shuug2/gds_us_ctrl/ref/README.md

# ref/ — 이전 MCU 참조 코드

STM32F410RBT 통합 이전에 사용하던 두 MCU의 원본 코드 보관 폴더.

| 폴더 | MCU | 역할 |
|---|-----|---|
| `samd20/` | ATSAMD20 (Cortex-M0+) | (역할 기록 필요) |
| `atmega16/` | ATmega16 (AVR 8-bit) | (역할 기록 필요) |

이 코드는 수정하지 않는다. 포팅 시 참조 전용.
