shuug2/gds_us_ctrl/docs/superpowers/analysis/2026-06-20-bseam-osc-signal-chain-and-port-fidelity.md

# B-SEAM OSC — 신호 체인 · 명령선 · 포팅 충실도 (2026-06-20 분석 세션)

> **요약**: HW 비의존 분석 세션(코드 0줄, HW 측정 0건). B-SEAM(OSC 출력단)이 풀렸을 때 MCU가 무엇을 하는지, legacy M16 동작이 STM32로 제대로 포팅됐는지를 1차 소스(`ref/atmega16/m16_conv_v001.c` + disasm 분석 + STM32 코드)로 교차 검토했다. **핵심 결론 4건**: ① **출력단은 2조각 모두 미구동 stub** — OSC 채널 구동(**B-SEAM**) + 진폭 pot 실구동(**F2**, U4 칩 정체); 둘 다 `mon_printf` 로그만. ② 옛 IPC 명령 3선 **PA4=START / PA5=SEEK / PA6=RESET**(+PA7/PC4=IPC 아님)는 STM32에서 내부 `us_cmd`로 소멸, 처리부는 이식 완료. ③ M16은 "선(wire)"이 아니라 **프로세서** — "미러"는 명령핀→출력핀 통과가 아니라 *내부 상태 플래그 → OSC 핀* 매핑(finding ④: OSC 3선 = 명령 3선 active-LOW 레벨 미러, 가설). ④ **M16 처리코어 포팅 충실도 = 높음** — STM32가 disasm을 권위로 삼아 v001이 틀린 3곳(`×6` vs `>>6`, lookup `<`, warmup 부팅1회 vs per-START)을 모두 비껴감. 미검증은 전부 코드 버그가 아니라 절대값/물리출력(6b·B-SEAM·F2 게이트). ⑤ **(2026-06-20 후속, 사용자 HW 진실 + SAMD20 검증) B4 해소 — PB1 = SAMD20 소비전류**(M16 PA1은 미연결): SAMD20는 전류표시(curr_amp)·전력(curr_power=curr_amp×2.2)·에너지(curr_energy=acc/500)를 전부 PA02(=PB1)에서 파생하나, **STM32는 현재 PB1을 read-and-discard하고 이 3값을 ch0(reg_scale)에서 뽑음** = source·공식 불일치. `curr_amp`=소비전류(ampere), 진폭 아님. **이 PB1 재구성 = 6b 스테이지 본체** (§4b). ⑥ **(사용자 HW 확정) OSC 3 출력 채널 매핑 = RUN→PC7/PB14, SEEK→PB1/PB2, RESET→PB0/PB10, 전부 active-LOW binary 미러** (finding ④ 확정; v001 변수명 또 오라벨 — `g_run_flag`=실제 RESET). **B-SEAM 3채널 분은 측정 게이트 아님 → 코딩 가능**(내부 run/seek/reset → active-LOW). ⑦ **(M16 disasm 확보 후, §4c) OVLD(PC0) 로직 디코드 = PA7(PINA.7) HIGH ×5 디바운스 → PC0 어서트 + OVLD→SEEK 복구 훅(0x1D28)**; **PA7=과부하 입력 → 보류 OSC3(PB13) 해소**(OSC 출력 아님, OSC2/PC4만 미확정). ⑧ **PA0/SENS_OUT = 양 레거시 MCU 모두 vestigial**(M16=dead 7seg 바그래프 / SAMD20=curr_lv 소비처 주석처리, 표시는 curr_amp); STM32의 `reg_scale(ch0)→curr_power`는 레거시 미사용 신호 오용, ch0 통합 역할 미결정. raw disasm `ref/atmega16/m16_disasm/firmware_disassembled.asm` 확보(이전 "없음" 해소). **다음 세션 = 사용자 오프라인 검토 반영 → HW 있으면 측정+설계, 없으면 B-SEAM(3채널)/F2/6b/overload spec 선행.**
>
> **산출물**: 검토용 Artifact(claude.ai) — 신호 체인 다이어그램 + 측정 절차 7단계 + 포팅 충실도(OSC 핀/처리코어) + 명령선/프로세서 정리. URL은 §7. (scratchpad HTML 원본은 세션 한정 소멸; 본 .md가 repo 영속본.)

---

## 1. 신호 체인 (MCU 중심)

옛 2-MCU(SAMD20 → 명령 4선 → ATmega16 → 발진보드)를 STM32 하나가 양쪽 흡수. **MCU는 초음파 주파수를 직접 만들지 않는다** — 발진은 외부 오실레이터 보드가 하고, MCU는 (1) 채널 ON/OFF, (2) 진폭, (3) 피드백, (4) SEEK/RESET 명령만 담당.

| 역할 | 핀 / 경로 | 상태 |
|---|---|---|
| 채널 ON/OFF | `CTRL_OSC0..4` = PB2/PB10/PB12/PB13/PB14 (active-LOW) | **B-SEAM** (미구동 stub) |
| 진폭(파워) | I2C_POT `@0x28` (I2C1, FRAM과 공유) | **F2** (미구동 stub) |
| 피드백 읽기 | ch0=PB0(M16 PA0, 레귤레이션 피드백) · ch1=PB1(**SAMD20 소비전류**; "OSC" 라벨 stale, §4b) | ch0 사용 / **ch1 현재 read-and-discard** / 절대보정=6b |
| SEEK / RESET | 공진 탐색 / 초기화 신호 (옛 M_SEEK·M_RESET 자리) | hook stub |

**⚠ 출력단 전체가 미구동**: `app_reg.c`는 "drives NO OSC GPIO"(compute-only). `app_lcd_hook_set_pot`(app_lcd.c:24)·`app_weld_hook_set_amp`(app_weld.c:36)는 **`mon_printf` 로그만**. I2C1 버스는 FRAM(FM24C16B) 전용으로만 실구동. 즉 두뇌·상태머신·계기판·명령 라우팅은 다 돌지만, **실출력 = ① B-SEAM(OSC 채널) + ② F2(진폭 pot) 둘 다 미이식.**

## 2. 명령 입력선 (PA4/5/6) + "M16 = 프로세서"

옛 SAMD20→M16 IPC 명령선(2026-06-10 IPC semantics 분석, samd20+disasm 교차):

| IPC 명령 | SAMD20 out | M16 in | 의미론 |
|---|---|---|---|
| M_START | PB13 | **PA4** | active-LOW 레벨, hold-to-run |
| M_SEEK | PB11 | **PA5** | active-LOW, 500ms 자동 해제 |
| M_RESET | PB12 | **PA6** | active-LOW, 500ms 후 자동 해제 + SEEK 자동 체인 |

(4번째 선 M_OVLD=PC0, overload 스테이지 이연. PA7/PC4는 samd20 대응핀 없음 = **IPC 아님**.)

**"미러"는 passthrough가 아님** — M16은 명령을 받아 *자기 로직 수행*(상태머신·warmup·500ms 체인·레귤레이션) 후 내부 플래그를 OSC 핀에 미러. "미러" = `내부 상태 플래그(g_0189/018A/0196) → 출력핀`, NOT `명령핀 → 출력핀`. (예: START 플래그는 warmup 중 안 켜짐; RESET은 500ms 처리 후 SEEK 체인 — 순수 통과면 없을 거동.)

```
[옛]  SAMD20 ─명령(PA4/5/6)→ M16 ┌ 처리: 상태머신·warmup·500ms RESET→SEEK·레귤레이션
                                 └ 내부 플래그 ─(Timer0 ISR active-LOW)→ PB0/PB1/PC7(OSC) → 발진보드
       (진폭은 SAMD20이 I2C_POT 직접 구동)
[신]  STM32 ─내부명령(US_CMD_*)→ [처리 = 이미 포팅] → 내부 run/seek/reset 상태
                                 └ [B-SEAM: 내부상태 → active-LOW 출력] → PB10/PB2/PB14 → 발진보드
       (진폭 I2C_POT = F2 stub)
```

**3↔3 대응 (사용자 HW 확정 2026-06-20 — finding ④ 가설→확정)**: **RUN→PC7(OSC4→PB14) / SEEK→PB1(OSC0→PB2) / RESET→PB0(OSC1→PB10), 전부 active-LOW.** OSC 구동 = binary run/seek/reset 미러(thermometer 패턴 아님 — 그건 dead 7-seg). ⚠ **v001 변수명 또 오라벨**: `g_run_flag`(0x0196→PB0)=실제 **RESET**(run 아님!), `g_blink_state`(0x0189→PC7)=실제 **RUN**, `g_blink_active`(0x018A→PB1)=**SEEK**. 확정 근거=사용자 HW + active-LOW disasm(C6). STM32 처리부는 이식 완료(START→`app_reg` RUN 게이트 슬2b HW✓ / SEEK·RESET→`app_seek_reset` 500ms 체인 host+HW✓); 남은 건 출력 와이어업 = **PB14/PB2/PB10을 내부 run/seek/reset 상태에서 active-LOW 구동**(B-SEAM) + F2(진폭).

**⚠ 참조 C 함정**: `m16_conv_v001.c`는 PINA.4만(디스플레이 타이밍 문맥), PA5/PA6 read 0건. 명령 디스패처(`app_0x06d2`/`app_0x0c70`)는 disasm에만 → 명령 의미론 권위 = 참조 C 아님, **disasm**.

## 3. 포팅 충실도 — OSC 핀 (방향/극성)

매핑(M16→STM32, pinmap.md·board.c 일치): PB1→PB2(OSC0), PB0→PB10(OSC1), PC4→PB12(OSC2), PA7→PB13(OSC3), PC7→PB14(OSC4).

| M16 | →STM32 | M16 방향/idle | M16 런타임 | STM32 |
|---|---|---|---|---|
| PB1 | PB2 OSC0 | 출력 idle HIGH | active-LOW **SEEK** (0x018A; v001 `g_blink_active`=오라벨) | init ✓ / 런타임 ✗ |
| PB0 | PB10 OSC1 | 출력 idle HIGH | active-LOW **RESET** (0x0196; v001 `g_run_flag`=오라벨, run 아님!) | init ✓ / 런타임 ✗ |
| PC7 | PB14 OSC4 | 출력 idle HIGH | active-LOW **RUN** (0x0189; v001 `g_blink_state`=오라벨) | init ✓ / 런타임 ✗ |
| PC4 | PB12 OSC2 | 입력+풀업 | 코드상 안 읽힘 | 미설정(풀업 미복제) |
| PA7 | PB13 OSC3 | 입력+풀업 | 코드상 안 읽힘 | 미설정(풀업 미복제) |

판정: **init은 충실(idle HIGH=active-LOW off, 과거 부팅-OSC-ON 버그 수정됨), 런타임 구동은 미이식(B-SEAM)**. 입력 2채널(PC4/PA7)은 M16에서도 안 읽힘 → 포팅할 동작 자체 없음, 방향은 default로 일치(풀업만 미복제). board.c: `CTRL_OSC_OUT_PINS = PB2|PB10|PB14` idle HIGH; PB12/PB13 미설정(B-OSC-MAP 측정 게이트).

## 4. 포팅 충실도 — M16 처리코어 (scaling/lookup/ADC/warmup)

3-way 교차(참조 C v001 + disasm 권위 + STM32). **v001은 부분·부정확 재구성 → 단독 신뢰 금지.**

| 처리기능 | 참조 C (v001) | disasm (권위) | STM32 | 판정 |
|---|---|---|---|---|
| scaling ×6 | `temp >> 6` (L695) ❌ | `input × 6` mul 0x2158 (SCALE-06) | `in*6u` (reg_scale:18) | ✅ disasm |
| clip/floor | `≥1000`,`<3` 입력 | 입력 도메인, value 3 통과 (SCALE-04/05) | `≥1000`,`<3`, 3 통과 | ✅ 경계까지 |
| lookup band | `<`/`>` 내부 불일치 | 첫 i where table[i]<scaled, strictly-less (C2) | strictly-less first, else 21 | ✅ disasm 해소 |
| lookup 값 | table[24] (L127) | flash 0x58, idx0-20 ↓, 첫 21 copy (C1) | reg_lookup_table[24] byte-for-byte | ✅ |
| ADC 평균 | 10/50 (acc 16bit 오해) | 10/50, 32bit acc (ADC-2/3) | CH0=10/CH1=50, 32bit | ✅ 샘플수 (cadence ms-grid 근사) |
| warmup | g_main_state 1→0 @401 | 부팅 1회 ~4s, @0x137C one-way, 명령무시 @0x041E (finding ①) | main_state 1→401→0, START guard | ✅ (slice2a per-START 램프 폐기) |
| OSC 극성 | active-LOW (454-471) ✅ | active-LOW/idle-HIGH cbi (C6) | board.c idle HIGH; 런타임 미구동 | ⚠ init ✅ / 런타임=B-SEAM |
| RESET→SEEK 체인 | (samd20 원본) | main.c:5395-5407 (finding ③) | SR_TICKS=50=500ms 액면가 | ✅ 로직 / ±100ms quirk 의도적 미재현 |

**★ v001 틀렸고 STM32가 disasm 따른 3곳**: (1) ×6 vs `>>6` (disasm에 시프트 0건, `0x1AC2 ldi r30,0x06`+`0x2158` 곱셈) (2) lookup `<` (C2 `0x202A` cp→brcs) (3) warmup 부팅1회 (finding ① `@0x041E`/`@0x137C`; `reg_ramp_level`은 검증 테이블 레퍼런스로만 보존, 출력 경로 제거).

## 4b. B4 해소 — PB1 = SAMD20 소비전류 (전류·전력·에너지 source 정정)

**사용자 HW 진실 (2026-06-20)**: M16 PA1(ADC1)은 **물리 미연결**(B4 의심 확정 — M16 ch1은 플로팅 읽음 → 레귤레이션 미사용과 일치). 통합 보드에서 **STM32 PB1 = 옛 SAMD20 PA02 회로 = 소비전류**. PB0(ch0)는 M16 PA0 그대로(레귤레이션 피드백, 현 구현 OK — 사용자 확인).

> ⚠ **핀 라벨 중복 주의** (혼동 빈발): **"STM32 PB1"** = 소비전류 ADC 입력(ADC1_IN9, ← SAMD20 PA02) ≠ **"M16 PB1"** = SEEK 출력(→ STM32 **PB2**/OSC0, §2). 둘은 서로 다른 핀이며 우연히 같은 "PB1" 라벨을 공유. 본 문서는 M16→STM32 화살표(예 `M16 PB1→PB2`)로 구분.

**SAMD20 전류/전력/에너지 = PA02(=PB1) 단일 소스** (`ref/samd20/main.c` `cal_real_val`, `ADC_CURR`=PIN0=PA02):

```
temp     = average(buf[ADC_CURR], ADC_SAMPLE)   // min/max 1개씩 제거 평균
temp_val = temp*4;  temp_val = temp_val/10 + cal_val
curr_amp   = (temp_val > 51) ? temp_val-37 : 0  // 임계51/오프셋-37 ("OFFSET 15mA") = 소비전류(mA)
curr_power = curr_amp * 22 / 10                  // 전력 = 전류 × 2.2
acc_energy += curr_power (1ms);  curr_energy = acc_energy / 500
```
(SAMD20 ADC 2채널: PIN0=PA02=`ADC_CURR`=소비전류 / PIN11=`ADC_OUT_LV`=`curr_lv` 출력레벨 — PIN11은 STM32 미이식.)

**STM32 현재 불일치** (`app_reg.c`):

| 값 | SAMD20 (PB1) | STM32 현재 | 판정 |
|---|---|---|---|
| curr_amp | PB1 전류 (×4 /10+cal, thr51/off37) | `ch0_avg` (PB0) | ❌ source |
| curr_power | `curr_amp × 2.2` | `reg_scale(ch0)` = ×6 lookup | ❌ source·공식 |
| curr_energy | `acc/500` (1ms) | `acc/250` (2ms) | ⚠ 구조 OK / 입력 틀림 |

→ STM32는 **PB1(실 전류)을 읽어 버리고**, 전류/전력/에너지를 ch0(M16 레귤레이션 피드백)에서 뽑음.

**정정 2건**: (1) `curr_amp` = **소비전류(ampere/mA), 진폭 아님** — 오프셋 "15mA"·`curr_amp×2.2=전력`이 명백; "bar=amplitude(curr_amp)" 해석은 SAMD20 기준 부정확(LCD bar=소비전류). (2) PB1 펌웨어 라벨 `ADC1_CH_OSC`/주석 = stale.

**= 6b 스테이지의 본체**: curr_amp/power/energy를 PB1에서 SAMD20 공식으로 재구성 + ch0(PB0)는 레귤레이션/OSC 전용 분리. 보정상수(`cal_val`, `×4`, `/10`, `×2.2`, thr51/off37, `/500↔/250`)는 STM32 3.3V/12bit 도메인이라 실 rig 6b 게이트. weld 에너지가 "구조=host-test, 절대=6b"였던 그 6b 조각. **펌웨어 변경 = 6b 스테이지 spec부터 (지금 코드 무변경).**

## 4c. 신규 발견 — M16 disasm 확보 후 (OVLD · PA7 · PA0 vestigial)

**2026-06-20 후속**: 사용자가 `ref/atmega16/`에 M16 펌웨어 원본 추가 — `m16_controller_prg.hex` + `m16_disasm/firmware_disassembled.asm`(2953줄 전체 디스asm) + `avr_disassembler.py` + `firmware_analysis.md`. **이전 "raw .asm 없음" 상태 해소 → M16 로직 직접 추적 가능.** ⚠ 일부 명령 미디코드 `.word`(예 `0x107C`) 잔존.

### OVLD(PC0) 구동 로직 (firmware_disassembled.asm)

검출 함수 `@0x10A6` (per-tick 호출 `0x06EC`):

```
0x10C0 sbis 0x19,7    ; PA7(PINA.7) 읽기
0x10C2 rjmp 0x10EE    ;   PA7==0 → 카운터(0x0199)=0, assert 안 함 (noise reject)
0x10C4..              ;   PA7==1 → 카운터++
0x10D2 cpi r26,0x05   ;   카운터 ≥ 5 →
0x10E6 ..0x019C=1     ;   issued 래치 + 0x01A2=1
0x10EA sbi 0x15,0     ; ★ PC0 = HIGH = M_OVLD 어서트
```

- **로직 = PA7 HIGH 연속 5샘플 디바운스 → PC0(M_OVLD) HIGH.** 재진입 게이팅 = `0x019C`(issued)/`0x01C5`.
- **복구 훅**: overload 경로(`0x08CC → call 0x1D28`)가 **SEEK 플래그 `0x018A`=1** set → **OVLD→SEEK 자동 복구**(IPC 가설 확증).
- **해제**: reset/clear-all(`0x1B7A`/`0x1CFE`/`0x1FC0`, PC1/PC6와 함께 `cbi 0x15,0`).
- **극성**: PA7 풀업 idle HIGH인데 HIGH=fault-카운팅 → 정상시 외부가 LOW로 잡고 fault/단선시 HIGH(fail-safe) 추정 → **보드 실측 확정**.

### ★ PA7 = 과부하 입력 → 보류했던 OSC3 해소

**PA7(= STM32 PB13, board-mapping "CTRL_OSC3")은 OSC 출력이 아니라 과부하 sense 입력.** → §3 PB12/PB13 B-OSC-MAP 중 **OSC3(PB13)=overload 입력으로 확정**, STM32 출력 구동 금지(현 board.c 미설정 정당). **OSC2(PC4/PB12)는 여전히 미확정**(`sbis 0x13,4 @0x1072`로 읽힘, 용도 미디코드 — 사용자 보류).

### overload 스테이지 설계 (STM32 통합, 사용자 결정 2026-06-20)

레거시 `외부fault → M16 PA7 → M16 검출(디바운스) → M16 PC0(M_OVLD) → SAMD20 → 응답`을 **STM32 한 MCU로 통합**. **M_OVLD IPC(M16 PC0 → SAMD20 PB10) 소멸**(PB10은 CTRL_OSC1/RESET로 재용도, pinmap 부록A) — STM32가 입력을 **직접 읽어 내부 처리**. ⚠ "mega16 PA7"(→STM32 **PB13**) ≠ "STM32 자신의 PA7"(=ETH_MOSI SPI1) — 다른 핀.

| 핀 | 역할 | 결정 (사용자 2026-06-20) |
|---|---|---|
| **PB13** (← mega16 PA7) | 과부하 sense **입력** | **active HIGH** (HIGH=overload). ⚠ pinmap "CTRL_OSC3"는 오라벨 |
| **PB3** CON_OVLD | 과부하 **출력** = 외부 **릴레이 제어 신호** | **필요**(확정), STM32 구동, active HIGH(릴레이 assert) |
| heartbeat | Phase2 임시(현 PB3 점유) | **빈 GPIO로 이전 → PB8**(대안 PB9/PB15/PC0-3; 보드 test-point로 최종) |

**통합 처리 체인**: PB13 입력 디바운스(M16 ×5) → overload flag → 내부 응답(SAMD20 로직: 초음파 정지 `sig_run_status=OFF` + `SYS_ERROR`/`error_status|=ERR_OVLD` + LCD "OVER LOAD" + 복구 사용자 RESET→자동 SEEK = **seek-reset FSM 재사용**) → **PB3/CON_OVLD 출력 어서트(릴레이)**.
- 입력/검출/응답/출력 로직 = host-test 가능. 극성(active HIGH 확정)·실 fault·릴레이 동작 = HW 게이트.
- ⚠ **pinmap 정정 필요**: PB13=과부하 입력(OSC3 아님), PB3=CON_OVLD 릴레이 출력, heartbeat PB3→PB8.

### PA0/SENS_OUT = 양 레거시 MCU 모두 vestigial

- **M16**: PA0 → reg_scale → 21단 lookup → 디스플레이 패턴 → PORTD 7-seg(V26 dead) = 출력세기 바그래프 표시 연산(제어/OSC 아님; §4 §4b와 일관).
- **SAMD20**: PA0 네트 → PB03(AIN11=`ADC_OUT_LV`) → `curr_lv` 획득·래치(`last_lv`)하나 **유일 소비처 `send_outpower_data(curr_lv/40,…)`는 주석처리(main.c:5135)** → 출력파워 표시는 `curr_amp`(소비전류)로 전환 = **curr_lv 실사용 없음**.
- **함의**: STM32 `reg_scale(ch0=PA0)→curr_power→DISP_POWER`는 **레거시 양쪽이 안 쓴 신호를 "전력"으로 오용**(전력=PB1 소비전류×2.2, §4b). **ch0(PA0/출력세기) 통합 역할 = 미결정**(curr_lv 표시 부활 / vestigial 유지 / 기타).

### v001 신뢰도 (단독 금지 재확인)

v001 누락/오류 누적: ×6(`>>6` 오기)·lookup `<`·warmup·**ADMUX REFS=11(AVCC 오기)**·OSC 변수명 오라벨·**PA5/PA6 read 0건**·**PC4 read 누락**·**overload 로직 전체 누락**. → **권위 = `firmware_disassembled.asm`, v001 = 참고용만.**

## 5. 측정 절차 (HW 세션용, 스코프 + SWD)

**안전**: ① 부팅 시 OSC off 극성 확인(과거 버그) ② **PB12/PB13 출력 구동 금지**(M16 입력핀 → contention) ③ 최소 진폭+짧은 on-time부터 ④ **스코프 프로빙 자체** — 파워 구동단 고전압·비접지 가능 → GND 클립 전 전압/절연 확인(차동/절연 프로브).

1. 보드 모드/관측 채널 확보 (SERIAL=mon 비가용 → addr=NONE 또는 ETH, 아니면 scope+SWD)
2. 부팅 직후 CTRL_OSC0..4 5핀 idle 레벨 (PB2/PB10/PB14=HIGH 기대; PB12/PB13=?)
3. RUN 트리거 → 어느 핀 토글? active 레벨/지속시간(ceiling 560ms?)
4. output_power 스윕(50→100) → I2C_POT(@0x28) 트랜잭션 + OSC 패턴 변화? (불변=enable+pot 단순 / 변함=패턴 매핑) **+ F2: U4 칩 정체·I2C write 확인**
5. PB13=과부하 입력 확정(§4c, PA7) → OVLD 극성 실측(정상 LOW? fault HIGH?). PB12(OSC2/PC4)만 방향 미확정 → 외부 구동 여부 관측
6. SEEK/RESET 물리 핀 + 거동 (⚠ PB1은 더 이상 OSC 모니터 아님=소비전류 §4b → 스윕은 OSC 핀/트랜스듀서에서 직접 관측). ⚠ 실 트랜스듀서/혼 필요(공진=음향 부하 의존)
7. ADC 도메인 실측: PB0(레귤레이션 피드백) + **PB1(소비전류 §4b)** 전압 범위 → 6b 보정(curr_amp/power/energy 공식 상수 확정)

**최단 경로**: 동작 원본(M16) 보드가 있으면 OSC 커넥터를 같은 절차로 스코프 → gold-standard 매핑/극성(net-to-channel은 AVR 기계어에 없음).

## 6. HW로 확정할 미해소 (코드 충실도와 별개)

- **B-SEAM**: **3 출력 채널 매핑 확정 (사용자 HW, §2)** — RUN→PB14(OSC4) / SEEK→PB2(OSC0) / RESET→PB10(OSC1), active-LOW binary 미러(패턴 아님). 코딩 = 내부 run/seek/reset → 이 3핀 active-LOW. **3채널 매핑은 더 이상 측정 게이트 아님.**
- **OSC3/PB13 = 과부하 입력 (PA7, §4c 해소)** — OSC 출력 아님, 출력 구동 금지. **OSC2/PB12(PC4)만 미확정**(별도 입력, 용도 미디코드).
- **overload (사용자 결정 2026-06-20, §4c)**: 입력 PB13(←PA7) **active HIGH**=fault / 출력 PB3 CON_OVLD = 외부 **릴레이 제어**(필요, active HIGH) / heartbeat PB3→**PB8** 이전 / 통합 직접처리(M_OVLD IPC 소멸, seek-reset FSM 복구 재사용). 실 fault·릴레이·극성 sanity만 HW.
- **ch0(PA0/출력세기) 통합 역할 미결정**: 레거시 양쪽 vestigial(§4c) → curr_lv 표시 부활 / 유지 / 기타 결정 필요.
- 실 스코프 폴라리티/부하 sanity (3채널).
- **F2**: U4 I2C_POT 칩 정체 → 진폭 pot 실구동 구현. (실출력 = B-SEAM + F2)
- **SEEK/RESET 스윕 주체**: 보드-side(MCU 1신호) vs MCU 생성 — 코드 규모 좌우.
- **6b**: ×6 등 절대 보정(M16 2.56V ↔ STM32 3.3V/12bit), energy divisor `REG_ENERGY_DIV=250`. **+ §4b: 전류/전력/에너지를 PB1(소비전류)에서 SAMD20 공식으로 재구성** (curr_amp 전류·power ×2.2·energy acc/divisor; cal_val·thr51/off37 실측). = 6b 스테이지 본체.

## 7. 다음 세션 진입

1. **사용자 오프라인 검토 반영** — 본 분석 + Artifact를 사용자가 오프라인 검토 후 피드백. 그 피드백을 먼저 반영한 뒤 B-SEAM/F2 spec 작성.
2. **HW 있으면** → §5 측정 절차 실행 → 결과로 §6 미해소 확정 → B-SEAM(+F2) 코딩 스테이지(spec→plan→subagent→HW 검증→머지+태그).
3. **HW 없으면** → B-SEAM/F2/overload spec 선행 가능(설계만; 절대 검증은 HW).
4. ⚠ B-SEAM은 "검증"이 아니라 **measure → 설계 → 코드 → 검증** (현재 OSC 구동 코드 0줄).

**검토용 Artifact (claude.ai)**: https://claude.ai/code/artifact/ce2570b9-4e50-4ad8-bfab-8c3d2edec2b1

## 근거 (1차 소스)

- **`ref/atmega16/m16_disasm/firmware_disassembled.asm`** (2953줄, 권위) — OVLD fn `@0x10A6`(PA7 디바운스→`sbi 0x15,0`@0x10EA), 호출 `0x06EC`, 복구 `0x1D28`(0x018A=1), clear `0x1B7A`/`0x1CFE`/`0x1FC0`. + `m16_controller_prg.hex`, `firmware_analysis.md` (사용자 2026-06-20 추가)
- `ref/atmega16/m16_conv_v001.c` — 참고용(부분·부정확): init 1151-1168, OSC 미러 453-473, scaling 672-695, PINA.4 580. ⚠ overload/PA5/PA6/PC4/ADMUX-REFS 누락·오기 → disasm 우선
- `ref/samd20/main.c` — curr_amp/power/energy(412-436), ADC_OUT_LV→curr_lv(439), curr_lv 소비처 주석(5135), 채널 PIN0/PIN11(344-353)
- `docs/superpowers/analysis/2026-05-31-m16-regulation-core-verified.md` — SCALE-04~07, ADC-2/3, C1/C2, C6/C7, B-SEAM/B-OSC-MAP §5
- `docs/superpowers/analysis/2026-06-10-samd20-m16-ipc-semantics-verified.md` — PA4/5/6 IPC, finding ①(warmup)·③(500ms 체인)·④(OSC=명령 미러 가설), §6b(set_pot stub/F2)
- `docs/pinmap.md` §117-131, 부록 A IPC
- `fw/src/{app_reg.c, app_reg_calc.c, board.c, app_lcd.c, app_weld.c, app_seek_reset.c, app_seek_reset_fsm.c, app_modbus.c, app_lcd_input.c, app_lcd_render.c}`
