shuug2/gds_us_ctrl/hw/lcd/dgus/03_nulti.jpg

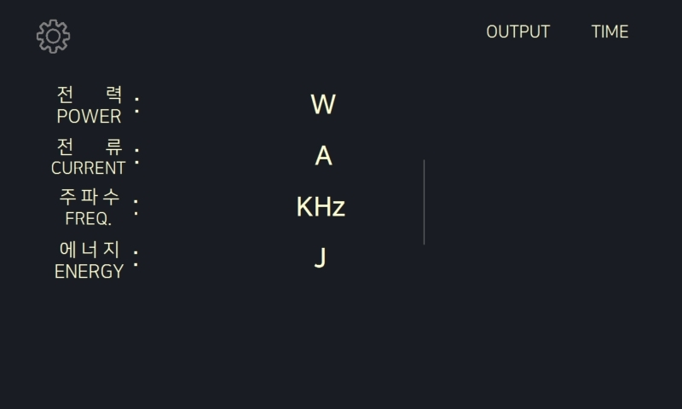
hw/lcd/dgus/03_nulti.jpg
