shuug2/gds_us_ctrl/hw/lcd/dgus/09_std_run.jpg

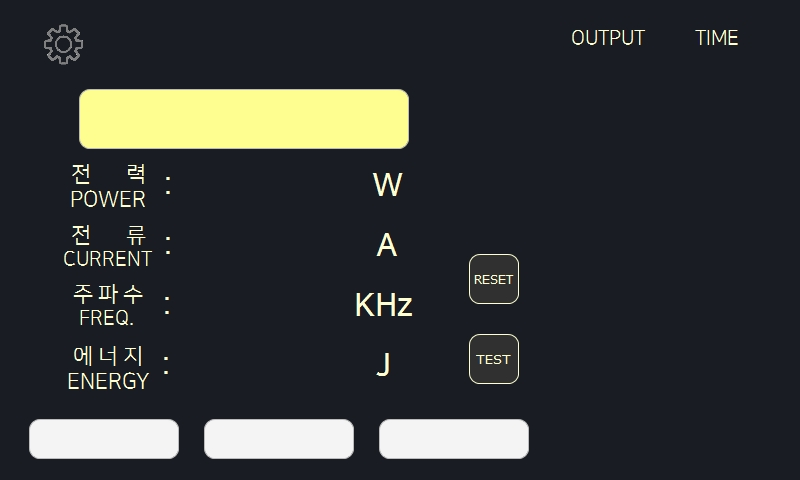
hw/lcd/dgus/09_std_run.jpg
