shuug2/gds_us_ctrl/hw/lcd/dgus/17_error_bg.jpg

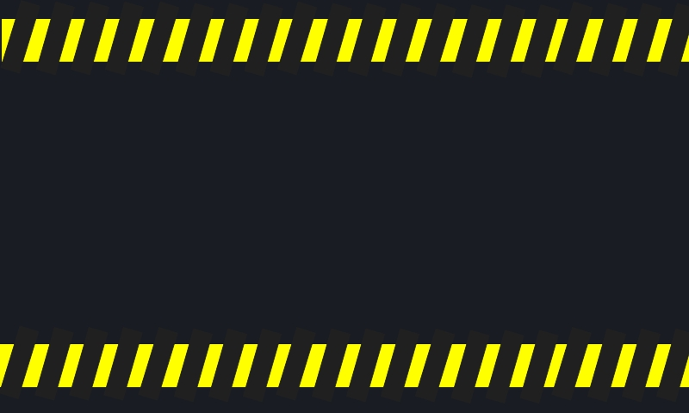
hw/lcd/dgus/17_error_bg.jpg
