shuug2/gds_us_ctrl/hw/lcd/dgus/01_setupmodel.jpg

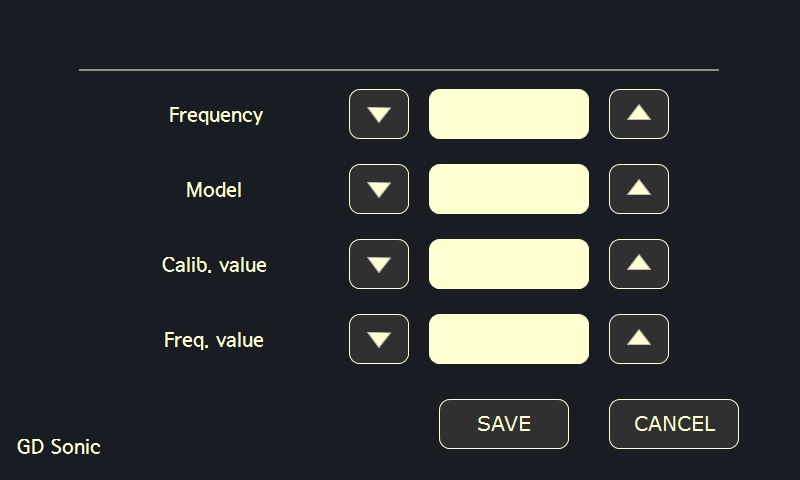
hw/lcd/dgus/01_setupmodel.jpg
