shuug2/gds_us_ctrl/hw/lcd/dgus/06_multi_setup.jpg

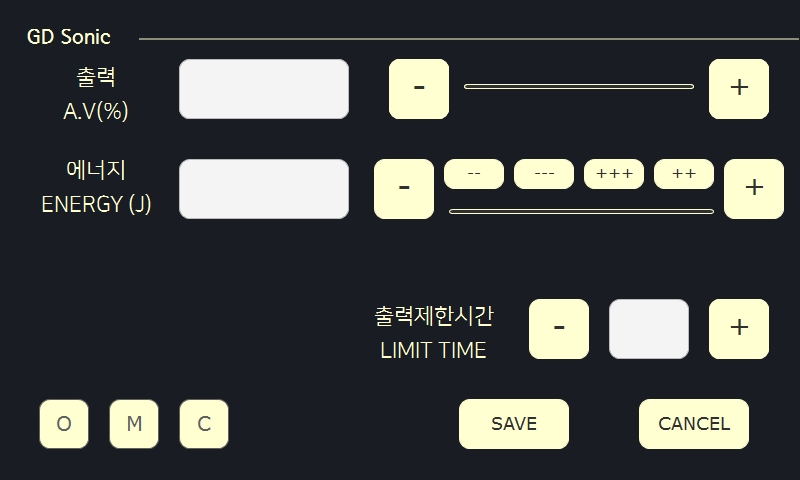
hw/lcd/dgus/06_multi_setup.jpg
