shuug2/gds_us_ctrl/hw/lcd/dgus/07_hand_setup1.jpg

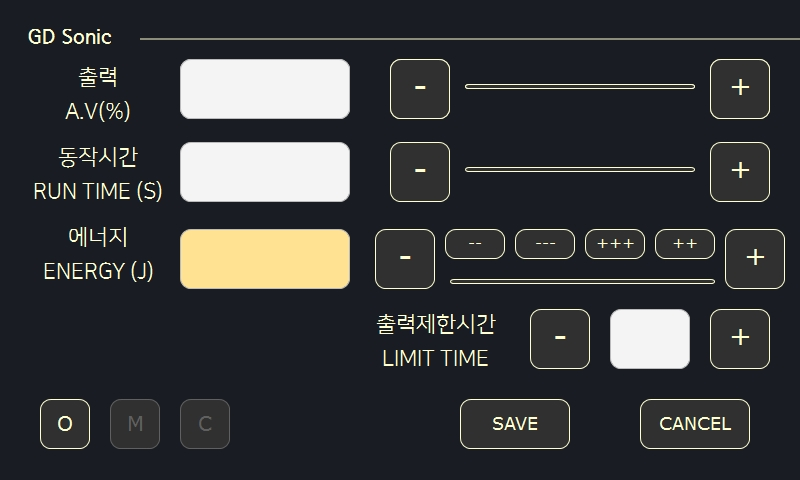
hw/lcd/dgus/07_hand_setup1.jpg
