shuug2/gds_us_ctrl/hw/lcd/dgus/08_hand_setup2.jpg

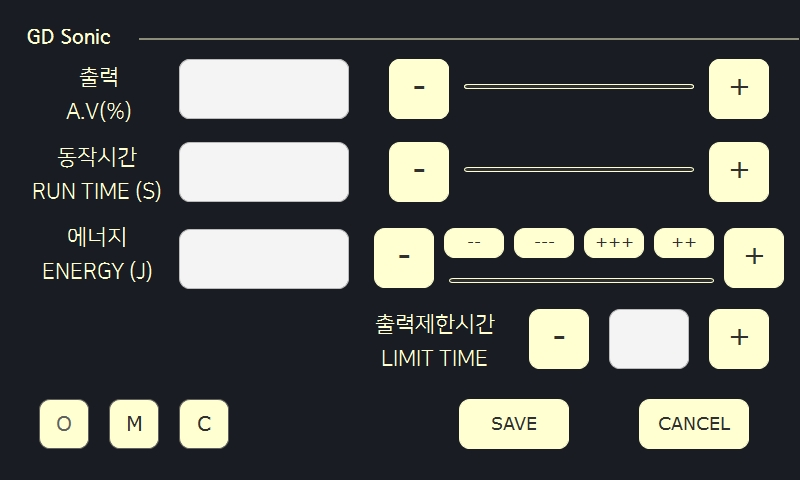
hw/lcd/dgus/08_hand_setup2.jpg
