shuug2/gds_us_ctrl/hw/lcd/dgus/10_std_setup1.jpg

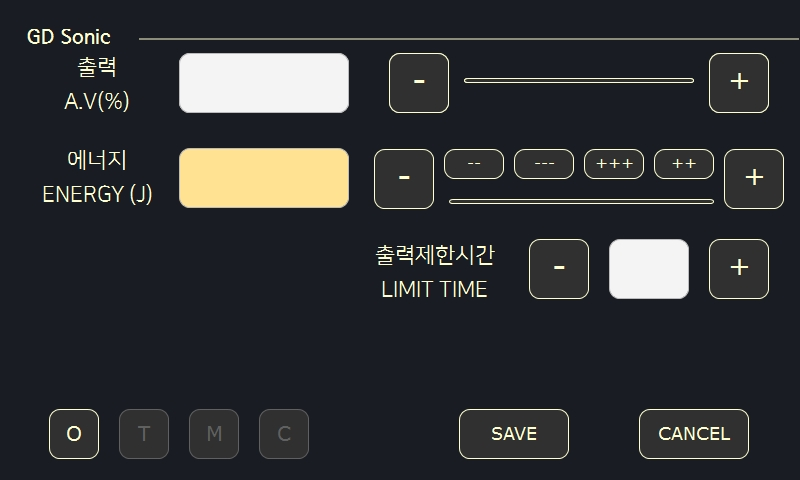
hw/lcd/dgus/10_std_setup1.jpg
