shuug2/gds_us_ctrl/hw/lcd/dgus/11_std_setup1_bg.jpg

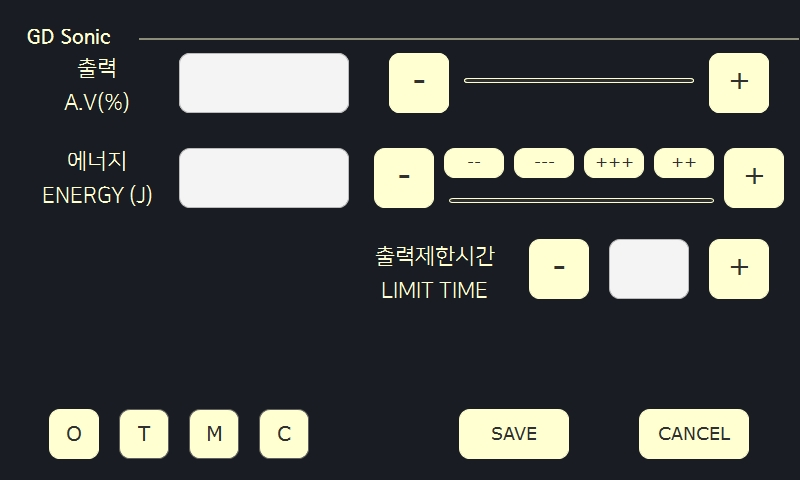
hw/lcd/dgus/11_std_setup1_bg.jpg
