shuug2/gds_us_ctrl/hw/lcd/dgus/12_std_setup2d.jpg

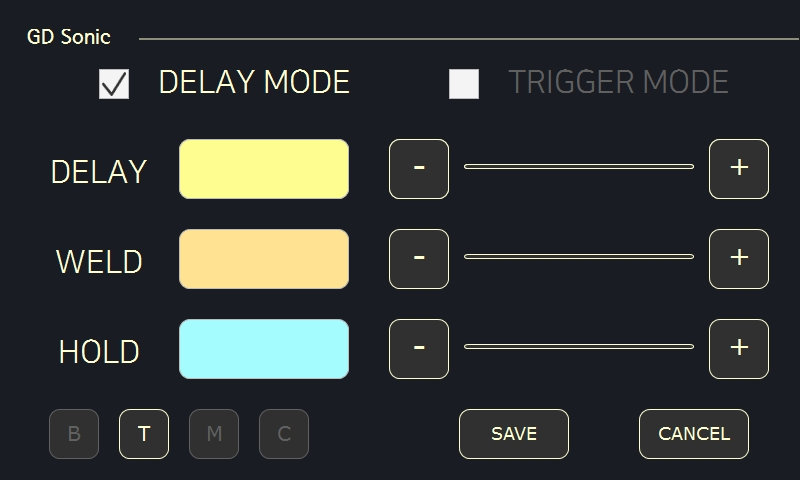
hw/lcd/dgus/12_std_setup2d.jpg
