shuug2/gds_us_ctrl/hw/lcd/dgus/13_std_setup2t.jpg

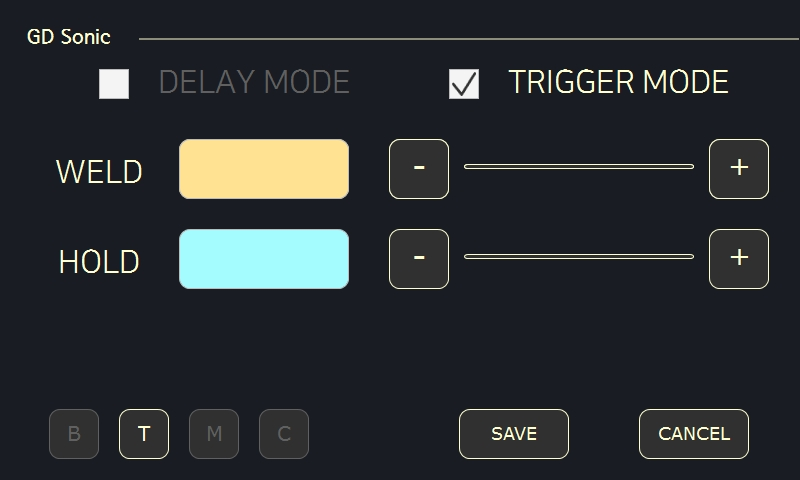
hw/lcd/dgus/13_std_setup2t.jpg
