shuug2/gds_us_ctrl/hw/lcd/dgus/14_std_setup2_bg.jpg

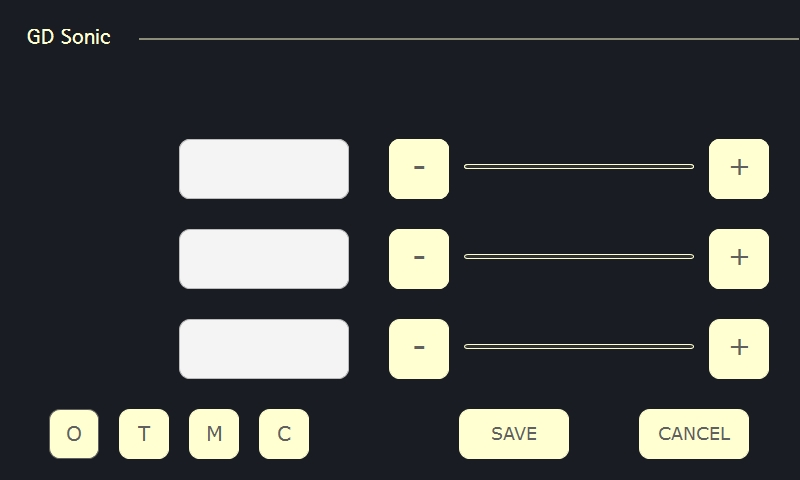
hw/lcd/dgus/14_std_setup2_bg.jpg
