shuug2/gds_us_ctrl/hw/lcd/dgus/15_std_setup3.jpg

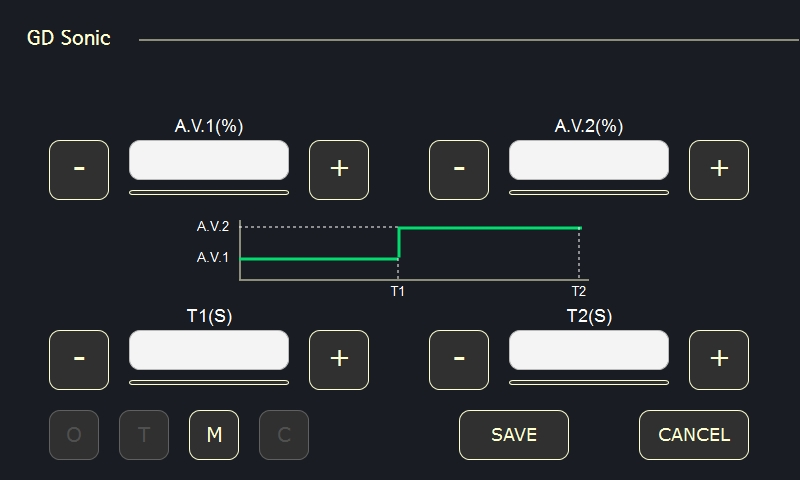
hw/lcd/dgus/15_std_setup3.jpg
