shuug2/gds_us_ctrl/hw/lcd/dgus/16_std_setup3_bg.jpg

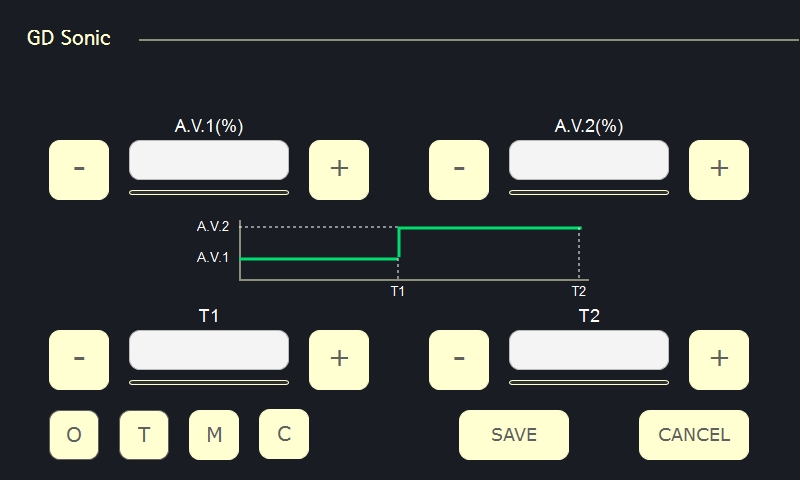
hw/lcd/dgus/16_std_setup3_bg.jpg
