shuug2/gds_us_ctrl/hw/lcd/dgus/21_multi_hand_setup3.jpg

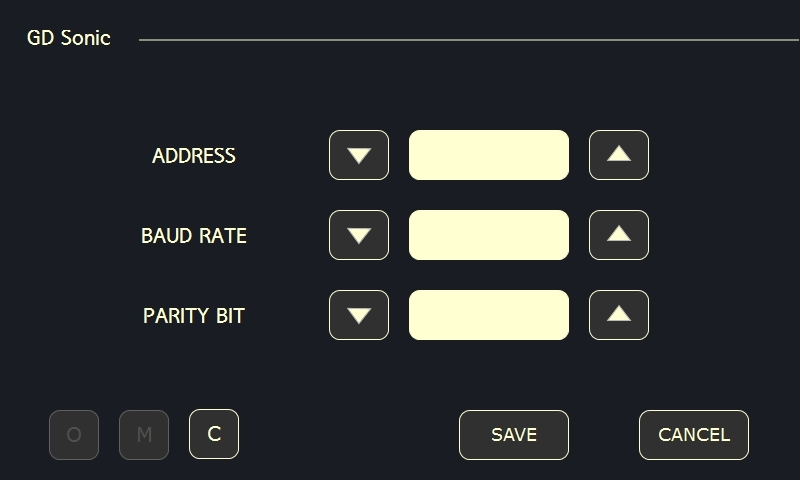
hw/lcd/dgus/21_multi_hand_setup3.jpg
