shuug2/gds_us_ctrl/hw/lcd/dgus/22_multi_hand_setup3_bg.jpg

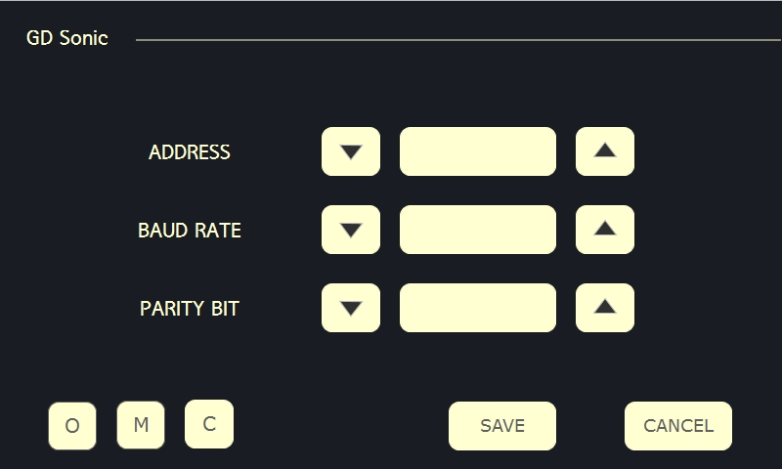
hw/lcd/dgus/22_multi_hand_setup3_bg.jpg
