shuug2/gds_us_ctrl/hw/lcd/dgus/23_standard_setup3.jpg

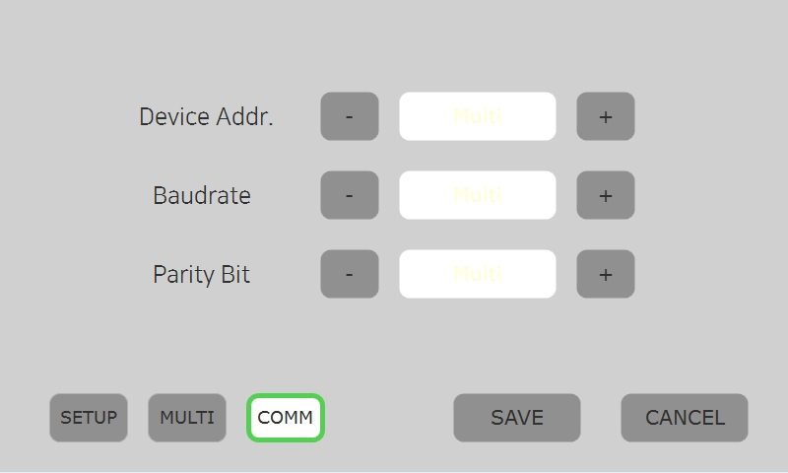
hw/lcd/dgus/23_standard_setup3.jpg
