shuug2/gds_us_ctrl/hw/lcd/dgus/24_standard_setup3_bg.jpg

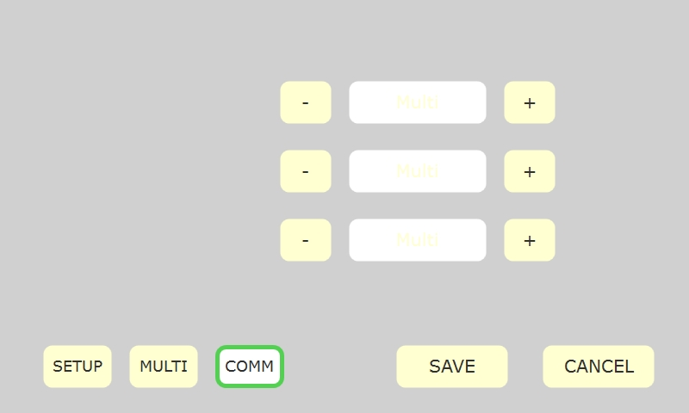
hw/lcd/dgus/24_standard_setup3_bg.jpg
