shuug2/gds_us_ctrl/hw/lcd/dgus/25_multi_hand_setup3e.jpg

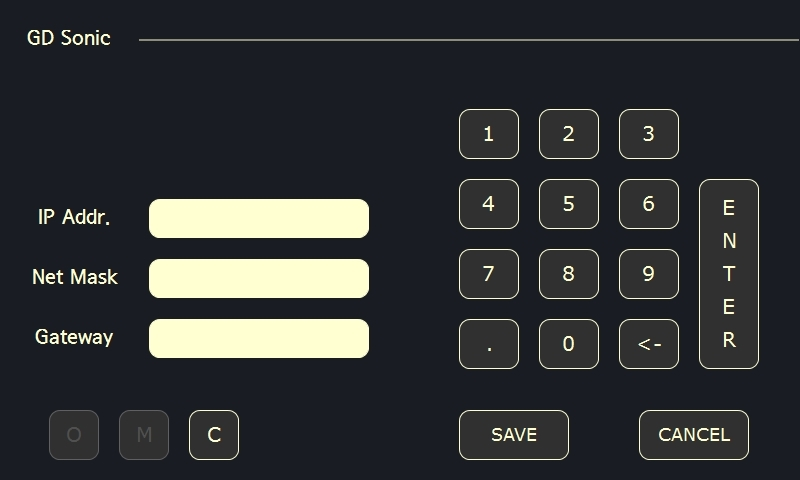
hw/lcd/dgus/25_multi_hand_setup3e.jpg
