shuug2/gds_us_ctrl/hw/lcd/dgus/26_multi_hand_setup3e_bg.jpg

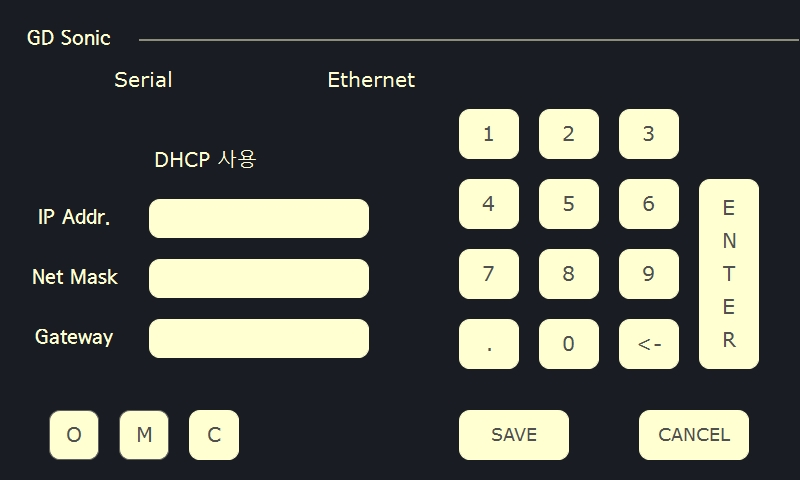
hw/lcd/dgus/26_multi_hand_setup3e_bg.jpg
