shuug2/gds_us_ctrl/docs/superpowers/plans/2026-09-05-bench-results.md

# 통합 벤치 실행 결과 — 2026-09-05

> **문서 요약**: `bench/2026-09-05-integrated`(= `feat/remote-status-bits` + `feat/iwdg-watchdog`, 충돌은 changelog 1곳뿐)를 실보드에 올려 실행한 결과다. **실행한 41항목 전건 PASS**, 펌웨어 결함 0건. 실측 신규값 = **IWDG timeout 4.45 s / f_LSI ≈ 35.9 kHz**, 부팅→Modbus 응답 4.00 s, 리셋 원인 NRST `0x04` · IWDG `0x24`. 체크리스트 자체의 오류 2건(S-3 전제 누락, CAL-6 기대치 오류)을 찾아 정정했고 둘 다 펌웨어가 아니라 문서 문제였다. 미실행 항목은 전부 **배선·PCB·육안 게이트**(PC8 미실장 / RS-485 없음 / mon 캡처 불가 / LCD 화면)이며 §3 에 사유와 함께 분리했다. 벤치 환경 함정 2개도 기록한다: **mbpoll 이 이 환경에서 동작하지 않고**, **TCP connect 성공은 MCU 생존을 뜻하지 않는다**(W5500 이 SYN 을 자체 응답 — 반드시 FC03 트랜잭션으로 판정할 것).

**실행**: 2026-09-05 / **빌드**: STD `build/`(FLASH 50.53 %) + REMOTE+BYPASS `build-remote-bypass/`(50.78 %)
**보드**: hw-revA, comm=ETH_STATIC 192.168.1.199, PC8 **미실장**, 부하 **분리됨**, 원격기 **분리됨**

---

## 1. 실행 결과 — 41항목 전건 PASS

| 섹션 | 항목 | 결과 |
|---|---|---|
| **S** | S-2 FC03 50칸 전수 | PASS — 값이 SWD `g_cfg` 덤프와 일치 |
| | S-3 직접런 ceiling | PASS — **555 / 558 / 552 ms** (기대 560, 과거 실측 [514,578]) ⚠ 전제 = §2-① |
| | S-4 FC06 클램프 | PASS — 30→50, 120→100 |
| **M** | M-3 STD 는 CAP 미러 없음 | PASS — `0x2A` 에 `0x1234` 쓰면 그대로 남음 |
| | M-4 REMOTE 는 CAP 매직 복원 | PASS — 같은 조작이 **`0x5201`** 로 복원. 모델 축이 갈림을 실증 |
| **B34** | B34-1/5/7/8/10/11 | PASS — HORN bit6 OFF→ON→OFF, 원격 `0x30` 조작, horn 중 START 차단 **+ bit6 로 사유 설명**(B-4 의 목적), 재부팅 시 소실, 상위비트 무오염 |
| **MOD** | MOD-2/3/5 | PASS — freq 쓰기 2, type 쓰기 0(hand), 범위 밖 99 저장·크래시 없음 |
| **CAL** | CAL-1/2/3/4/5 | PASS — 16/40 일치, −16 = `0xFFF0`, 상·하한 **±1000** 클램프(freq 쪽 동일) |
| | CAL-6 EN_SAFTY 정규화 | PASS — **기대치 정정 후**(§2-②). 5→**0**, 1→1 |
| | CAL-7 영속 | PASS — cal_val −16 이 재부팅 후 유지(SWD 덤프 `0xF0 0xFF` + FC03 양쪽 확인) |
| **NET** | NET-1 유휴 타임아웃 | PASS — 15 s 방치 후 컨트롤러가 먼저 끊음 |
| | NET-2 즉시 재접속 | PASS — 0.0 s (구 ~20 s 대기 없음) |
| | NET-3 **KA 구멍 회복** | PASS — 무-데이터 연결 RST 종료 후 즉시 회복. ⭐ 구 펌웨어에서는 같은 조작이 **전원 재인가를 요구**했다(§4-①에서 실제로 겪음) |
| | NET-4 정상 폴링 무영향 | PASS — 1 s × 60 회 끊김 0 (체크리스트 5분의 축약) |
| **FA** | FA-1 기본 상태 | PASS — `CFG_STAT`=0, staged 9종이 cfg 미러 |
| | FA-2 staged 무영향 | PASS — `CFG_STAT`=1(STAGED) |
| | FA-4 DISCARD | PASS — 미러 복귀 + IDLE |
| | FA-5 **교차 커밋 TCP→serial** | PASS — `CFG_STAT`=2(COMMIT_OK) + **TCP 링크 생존** + 실계 반영 ⭐ DG-12 전제 |
| | FA-8 same-link 거부(TCP→ether) | PASS — `CFG_STAT`=4 + cfg 불변 + TCP 생존 |
| | FA-9 범위 거부·부분 커밋 없음 | PASS — `CFG_STAT`=3, DISCARD 후 addr/spd 모두 원복 |
| | FA-10 가동 중 거부 | PASS — `CFG_STAT`=5 |
| | FA-11 타임아웃 | PASS — **30 s 정확히** 후 `CFG_STAT`=6 + 미러 복귀 |
| | FA-12b **만료가 성공으로 오보고 안 됨** | PASS — 만료 상태 커밋 → **6 유지**(2 면 `3ce1ead` 수정분 회귀) |
| | FA-13 `CFG_CTRL` 잔류 없음 | PASS — 값 7 → read-back 0 |
| | FA-14 `comm_mode` 쓰기 불가 | PASS — 미러가 원값으로 덮음 |
| **W** | W-3 **hang → IWDG 자동 리셋** | PASS — 무응답 8.45 s, `BOOT_RST=0x24`(IWDG\|PIN) 3회 연속. 레거시라면 **영구 정지**였다 |
| | W-4 NRST 리셋 원인 | PASS — `BOOT_RST=0x04` |
| | W-5 gdb halt 무리셋 | PASS — 30 s halt 동안 리셋 없음(`BOOT_RST` 불변) + 정상 재개 = DBGMCU freeze 동작 |
| | W-6 ceiling 무회귀 | PASS — 559 / 558 / 556 ms |

### 실측 신규값 — ✅ **spec 반영 완료 (2026-09-05)**

> `docs/superpowers/specs/2026-09-04-iwdg-watchdog-design.md` 에 기입했다(§요약·§2.2.1·§2.5·§2.7·§3.1·§4⑤·§6.2). **설계 가정 반증은 없다** — 4.45 s 는 명시 범위 3.40~9.41 s 안이고 마진 논리도 최악 47 kHz 기준이라 그대로 유효하다. 반증된 것은 §2.5 의 정량 서술 **"상온·정상 전압에서는 32 kHz ±수 %"** 하나뿐이다(실측 +12 %, max 쪽으로 치우침).

| 값 | 실측 | 비고 |
|---|---|---|
| **IWDG timeout T** | **4.45 s** | 무응답 8.45 s − 부팅지연 4.00 s |
| **f_LSI (역산)** | **≈ 35.9 kHz** | `256×625/4.45`. 데이터시트 17~47 kHz 내, 공칭 32 k 보다 빠름 |
| 설계 대비 | 공칭 5.00 s → 실측 4.45 s | 명시 범위 3.4~9.4 s **내** |
| 런타임 최악 2.6 s 대비 마진 | **71 %** | 단 spec §2.2.2 병리적 케이스(≈6.3 s)는 여전히 초과 = 리셋 1회 수용 |
| 부팅 → FC03 첫 응답 | **4.00 s** | DGUS 대기 + 로고 dwell 포함 |
| 리셋 원인 관측값 | NRST `0x04` / IWDG `0x24` | 전원인가 `0x0E` 는 미관측(§3) |

---

## 2. 체크리스트 자체의 오류 2건 — 펌웨어 아님

### ① S-3 전제 누락 (수정함)

체크리스트는 "START → 약 514~578 ms 후 정지"만 적었으나, 그 값이 나오려면 **`model_type = HAND(0)` 이고 `limit_on_time = 56`** 이어야 한다. 보드 잔재는 `model_type=2(std)` · `limit_on_time=750` 이었고, 이 조합에서는 **on-time ceiling 이 아예 적용되지 않는 것이 정상**이다 — `app_reg.c:451` 이 `lim->model_type == MODEL_TYPE_HAND` 를 요구한다(30 s 절대 안전 ceiling 만 남는다). 첫 실행에서 3 s 안에 안 멈춰 회귀로 오인할 뻔했다. 전제를 채우자 555/558/552 ms 로 정확히 나왔다.

### ② CAL-6 기대치 오류 (수정함)

체크리스트는 "`EN_SAFTY` 에 5 → read-back **1**"로 적었으나 구현은 `(holding == 1u) ? 1u : 0u`(`app_modbus.c:483`)라 **5 → 0** 이다. 이것이 옳다 — C-2 이탈을 승인한 근거 자체가 "**LCD 경로에 맞춘다**"였고 LCD 는 `(data16 == 1) ? 1 : 0`(`app_lcd_input.c:518`)이다. 요구사항 C-2 원문도 "5 를 쓰면 5 가 저장된다"를 막으라는 것이지 `5→1` 을 명시하지 않았다. **정규화는 실제로 일어났다**(5→0) = C-2 충족.

---

## 3. 미실행 항목과 사유 (오판 방지)

| 항목 | 막은 것 |
|---|---|
> ✅ **2026-09-05 후반 추가 — RS-485 어댑터 확보로 아래 4행이 해소됐다** (§6 참조): **FA-6/7/12** · **S-1** · **S-P** · **RTU 링크 무회귀**. 남은 mon 항목(NET-1 로그 · A-2/A-4 로그)은 각각 저가치·REMOTE/PC8 게이트다.

| **A-13 (단선 fail-safe)** · PC8 전기적 동작 | **PC8 인터록 미실장.** A 섹션 나머지 14항목은 **가상 PC8 로 실행 완료 → §3-bis** |
| S-1 부팅 배너 · S-P pot write · NET-1 로그 · A-2/A-4 로그 | **mon(USART6) 캡처 불가** — USB 시리얼 어댑터 미인식. 리셋 원인만 **SWD 정적 read 로 대체**(`s_boot_rst`, `volatile` 수정 덕분) |
| S-5 · M-1 · M-2 · MOD-1 · MOD-4 · MOD-7 · B34-2/3/4/9 | **LCD 화면 육안** — 자동화 불가, 사용자 확인 필요 |
| MOD-6 E-stop 해제 확인 | **E-stop 을 활성화할 패널 배선 없음** |
| B34-6 SENSOR 비트 | 센서(SENSE_DN) 배선 없음 |
| FA-6 · FA-7 · FA-12 | **RS-485 어댑터 없음** (RTU 링크 필요) |
| FA-3 · FA-15 영속 | 부분 대체 — CAL-7 이 FRAM 영속 경로를 입증 |
| W-1 전원인가 `rst=0x0E` | 사용자의 물리 전원 재인가 필요 |
| W-3b 출력 ON 중 hang | 부하 분리 상태라 안전하나, 출력 관측 수단(스코프·LCD)이 없어 판정 불가 |
| weld 사이클 / `work_cnt` | 양손 SW_START1/2 · 센서 · f_safty 배선 없음 |

---

## 3-bis. A 섹션 — 가상 PC8 로 추가 실행 (2026-09-05 후반)

사용자 지시로 **PC8 을 가상 입력으로 대체**해 A 섹션을 돌렸다. throwaway 빌드에서 `remote_en_step()` 의 입력 두 줄만 바꿨다 — `in.sw` 를 `holding[0x2D] bit0`, `in.estop` 을 `bit1` 로. `0x2D` 는 게이트 소거 대상(`0x19~0x1C`, `0x28`)이 아니라 **게이트가 닫혀 있어도 쓸 수 있어** 스위치 역할을 할 수 있다. 빌드는 `MODEL=REMOTE` **순정**(BYPASS 없음) — 즉 **게이트 강제는 진짜로 동작**했고, 바뀐 것은 입력 소스뿐이다.

| # | 항목 | 결과 |
|---|---|---|
| A-1 | 스위치 OFF = 불허 | PASS — `REMOTE_EN=0` |
| A-2 | 명령 차단 + 소거 | PASS — START/SEEK/RESET 전부 read-back 0, STATUS 무변화 |
| A-3 | cfg 쓰기 차단 | PASS — `OUT_POWER` 88 쓰기 → 미러가 77 로 복원 |
| A-4 | **STOP 상시 통과** | PASS — 소거되되 통과 경로 생존 |
| A-5 | 스위치 ON = 허용 | PASS — `REMOTE_EN=1`, START 통과(ceiling 556 ms) |
| **A-6** | **만료 없음** | PASS — **701 s 연속 폴링 동안 `1` 유지.** ⭐ `t=601 s` 를 넘긴 것이 핵심 — 옛 600 s 창이 남아 있었다면 여기서 `2` 로 떨어진다 |
| A-7 | 링크 침묵 → `DIS_LINK` | PASS — 13 s 침묵 → `3` |
| **A-8** | 🔴 **링크 해제 자동 복귀** | PASS — 폴링 재개 **0.5 s** 만에 `1`. 사람이 스위치를 만지지 않음 |
| A-9 | 복귀 후 재침묵 | PASS — `3` → 재폴링 → `1` (무장 유지) |
| A-10 | E-STOP → `DIS_ESTOP` | PASS — `4` |
| **A-11** | 🔴 **E-STOP 래치 유지** | PASS — E-STOP 해제 + 스위치 ON + 폴링 계속에도 `4` 유지 |
| A-11b | 스위치 사이클 재무장 | PASS — OFF(`0`) → ON(`1`) |
| A-12 | E-STOP 레벨 차단 | PASS — E-STOP 유지 중 사이클해도 `4` |
| A-14 | `0x2C` 결번 | PASS — 0 |
| A-15 | 커밋 게이트 연동 | PASS — `CFG_CTRL` 소거 + **`CFG_STAT` 불변** |

⭐ **설계의 핵심 비대칭이 실증됐다**: `DIS_LINK` 는 자동 복귀(A-8), `DIS_ESTOP` 은 래치(A-11). 둘 다 래치로 짰던 초기 설계는 TCP 소켓 1개 + stale 자가치유(~20 s) > 침묵 임계(10 s) 때문에 **재접속마다 사람이 키를 껐다 켜야 하는 자기교착**이었고, `3ce1ead` 가 그것을 고쳤다. 이 두 항목이 그 수정의 회귀 감시 지점이다.

### 🔴 이 방식으로 검증할 수 없는 것

- **A-13 (단선 = 불허 fail-safe)** — 가상 입력이 대체하는 성질이 **정확히 A-13 이 시험하려는 것**이라 원리상 배제된다. 옵토(TLP181)가 극성을 한 번 뒤집으므로 회로 검토만으로 확신하지 말고 **실선을 뽑아** 확인해야 한다. 유일한 방증 = REMOTE 실빌드에서 PC8 미실장(= 단선) 상태로 `REMOTE_EN = 0(불허)` 이 나온 것(§1 M-4 항목) — 극성이 뒤집혔다면 `1` 이 나왔을 것이다.
- **PC8 핀 자체의 전기적 동작** — 가상 입력은 `io_read_remote_en()` 아래의 GPIO 설정(풀업·입력 모드)을 타지 않는다.

→ **A 섹션은 "FSM·강제 로직 검증됨 / 물리 입력 미검증" 으로 표기한다.** PC8 실장 PCB 가 나오면 A-1·A-5·A-13 만 다시 돌리면 나머지는 이미 확인된 것으로 갈음할 수 있다(입력 소스만 다르고 하류 경로는 동일 코드).

**throwaway 는 원복됨**(`git status` clean, `THROWAWAY` 문자열 0건). 보드는 STD 재플래시 + 잔재 11개 전부 일치.

---

## 4. 벤치 환경 함정 (다음 세션이 같은 데 빠지지 않도록)

### ① `nc -z` 로 포트를 찔러보지 말 것 🔴

연결만 열고 프레임 0개로 닫는 동작이 정확히 **NET-3 이 기술한 KA 구멍**이다. 구 펌웨어(12 s 유휴 타임아웃 이전)에서는 이것이 **W5500 소켓을 영구 고착**시켜 **전원 재인가 전까지 Modbus 접속 불가**가 된다. 이번 세션 개시 때 실제로 이렇게 보드를 물려 30분을 날렸다. 역설적으로 NET-3 의 사전 실증이 됐지만, 다시 하지 말 것.

### ② **TCP connect 성공 ≠ MCU 생존** 🔴

**W5500 이 SYN 을 자체 응답**하므로 MCU 가 halt/hang 이어도 `connect()` 가 성공할 수 있다. 생존 판정은 **반드시 FC03 트랜잭션**으로 할 것. 이 함정 때문에 W-3 첫 측정(8.59 s)과 NET-2/3 첫 판정이 무효였고 전부 재실행했다.

### ③ `mbpoll` 이 이 환경에서 동작하지 않는다

`mbpoll: Connection failed: No route to host` 가 일관되게 났다(같은 순간 `nc`·python socket 은 성공). 샌드박스 해제로도 동일. **대체 = 자체 최소 MBAP 클라이언트**(연결 유지형, 재시도 포함) — 체크리스트의 `-r N`(1-based)을 wire 주소(0-based)로 그대로 다룬다. 벤치는 이걸로 전부 수행했다.

### ④ openocd 메모리 읽기

`mdb` 가 출력을 내지 않았다. `set v [read_memory ADDR 8 N]` + `echo` 를 쓸 것. Tcl 이라 `[31:24]` 같은 대괄호를 echo 문자열에 넣으면 명령 치환으로 깨진다.

---

## 5. 보드 마감 상태

STD 빌드 재플래시 완료. 잔재 전부 원복:

`OUT_POWER 77` · `ON_TIME 750` · `EN_SAFTY 0` · `MODEL_FREQ 3` · `MODEL_TYPE 2` · `COMM addr 1 / speed 4 / parity 0` · `comm_mode ETH_STATIC 192.168.1.199` · `CAL_VAL 16` · `FREQ_CAL_VAL 40` · `HORN_CMD 0` · `CFG_STAT IDLE` · `STATUS 0x00`

throwaway hang 주입은 원복됨(`git status` clean).

---

## 6. RS-485 어댑터 확보 후 추가 실행 (2026-09-05 후반)

어댑터 = `/dev/cu.usbserial-AB0MLYXA`. **RTU 와 mon 이 USART6 를 공유**하므로 둘은 배타적이다 — `comm_mode=ETH_*` 면 mon 청취, `SERIAL` 이면 RTU. `comm_mode`(`0x21`)는 설계상 R-only 라 전환은 **LCD 조작(사용자)** 이 필요했다.

### 6.1 mon 캡처 (comm_mode = ETH_STATIC)

```
[boot] gds_us_ctrl ready rst=0x04          ← S-1 PASS (리셋 원인 배너)
[lcd] ready=1
[lcd-hook] set_pot power=77 dac=68         ← S-P PASS (pot write 실제 발생)
[lcd] run_page_confirmed=1
[cfg] freq=3 type=2 work=1 energy=3011 en_e=0 en_m=0
[cfg] fram_fail=0 unstick=0 i2c_err=0
[eth] chip up / waiting for PHY link... / [eth] up ip=192.168.1.199
```

⚠ `work=1` — `work_cnt` 는 0 이 아니라 **1** 이다(이전 기록의 "0" 은 부정확). `WORK_CNTL` 결함 판정(0 아닌 65536 배수)에는 영향 없다.

### 6.2 RTU (comm_mode = SERIAL, 9600 8E1, unit 1) — 전건 PASS

| # | 항목 | 결과 |
|---|---|---|
| — | RTU 무회귀 | PASS — FC03 50칸 + FC06 클램프 30→50 / 120→100 |
| **FA-7** | same-link 거부 (RTU→serial) | PASS — `CFG_STAT`=**4** + cfg 불변 + **RTU 생존**, DISCARD 후 IDLE |
| **FA-6** ⭐ | **교차 커밋 RTU→ether** | PASS — staged `.198` 미러=staged 값 → 커밋 `CFG_STAT`=**2** + **RTU 링크 생존** + cfg 반영. `.199` 재커밋으로 원복까지 같은 경로 확인 |
| **FA-12** | 링크 전이 = staging 폐기 | PASS — staged(`CFG_STAT`=1) 남긴 채 LCD 로 SERIAL→ETH 전환 → **`0`(IDLE) + 미러 복귀** |
| FA-6 (나머지 다리) | 새 IP 로 TCP 접속 | PASS — ETH 복귀 후 `.199` 로 TCP 트랜잭션 성공 = RTU 커밋분이 실계에 유효 |

⭐ **DG-12 전제가 이제 양방향 실측이다** — TCP→serial(FA-5, 오전) + RTU→ether(FA-6, 후반). 교차 경로 커밋은 링크를 끊지 않는다.

### 6.3 도구 신설

`docs/superpowers/tools/mb_rtu.py` — 최소 Modbus RTU 마스터(mbpoll 대체). `mb_tcp.py` 와 **같은 API**(`read`/`r1`/`write`)라 스크립트 재사용 가능. 🔴 mon 캡처용 `cat` 이 포트를 잡고 있으면 안 열린다 → `pkill -x cat` 먼저.

### 6.4 🔴 발견 — `fw/build/` 가 BYPASS 빌드였다

`fw/build/CMakeCache.txt` 에 벤치 세션 잔재 **`REMOTE_EN_GATE_BYPASS:BOOL=ON`** 이 남아 있었고, `./fw.sh` 는 캐시를 재사용하므로 **"STD 빌드"라 부르며 BYPASS 빌드를 만들고 있었다.** 부팅 mon 의 `*** REMOTE ENABLE GATE BYPASSED ***` 로 발각.

- **STD 에서는 기능적으로 no-op** — `remote_en_step()` 이 STD 에서 `s_ren.state = REN_ENABLED` 고정(`app_modbus.c:139`)이라 BYPASS 가 지우는 검사는 어차피 항상 통과한다. 따라서 **과거 STD 결과는 무효가 아니다.**
- 다만 §실행 헤더의 "STD `build/`(FLASH 50.53 %)" 는 **BYPASS 판 수치**다. 깨끗한 STD = **50.62 %**(+104 B).
- 조치: `rm -rf fw/build` 후 재구성·재플래시, 배너에 BYPASS 문구 0건 확인, 회귀 27항목 재실행 전건 PASS.
- ⚠ **교훈**: `./fw.sh` 는 기존 CMake 캐시의 옵션을 물려받는다. 벤치용 옵션을 켠 뒤에는 캐시를 지울 것. "보드에 무엇이 올라갔나"를 문서로 믿지 말라는 기존 교훈(2026-07-05 · 2026-08-16)의 빌드-옵션 판이다.

---

## 7. 잔여 항목 배치 실행 (2026-09-05 후반 II) — 전건 PASS

RS-485 확보 + 사용자 재석으로 **PC8 제외 잔여를 한 번에 걷었다.** 설계 기준 = **사용자 조작 최소화**(LCD 방문 3회 · 화면 흘긋 4회 · 전원 사이클 1회 · comm_mode 전환 2회).

| 섹션 | 항목 | 결과 |
|---|---|---|
| **NET** | NET-1 mon 로그 | PASS — `[mbtcp] idle 12s -> disconnect` (15 s 방치) |
| | NET-2 즉시 재접속 | PASS |
| **S** | S-5 ICON_RUN + 값 3종 | PASS — bit0 1→1→0 + ICON 육안 + SETUP1 값 `77/750/3011` 대조 |
| **M** | M-1 STD 버전 문자열 | PASS — 육안 |
| **B34** | B34-2 LCD horn → bit6 | PASS — LCD SAVE 로 `STATUS=0x40` |
| | B34-3 horn 중 START 차단 | PASS — ×3 전부 bit0=0 + bit6 로 사유 관측 + `0x1B` 소거 |
| | B34-5 원격 `0x30` 조작 | PASS |
| | B34-7 체크박스 되읽기 | PASS — 육안(체크됨) |
| | B34-8 해제 + 상위비트 무오염 | PASS — `STATUS=0x00` |
| | **B34-9 솔 강제 OFF** | PASS — **전이 3방향 모두** `[horn] mode=N SOL_DN off` (LCD→ON / 원격→OFF / 원격→ON) |
| | B34-4 비영속 | PASS — 전원 사이클 후 `0x30`=0 + bit6 소멸 |
| **MOD** | MOD-1 읽기 무회귀 | PASS — 육안 `30 kHz` / `HAND` |
| | MOD-2/3 모델명 즉시 갱신 | PASS — 육안 `GDS-30H` |
| | MOD-4 파생상태 즉시 불변 | PASS — type 쓰기 후에도 **STD 화면 유지** |
| | **MOD-6 E-stop** | PASS — 누름 `bit1=1` → 놓고 **0.5 s 이내 `0`**(4.7 s 유지). **레벨 추종, RESET 불요** |
| | MOD-7 영속 + 화면 전환 | PASS — 재부팅 후 `freq=2 type=0` + **HAND 화면으로 전환** |
| **CAL** | CAL-2 LCD `-16` 표시 | PASS — 단 **`-0.16`** 으로 표시(§7.1) |
| | CAL-6 LCD SAFETY 표시 | PASS |
| **FA** | FA-15 커밋 영속 | PASS — `speed=3` 커밋이 재부팅 후 유지 |
| | FA-2 LCD 반쪽 | PASS — staged `9600` 인데 **화면은 `19200` 그대로** (SERIAL 구간에서 확인) |
| **W** | **W-1 전원인가 리셋 원인** | PASS — **`rst=0x0E`**. 오늘까지 유일한 미관측 값이었다 |

⭐ **전원 사이클 1회에 4항목**(W-1 · B34-4 · MOD-7 · FA-15)을 태웠다. 사용자 조작이 가장 비싼 자원이라 배치가 이득이 컸다.

### 7.1 🔴 체크리스트 오류 3번째 — `cal_val` 은 LCD 에서 `-0.16` 으로 보인다

체크리스트는 `-16` 을 기대값으로 적었으나 **실제 표시는 `-0.16`** 이고, 사용자가 **"이게 맞다"**고 확인했다. 펌웨어 결함이 아니다.

- 펌웨어는 **원시 int16 을 그대로** 쓴다 — `app_lcd_input.c:327` `dgus_write_u16(VAR_CAL_VAL, (uint16_t)cfg->cal_val)`, VP `0x1410`
- **`÷100` 은 DGUS 자산 쪽 위젯 설정**이다. 펌웨어에 스케일 없음
- → Modbus `0x2E` 로 읽는 값과 LCD 표시가 **같은 값의 다른 렌더링**이다

**`gds_us_remote` 통보 완료** — 그쪽이 원시 정수를 그리면 조작자가 두 화면에서 100배 다른 숫자를 본다. 그쪽 판단 = "LCD 와 맞춰 `÷100`, 단 현재 cal 미파싱이라 코드 영향 0, 그리는 날의 선행 조건으로 계약에 박음"(그쪽 `91ce66b`).
⚠ **`FREQ_CAL_VAL(0x2F)` 은 미확정** — 오늘 육안은 `40`(양수)뿐이라 소수점 여부를 못 갈랐다. **다음 CAL 항목 때 음수를 한 번 써서 확인할 것.**

(1·2번째 오류 = §2 의 S-3 전제 누락 · CAL-6 기대치.)

### 7.2 E-stop 의 mon 흔적 = `us_command=3` 반복

E-stop 유지 중 `[lcd-hook] us_command=3` 이 **19회** 찍혔다. `us_cmd_t` 에서 **3 = `US_CMD_RUN_RELEASE`**(START=0/SEEK=1/RESET=2, `app_lcd.h:56-61`) — **매 tick force-stop** 을 내는 설계 그대로다. E-stop 전용 mon 라인은 없으므로, 앞으로 E-stop 을 mon 으로 판정할 때는 이 패턴을 보면 된다.

### 7.3 실행 중 겪은 것

- **`MODEL_TYPE` 이 세션 중 `2 → 1`(multi) 로 바뀌어 있었다.** 원격기가 쓴 것으로 의심했으나 **사용자가 직접 바꾼 것**이었다. 계획 대부분이 STD 전제(SETUP1 화면 · horn hook 은 STD SAVE 경로 전용 · PC11 은 std 에서만 EMSW)라 std 복원 후 진행했다. **의심을 확인 없이 원격기 결함으로 기록하지 않은 것이 옳았다.**
- **FA-2 LCD 는 ETH 모드에서 확인 불가** — C 탭이 이더넷 필드를 보여주고 BAUD 가 없다. SERIAL 구간으로 이월해 확인했다. 계획 착오였다.
- **staging 30 s 만료**를 피하려 백그라운드 루프로 8 초마다 재-stage 했다. 사용자가 화면 앞에서 시간을 쓸 수 있게 하는 데 유효했다.

---

## 8. 타 세션(`gds_us_remote`) 벤치에서 얻은 우리 펌웨어 실측 3건

R2-07 S6 벤치(2026-09-05, 원격기 세션이 보드를 점유해 실행)에서 **우리가 돌리지 않은 항목**의 컨트롤러 거동이 관측됐다. 출처가 타 세션이지만 대상은 이 펌웨어이므로 여기 남긴다.

### 8.1 🔴 `ADDRESS` 변경 중 TCP 링크 생존 — 소스 추론이 실측으로 승격

원격기가 `COMM_ADDR(0x1E)` 을 `1 → 2 → 1` 로 **TCP 로 커밋하는 동안 링크가 끊기지 않았다**(폴링 17.8→19.0/s, 실패 0).

우리가 소스 3곳으로 답한 **"TCP 는 MBAP unit id 를 `comm_addr` 과 대조하지 않는다"** 가 이것으로 실측 확인됐다:
- `app_modbus_core.c:179-184` — 주소 필터가 `mode == MB_MODE_RTU` 분기 안에만 있다
- `app_modbus_tcp_frame.c:45` — `out[6] = req[6]`, 응답 unit 은 **요청분 에코**
- `app_modbus.c:727` — TCP 서버 진입 조건에 addr 이 없다

⚠ 함께 경고한 **`COMM_ADDR = 0` 함정**은 여전히 유효하다 — `0`=NONE 이라 TCP 로는 무해해 보이지만 **다음에 `comm_mode` 를 SERIAL 로 바꾸는 순간 RTU 가 안 뜬다**(2026-07-04 세션이 실제로 당한 사건). 범위 검증은 커밋만 막고 staged 쓰기는 통과하므로, 방어는 **소비 측 화면이 0 을 못 만드는 것**이어야 한다.

### 8.2 `REJ_RUNNING` 왕복 전체 — 거부 사유의 재-staging 거동

| 조작 | `CFG_STAT` |
|---|---|
| staged → 가동 중 커밋 | `1 → 5` (REJ_RUNNING) |
| **가동 중 재-SAVE(재쓰기)** | **`5 → 1 → 5`** — 재쓰기가 stat 을 `1` 로 되돌렸다가 다시 거부 |
| STOP 후 커밋 | `5 → 1 → 2` |

⭐ 우리가 원격기에 경고한 **"거부 사유가 사라졌다 = 고쳐졌다 로 오독하지 말 것"**(재쓰기 순간 `stat` 이 `1` 로 돌아가지만 아직 커밋 전)이 실물로 관측됐다. `1→2` 전이만 성공으로 읽는 판정이 이것을 막았다.

### 8.3 만료 staging 의 복구 경로

`6 → 1 → 2` — **`REJ_TIMEOUT` 으로 dirty 가 소거된 뒤에도 재-staging 하면 되살아난다.** §6/§7 에서 확인한 "TIMEOUT 만 dirty 를 소거한다"(그래서 재커밋 no-op)와 정합하며, 조작자 안내가 **"처음부터 다시 입력"** 이어야 하는 근거가 된다.

### 8.4 마감 상태

원격기 재덤프가 우리 인계값과 **전 항목 일치**. 이전 기준선 대비 diff 는 **`0x02~0x05` 라이브 실측 블록 4건뿐**(`DISP_POWER 63→110` · `AMP 29→50` · `FREQ 34919→34988` · `ENERGY 1→1234`) — 그쪽 B6 에서 기계를 돌린 흔적이다. **설정·상태 46칸 diff 0.**

⚠ 미결로 남은 것: **`FREQ_CAL_VAL(0x2F)` 음수 표시**(소수점 여부) — 다음 CAL 항목 때 육안 1회.
