shuug2/gds_us_ctrl/hw/schematics/usw_ctrl_v26_samd20.pdf

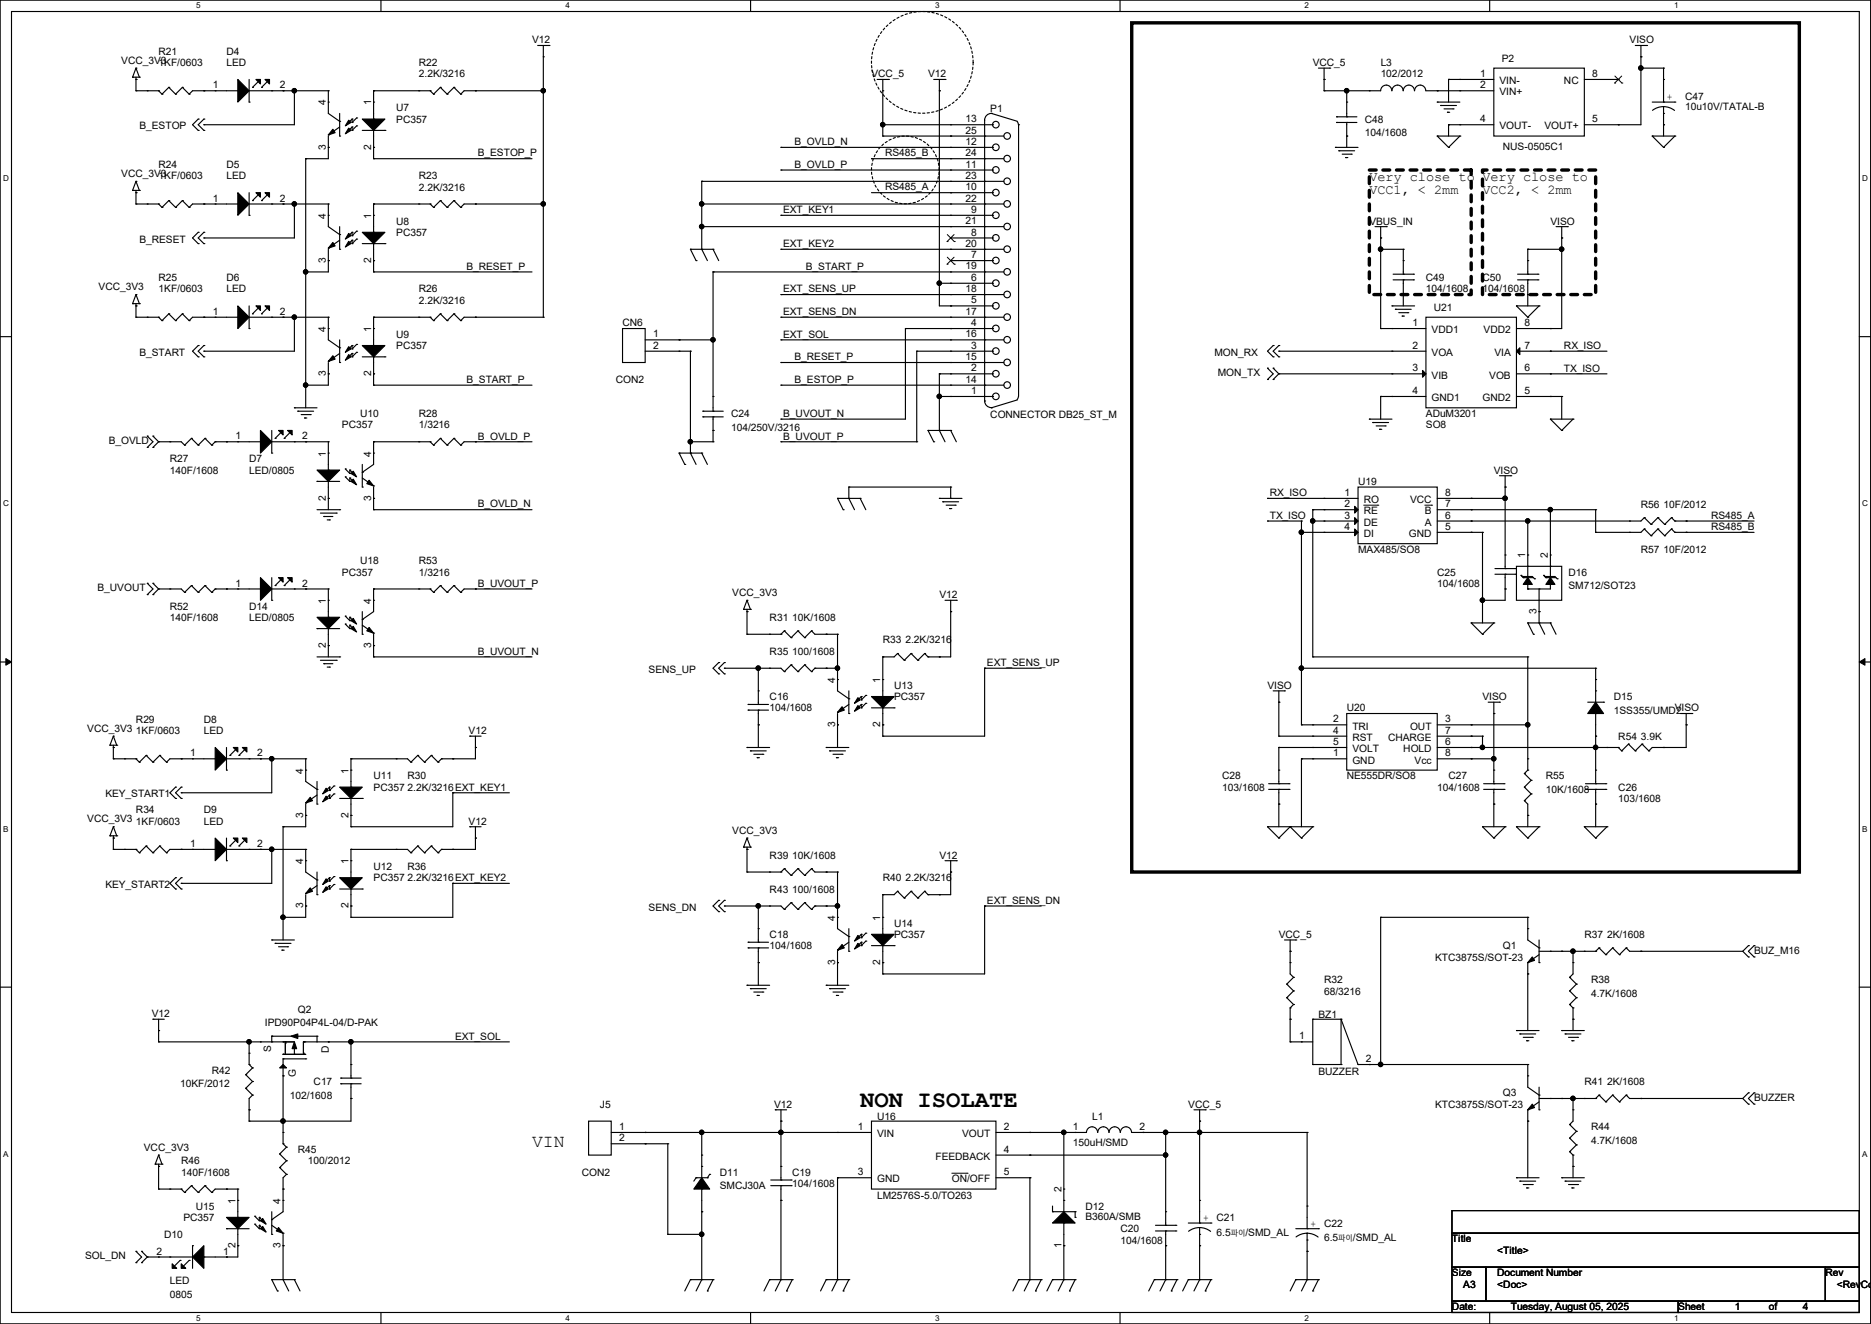
[picture p22: page 1]

25-1-21
VCC_3 V3 | VCC_5 에서 | 로 변경

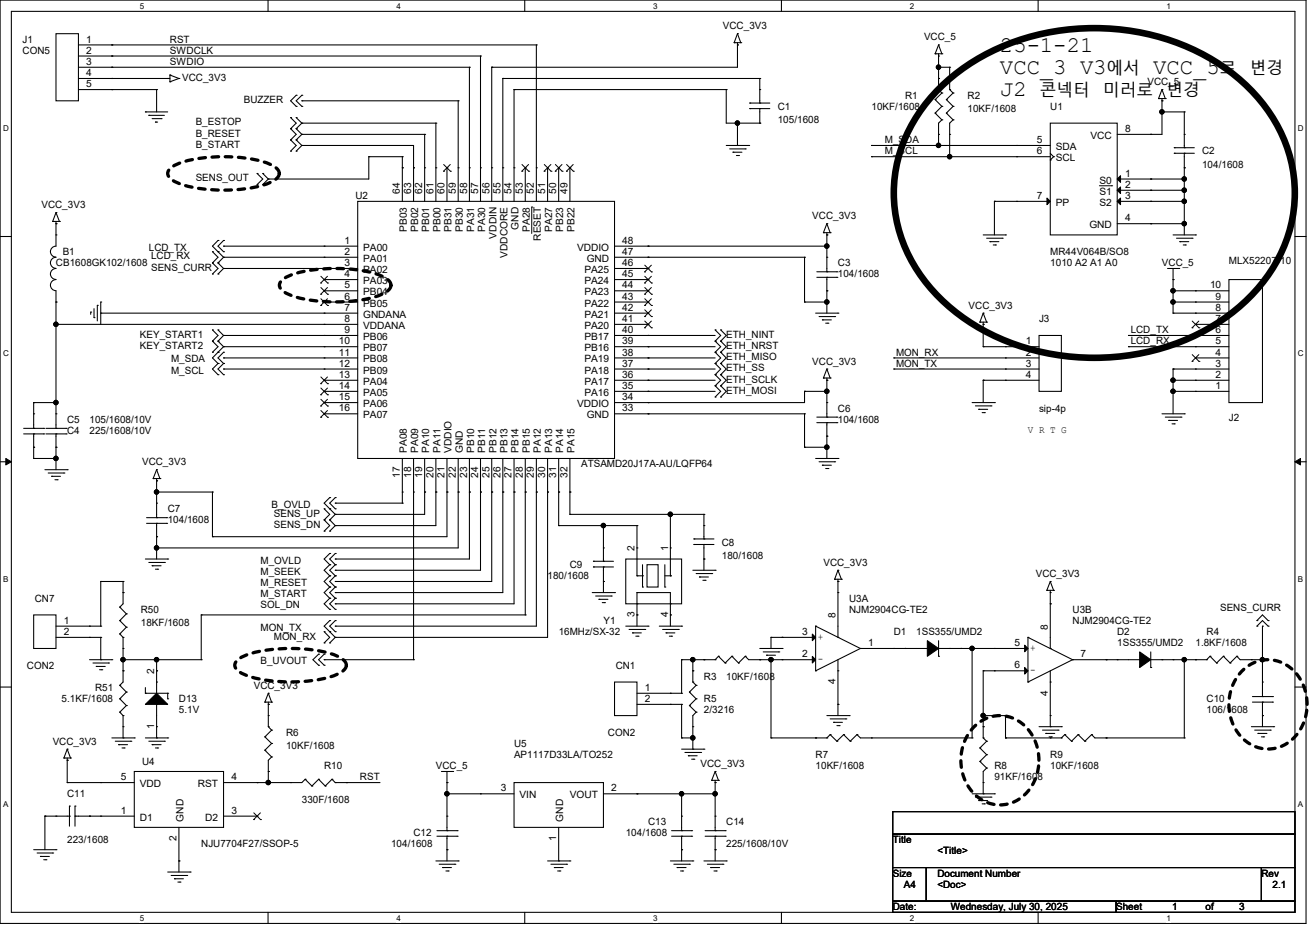
[picture p23: page 2]

GND 33 VDDIO 34 PA16 35 PA17 36 PA18 37 PA19 38 PB16 39 PB17 40 PA20 41 PA21 42 PA22 43 PA23 44 PA24 45 PA25 46 GND 47 VDDIO 48 PB²² ⁴⁹ PB²³ ⁵⁰ PA²⁷ ⁵¹ RESET 52 PA²⁸ ⁵³ GND ⁵⁴ VDDCORE ⁵⁵ VDDIN ⁵⁶ PA³⁰ ⁵⁷ PA³¹ ⁵⁸ PB³⁰ ⁵⁹ PB³¹ ⁶⁰ PB⁰⁰ ⁶¹ PB⁰¹ ⁶² PB⁰² ⁶³ PB⁰³ ⁶⁴

D D

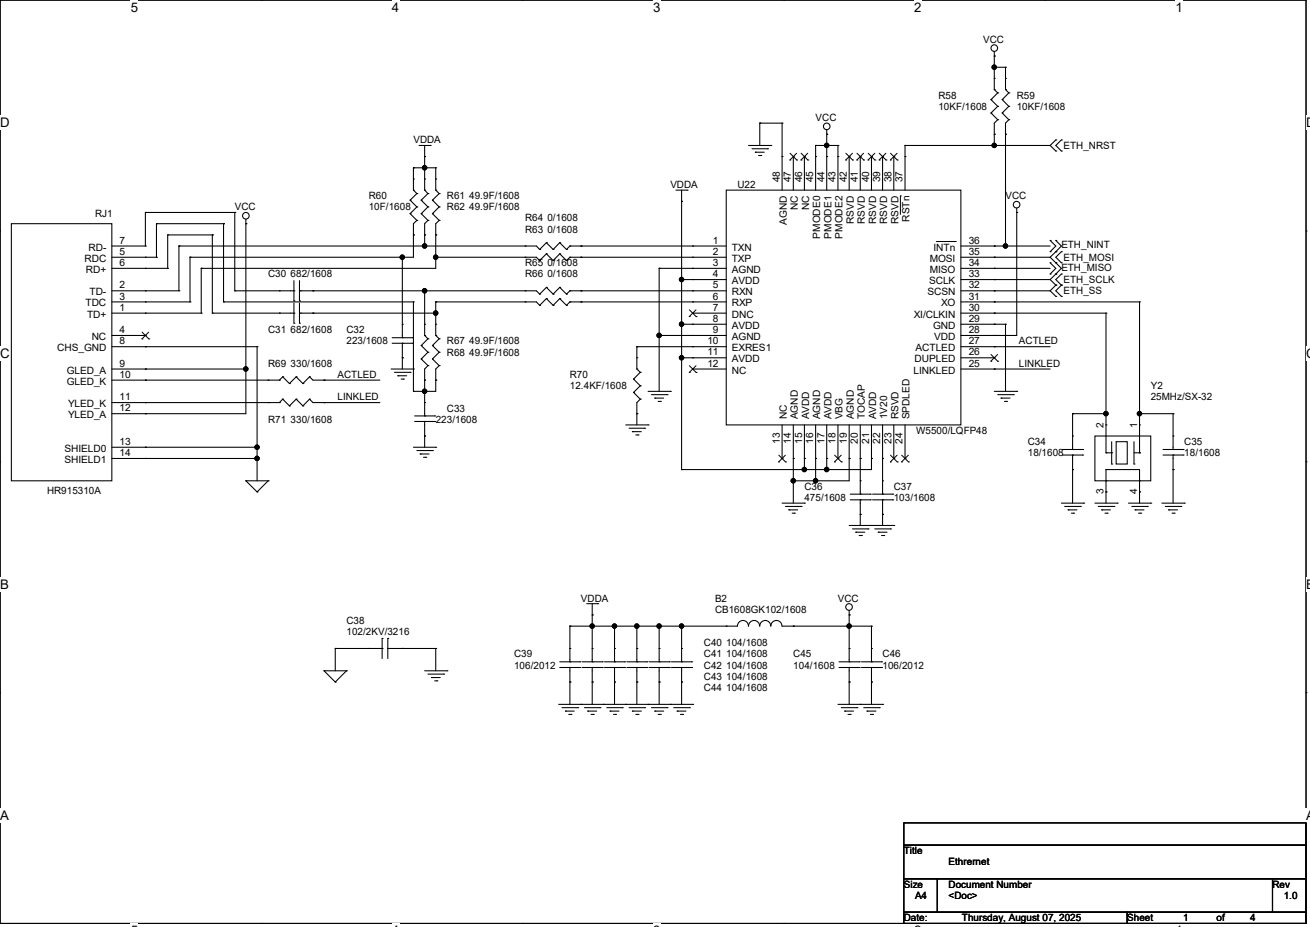
[picture p24: page 3]

LINKLED 25 DUPLED 26 ACTLED 27 VDD 28 GND 29 XI/CLKIN 30 XO 31 SCSN 32 SCLK 33 MISO 34 MOSI 35 INTn 36 RSTn 37 RSVD ³⁸ RSVD ³⁹ RSVD ⁴⁰ RSVD ⁴¹ RSVD ⁴² PMODE² ⁴³ PMODE¹ ⁴⁴ PMODE⁰ ⁴⁵ NC ⁴⁶ NC ⁴⁷ AGND ⁴⁸

D D

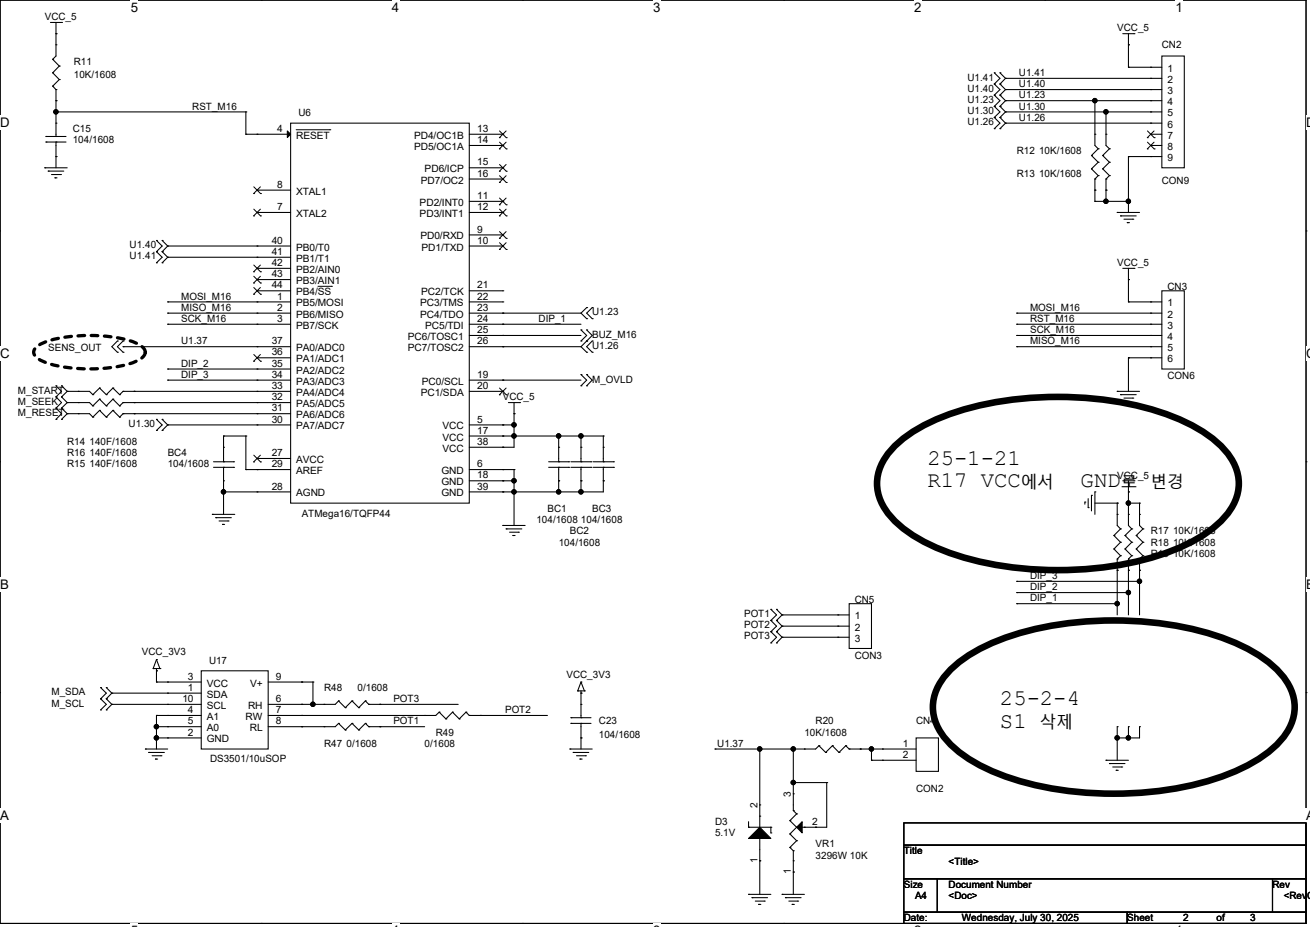
[picture p25: page 4]
