shuug2/gds_us_ctrl/hw/schematics/usw_ctrl_v30.pdf

# 1010 A2 A1 A0 V R T G

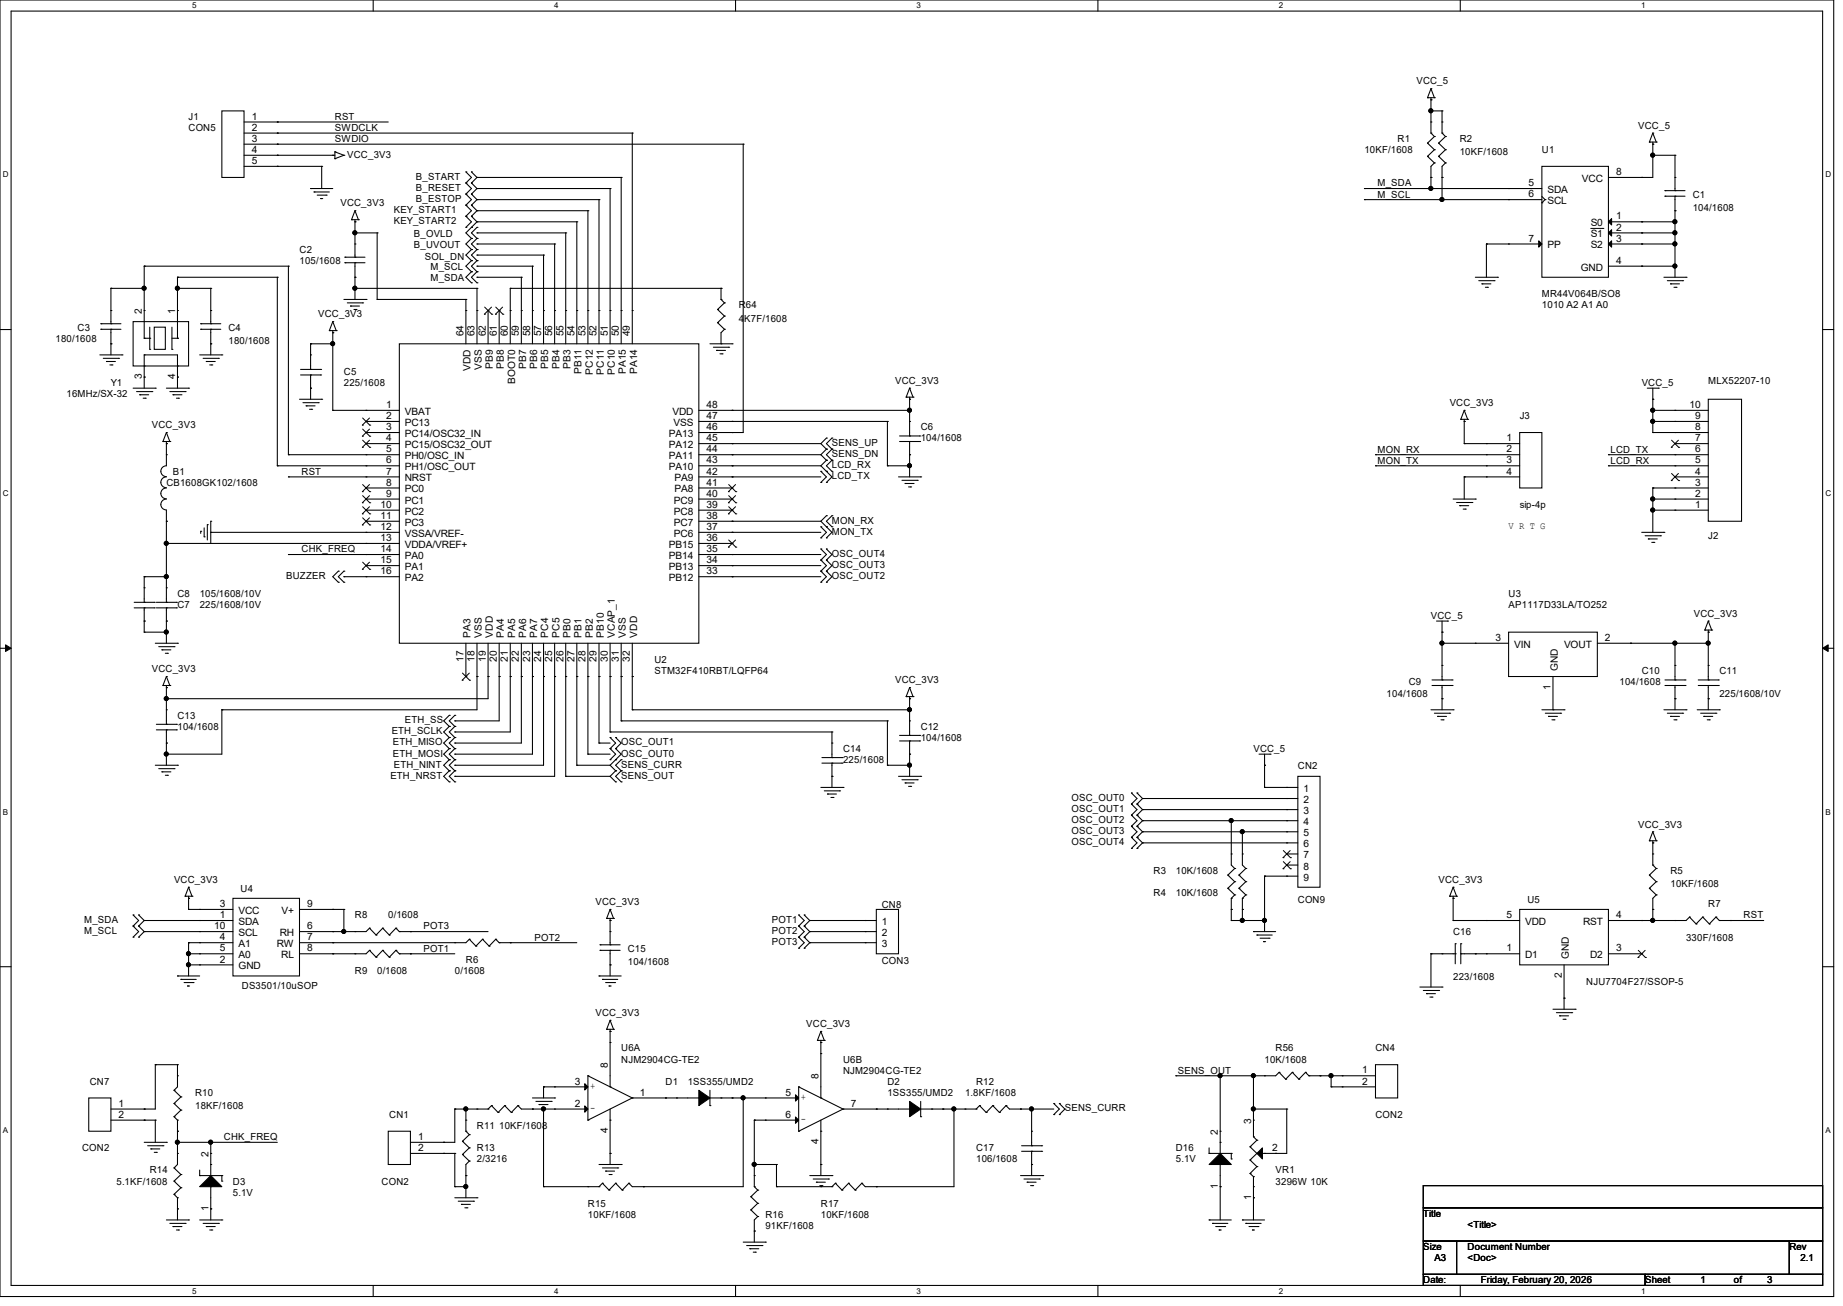
[picture p26: page 1]

D D

## VDDA

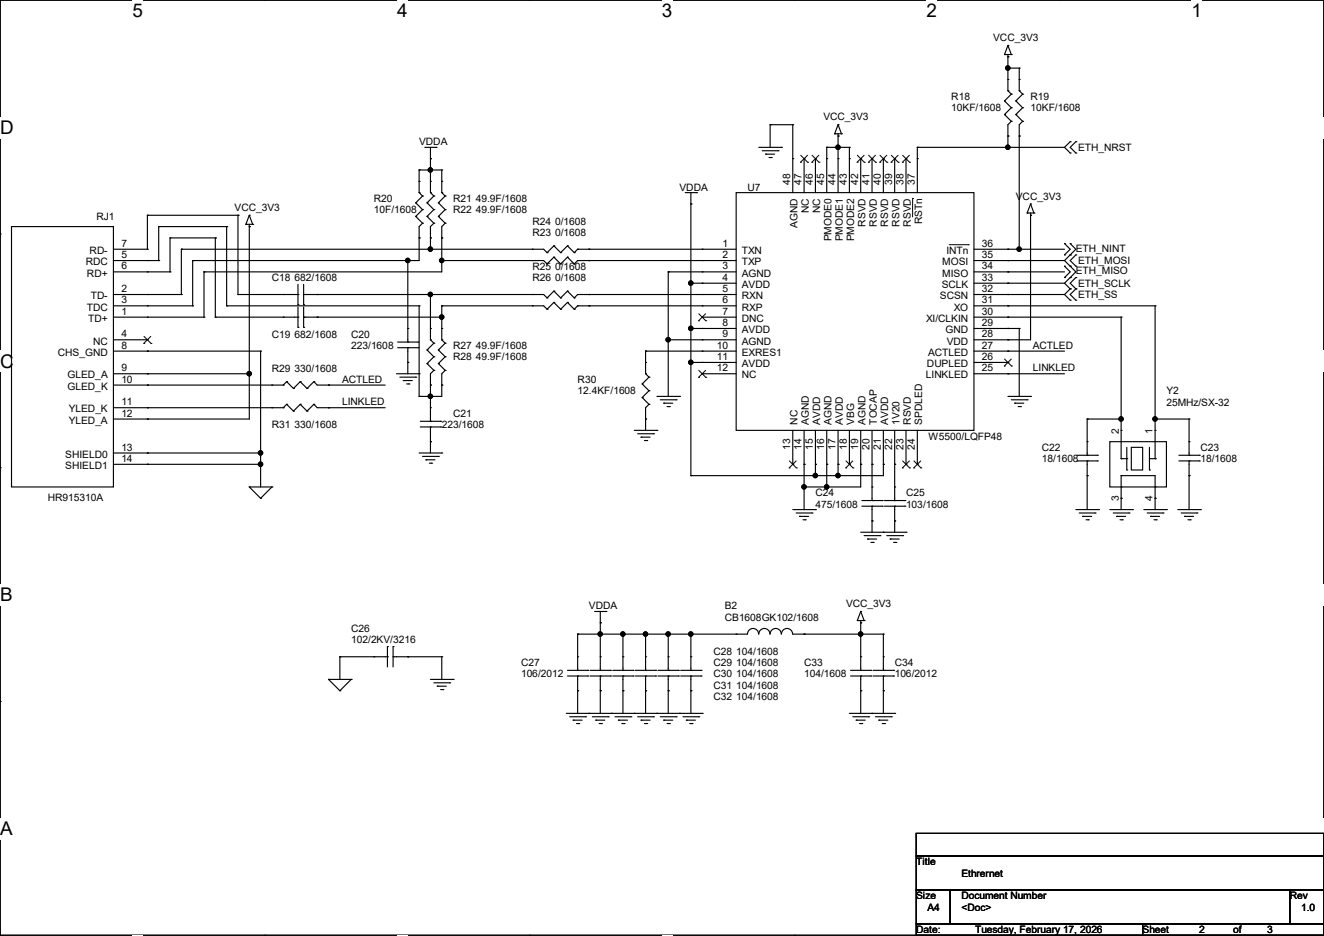
[picture p27: page 2]

35 INTn 36 RSTn 37 RSVD ³⁸ RSVD ³⁹ RSVD ⁴⁰ RSVD ⁴¹ RSVD ⁴² PMODE² ⁴³ PMODE¹ ⁴⁴ PMODE⁰ ⁴⁵ NC ⁴⁶ NC ⁴⁷ AGND ⁴⁸

MOSI 34
MISO 33
LINKLED 25 DUPLED 26 ACTLED 27 VDD 28 GND 29 XI/CLKIN 30 XO 31 SCSN 32 SCLK

## Very close to VCC1, < 2mm

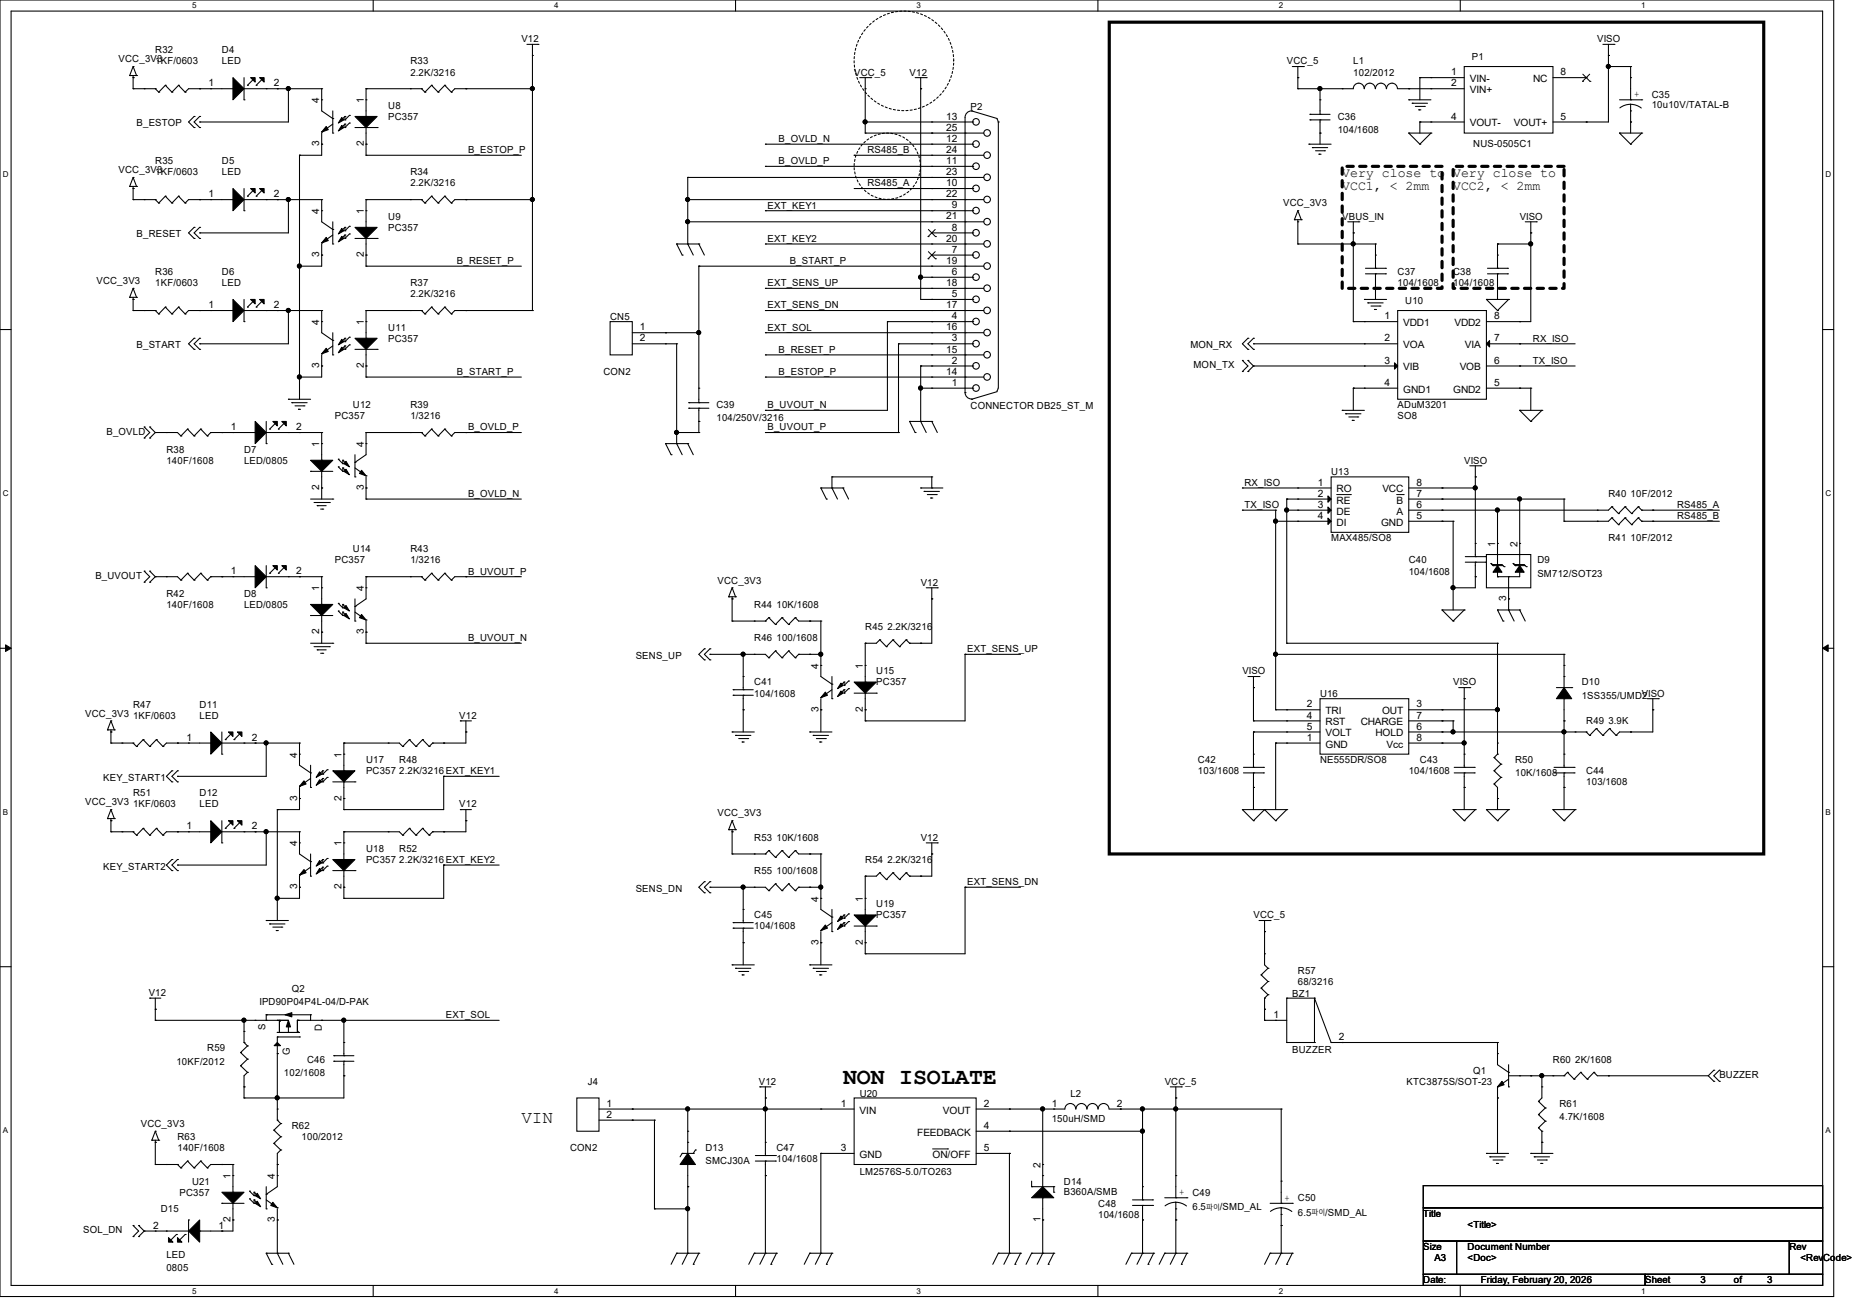
[picture p28: page 3]
