shuug2/gds_us_ctrl/fw/cube/gds_usctrl.ioc

Mcu.UserName=STM32F410RBTx
PA0-WKUP.GPIO_Label=FREQ_IN
PA0-WKUP.Signal=S_TIM5_CH1
PA10.GPIO_Label=LCD_RX
PA10.Signal=USART1_RX
PA11.GPIO_Label=CON_SENS_DN
PA11.Signal=GPIO_Input
PA12.GPIO_Label=CON_SENS_UP
PA12.Signal=GPIO_Input
PA13.Signal=SYS_JTMS-SWDIO
PA14.Signal=SYS_JTCK-SWCLK
PA15.GPIO_Label=CON_START
PA15.Signal=GPIO_Input
PA2.GPIO_Label=BUZZER
PA2.Signal=S_TIM9_CH1
PA4.GPIO_Label=ETH_SS
PA4.Signal=SPI1_NSS
PA5.GPIO_Label=ETH_SCK
PA5.Signal=SPI1_SCK
PA6.GPIO_Label=ETH_MISO
PA6.Signal=SPI1_MISO
PA7.GPIO_Label=ETH_MOSI
PA7.Signal=SPI1_MOSI
PA9.GPIO_Label=LCD_TX
PA9.Signal=USART1_TX
PB0.GPIO_Label=ADC_SENS_OUT
PB0.Signal=ADCx_IN8
PB1.GPIO_Label=ADC_OSC
PB1.Signal=ADCx_IN9
PB10.GPIO_Label=CTRL_OSC1
PB10.Signal=GPIO_Output
PB11.GPIO_Label=CON_KEY2
PB11.Signal=GPIO_Input
PB12.GPIO_Label=CTRL_OSC2
PB12.Signal=GPIO_Output
PB13.GPIO_Label=CTRL_OSC3
PB13.Signal=GPIO_Output
PB14.GPIO_Label=CTRL_OSC4
PB14.Signal=GPIO_Output
PB2.GPIO_Label=CTRL_OSC0
PB2.Signal=GPIO_Output
PB3.GPIO_Label=CON_OVLD
PB3.Signal=GPIO_Output
PB4.GPIO_Label=CON_USOUT
PB4.Signal=GPIO_Output
PB5.GPIO_Label=CON_SOL_DN
PB5.Signal=GPIO_Output
PB6.GPIO_Label=EEP_SCL
PB6.Signal=I2C1_SCL
PB7.GPIO_Label=EEP_SDA
PB7.Signal=I2C1_SDA
PC10.GPIO_Label=CON_RESET
PC10.Signal=GPIO_Input
PC11.GPIO_Label=CON_ESTOP
PC11.Signal=GPIO_Input
PC12.GPIO_Label=CON_KEY1
PC12.Signal=GPIO_Input
PC4.GPIO_Label=ETH_INT
PC4.Signal=GPIO_Input
PC5.GPIO_Label=ETH_NRST
PC5.Signal=GPIO_Output
PC6.GPIO_Label=MON_TX
PC6.Signal=USART6_TX
PC7.GPIO_Label=MON_RX
PC7.Signal=USART6_RX
