shuug2/gds_us_ctrl/fw/src/app_lcd_render.c

/* fw/src/app_lcd_render.c — change_lcd_page() render port (samd20 main.c:2942-3173).
 *
 * Per-page VP pre-fill then page switch. Wire calls mapped per spec §2.1:
 *   send_lcd_data_var  -> dgus_write_u16
 *   send_lcd_data_word -> dgus_write_u32
 *   send_lcd_byte_array-> dgus_write_bytes
 *   send_lcd_int_array -> dgus_write_u16_array
 *   set_lcd_page       -> dgus_set_page
 *
 * State split (vs samd20 globals):
 *   config / limits  -> app_lcd_cfg()   (app_config_t)
 *   transient/shadow -> app_lcd_state() (lcd_app_state_t)
 *   lcd_temp_buf     -> local scratch buffer (de-globalized)
 *
 * The samd20 I2C_POT write on setup-page-1 entry is routed through
 * app_lcd_hook_set_pot() = U4 @0x28 실구동 (drivers/i2c_pot.c, tag
 * hw-revA_fw-stage-i2c-pot). 칩 스케일/극성 보정은 6b.
 */
#include <stdint.h>
#include "define.h"    /* VERSION_MSG */
#include "app_lcd.h"
#include "app_config.h"
#include "dgus_lcd.h"
#include "sys_tick.h"
#ifdef LCD_TRACE_RX
#include "mon.h"
#endif

/* run_mode codes (samd20 main.c:519-520). Port app_config_t.run_mode uses the
 * same encoding (0=delay 1=trigger), so literals match verbatim. */
#define MODE_DELAY    0
#define MODE_TRIGGER  1

/* DISP_VERSION payload — 20 bytes, NO trailing NUL (sent raw via dgus_write_bytes).
 * 문자열은 define.h. samd20은 17바이트 리터럴을 20으로 보내 3바이트 over-read
 * (main.c:3046) — 포트는 길이를 여기서 강제한다. */
_Static_assert(sizeof(VERSION_MSG) - 1u == 20u, "VERSION_MSG must be exactly 20 chars");

/* STD RUN 페이지 텍스트·수치 재기록 — LCD_RUN_STD: DELAY/TRIGGER 별 D/W(E)/H 3줄 텍스트
 * + 수치 4필드(LV_DM_DELAY/DISP_RUN_MODE/DISP_SAFTY/LV_LIMIT_OUT_T). set_page 는 하지 않는다.
 * 호출처 = app_lcd_change_page(페이지 진입) + app_modbus_apply_writes(FC06 cfg 저장 뒤,
 * spec 2026-09-11 §3.2). 페이지 게이트 없음 — 데이터/텍스트 VP 는 페이지 밖에서 써도 VP RAM 에
 * 남고, 경고→런 복귀 5곳(app_lcd_input.c:103/126/130/151/266)이 set_page 만 하므로 게이트가
 * 있으면 경고 중 도착한 원격 쓰기가 복귀 뒤 stale 로 남는다. */
void app_lcd_run_std_refresh(void)
{
    const app_config_t *cfg = app_lcd_cfg();
    uint8_t buf[20];            /* line-build scratch (samd20 global lcd_temp_buf) */
    uint8_t n;                  /* formatter return length (samd20 'temp') */
    dgus_write_u16(LV_DM_DELAY,    cfg->limit_delay_time1);
    dgus_write_u16(DISP_RUN_MODE,  cfg->run_mode);
    dgus_write_u16(DISP_SAFTY,     cfg->f_safty);
    dgus_write_u16(LV_LIMIT_OUT_T, cfg->limit_out_time);

    if (cfg->run_mode == MODE_DELAY) {
        buf[0] = 'D'; buf[1] = ' '; buf[2] = ':'; buf[3] = ' ';
        n = time2str(cfg->limit_delay_time1, &buf[4]);
        dgus_write_bytes(DISP_STD_DATA1, buf, (uint8_t)(n + 4));

        if (cfg->energy_ctrl) {
            buf[0] = 'E'; buf[1] = ' '; buf[2] = ':'; buf[3] = ' ';
            n = energy2str(cfg->limit_energy, &buf[4]);
            dgus_write_bytes(DISP_STD_DATA2, buf, (uint8_t)(n + 4));
        } else {
            buf[0] = 'W'; buf[1] = ' '; buf[2] = ':'; buf[3] = ' ';
            if (cfg->multi_ctrl)
                n = time2str((uint16_t)(cfg->limit_mo_time1 + cfg->limit_mo_time2), &buf[4]);
            else
                n = time2str(cfg->limit_delay_time2, &buf[4]);
            dgus_write_bytes(DISP_STD_DATA2, buf, (uint8_t)(n + 4));
        }

        buf[0] = 'H'; buf[1] = ' '; buf[2] = ':'; buf[3] = ' ';
        n = time2str(cfg->limit_delay_time3, &buf[4]);
        dgus_write_bytes(DISP_STD_DATA3, buf, (uint8_t)(n + 4));
    } else if (cfg->run_mode == MODE_TRIGGER) {
        buf[0] = 'S'; buf[1] = 'E'; buf[2] = 'N'; buf[3] = 'S';
        buf[4] = 'O'; buf[5] = 'R'; buf[6] = ' '; buf[7] = 'O';
        buf[8] = 'F'; buf[9] = 'F'; buf[10] = '\0';
        dgus_write_bytes(DISP_STD_DATA1, buf, 11);

        if (cfg->energy_ctrl) {
            buf[0] = 'E'; buf[1] = ' '; buf[2] = ':'; buf[3] = ' ';
            n = energy2str(cfg->limit_energy, &buf[4]);
            dgus_write_bytes(DISP_STD_DATA2, buf, (uint8_t)(n + 4));
        } else {
            buf[0] = 'W'; buf[1] = ' '; buf[2] = ':'; buf[3] = ' ';
            if (cfg->multi_ctrl)
                n = time2str((uint16_t)(cfg->limit_mo_time1 + cfg->limit_mo_time2), &buf[4]);
            else
                n = time2str(cfg->limit_trigger_time2, &buf[4]);
            dgus_write_bytes(DISP_STD_DATA2, buf, (uint8_t)(n + 4));
        }

        buf[0] = 'H'; buf[1] = ' '; buf[2] = ':'; buf[3] = ' ';
        n = time2str(cfg->limit_trigger_time3, &buf[4]);
        dgus_write_bytes(DISP_STD_DATA3, buf, (uint8_t)(n + 4));
    }
}

/* change_page 본체 — SETUP_HAND/MULTI/STD1: 버전·on_time·power(+pot)·energy + comm shadow 시드/센티널 */
static inline __attribute__((always_inline)) void render_setup_main(const app_config_t *cfg, lcd_app_state_t *state)
{
    dgus_write_bytes(DISP_VERSION, (const uint8_t *)VERSION_MSG, 20);
    dgus_write_u16(LV_MAX_ON_TIME, cfg->limit_on_time);
    dgus_write_u16(LV_OUT_POWER,   cfg->output_power);
    app_lcd_hook_set_pot(cfg->output_power);   /* samd20 inline I2C_POT write -> hook (실구동) */
    dgus_write_u32(LV_ENERGY_VAL,  cfg->limit_energy);
    dgus_write_u16(LV_ENERGY_EDIT, (uint16_t)cfg->limit_energy);
    dgus_write_u16(DISP_ENERGY_EN, cfg->energy_ctrl ? 1u : 0u);
    dgus_write_u16(LV_LIMIT_OUT_T, cfg->limit_out_time);
    state->temp_parity_idx = cfg->comm_parity_idx;
    state->temp_address    = cfg->comm_address;
    state->temp_speed_idx  = cfg->comm_speed_idx;
    state->temp_cnt_reset  = 0;
    state->temp_comm_mode  = 0xff;
}

/* change_page 본체 — STDC/MHC·STDE/MHE 공통: comm 3필드 에코 + shadow + (첫 진입) ether 텍스트 시드 (두 분기에서 각각 호출) */
static inline __attribute__((always_inline)) void render_comm_page(const app_config_t *cfg, lcd_app_state_t *state,
                                                  uint8_t *addr_str, char *ipbuf)
{
    uint16_t i;
    uint8_t  n;
    dgus_write_u16(COMM_ADDR,   cfg->comm_address);
    dgus_write_u16(COMM_SPEED,  cfg->comm_speed_idx);
    dgus_write_u16(COMM_PARITY, cfg->comm_parity_idx);
    state->temp_parity_idx = cfg->comm_parity_idx;
    state->temp_address    = cfg->comm_address;
    state->temp_speed_idx  = cfg->comm_speed_idx;
    conv_addr2str(cfg->comm_address, addr_str);
    dgus_write_bytes(COMM_ADDR_TXT, addr_str, 4);
    dgus_write_bytes(COMM_SPEED_TXT, comm_speed_txt[cfg->comm_speed_idx], 6);
    dgus_write_bytes(COMM_PARITY_TXT, comm_parity_txt[cfg->comm_parity_idx], 4);
    if (state->temp_comm_mode == 0xff) {
        state->temp_comm_mode = cfg->comm_mode;
        for (i = 0; i < 4; i++) {
            state->temp_ether_ip[i] = cfg->ether_ip[i];
            state->temp_ether_nm[i] = cfg->ether_nm[i];
            state->temp_ether_gw[i] = cfg->ether_gw[i];
        }
        n = ip_to_string(state->temp_ether_ip, ipbuf);
        dgus_write_bytes(COMM_IP_TXT, (const uint8_t *)ipbuf, n);
        n = ip_to_string(state->temp_ether_nm, ipbuf);
        dgus_write_bytes(COMM_NM_TXT, (const uint8_t *)ipbuf, n);
        n = ip_to_string(state->temp_ether_gw, ipbuf);
        dgus_write_bytes(COMM_GW_TXT, (const uint8_t *)ipbuf, n);
        state->ether_current_number   = 0;
        state->ether_current_octet    = 0;
        state->ether_has_input        = false;
        state->ether_ip_input_complete = false;
        state->ether_buffer_pos       = 0;
        state->ether_what_input       = LCD_ETHER_INPUT_NONE;
    }
}

/* change_page 본체 — comm 페이지 set_page 후 DISP_COMM_MODE/EN_DHCP 재기록 (외곽 페이지 판정은 호출자) */
static inline __attribute__((always_inline)) void render_comm_tail(uint8_t page, const lcd_app_state_t *state)
{
    dgus_write_u16(DISP_COMM_MODE, (state->temp_comm_mode == 0) ? 0u : 1u);
    if (page == LCD_SETUP_MHE || page == LCD_SETUP_STDE) {
        dgus_write_u16(DISP_EN_DHCP,
                       (state->temp_comm_mode == 0)
                           ? 0u : (uint16_t)(state->temp_comm_mode - 1));
    }
}

/* 페이지 렌더+전환 */
void app_lcd_change_page(uint8_t page)
{
    /* Render one panel page, then switch to it. Verbatim port of samd20
     * change_lcd_page (main.c:2942-3173). */
    app_config_t    *cfg   = app_lcd_cfg();
    lcd_app_state_t *state = app_lcd_state();

    uint8_t  addr_str[4];       /* conv_addr2str field (samd20 'temp_str') */
    char     ipbuf[16];         /* ip_to_string scratch */

    /* --- unconditional top (main.c:2947-2955) --- */
    dgus_write_u16(DISP_ENERGY_EN, cfg->energy_ctrl ? 1u : 0u);
    dgus_write_u16(DISP_MULTI_EN,  cfg->multi_ctrl  ? 1u : 0u);

    if (page == LCD_RUN_STD) {
        app_lcd_run_std_refresh();
    } else if (page == LCD_SETUP_HAND || page == LCD_SETUP_MULTI || page == LCD_SETUP_STD1) {
        render_setup_main(cfg, state);
    } else if (page == LCD_SETUP_STD2D) {
        dgus_write_u16(LV_DM_DELAY, cfg->limit_delay_time1);
        dgus_write_u16(LV_DM_WELD,  cfg->limit_delay_time2);
        dgus_write_u16(LV_DM_HOLD,  cfg->limit_delay_time3);
        state->temp_comm_mode = 0xff;
    } else if (page == LCD_SETUP_STD2T) {
        dgus_write_u16(LV_TM_WELD, cfg->limit_trigger_time2);
        dgus_write_u16(LV_TM_HOLD, cfg->limit_trigger_time3);
        state->temp_comm_mode = 0xff;
    } else if (page == LCD_SETUP_STD3 || page == LCD_SETUP_MH2) {
        dgus_write_u16(DISP_MULTI_EN, cfg->multi_ctrl ? 1u : 0u);
        dgus_write_u16(LV_MO_OUT1,  cfg->limit_mo_out1);
        dgus_write_u16(LV_MO_OUT2,  cfg->limit_mo_out2);
        dgus_write_u16(LV_MO_TIME1, cfg->limit_mo_time1);
        dgus_write_u16(LV_MO_TIME2, cfg->limit_mo_time2);
        state->temp_comm_mode = 0xff;
    } else if (page == LCD_SETUP_STDC || page == LCD_SETUP_MHC) {
        render_comm_page(cfg, state, addr_str, ipbuf);
        if (state->temp_comm_mode > 0)
            dgus_write_u16(DISP_COMM_MODE, 1);
        else
            dgus_write_u16(DISP_COMM_MODE, 0);
    } else if (page == LCD_SETUP_STDE || page == LCD_SETUP_MHE) {
        render_comm_page(cfg, state, addr_str, ipbuf);
        if (state->temp_comm_mode == 0) {
            dgus_write_u16(DISP_COMM_MODE, 0);
            dgus_write_u16(DISP_EN_DHCP, 0);   /* fix D: clear stale DHCP check on serial */
        } else {
            dgus_write_u16(DISP_COMM_MODE, 1);
            dgus_write_u16(DISP_EN_DHCP, (uint16_t)(state->temp_comm_mode - 1));
        }
    }

    dgus_set_page(page);
    state->last_set_page_ms = sys_tick_get_ms();   /* SYS_PIC_NOW loop guard (spec §10) */

    /* Comm-mode icon re-assert AFTER set_page (panel page 23/27 quirk, verified
     * 2026-05-31). The STD comm pages STDC(23)/STDE(27) do NOT auto-load
     * DISP_COMM_MODE on page-show — only a live write while the page is active
     * updates the serial/ethernet/DHCP icon (the same path the touch handler
     * uses). The MULTI pages MHC(21)/MHE(25) auto-load, so the in-branch write
     * before set_page suffices there; re-asserting is redundant-but-harmless.
     * Proven by repoint cross-test: identical firmware rendered on page 25 shows
     * ethernet correctly, on page 27 shows serial. temp_comm_mode is already
     * seeded (0/1/2) by the branch above on every comm page.
     * See analysis/2026-05-31-std-comm-page27-display-port-faithful.md. */
    if (page == LCD_SETUP_MHC || page == LCD_SETUP_STDC ||
        page == LCD_SETUP_MHE || page == LCD_SETUP_STDE) {
        render_comm_tail(page, state);
    }
#ifdef LCD_TRACE_RX
    /* comm-page display diagnosis: page id + seeded shadow + persisted cfg.
     * 21=MHC 23=STDC 25=MHE 27=STDE. From page+tcm the DISP_COMM_MODE/EN_DHCP
     * writes are fully determined by the render logic above. */
    mon_printf("[lcd] page=%u tcm=%u cm=%u\r\n",
               (unsigned)page, (unsigned)state->temp_comm_mode,
               (unsigned)cfg->comm_mode);
#endif
}

/* SENSE_DN 상태 텍스트 */
void app_lcd_weld_sensor_text(bool on)
{
    /* TRIGGER 모드 SENSE_DN 상태 텍스트 — weld 글루가 레벨 변화 엣지에 호출.
     * Verbatim port of samd20 check_remote_input LCD side-effect (main.c:1230-1265);
     * 페이지 진입 초기값("SENSOR OFF")은 위 app_lcd_change_page가 담당. 바이트 수도
     * legacy와 동일(ON=10, OFF=11, NUL 포함). */
    uint8_t buf[11];

    buf[0] = 'S'; buf[1] = 'E'; buf[2] = 'N'; buf[3] = 'S';
    buf[4] = 'O'; buf[5] = 'R'; buf[6] = ' '; buf[7] = 'O';
    if (on) {
        buf[8] = 'N'; buf[9] = '\0';
        dgus_write_bytes(DISP_STD_DATA1, buf, 10);
    } else {
        buf[8] = 'F'; buf[9] = 'F'; buf[10] = '\0';
        dgus_write_bytes(DISP_STD_DATA1, buf, 11);
    }
}

/* 패널 변수 시드 */
void app_lcd_var_init(void)
{
    /* Panel-var seed (samd20 lcd_var_init, main.c:2592-2603): initial key/model
     * widget state. Called at boot and on SYS_PIC_NOW==0 re-init. */
    uint16_t seed[2];

    seed[0] = 0x0003;
    seed[1] = 0x0004;
    dgus_write_u16_array(KEY_MULTI + 1, seed, 2);

    seed[0] = 0x0000;
    seed[1] = 0x0002;
    dgus_write_u16_array(SETUP_MODEL + 1, seed, 2);
}
