shuug2/gds_us_ctrl/fw/drivers/dgus_lcd.c

/* fw/drivers/dgus_lcd.c
 *
 * DGUS LCD 프로토콜 레이어 — samd20 ref 9 함수 풀 패리티.
 * USART1 raw I/O (fw/drivers/usart1.c) 위에 빌드.
 *
 * samd20 결함 회피 (spec §3.7):
 *   #1 LEN 무경계: LEN ∈ [4, 26] 검증 + drop 카운터
 *   #2 byte-counted timeout: 벽시계 ms (sys_tick) 사용
 *   #3 init 무한 retry: HAL_UART_Init 실패 시 Error_Handler (usart1.c 책임)
 *   #4 shared TX race: 폴링 TX → caller block, 자연 직렬화
 *   #5 RX ring wrap-overwrite: drop + 카운터 (usart1.c 책임)
 */
#include "dgus_lcd.h"
#include "usart1.h"
#include "sys_tick.h"
#include <string.h>

/*--------------------------------------------------------------
 * 정적 상태
 *--------------------------------------------------------------*/

/* TX — 단일 정적 버퍼. 폴링 TX 이므로 caller 가 send_frame 동안 block,
 * 다른 호출과 자연 직렬화 (samd20 결함 #4 회피).
 */
static uint8_t s_tx_buf[32];                            /* 헤더(6) + payload max(23) + α */

/* TX 카운터 (SWD 정적 read 진단용) */
static uint16_t s_dgus_tx_timeout_count;

/* RX 파서 상태머신 */
typedef enum {
    PS_IDLE,
    PS_GOT_5A,
    PS_GOT_HEADER,
    PS_COLLECTING
} parse_state_t;

static parse_state_t s_parse_state;
static uint8_t       s_frame_buf[32];                   /* LEN_max + 약간 여유 */
static uint8_t       s_frame_idx;
static uint8_t       s_bytes_remaining;
static uint32_t      s_frame_start_ms;                  /* 벽시계 timeout (samd20 결함 #2 회피) */
static uint16_t      s_dgus_rx_drop_count;             /* SWD 정적 read 진단용 */

/*--------------------------------------------------------------
 * 공개 — init / accessor
 *--------------------------------------------------------------*/

/* DGUS 상태 초기화 */
void dgus_init(void)
{
    s_parse_state           = PS_IDLE;
    s_frame_idx             = 0;
    s_bytes_remaining       = 0;
    s_frame_start_ms        = 0;
    s_dgus_rx_drop_count    = 0;
    s_dgus_tx_timeout_count = 0;
    /* USART1 / RX ring 책임은 usart1_init. 여기선 dgus 레이어 상태만 */
}

/* WR 에코 판별 */
bool dgus_is_echo(const dgus_frame_t *f)
{
    return f->cmd == DGUS_CMD_WR;
}

/*--------------------------------------------------------------
 * TX 빌더 — samd20 9 함수 풀 패리티
 *--------------------------------------------------------------*/

/* DGUS 프레임 송신 */
static void send_frame(uint8_t cmd, uint16_t vp, const uint8_t *payload, uint8_t plen)
{
    /* 단일 프레임 전송 helper. plen = payload byte 수.
     * 프레임: 5A A5 LEN(=3+plen) cmd AH AL [payload].
     */
    s_tx_buf[0] = DGUS_SYNC1;
    s_tx_buf[1] = DGUS_SYNC2;
    s_tx_buf[2] = (uint8_t)(3 + plen);                  /* LEN = cmd+addr(3) + payload */
    s_tx_buf[3] = cmd;
    s_tx_buf[4] = (uint8_t)(vp >> 8);
    s_tx_buf[5] = (uint8_t)(vp & 0xFF);
    for (uint8_t i = 0; i < plen; i++) {
        s_tx_buf[6 + i] = payload[i];
    }
    if (usart1_send_blocking(s_tx_buf, (uint16_t)(6 + plen)) == HAL_TIMEOUT) {
        s_dgus_tx_timeout_count++;
    }
}

/* LCD 리셋 명령 */
void dgus_reset_lcd(void)
{
    /* samd20 reset_dgus_lcd: VP_LCD_RESET 0x04, payload = 55 AA 5A A5 (DWIN reset magic) */
    static const uint8_t magic[4] = { 0x55, 0xAA, 0x5A, 0xA5 };
    send_frame(DGUS_CMD_WR, VP_LCD_RESET, magic, 4);
}

/* LCD 페이지 전환 */
void dgus_set_page(uint8_t page)
{
    /* samd20 set_lcd_page: VP_LCD_SETPAGE 0x84, payload = 5A 01 00 page */
    uint8_t pl[4] = { 0x5A, 0x01, 0x00, page };
    send_frame(DGUS_CMD_WR, VP_LCD_SETPAGE, pl, 4);
}

/* u16 VP 쓰기 */
void dgus_write_u16(uint16_t vp, uint16_t value)
{
    /* samd20 send_lcd_data_var */
    uint8_t pl[2] = {
        (uint8_t)(value >> 8),
        (uint8_t)(value & 0xFF),
    };
    send_frame(DGUS_CMD_WR, vp, pl, 2);
}

/* u32 VP 쓰기 */
void dgus_write_u32(uint16_t vp, uint32_t value)
{
    /* samd20 send_lcd_data_word — big-endian 4 byte */
    uint8_t pl[4] = {
        (uint8_t)(value >> 24),
        (uint8_t)(value >> 16),
        (uint8_t)(value >> 8),
        (uint8_t)(value & 0xFF),
    };
    send_frame(DGUS_CMD_WR, vp, pl, 4);
}

/* 바이트 배열 쓰기 */
void dgus_write_bytes(uint16_t vp, const uint8_t *buf, uint8_t n)
{
    /* samd20 send_lcd_byte_array */
    if (n > DGUS_MAX_DATA) {
        n = DGUS_MAX_DATA;                              /* 무경계 입력 안전 */
    }
    send_frame(DGUS_CMD_WR, vp, buf, n);
}

/* u16 배열 쓰기 */
void dgus_write_u16_array(uint16_t vp, const uint16_t *buf, uint8_t n)
{
    /* samd20 send_lcd_int_array — u16 array, big-endian */
    if (n > (DGUS_MAX_DATA / 2)) {
        n = (uint8_t)(DGUS_MAX_DATA / 2);
    }
    uint8_t pl[DGUS_MAX_DATA];
    for (uint8_t i = 0; i < n; i++) {
        pl[(i * 2) + 0] = (uint8_t)(buf[i] >> 8);
        pl[(i * 2) + 1] = (uint8_t)(buf[i] & 0xFF);
    }
    send_frame(DGUS_CMD_WR, vp, pl, (uint8_t)(n * 2));
}

/* 텍스트 10B 쓰기 */
void dgus_write_text(uint16_t vp, const char *txt)
{
    /* samd20 send_lcd_txt — 10 byte zero-pad. txt 가 NULL 또는 빈 문자열이면 nothing 송신.
     * samd20 라인 257-283 의 행동을 그대로 보존.
     */
    if (txt == 0 || txt[0] == '\0') {
        return;
    }
    uint8_t pl[10];
    for (uint8_t i = 0; i < 10; i++) {
        pl[i] = 0;
    }
    for (uint8_t i = 0; i < 10; i++) {
        if (txt[i] == '\0') {
            break;
        }
        pl[i] = (uint8_t)txt[i];
    }
    send_frame(DGUS_CMD_WR, vp, pl, 10);
}

/* 시스템 변수 RD 요청 */
void dgus_read_var(uint8_t var)
{
    /* samd20 read_system_var — RD 0x83, payload = 1 (1 word read) */
    uint8_t pl[1] = { 1 };
    send_frame(DGUS_CMD_RD, (uint16_t)var, pl, 1);
}

/*--------------------------------------------------------------
 * RX 파서 상태머신
 *
 * 프레임: 5A A5 LEN [LEN bytes = cmd + addr_h + addr_l + payload]
 * LEN ∈ [4, 26]. 그 외 → 폐기 + drop 카운터.
 * 프레임 mid-stream 50 ms timeout (벽시계 sys_tick_get_ms).
 *--------------------------------------------------------------*/

#define DGUS_LEN_MIN          4
#define DGUS_LEN_MAX          26
#define DGUS_FRAME_TIMEOUT_MS 50

/* RX 1바이트 파싱.
 * [개요] 1바이트 처리. true 리턴 시 out 에 완성 프레임 적재.
 * [PS_GOT_5A] 연속 0x5A: PS_GOT_5A 유지
 * [PS_GOT_HEADER] 이 byte 가 LEN
 * [PS_COLLECTING] 벽시계 timeout — samd20 결함 #2 회피
 * [프레임 완성] frame_buf 매핑:
 *   [0] = cmd, [1] = addr_h, [2] = addr_l, [3..] = payload
 *   payload 길이 = LEN - 3 = s_frame_idx - 3
 * [unreachable] unreachable
 */
static bool parser_step(uint8_t b, dgus_frame_t *out)
{
    switch (s_parse_state) {
    case PS_IDLE:
        if (b == DGUS_SYNC1) {
            s_parse_state = PS_GOT_5A;
        }
        return false;
    case PS_GOT_5A:
        if (b == DGUS_SYNC2) {
            s_parse_state    = PS_GOT_HEADER;
            s_frame_start_ms = sys_tick_get_ms();
        } else if (b == DGUS_SYNC1) {   /* 연속 0x5A: PS_GOT_5A 유지 — 헤더 [PS_GOT_5A] */
        } else {
            s_parse_state = PS_IDLE;
        }
        return false;
    case PS_GOT_HEADER:
        if (b < DGUS_LEN_MIN || b > DGUS_LEN_MAX) {
            s_dgus_rx_drop_count++;                     /* samd20 결함 #1 회피 */
            s_parse_state = PS_IDLE;
            return false;
        }
        s_bytes_remaining = b;
        s_frame_idx       = 0;
        s_parse_state     = PS_COLLECTING;
        return false;
    case PS_COLLECTING:
        if ((uint32_t)(sys_tick_get_ms() - s_frame_start_ms) > DGUS_FRAME_TIMEOUT_MS) {
            s_dgus_rx_drop_count++;
            s_parse_state = PS_IDLE;
            return false;
        }
        s_frame_buf[s_frame_idx++] = b;
        s_bytes_remaining--;
        if (s_bytes_remaining == 0) {
            out->cmd      = s_frame_buf[0];
            out->vp_addr  = (uint16_t)((s_frame_buf[1] << 8) | s_frame_buf[2]);
            out->data_len = (uint8_t)(s_frame_idx - 3);
            for (uint8_t i = 0; i < out->data_len && i < DGUS_MAX_DATA; i++) {
                out->data[i] = s_frame_buf[3 + i];
            }
            s_parse_state = PS_IDLE;
            return true;
        }
        return false;
    }
    s_parse_state = PS_IDLE;
    return false;
}

/* RX 링 폴링 파싱 */
bool dgus_rx_poll(dgus_frame_t *out)
{
    uint8_t b;
    /* ring 을 한 프레임 완성될 때까지, 또는 비울 때까지 소비 */
    while (usart1_rx_pop(&b)) {
        if (parser_step(b, out)) {
            return true;
        }
    }
    return false;
}

/*--------------------------------------------------------------
 * 부트타임 RD 헬퍼 — DGUS 콜드부팅 핸드셰이크 (set_page 레이스 픽스)
 *
 * 패널이 MCU보다 늦게 부팅 → 단발 set_page 유실 → 로고 잔류 문제.
 * blind delay 대신 패널 UART 응답을 게이트로 사용
 * (samd20 의 주석처리된 check_lcd_comm 핸드셰이크 복원,
 *  ref/samd20/main.c:4933-5022). 부트 전용 blocking — 메인 루프용 아님.
 *--------------------------------------------------------------*/

/* VP 워드 블로킹 읽기 */
bool dgus_read_word(uint16_t addr, uint16_t *out_val, uint32_t timeout_ms)
{
    /* addr 한 워드를 RD 요청하고 timeout_ms 안에 0x83 응답을 기다림.
     * 대기 동안 RX ring 을 계속 drain. 응답 수신 시 *out_val 적재 후 true.
     * RD 응답 payload 레이아웃(samd20): data[0]=word count, data[1]=hi, data[2]=lo.
     */
    dgus_frame_t f;
    while (dgus_rx_poll(&f)) {
        /* 이전 요청 잔여 / 터치 프레임 비움 */
    }

    dgus_read_var((uint8_t)addr);                       /* 0x83 RD, 1 word */

    uint32_t t0 = sys_tick_get_ms();
    while ((uint32_t)(sys_tick_get_ms() - t0) < timeout_ms) {
        while (dgus_rx_poll(&f)) {
            if (f.cmd == DGUS_CMD_RD && f.vp_addr == addr && f.data_len >= 3) {
                *out_val = (uint16_t)(((uint16_t)f.data[1] << 8) | f.data[2]);
                return true;
            }
        }
    }
    return false;
}

/* 패널 부팅 대기 */
bool dgus_wait_ready(uint32_t timeout_ms)
{
    /* 패널이 SYS_PIC_NOW read 에 응답할 때까지(UART 기동) 또는 timeout 까지 폴링. */
    uint16_t pg;
    uint32_t t0 = sys_tick_get_ms();
    do {
        if (dgus_read_word(SYS_PIC_NOW, &pg, DGUS_READ_REPLY_TIMEOUT_MS)) {
            return true;
        }
    } while ((uint32_t)(sys_tick_get_ms() - t0) < timeout_ms);
    return false;
}
