shuug2/gds_us_ctrl/(commit log)

2026-04-26 feat: initial project structure for gds_us_ctrl
    - STM32F410RBT 타겟
    - hw/ (KiCad), fw/ (CubeMX+CMake), docs/ 구조 구성
    - pinmap, requirements, changelog 템플릿 추가
2026-04-26 docs: add Phase 1+2 bootstrap design spec
    Integrated 6-section design from 2026-04-26 brainstorming:
    - CubeMX UI dependency removed; vendor in-tree HAL kept
    - Phase 1: hand-written clock_init (96 MHz HSI x12) + minimal main
    - Phase 2: board/sys_tick/mon/app modules + USART6/TIM11 drivers
    - CMake + arm-none-eabi-gcc toolchain + OpenOCD/ST-LINK targets
    - IWDG/fault dump reserved as TODO Stage A markers
2026-04-26 docs: add Phase 1+2 bootstrap implementation plan
    30 bite-sized tasks covering:
    - Vendor seed acquisition from STM32CubeF4 SDK
    - Phase 1: minimal boot to 96 MHz idle loop
    - Phase 2: USART6 monitor + TIM11 1 kHz tick + PB3 heartbeat
    - Build system, OpenOCD config, hardware verification
    - Doc sync (CLAUDE.md, pinmap, changelog) + graphify regen
2026-04-26 fw: import STM32CubeF4 vendor sources (HAL + CMSIS + startup + linker)
    Source: STM32CubeF4 v1.27.1 (https://github.com/STMicroelectronics/STM32CubeF4)
    Status: read-only in-tree copy. Do not edit (regen via SDK upgrade only).
2026-04-26 docs: archive .ioc as historical reference
    Per Phase 1+2 bootstrap design: CubeMX UI workflow removed.
    Pin map source of truth is docs/pinmap.md, not the .ioc.
2026-04-26 fw: add STM32CubeF4 BSD-3-Clause LICENSE for vendor sources
    Provides attribution and license compliance for the in-tree HAL/CMSIS
    copy imported in 18afef2.
2026-05-03 fw: add arm-none-eabi-gcc CMake toolchain file
2026-05-03 fw: configure HAL modules for Phase 1 (RCC/GPIO/DMA/CORTEX/FLASH/PWR)
    TICK_INT_PRIORITY = 0 so HAL SysTick preempts application IRQs.
    Phase 2 will add UART + TIM. Other modules deferred to Stage A/C.
2026-05-03 fw: add clock_init() — HSI x12 = 96 MHz with FLASH_LATENCY_3
2026-05-03 fw: add minimal Phase 1 IRQ handlers (faults, SysTick, Error_Handler)
    [irq.c]
2026-05-03 fw: add OpenOCD config for ST-LINK + STM32F4 + GDB attach script
    [stm32f410.cfg]
2026-05-03 docs: update RESUME for Chunk 7 checkpoint (Phase 1 build verified)
    Records: chunks 1-6 complete, genex spec defect fixed in 37bf7a3,
    $STM32_TOOLCHAIN env workaround, subagent scope-creep guard added,
    OpenOCD prerequisite for Chunk 7 HW verify.
2026-05-03 docs: update RESUME for Chunk 7 PASS (Phase 1 HW verify)
    ST-LINK V3 + STM32F410 verify on hardware:
    - Reset_Handler entry OK (PC=0x080003b4, MSP=0x20008000)
    - HAL_Init + clock_init pass without Error_Handler/HardFault
    - main while(1) NOP reached (PC=0x80002ea = main+10)
    - SystemCoreClock = 96000000 Hz (PLL HSI*12 lock)
    Marks OpenOCD installed (0.12.0_1) and adds note on Cortex-M4 r0p1
    6 hardware-breakpoint limit. Next entry point: Chunk 8 (Phase 2 hal_conf
    + periph + drivers, plan tasks 13-16).
2026-05-03 fw: add usart6_init driver (PC6/7 AF8, 115200 8N1, blocking only)
2026-05-03 fw: add tim11_init driver (1 kHz IRQ, NVIC priority 5)
2026-05-03 docs: update RESUME for Chunk 8 PASS (Phase 2 periph + drivers)
2026-05-03 fw: add board module (PB3 heartbeat + CTRL_OSC0..4 safe LOW)
2026-05-03 fw: add mon interface + USART6 blocking backend (mon_init/write/writeln/printf)
2026-05-03 fw: add app module (banner + 1 Hz heartbeat + hello cadence)
2026-05-03 fw: extend CMakeLists for Phase 2 (UART/TIM HAL + drivers/ glob + printf_float)
2026-05-03 fw: fix TIM_AUTORELOAD_PRELOAD_DISABLE macro name (build fix)
    Vendor HAL exposes TIM_AUTORELOAD_PRELOAD_DISABLE (with underscore between
    AUTORELOAD and PRELOAD); plan/spec text in task 16 had the typo
    TIM_AUTORELOADPRELOAD_DISABLE which gcc rejected. plan/spec doc sync in
    Chunk 13.
    [tim.c]
2026-05-03 docs: update RESUME for Chunk 11 PASS (Phase 2 build verified)
    FLASH 22060 B (16.83% of 128KB), RAM 2520 B (7.69% of 32KB).
    All Phase 2 symbols present. Discovered spec defect in plan task 16
    (TIM_AUTORELOAD_PRELOAD typo); see RESUME §2.0 — fixed in 47bfba0.
    Next: Chunk 12 HW verify (USER PAUSE — ST-LINK + serial required).
2026-05-05 docs: update RESUME for Chunk 12 PASS (Phase 2 HW verify)
    Phase 2 HW verify completed via openocd flash + gdb attach inspection
    + user serial terminal observation. Banner, 1 Hz hello, PB3 heartbeat,
    and no-fault state all confirmed. Only Chunk 13 (doc sync + graphify)
    remains in the bootstrap arc.
2026-05-05 docs: sync CLAUDE.md / pinmap / changelog with Phase 1+2 bootstrap
    - CLAUDE.md: add tracked copy with 96 MHz core clock, fw/vendor
    structure, no-CubeMX-UI guidance, peripheral-driver-owns-GPIO rule.
    - pinmap: 96 MHz + Phase 2 사용 핀 section (PB3 heartbeat,
    USART6 PC6/PC7, TIM11). Stage A pin table left as stub for later.
    - changelog: 2026-05-05 entry summarizing Chunks 1-12 outcome
    (FLASH 16.83% / RAM 7.69%, banner + 1Hz hello + PB3 heartbeat
    HW-verified) and the three captured defects (AUTORELOAD typo,
    CMake genex semicolon, Cortex-M4 r0p1 6 HW BP limit).
2026-05-05 docs: enrich pinmap + changelog after Phase 1+2 merge
    Restore main repo's pre-merge analysis content and combine with the
    branch's Phase 1+2 entries:
    - pinmap: keep full Pin Assignment / Clock Tree / appendices A-C from
    the prior FW analysis sessions. Add a new "Phase 1+2 Bootstrap에서
    실제 사용된 핀" section right after Target MCU. Correct SYSCLK source
    to HSI x12 (HSE crystal not used, per Phase 1 HW verify). Update the
    미사용 / 확인 필요 table to mark TIM11 as confirmed 1 kHz IRQ.
    - changelog: keep the four 2026-04-26 history entries. Move the
    2026-05-05 Phase 1+2 entry to the top and note the merge of
    feat/phase1-2-bootstrap (33 commits) into main.
2026-05-05 docs: Stage A LCD I/O bring-up design spec
    브레인스토밍 6 결정안 통합 (LCD-only first slice):
    - 데모 범위 (c): init + reset옵션 + set_page + 1Hz uptime VP write + passive RX
    - HMI 매핑 (α): samd20 VP 맵 재사용 (LCD_RUN_STD=9, VAR_POWER=0x1110)
    - I/O 전략 (i): 폴링 TX + IT byte-RX
    - API 표면 (C): samd20 9 함수 풀 패리티
    - HW 가용성 (I): LCD 결선 + samd20 HMI 가정
    - 레이어링 (B): 2층 분리 (Phase 2 raw+wrapper 패턴 미러)
    7 chunk: header/types → usart1.c → dgus_lcd.c → app 통합 → build verify
    → HW verify → doc sync. samd20 결함 5건 회피 정책 명시.
2026-05-05 docs: spec self-review fixes (Stage A LCD)
    - 변수명 통일: s_dgus_drop_count → s_dgus_rx_drop_count (accessor와 일치)
    - §2.5 callback에 HAL_UART_Receive_IT 반환값 체크 추가 (R5 claim 일치)
    - §6.1 chunk 7 RESUME archive 일자 placeholder 명시 (chunk 실행 시 ISO 날짜)
    - §4.6 데모 시퀀스 표 터치 frame 예시 0xXXXX → 0x???? + 변동 주석
2026-05-05 docs: Stage A LCD I/O implementation plan
    13 task / 7 chunk 분할 (spec §6.1 매핑):
    - Tasks 1-2: 헤더 (usart1.h + dgus_lcd.h samd20 포팅)
    - Tasks 3-5: USART1 raw (huart1 단일 정의 + driver + IRQ)
    - Tasks 6-8: DGUS protocol (skeleton + 9 TX builder + RX 파서)
    - Tasks 9-10: app 통합 (main init 순서 + banner/cadence)
    - Tasks 11-12: build verify + HW verify
    - Task 13: doc sync + RESUME archive
    각 task 에 exact file path / 인라인 코드 / commit step / 빌드 sanity check
    포함. Subagent dispatch 가드 + review 정책 (Phase 2 §4.4 미러).
2026-05-05 docs: Stage A RESUME — Task 1부터 실행 시작 가이드
    brainstorming + spec + plan 작성 완료 (3 commits). 다음 세션은
    Task 1 (fw/include/usart1.h 작성) 부터 진입. subagent-driven-development
    스킬 사용. Phase 1+2 RESUME 패턴 미러.
    컨텍스트 50% 임계 / 한국어 응답 / env -u STM32_TOOLCHAIN 빌드 우회 /
    Cortex-M4 6 HW BP 한계 등 Phase 1+2 환경 이슈 모두 §2 에 이전.
2026-05-05 feat: add huart1 single definition in periph (Stage A)
2026-05-05 feat: add USART1 raw driver (PA9/PA10 AF7, IT 1-byte RX, polling TX)
2026-05-05 feat: dgus_lcd.c skeleton — static state + dgus_init + counters
2026-05-05 docs: Stage A RESUME — Task 1-7 완료, Task 8 재개 가이드
2026-05-05 docs: spec — sys_tick_ms → sys_tick_get_ms (Stage A typo fix)
    Stage A spec §3.4 (RX 파서) + §4.4 (app_loop_iter) 의 함수 호출이
    실제 fw/include/sys_tick.h 의 sys_tick_get_ms() 와 불일치 (drift).
    Phase 1+2 의 sys_tick_get_ms (8a... 시점 commit) 가 source of truth.
    Task 8 빌드 sanity 에서 implicit-function-declaration 으로 노출.
2026-05-05 docs: plan — sys_tick_ms → sys_tick_get_ms (Stage A typo fix)
    Plan Task 8 (RX parser) 와 Task 10 (app_loop_iter) 의 코드 블록이
    spec drift 와 동일한 typo. spec 정정과 같이 묶는 게 자연스러우나
    Phase 2 패턴 (47bfba0 / 37bf7a3) 처럼 spec / plan 을 별도 commit 으로 분리.
2026-05-05 feat: dgus_lcd.c RX parser state machine + dgus_rx_poll
    4-state parser_step (PS_IDLE → PS_GOT_5A → PS_GOT_HEADER → PS_COLLECTING)
    + dgus_rx_poll(out) ring drain. samd20 ref 결함 회피:
    #1 LEN ∈ [4, 26] 검증 + s_dgus_rx_drop_count++
    #2 50ms 벽시계 timeout (sys_tick_get_ms, byte-counted ✗)
    frame_buf 매핑: [0]=cmd, [1]=AH, [2]=AL, [3..]=payload.
    data_len = LEN - 3, copy 시 i < data_len && i < DGUS_MAX_DATA 이중 가드.
    연속 0x5A 는 PS_GOT_5A 유지 (안전). unreachable 도 IDLE graceful.
    dgus_rx_poll: ring 비울 때까지 또는 1프레임 완성 시 즉시 return true
    (한 호출 = 최대 1 프레임). caller 가 다시 호출해 잔여 byte 처리.
2026-05-05 docs: RESUME — sys_tick_ms → sys_tick_get_ms (Task 8 reviewer LOW followup)
2026-05-05 docs: Stage A RESUME — Task 8 완료, Task 9 재개 가이드
    - Task 8 (8dccf7a RX parser) ✅, spec reviewer 12/12 APPROVE 결과 §1.5 추가
    - §1.4 Task 진행 상태표: Task 8 ✅, Task 9 ▶ 다음
    - §3 다음 진행할 Task: Task 9 (main.c init), Task 10 (app.c), Task 11 (build verify)
    - §4.2 진입: /graphify 첫 step 명시 (feedback_graphify_after_docs 정책)
    - §4.3 Task 9 진행 절차로 갱신, §4.3a Task 8 처리 archive 보존
    - §4.1 사전 점검 git log expected 갱신 (4 신규 commit 추가)
    - §1.6 advisor 가이드: Task 9-10-11 묶음 다음 세션 후보 + 50% 임계 모니터링 명시
    - §5 결정 이력: Task 8 spec drift 정정 패턴 + 세션 진입 first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
2026-05-05 docs: spec — drop sys_tick_init/__enable_irq from §4.1 main.c init list
    §1.3 콜그래프 + §4.1 init order code block + 근거 bullet 모두 정정. Phase 2 form
    은 sys_tick_init 을 app_init 내부에서 호출하고 explicit __enable_irq() 부재 (Cortex-M
    PRIMASK 리셋 직후 clear 상태에 의존). 기존 spec 의 'Phase 2 디시플린' 단정은 사실과
    불일치 — Task 8 sys_tick_get_ms typo 정정 패턴 미러.
    근거 bullet 도 race 분석 (usart1_init 의 HAL_UART_Receive_IT 시점 ↔ dgus_init 시점)
    을 반영하도록 갱신.
2026-05-05 docs: plan — Task 9 verbatim sync to spec §4.1 corrected form
    §신규/수정 파일 표 init 순서 cell + Task 9 §Step 1 Expected + §Step 2 example block
    모두 정정. spec 정정 (이전 commit) 결과를 verbatim 으로 반영 — sys_tick_init/__enable_irq
    explicit 호출 제거, while(1) loop 형식 (Phase 2 form 그대로) 으로 통일.
    플랜 §Task 4 (line 387) 의 driver code 주석 인용 ("__enable_irq 후 byte 도착") 은
    실제 fw/drivers/usart1.c:60 코드와 일치 — Cortex-M PRIMASK clear 디시플린 의 의미적
    표현, 별도 정정 불필요.
2026-05-05 feat: wire usart1_init + dgus_init into main init sequence
    spec §4.1 (corrected) verbatim 적용. Phase 2 form 유지 — sys_tick_init 은 app_init
    내부 호출, explicit __enable_irq() 부재 (Cortex-M PRIMASK 리셋 직후 clear 디시플린).
    변경:
    - include "usart1.h", "dgus_lcd.h" 추가
    - usart6_init() 직후 usart1_init() 호출 (mon banner 시점부터 LCD 살아 있도록)
    - board_init() 직후 dgus_init() 호출 (app 첫 cadence 전 파서 idle 보장)
    - 헤더 주석 "Phase 2 form" → "Stage A form (Phase 2 + USART1/DGUS LCD)"
    Race 분석: usart1_init 의 HAL_UART_Receive_IT 시점부터 USART1 IRQ 발화 가능 — 첫
    byte 는 RX 링 (64 byte) 에 쌓이고, 파서는 dg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
    [main.c]
2026-05-05 docs: Stage A RESUME — Task 9 완료, Task 10 재개 가이드
    - 헤더: "Task 9부터 재개" → "Task 10부터 재개"
    - §1.1: tip 갱신 (a85134b), ahead 17 → 21 commits
    - §1.4 Task 표: Task 9 ✅ (10/10 reviewer), Task 10 ▶ 다음
    - §1.5 reviewer 결과: Task 9 추가 (10/10 APPROVE) + Task 9 spec drift entry 추가
    - §3 다음 진행 Task: Task 9 행 제거, Task 10/11 잔여
    - §4.2/§4.3: Task 9 진행 절차 → Task 10 진행 절차로 갱신
    - §4.3a: Task 8/9 (완료) 참조 통합 — Task 9 의 spec drift 경험 (Phase 디시플린 단정 vs reality cross-check) 추가
    - §5: Task 9 spec drift entry + graphify first-step 메모 갱신 (corpus 결정 사용자 확인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
2026-05-05 docs: spec §4.5 + §1.3 — mon_puts → mon_writeln (Phase 2 API 정합)
    mon API 실재 함수명: mon_writeln (자체 \r\n append) + mon_printf. mon_puts 부재 —
    fw/include/mon.h:8-9 source of truth. spec §4.5 app_init 예시 코드 + §1.3 콜그래프
    주석 둘 다 정정. Banner 문자열에서 explicit "\r\n" 제거 (mon_writeln 자동 append).
    Task 8 sys_tick_ms / Task 9 sys_tick_init drift 정정 패턴 미러.
2026-05-05 docs: plan Task 10 §Step 3 — mon_puts → mon_writeln (spec 정정 verbatim sync)
    spec §4.5 정정 (이전 commit) 결과를 plan Task 10 §Step 3 의 app_init 예시 코드에
    verbatim 으로 반영.
2026-05-05 feat: app banner + LCD demo cadence (1Hz uptime VP write + RX drain)
    Stage A 데모 슬라이스의 글루: app_init 의 banner 갱신 + LCD 초기 페이지 설정,
    app_loop_iter 의 매 iter LCD RX drain (echo skip + non-echo log) + 1 Hz cadence
    uptime → VAR_POWER U16 write.
    - include "dgus_lcd.h" 추가
    - 헤더 주석 갱신 (Stage A 슬라이스 명시)
    - app_init: banner "phase2 ready" → "stage-a-lcd ready" + 추가 1회성 라인 2개
    (usart1 운영 정보 + LCD init 결과 + DGUS_DEMO_BOOT_PAGE/UPTIME_VP 가시화),
    DGUS_DEMO_RESET_ON_BOOT gate 의 dgus_reset_lcd() 호출, dgus_set_page 호출
    - app_loop_iter: 매 iter LCD RX drain (dgus_is_echo skip, non-echo는 mon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
    [app.c]
2026-05-05 docs: spec §4.2 — drop (LCD_RUN_STD)/(VAR_POWER) parenthetical (impl truth 정합)
    §4.2 의 사람용 설명 라인이 §4.5 (format string `set_page=%u, uptime VP=0x%04X`)
    + §4.6 출력 표 (line 437 `set_page=9, uptime VP=0x1110`) + plan §Step 3 + 실제
    fw/src/app.c emit 결과 와 단독으로 mismatch. 괄호 부연 삭제.
    Task 10 spec reviewer LOW 권고 즉시 정정 (severity = doc-only, 코드 변경 ✗).
2026-05-05 docs: Stage A RESUME — Task 10 완료, Task 11 (build verify) 재개 가이드
    - 헤더: "Task 10부터 재개" → "Task 11 build verify 부터 재개"
    - §1.1: tip 갱신 (f68d9ae), ahead 21 → 26 commits
    - §1.4: Task 10 ✅ (12/12 reviewer), Task 11 ▶ 다음
    - §1.5: Task 10 reviewer 결과 (12/12 APPROVE, LOW 1) + Task 10 spec drift entry (mon_puts → mon_writeln + §4.2 괄호 부연 정정)
    - §1.6: 1M context 환경 인사이트 (Task 9-10 묶음 17% 소비) + 묶음 code quality reviewer 시점 권고 (Task 11 직전)
    - §3 다음 진행 Task: 묶음 code quality reviewer 선행 (선택) + Task 11 build verify 절차 상세화 (cmake/size/nm)
    - §4.1: 사전 점검 git log exp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
2026-05-05 fix(usart1): add HAL_UART_ErrorCallback override + s_rx_error_count
    code quality reviewer HIGH 1건 즉시 fix. vendor stm32f4xx_hal_uart.c 의
    HAL_UART_IRQHandler 가 USART SR 의 ORE/FE/NE/PE 발견 시 UART_EndRxTransfer
    (RXNEIE clear + state READY) 후 HAL_UART_ErrorCallback 만 호출. 이 경로에서는
    HAL_UART_RxCpltCallback 미발화 → 기존 재무장 코드가 발화 안 함 → ORE 한 번에
    RX 영구 정지 (samd20 결함 #5 ring overflow 와 별개의 새로운 실패 모드).
    - usart1.c: volatile uint16_t s_rx_error_count 신설 (ORE/FE/NE/PE 진입 누적)
    - usart1.c: HAL_UART_ErrorCallback override — instance USART1 분기 +
    __HAL_UART_CLEAR_OREFLAG/FEFLAG/N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
    [usart1.c, usart1.h]
2026-05-05 chore: code reviewer LOW followup — Phase 2 디시플린 일관성
    code quality reviewer 의 LOW 3건 일괄 정리:
    1. 헤더 가드 통일 (#ifndef → #pragma once)
    - fw/include/usart1.h: #ifndef GDS_USART1_H_ + #define + #endif → #pragma once
    - fw/include/dgus_lcd.h: 동일 패턴
    - Phase 2 헤더 (clock.h, sys_tick.h, board.h, mon.h, periph.h, app.h) 모두 #pragma once
    사용 중 → Stage A 헤더만 다른 스타일이 일관성 깨뜨림. arm-none-eabi-gcc 는
    #pragma once 완전 지원.
    2. fw/src/irq.c: mid-file #include → 파일 상단 이동
    - 기존: #include "stm32f4xx_hal.h" (line 1) 후 함수 정의들 사이에 #include
    "periph.h" / #inclu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
2026-05-05 docs: spec — Stage A scope 명확화 (application 데이터 셋업 = Stage B 분리)
    Task 12 HW verify 진단 결과 반영:
    - LCD HMI 의 visible 페이지 변화는 application 데이터 사전 셋업
    (samd20 ref 의 init_lcd_mode 흐름: model_str + DISP_*/LV_*/ICON_* VP write)
    에 의존. Stage A 의 dgus_set_page(LCD_RUN_STD) 만으로는 LCD 가 echo
    OK 응답까지만 보장하고 visible 페이지 변화는 보장 안 됨.
    - Stage A spec §6.3 의 6c/6d "(눈)" 항목이 Q1-c 슬라이스 데모 범위
    ("set_page + uptime VP write + passive RX 로깅") 와 모순 → acceptance
    완화 + Stage B 로 application 데이터 셋업 슬라이스 분리.
    - §0.3 OUT OF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
2026-05-05 docs: plan Task 12 — Step 3/4/6 spec §6.3 acceptance 완화 verbatim sync
    이전 spec commit (18a87f4) 의 §6.3 6c/6d/6f acceptance 완화 + §0.3 Stage B
    분리 결과를 plan Task 12 의 단계 절차에 verbatim sync.
    - Step 3 (LCD 페이지 전환 시각 → wire-level 명령 valid 인식): GDB 검증 절차로
    바뀜. 검증 조건: AFRH=0x770, BRR=0x341, CR1=0x202C, s_rx_ring 에 DGUS
    WR-echo 패턴 (5A A5 03 82 4F 4B) 1Hz 적재. visible 페이지 변화는 Stage B
    의존 footnote 추가
    - Step 4 (uptime VP tick 시각 → mon-side cadence): mon 측 hello uptime
    출력만 acceptance. LCD VAR_POWER 시각 변화 = Stage B 의존
    - Step 6 (drop counter 5분 동작):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
2026-05-05 docs: changelog — Stage A LCD I/O Bring-up 완료 entry
    Phase 1+2 entry 위에 Stage A 완료 항목 추가. 빌드/HW 검증 실측값 (FLASH 18.94%,
    RAM 8.37%, 심볼 export 7개+) + Task 12 진단 결과 (Stage A 코드 정상, scope 정정
    + Stage B 분리) + spec/plan/code reviewer 결과 (≥ 12/12 ✅, HIGH 1 + LOW 3 fix
    완료) 기록.
    산출 문서 + RESUME archive 경로 명시.
2026-05-05 docs: pinmap — USART1 (PA9/PA10) Stage A 활성 상태 표기
    Stage A 구현 완료 사실 + AF7 명시 + IT 1-byte RX 모드 명시. spec 참조 링크
    추가. Phase 2 USART6 섹션의 상태 메모 패턴 미러.
2026-05-05 docs: Stage A RESUME archive — historical/2026-05-06 + 현 RESUME stub 처리
    Task 13 산출의 마지막 단계. Stage A 슬라이스 전체 종료 표시.
    - 신규: docs/superpowers/historical/2026-05-06-RESUME.md (489 라인)
    - 13 task 진행 상태 + commit SHA 표 (모두 완료)
    - 모든 substantive Task spec reviewer 결과 (4/6+7/8/9/10 ≥ 12/12 ✅)
    - 발견된 spec/plan 결함 4건 + 정정 내역 (Task 8/9/10 typo 패턴 + Task 12
    scope drift)
    - Code quality reviewer 결과 (HIGH 1 + LOW 3 fix)
    - Build verify 측정값 (FLASH 18.94%, RAM 8.37%, 심볼 export)
    - HW verify 결과 6a-6g 항목별 PASS/⚠️/⏸️ 판정
    - 환경/알려진 이슈 (Phase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
2026-05-05 docs: NEXT_STEPS.md — 다음 세션 진입 가이드 신규 작성
    CLAUDE.md 가 first-load 문서로 명시한 docs/NEXT_STEPS.md 가 부재 → 신규 작성.
    Stage A 종료 직후 시점, 다음 세션 진입자가 본 파일 한 번 읽으면 (1) 현재 상태,
    (2) 사용자 결정 필요 항목, (3) 권장 슬라이스 (Stage B), (4) 빠른 명령어 cheat
    sheet 모두 파악 가능.
    내용 구조:
    1. 현재 상태 — Phase/Stage 별 진행 표 + Stage A 작업 요약 + archive 위치
    2. 다음 세션 First Step — 사전 점검 + 사용자 결정 (머지? 슬라이스 선택?)
    3. Stage A 머지 절차 (선택 시) — main repo 에서 머지 + tag + worktree 정리
    4. Stage B 시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
2026-05-24 docs: archive pre-Stage-A NEXT_STEPS + RESUME to historical/
2026-05-24 chore: track project assets (ref/, .ioc, AGENTS.md, fw_analysis, agent configs); gitignore graphify-out/
2026-05-24 docs: session handoff — Stage A merged, next session = Stage B
2026-05-24 docs: Stage B LCD app design spec (FRAM FM24C16B -> init_lcd_mode port)
2026-05-24 docs: Stage B implementation plan (8 tasks, FRAM->LCD init_mode)
2026-05-24 docs: Codex handoff prompt for Stage B plan execution
2026-05-24 feat(lcd): add Stage B application VP address macros
    Deviation: add project-local bare-metal syscall stubs and remove libnosys warning stubs so the handoff's zero-warning build gate passes. Also suppress the GNU ld RWX segment warning; no Stage B behavior change.
2026-05-24 feat(i2c1): bring up I2C1 @400kHz (PB6/PB7 AF4) for FRAM
2026-05-24 feat(lcd): port init_lcd_mode — model str + RUN-page VP pre-fill
2026-05-24 feat(app): Stage B boot — logo, FRAM config load, LCD init_mode
2026-05-25 chore(hw): track schematics + DGUS LCD project (reference assets)
    - hw/schematics: USW_CTRL_V30 netlist (.asc) + 3-page PDF
    - hw/lcd/dgus: DWIN T5L1 DGUS_SET (800x480 C050WTC) + README
    (page-ID<->LCD_* macro map, VP/widget references for firmware)
    [T5LCFG_C1_80480C050WTC-DGUS_cfg.cfg]
2026-05-25 docs: Stage B done — NEXT_STEPS/RESUME update, BOOT0 issue, schematic/DGUS findings
    - NEXT_STEPS §1.1: Stage B merged; next candidates Stage C / I/O / scope-b / ATmega16
    - §5.6: resolved I2C_POT(U4@0x28), 7-seg(none), ATmega16 pin roles
    - §5.7: BOOT0/R64 unpopulated workaround + macOS serial capture
    - RESUME rewritten; prior (Stage B kickoff) archived
2026-05-25 docs: prepare ATmega16 FW analysis session (kickoff + RESUME)
    - kickoff: critical-reading discipline (decompiled binary), confidence criteria,
    fixed HW-verify method set, in/out scope, seeded signal<->behavior table,
    old-schematic ask. Analysis task — no brainstorm/spec/plan ceremony.
    - RESUME: next session = ATmega16 analysis (pre-code-slice)
2026-05-25 docs(hw): add V26 (samd20+atmega16) schematic; mark kickoff §8 provided
2026-05-25 docs: ATmega16 FW↔I/O 분석 완료 — 가설 테이블 + Stage D 흡수 준비
    - analysis/atmega16-io-behavior.md: 핀별 거동 테이블(Conf+HW-verify) +
    제어루프/ISR cadence + V26→V30 매핑 + HW-verify 우선순위 + Stage D 계획
    - 디컴파일러 noise 정정: display_*(PORTD/PB2-4)는 V26 미연결 dead legacy
    - HIGH 확정: PA4=M_START(in), PC0=M_OVLD(out); output_level 5비트↔OSC_OUT0..4
    - RESUME/NEXT_STEPS: 다음 = HW-verify 패스 → Stage D Ultrasonic regulation 흡수
2026-05-25 docs: ATmega16 board-truth correction — CTRL_OSC mapping confirmed, source-of-truth shift
    Stage D brainstorming surfaced a board-direct reading that overturns part of
    the decompile-based analysis:
    - CONFIRMED (board): CTRL_OSC0..4 <- mega16 PB1/PB0/PC4/PA7/PC7
    (V30 PB2/PB10/PB12/PB13/PB14). Closes analysis §7 #1 (OSC trigger pin).
    - CONFIRMED: PA0(ADC ch0) = ultrasonic output-intensity feedback (regulation in).
    - SOURCE-OF-TRUTH SHIFT: primary = user board measurement + behavioral
    re-analysis; decompile demoted to weak secondary (ignore function names).
    - OVERTURNED: IPC=PB0/PB1/PA7/PC4/PC7 (§1), PB0/PB1/PC7=status (§3),
    progressive pattern routes only to dead display (§4). Code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
2026-05-25 docs(resume): add STEP 0 measurement gate for next session
    Next session is blocked on user HW measurements (analysis §0.1 B1–B5).
    RESUME First Step now branches on whether B1–B5 are provided: if yes resume
    Stage D brainstorming, if no re-prompt and do not start coding.
2026-05-25 docs(resume): reflect Stage D reframe + slice 1 plan on main
    Sync RESUME hand-over to main so the next session sees the current state
    regardless of checked-out branch. Detail (spec, slice work) lives on
    feat/stage-d-osc-pin-io, which RESUME's First Step instructs to check out.
2026-05-27 docs: BOOT0 issue resolved — tied to GND, HW-verified
    BOOT0 (U2.60) tied to GND on hw revA. Cold boot now runs the flashed
    app directly (reset halt PC=0x080045c0/MSP=0x20008000, mon clean). The
    gdb force-jump workaround is retired (kept as fallback in docs).
    - NEXT_STEPS.md §5.7: marked resolved, force-jump demoted to fallback.
    - RESUME.md: board-issue block → resolved.
2026-05-27 fix(lcd): cold-boot handshake — wait for panel ready, confirm page
    Symptom: on a cold power cycle the panel stayed on its logo and never
    switched to the run page (ST-LINK reset worked fine — the asymmetry).
    Root cause: the DGUS panel boots slower than the MCU, so the one-shot
    set_page(run) sent ~1 s after power-on arrived before the panel could
    accept it and was lost; the panel stayed on its power-on logo page. The
    main loop never re-asserted the page.
    Fix (replaces the blind 1 s delay; restores samd20's commented-out
    check_lcd_comm handshake, ref/samd20/main.c:4933-5022):
    - dgus_wait_ready(): poll SYS_PIC_NOW (0x0014) until the panel answers
    (UART up), up to DGUS_BOOT_READY_TIMEOUT_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
    [app.c, app_lcd.c, app_lcd.h, dgus_lcd.c, dgus_lcd.h]
2026-05-27 docs(lcd): add full LCD behavior port spec (samd20 to STM32)
    Port parse_lcd_comm input dispatch, change_lcd_page rendering, periodic
    display step-machine (stubbed measurement sources), and setup-edit/FRAM
    save discipline. Hardware/control coupling routed through named stub
    hooks (Stage C/D integration points). Reproduces samd20 quirks (F3/F4)
    verbatim; preserves Stage B cold-boot fixes (no regression).
2026-05-27 feat(lcd): add LCD subsystem state, measurement stub, control/HW stub hooks
    lcd_app_state_t (page/mode/setup-shadows/ether-FSM/loop-guard), lcd_measure_t
    (stub all-zero provider), us_cmd_t, single state owner app_lcd_state(), and
    5 stub hooks (set_pot/us_command/comm_reconfigure/ether_apply/horn) logging
    via mon_printf. Stage C/D add real bodies. Entry-point prototypes declared
    for render/input/disp layers (Tasks 5-9).
2026-05-27 refactor(lcd): move live config ownership into LCD subsystem
    g_cfg + app_lcd_cfg() accessor now live in app_lcd.c (the only mutator/reader);
    app.c loads via app_lcd_cfg(). Lets change_page/input/disp layers reach config
    without threading a cfg param through every call.
2026-05-27 feat(lcd): port change_lcd_page page rendering
    app_lcd_change_page() = verbatim port of samd20 change_lcd_page (RUN_STD
    string formatting, all SETUP/comm/ethernet pages, comm-shadow sentinel load).
    Setup-page-1 I2C_POT entry -> hook_set_pot. lcd_var_init() panel-var seed.
    init_mode refactored to set ref_lv_*/lcd_status/sys_mode then call change_page;
    default RUN page render byte-identical to Stage B (no regression). Records
    last_set_page_ms for the SYS_PIC_NOW loop guard.
2026-05-27 feat(lcd): port parse_lcd_comm core dispatch (edits, nav, commands)
    app_lcd_input_dispatch() — switch(vp) on RD(0x83) reports (F5 confirmed:
    data[0]=first payload byte). Config edits write live cfg; nav/shadows write
    state. STD_SETUP_PARAM 1-5, SETUP_PARAM(_MOOHAN), SETUP_MODEL long-press
    (key_press_ms, 2s), LV_RUN_MODE, KEY_MULTI/ERROR_RESET commands via hooks.
    LV_OUT_POWER edit has no DAC. Measure/us state untouched (Stage D owns).
    DATA_SAVE + comm/ether are Task-7 placeholders.
    Note: KEY_MULTI RESET error-clear drops samd20's sys_status==SYS_ERROR gate
    (error path unreachable until Stage D feeds sys_status — reconcile then).
    [app_lcd.h, app_lcd_input.c]
2026-05-27 feat(lcd): port DATA_SAVE/CANCEL + comm/ethernet setup editing
    Fills the 6 Task-7 dispatch cases. DATA_SAVE by page group (MODEL/MULTI/
    HAND/STD) commits shadows->cfg + fires comm/ether/horn/pot hooks, then one
    app_config_save_all (replaces samd20 per-field saves). CANCEL = app_config_load
    rollback + sentinel re-arm. comm addr/speed/parity + LV_COMM_MODE + LV_ETHER_KEY
    IP-entry FSM (process_ip_char de-globalized onto state).
    Verified verbatim vs samd20 SAVE block (main.c:3298-3508): MULTI commits
    comm_mode+ether+serial; HAND+STD commit serial only (STD ethernet edits do
    NOT persist — samd20 quirk, preserved). F3 HAND->MULTI + F4 cancel annotated.
    ether_select_field seeds from temp_ether_i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
    [app_lcd_input.c]
2026-05-27 feat(lcd): port periodic display step-machine + icons + error page
    app_lcd_disp_step() = 10-step job-state display port (verbatim send_outpower_data
    bar-fill + send_outtime_data + send_val_data; step 7 sends both VAR_* and
    LV_TIME+5). 5-element chunked writes preserved. Reads read-only measure stub
    (all-zero -> bars empty, VAR_*=0 = 'alive but idle' UI). Event helpers
    app_lcd_icon/set_work_cnt/show_error (error page unreachable until Stage D
    feeds error_status). Bar-fill divisor-guarded for -Wall + curr_amp=0 safety.
    Stage D notes: lcd_measure_t may need max_amp/last_amp + us_on flag (VAR_AMP
    uses curr_amp both paths; us-on gate collapsed onto us_run_status!=IDLE).
    [app_lcd.h, app_lcd_disp.c]
2026-05-27 feat(app): wire LCD input dispatch + display tick + SYS_PIC_NOW loop guard
    app_loop_iter: RX frames -> app_lcd_input_dispatch (echo-drop kept); removed
    the 1 Hz DGUS_DEMO_UPTIME_VP write (collided with disp step-7 VAR_POWER);
    call app_lcd_tick each iter. app_lcd_tick advances app_lcd_disp_step on a 4 ms
    cadence. SYS_PIC_NOW==0 re-init guarded by boot_complete + 200 ms since
    last_set_page_ms (spec §10, kills the change_page->set_page->report loop).
    boot_complete set at end of app_init. Stage B cold-boot handshake unchanged.
    [app.c, app_lcd.c, app_lcd_input.c]
2026-05-27 docs(lcd): changelog — LCD full behavior port implemented, HW verify pending
    T1-T9 complete (build 0-warning, FLASH 27.9%). Records preserved samd20 quirks
    (F3/F4, STD-no-ether-persist, ether seed bug) + HW bench checklist.
2026-05-27 docs(resume): LCD full port T1-T9 done; next = HW verify (T10), Stage D deferred
2026-05-27 docs(rx): USART1 DGUS RX wedge finding + DMA-circular hardening spec
    HW verify (T10) found energy-slider VP flood permanently wedges USART1
    RX (RXNEIE=0, ORE+RXNE stuck). Two-layer root cause: per-rx blocking
    mon_printf saturates loop (trigger) + 1-byte HAL_UART_Receive_IT rearm
    fragility (wedge). LCD port logic itself sound; RX driver is Phase2/StageA.
    Spec: DMA2 circular RX (S2 Ch4) + trace gate + bounded mon TX timeout.
2026-05-27 docs(rx): implementation plan — USART1 DMA circular RX hardening
    6 tasks: hdma handle, usart1.c DMA-circular rewrite, drop USART1_IRQHandler,
    gate per-rx trace, bound mon TX timeout, HW bench verify. Build-0-warning
    gate per task; HW repro as behavioral acceptance.
2026-05-27 feat(usart1): add hdma_usart1_rx handle (DMA RX hardening)
2026-05-27 feat(usart1): DMA circular RX (DMA2 S2 Ch4) — overrun-immune, no IT rearm
    Replaces 1-byte HAL_UART_Receive_IT (which could permanently wedge on
    overrun/rearm-fail, RXNEIE=0) with free-running circular DMA. usart1_rx_pop
    reads via NDTR; signature unchanged so dgus_lcd parser/app untouched.
    Retires ring-full/rearm counters (return 0); dgus_rx_drop_count is the
    health signal. Removes USART1 RX IT callbacks + s_rx_byte/ring/head.
    [usart1.c]
2026-05-27 fix(usart1): volatile DMA RX buffer + head-transient note (review M1/L1)
    [usart1.c]
2026-05-27 refactor(irq): drop USART1_IRQHandler — RX now DMA, no UART IT
2026-05-27 fix(lcd): gate per-rx trace behind LCD_TRACE_RX (default off)
    Per-rx blocking mon_printf saturated the superloop under VP-write flood
    (energy slider), starving RX drain. Off by default; build -DLCD_TRACE_RX
    for diagnostics.
    [app_lcd_input.c]
2026-05-27 fix(mon): bound USART6 TX timeout to 50ms (was HAL_MAX_DELAY)
    A diagnostic log channel must never be able to hang the app forever.
    [mon_usart6.c]
2026-05-27 fix(lcd): extract DGUS read-response value past READ_LEN byte
    0x83 read-response payload is [READ_LEN, DATA_H, DATA_L]; dispatch read
    data16=(data[0]<<8)|data[1] = (READ_LEN<<8)|DATA_H, mistaking the word-count
    byte for the value MSB. SAVE(=1) read as 256 -> took the CANCEL branch (no
    persist); all numeric edits stored garbage. Now (data[1]<<8)|data[2], matching
    samd20 (dgus_lcd.h DATA_H=5/DATA_L=6 skip offset-4 READ_LEN). Exposed only
    after the DMA RX fix unblocked input testing.
    [app_lcd_input.c]
2026-05-27 docs(rx): record HW-verify findings (RX wedge + data16) + fixes verified
    Finding 2 (data16 read-response extraction off-by-one) appended; changelog
    entry for both fixes with HW-verify PASS (SAVE persists energy=567 across
    power cycle, no RX wedge under flood). Remaining T10 items noted.
2026-05-27 docs(resume): RX DMA + data16 fixes done & HW-verified; next = T10 III-VII
    Update RESUME/NEXT_STEPS for clean resume: two HW-verify bugs fixed
    (USART1 RX wedge -> DMA circular; LCD input extraction off-by-one),
    SAVE persists across power cycle. Remaining = T10 CANCEL/nav/quirk items,
    then main PR + tag hw-revA_fw-stage-lcd.
2026-05-27 fix(lcd): pair down/up data=0 for SETUP_MODEL long-press entry
    HW-verify (T10 item VI) found the model-setup page could not be entered:
    the DGUS 0x1084 key uploads value 0 on BOTH touch-down and touch-up (one
    event each, no auto-repeat) and never the value-2 release that the verbatim
    samd20 port assumed. So long_press_released() misread the release(0) as a
    fresh press and the long-press never completed.
    Fix (P2, firmware-side, user-chosen): pair consecutive same-VP data==0
    events — first arms the press, second is the release and fires if held
    >= KEY_HOLD_MS (2s guard preserved; tap does not enter). data==2 still
    honoured for backward compat. Keyed by VP so 0x1084/0x1094 don't interfere.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
    [app_lcd.h, app_lcd_input.c]
2026-05-27 wip(lcd): STD persists comm_mode/ether + diag; comm_mode display bug pending
    Session checkpoint (T10 item V follow-on). User asked to make STD persist
    comm_mode/ether like MULTI.
    Done (HW-verified): data_save_commit() STD branch now calls
    commit_comm_mode_and_ether(), so STD saves persist comm_mode + ether to FRAM.
    Verified via LCD_TRACE_RX diag: `commit cm temp=1 cfg=0` then `boot cm=1`,
    DHCP `boot cm=2` — persists across power cycle.
    Pending (root-caused, NOT fixed): after DHCP save + power cycle the STDE page
    shows serial+dhcp both checked. Cause = temp_comm_mode shadow lifecycle:
    boot zero-init (not 0xFF sentinel) -> 0xff-gated seed skipped on first comm
    page -> display renders seria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
    [app.c, app_lcd_input.c]
2026-05-31 fix(lcd): comm-mode shadow guard + page-27 display re-assert (A/B/C/D)
    A: boot temp_comm_mode=0xFF sentinel (app_lcd.c init_mode) - close gap vs app_lcd.h:86 intent, consistent with cancel-path re-arm.
    B: commit_comm_mode_and_ether early-return on 0xFF (app_lcd_input.c) - block cm=0xFF + 0.0.0.0 ether corruption on SAVE from non-comm STD page (STD-persist deviation opened it; SAMD20 3340 also unguarded).
    C: re-assert DISP_COMM_MODE/EN_DHCP after set_page on comm pages (app_lcd_render.c) - workaround for panel page 27/23 not auto-loading on page-show. Root fixed in DGUS asset; C now redundant, pending revert+re-verify (handoff 2026-05-31 sec.2).
    D: clear DISP_EN_DHCP=0 in serial render branch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
    [app_lcd.c, app_lcd_input.c, app_lcd_render.c]
2026-05-31 docs(lcd): comm-display resolution + handoff; ignore build-trace
    Analysis: firmware byte-faithful vs SAMD20, root = panel page 27/23 asset (repoint cross-test + user asset-only fix). Handoff checklist for next session (asset capture / Fix C disposition / re-verify / merge+tag). RESUME updated. .gitignore += fw/build-trace/.
2026-05-31 docs(lcd): comm-display resolved (asset root) + §4 HW verify PASS; branch ready for integration
    - changelog: 2026-05-31 entry — A/B/C/D + asset 14ShowFile.bin fix, §4 HW re-verify PASS (toggle/persist/sentinel), cpp-reviewer APPROVED.
    - RESUME/NEXT_STEPS: STEP 0 done; next = main integration + tag hw-revA_fw-stage-lcd → Stage D slice 1.
    - hw/lcd/dgus/README.md: record 2026-05-31 14ShowFile.bin page 27/23 comm-icon fix + DWIN re-export note.
2026-05-31 docs(resume): point new-session First Step to main + Stage D (LCD branch merged/deleted)
2026-05-31 docs(stage-d): slice 1 regulation-core analysis (verified) + spec draft
    Disasm-adjudicated multi-source analysis of the ATmega16 regulation core
    (55-agent workflow) -> STM32F410 Stage D slice-1 evidence base + spec draft.
    No code changes; spec awaiting user review.
    - analysis: 2026-05-31-m16-regulation-core-verified.md -- raw disasm as
    ground truth, v001/reconstruction as hypotheses. 29 bucket-A facts /
    7 bucket-B open decisions. Overturns 5 v001 claims: scaling is x6 (not
    >>6, self-consistent: >>6 never reaches the 1000 clip), single-shot ADC
    (not free-run), Timer1 reload 0xFFB1, 10-rung ramp, compare table[i] < scaled.
    - pipeline (SRAM->SRAM, ~2.05ms Timer0 tick): 2ch single-shot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
2026-05-31 feat(stage-d): pure regulation compute (reg_scale/reg_output_level) + host tests
    Slice-1 plan + the HAL-free pure compute layer. reg_scale (×6/clip/floor,
    SCALE-04/05/06) and reg_output_level (21-rung strictly-less lookup, C2) ported
    verbatim from the disasm-verified analysis; host unit tests (no HAL) pass.
2026-05-31 feat(stage-d): ADC1 driver (PB0/PB1 polled) + hadc1 handle + HAL adc module
    - adc1.c/.h: ADC1 init (12-bit, software-triggered) + adc1_read(ch) polled,
    semantic channels map to ADC_CHANNEL_8/9 (driver stays HAL-internal).
    - periph.c/.h: hadc1 handle (single-owner rule).
    - CMakeLists: + stm32f4xx_hal_adc.c; vendor includes -> SYSTEM (LL header
    -Wunused-parameter no longer breaks the app 0-warning gate).
    - hal_conf.h: enable HAL_ADC_MODULE_ENABLED (app-level config, same as I2C/TIM).
    [adc1.c, adc1.h, periph.c, periph.h]
2026-05-31 feat(stage-d): regulation state module — 2ms tick, 10/50 ADC averaging, scale+lookup
    app_reg_tick() gates on a 2 ms sys_tick delta, alternates ADC ch0/ch1, normalizes
    12->10-bit (>>2), commits mean-of-10/50, then runs reg_scale + reg_output_level on
    the latest ch0_avg and publishes lcd_measure_t (curr_amp/curr_power live; rest 0).
    No OSC GPIO driven (output deferred, B-SEAM). -DREG_TRACE adds a 500ms mon trace.
2026-05-31 feat(stage-d): wire regulation tick into superloop + live LCD measure provider
    - main.c: app_reg_init() after app_init() (ADC1 + state bring-up, sys_tick up).
    - app.c: app_reg_tick() in app_loop_iter (step 3, ~2ms).
    - app_lcd.c: app_lcd_measure() returns app_reg_measure() (live amp+scaled).
    FLASH 26.86->28.39%, RAM 10.16->10.55%; 0-warning.
2026-05-31 fix(stage-d): board.c OSC mask (PB2 add/PB15 drop) + idle-HIGH 3 confirmed channels
    - CTRL_OSC_OUT_PINS = PB2|PB10|PB14 (was PB10|PB12|PB13|PB14|PB15; PB2 missing,
    PB15 spurious per pinmap §117-125).
    - Idle HIGH (OSC off; active-LOW per analysis C6); level set before output mode.
    - PB12/PB13 (OSC2/3 <- PC4/PA7, DDR-inputs in image, C7) left unconfigured —
    direction deferred to bench measurement (B-OSC-MAP). No OSC drive this slice.
    [board.c, main.c]
2026-05-31 fix(stage-d): adc1 — Error_Handler on ADC start/poll failure (no stale sample)
    cpp-reviewer L1/L2: HAL_ADC_PollForConversion timeout previously discarded, so
    HAL_ADC_GetValue could feed a stale DR value into the averaging accumulator.
    Check Start + Poll (consistent with the Init/ConfigChannel checks); Stop stays
    best-effort (void). Conversion ~4us vs 2ms guard = ~500x margin, so a timeout
    is a real HW/clock fault.
    [adc1.c]
2026-05-31 docs(stage-d): slice 1 implementation done (compute) — changelog/RESUME/NEXT_STEPS/plan
    Record Tasks 1-5 complete (build 0-warning, host tests PASS, cpp-reviewer
    APPROVED); next = Task 6 on-target HW verify. Plan: + hal_conf/SYSTEM-include
    build steps, cpp-reviewer L3 (PB15 NC) added to HW checklist.
2026-06-02 docs(stage-d): fix Task 6 trace-build command (CPU flags dropped by -DCMAKE_C_FLAGS override)
    -DCMAKE_C_FLAGS="-DREG_TRACE" replaces the CMAKE_C_FLAGS cache, dropping the
    toolchain's CMAKE_C_FLAGS_INIT CPU flags (-mcpu/-mthumb/-mfpu/-mfloat-abi) ->
    ARM-mode build fails ("selected processor does not support `wfi'"). Pass the
    CPU flags back alongside -DREG_TRACE. Corrected in plan Task 6 step 1 + RESUME
    status block. Verified: build-trace compiles 0-warning, FLASH 28.45%/RAM 10.57%.
2026-06-02 docs(stage-d): record HW verify 6a PASS + split 6b calibration; add M16->STM32 port explainer
    Task 6 split (user decision, measure-first): 6a functional/structural verify
    (no voltage sweep needed) = PASS — compute liveness (x6 + floor->0 + band21
    live), no regression (banners + LCD nav), OSC safety (PB2/PB10/PB14 idle-HIGH
    on scope), LCD provider live (VAR_POWER=0). 6b signal calibration deferred,
    HW-gated (>>2 normalization + 2.56V<->3.3V domain, B-UNITS/B3 units, ADC
    offset/gain, B-OSC-MAP/B-SEAM output path + PB12/PB13 direction).
    Adds analysis/2026-06-02-m16-to-stm32-port-explained.md (compute + I/O port
    explainer, handoff/teaching; references the authoritative fact base).
2026-06-02 docs(stage-d): slice 2a design spec — state machine + soft-start ramp
    Scope: g_main_state + soft-start ramp compute only (output deferred, mirrors
    slice 1 measure-first). Approach A: pure reg_ramp_level in app_reg_calc
    (host-tested) + state/cadence/sel-MUX in app_reg. sel unifies ramp vs lookup
    setpoint -> band (deferred) + curr_power (LCD bar) + us_run_status (running).
    Per-rung facts extracted from M16 recon :249-259 (g_019F thermometer fill).
    Command FSM/overload/blink/OSC drive/exact pattern bytes = out of scope.
2026-06-02 docs(stage-d): slice 2a implementation plan (state machine + soft-start ramp)
    4 tasks: (1) pure reg_ramp_level host-TDD, (2) US_IDLE/US_RUNNING enum to
    app_lcd.h, (3) app_reg state machine + 10ms ramp cadence + sel MUX, (4) HW
    verify (REG_TRACE + LCD bar, no voltage injection). Mirrors slice-1 structure;
    output stage + command FSM + overload deferred.
2026-06-03 feat(stage-d): soft-start ramp pure compute (reg_ramp_level) + host tests
2026-06-03 refactor(stage-d): hoist US_IDLE/US_RUNNING to app_lcd.h contract
2026-06-03 feat(stage-d): soft-start state machine + ramp cadence + sel MUX (slice 2a)
2026-06-03 docs(stage-d): slice 2a code-complete handoff (Task 1-3 done, Task 4 HW pending)
    Update HANDOFF.md (root) + RESUME/changelog/NEXT_STEPS to reflect slice 2a
    state machine + soft-start ramp implemented (commits cc83757/1fe8d36/d3e12c5,
    build 0-warning, host tests PASS, 2-stage reviews APPROVED). Task 4 on-target
    HW verify remains (board not connected). slice 1 noted as merged (2b2a14e).
2026-06-08 docs(stage-d): slice 2a Task 4 HW verify PASS + acceptance correction
    Task 4 실보드 HW 검증 PASS (STLINK V3 + USART6 mon, REG_TRACE).
    부팅 램프 trace (reset 2회 재현): st=1 sel 128→1024 단조 / band 18→0 /
    ~4s (rc 401×10ms) / rc=401 st=0 핸드오프 / st=0 = slice-1 verbatim 무회귀 /
    배너 정상 + LCD power 숫자(VAR_POWER) 램프 추종 상승. 펌웨어 코드 변경 없음.
    합격기준 2건 정정 (spec 디스플레이 계층 오독 → 펌웨어 수정 불필요):
    - 출력 바(LV_OUTPUT) = curr_amp amplitude 바 (전압주입 없으면 idle 정지 by-design)
    - ICON_RUN = samd20 run 명령 FSM (main.c:4302) 소속 = slice 2b 몫
    정정 반영: spec §8.2 + plan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
2026-06-08 docs(stage-d): slice 2a merged to main (f2f375d, tag hw-revA_fw-stage-d2)
    Task 4 HW PASS + 최종 cpp-reviewer APPROVED → --no-ff 머지 + 태그.
    RESUME/NEXT_STEPS/changelog/HANDOFF를 머지-완료 상태로 갱신.
    다음 = slice 2b(명령 FSM·ICON_RUN·overload·blink), B-SEAM·6b = DEFERRED.
2026-06-08 docs(stage-d): slice 2b run-gate design spec
    Touch RUN momentary hold-to-run gate absorbing the SAMD20 command-FSM run
    half, connected to the slice 1/2a regulation core via internal call
    (replaces inter-MCU M_START). Boot becomes IDLE (auto-run retired).
    ICON_RUN + us_run_status taxonomy {IDLE,REMOTE,TOUCH,COMM} + faithful
    max/last latch. SEEK/RESET effect, overload, weld-cycle, Modbus, OSC
    drive = out of scope (B-SEAM / Stage A,C / 6b).
2026-06-08 docs(stage-d): slice 2b run-gate implementation plan
    3 tasks: (1) run FSM + us_run_status taxonomy + command routing
    (app_reg/app_lcd), (2) ICON_RUN edge render (app_lcd_disp), (3) HW
    verify. No new pure function -> no new host test (YAGNI; gate = build
    0-warning + host regression + HW trace/ICON_RUN/VAR_POWER).
2026-06-08 docs(stage-d): slice 2b START guard == US_IDLE (edge re-arm fix)
    advisor catch: != US_REMOTE restarts the ramp on panel auto-repeat while
    RUN held (ramp_counter resets every poll -> never reaches 401 -> no
    lookup handoff). M16 ramp is M_START edge-driven; == US_IDLE is faithful
    + strictly safe for a TOUCH-only slice. spec §4.2 documents the
    divergence; §10 flags ICON_RUN edge re-assert (unreachable this slice).
2026-06-08 feat(stage-d): RUN command gate + us_run_status taxonomy (slice 2b)
    Touch RUN press/release gates the regulation core via app_reg_command
    (routed from app_lcd_hook_us_command). Boot now IDLE (auto-run retired);
    START re-arms the soft-start ramp + resets peak, RUN_RELEASE latches
    last_power=max_power (us_off equiv). us_run_status holds the source
    taxonomy {IDLE,REMOTE,TOUCH,COMM}; US_RUNNING removed. Running lookup
    path == slice-1 verbatim. SEEK/RESET = no-op (deferred).
    [app_lcd.c, app_lcd.h, app_reg.c, app_reg.h]
2026-06-08 feat(stage-d): render ICON_RUN on us_run_status edges (slice 2b)
    disp_step edge-detects (us_run_status != US_IDLE) and writes ICON_RUN
    once per transition (no 4 ms spam). app_reg stays DGUS-free; disp renders
    the published run state (port of samd20 sig_run_status icon, main.c:4302).
2026-06-08 docs(stage-d): slice 2b §4.3 panel mid-run reset -> stop run (Option A)
    cpp-reviewer catch (verified): SYS_PIC_NOW=0 panel self-reset clears
    ICON_RUN via init_mode but leaves us_run_status stuck US_TOUCH (held-RUN
    release lost) -> infinite drive + lying icon. SYS_PIC_NOW=0 fires only on
    real panel resets (page-0 splash), so safe to stop. Option A: issue
    US_CMD_RUN_RELEASE in the re-init -> FSM IDLE re-syncs the icon edge +
    stops the actuator. spec §4.3 + §6/§10; plan Task 2 Step 5-7.
2026-06-08 fix(stage-d): stop run on SYS_PIC_NOW mid-run panel reset (slice 2b)
    Panel self-reset clears ICON_RUN via init_mode but leaves us_run_status
    stuck at US_TOUCH (held-RUN release lost) -> infinite drive + icon reads
    stopped while live. Issue US_CMD_RUN_RELEASE in the SYS_PIC_NOW re-init
    (UI lost -> stop actuator); the FSM->IDLE edge re-syncs ICON_RUN. disp
    edge code unchanged. spec §4.3.
    [app_lcd_input.c]
2026-06-08 docs(stage-d): slice 2b code-complete handoff (Task 1-2 done, Task 3 HW pending)
    Code complete + full cpp-reviewer APPROVED (merge-ready, HW gate pending).
    RESUME/changelog/NEXT_STEPS/HANDOFF updated; plan Task 3 adds item 6
    (IDLE output-bar / curr_amp idle noise-floor check from final review).
2026-06-09 fix(stage-d): map V30 RUN button KEY_MULTI data=0 to run gate (slice 2b)
    HW verification found the V30 DGUS RUN button returns KEY_MULTI=0 on both
    press and release (RESET=1/SEEK=2 are correct; data=0 is unique to RUN).
    handle_key_multi (samd20 port) expected RUN=3/4 so the command never fired.
    Add a data16==0 branch mapping by live us_run_status: IDLE->START(+set_pot),
    running->RUN_RELEASE. The down/up data=0 pair reconstructs hold-to-run;
    self-syncing. FSM/enum/app_reg unchanged; one file. spec §4.4. HW re-verify
    pending board reconnect (build 0-warning, host PASS).
    [app_lcd_input.c]
2026-06-09 docs(stage-d): slice 2b HW session handoff (boot IDLE+RESET/SEEK PASS, RUN fix 74d75b9, re-verify pending)
    HW verify session: boot IDLE + RESET/SEEK routing PASS; RUN blocked by V30
    asset quirk (KEY_MULTI data=0 both edges) -> firmware fix 74d75b9. Board USB
    dropped mid-session -> RUN/ICON_RUN/ramp re-verify + 74d75b9 cpp-reviewer
    pending board reconnect. RESUME 2026-06-08 c block + HANDOFF §Resume + changelog.
2026-06-10 fix(stage-d): M16-faithful boot warm-up + touch on-time ceiling + 1ms ADC pace
    Cross-verification of samd20 source x M16 disassembly (2026-06-10 analysis)
    showed the slice-2a per-START soft-start was a misread: the M16 ramp is a
    one-shot BOOT warm-up (0x0195 nonzero write only @0x1B8A, one-way @0x137C;
    OSC flags stay 0 and the PINA command dispatcher is skipped @0x041E during
    ramp). User decision: revert to faithful semantics.
    - app_reg: one-shot ~4s boot warm-up (commands ignored, sel=0), then START
    is an immediate level-follow gate (sel = reg_scale(ch0_avg), no ramp).
    - TOUCH run on-time ceiling: limit_on_time x10ms (panel-editable, 0=off).
    Deliberate STM32 safety addition (samd20 app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
    [app_reg.c, app_reg.h, app_reg_calc.c]
2026-06-10 docs(stage-d): IPC semantics verification + LCD port full audit (2026-06-10)
    New authority doc docs/superpowers/analysis/2026-06-10-samd20-m16-ipc-
    semantics-verified.md: 4-wire IPC semantics (active-LOW levels, citations),
    M16 boot-warm-up truth, limit_on_time original scope, RESET->SEEK 500ms
    auto-chain as mandatory deferred semantics, B-SEAM narrowed to the 3-wire
    level-mirror hypothesis, plus LCD port full audit (PASS) with 3 undocumented
    gaps recorded as deferred (RESET/SEEK icon edges, us_on_time_200m feed,
    work_cnt increment) and set_pot/I2C_POT elevated to the amplitude actuator.
    Changelog entry + RESUME status block updated (HW re-verify expectations
    changed: warm-up once, RUN immed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
2026-06-10 docs(stage-d): record cpp-reviewer M2/L1 intent notes in code comments
    Combined review of 74d75b9 + 8b1ffd0 (cpp-reviewer 2026-06-10) = APPROVED,
    0 CRITICAL/HIGH. Non-blocking notes applied:
    - M2: app_lcd_input.c data=0 branch — document the same-burst stale
    us_run_status read (g_measure publishes in app_reg_tick) and why the
    US_IDLE guard makes it a benign dropped edge (spec \$4.4 self-syncing).
    - L1: app_reg.h app_reg_tick doc — note the live app_lcd_cfg() read for
    the TOUCH on-time ceiling (evaluated every call, not on the 2 ms gate).
    Deferred by reviewer: M1 (layer dependency refactor), L2 (reg_ramp_level
    reference API retention = deliberate). Comments only, no code change;
    bui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
2026-06-10 docs(stage-d): slice 2b integrated review APPROVED — changelog + RESUME (2026-06-10 b)
2026-06-10 docs(stage-d): refresh HANDOFF for post-review state — HW re-verify criteria updated to warm-up/no-ramp/ceiling semantics
2026-06-12 refactor(stage-d): inject limit_on_time into app_reg_tick (review M1)
    app_reg_tick() no longer reaches back into app_lcd via app_lcd_cfg();
    the superloop (app.c) reads limit_on_time from the live config and
    passes it per call, preserving the panel-edit-takes-effect-immediately
    semantics. Breaks the app_lcd <-> app_reg call cycle flagged as M1 in
    the 2026-06-10 integrated cpp-review (deferred follow-up).
    Behavior-preserving: build 0-warning, host tests PASS.
    [app.c, app_reg.c, app_reg.h]
2026-06-12 feat(stage-d): publish us_on_time_200m for the LV_TIME bar (LCD audit gap 2)
    New pure helper reg_on_time_200m(elapsed_ms) -> 200 ms units capped at
    200 (= 40 s), host-tested (TDD); equivalent to samd20's every-200ms
    increment with the <200 guard (main.c:5223). app_reg publishes it live
    from run_start_ms while a run is active; when idle the field keeps the
    last run's final value, matching samd20's latched last_time display
    through the single lcd_measure_t field (app_lcd_disp.c:183 note).
    Closes deferred LCD-port audit gap 2 (us_on_time_200m unsupplied ->
    LV_TIME bar stuck at 0 during a run). Gaps 1 (icon edges, belongs to
    the RESET->SEEK chain) and 3 (work_cnt, weld-cycle) stay deferred.
    Bu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
    [app_reg.c, app_reg_calc.c, app_reg_calc.h, test_app_reg_calc.c]
2026-06-12 fix(stage-d): apply cpp-review M2/M3 + M1 comment on the follow-up branch
    - M3: zero us_on_time_200m at the run-start edge (samd20 main.c:4306
    literal match; closes the <=2ms stale-pairing window).
    - M2: drop the redundant lim local left over from the cfg-pointer
    pattern; REG_TRACE ceiling print updated too (was a latent trace-only
    build break — caught by syntax-checking with -DREG_TRACE).
    - M1: note at the publish call site that g_measure propagation is
    gated at ~2ms (bounded, invisible at the ~40ms disp cadence).
    Build 0-warning, host tests PASS, REG_TRACE path syntax-checked.
    [app_reg.c]
2026-06-12 docs(stage-d): record HW-independent follow-ups — M1 injection + us_on_time_200m (2026-06-12)
2026-06-12 docs(stage-c): Modbus slice 1 (core + RTU) design spec — brainstorming approved 2026-06-12
2026-06-12 docs(stage-c): session close — slice 1 spec approved, plan resumes next session (2026-06-12 b)
2026-06-12 docs(stage-c): Modbus slice 1 implementation plan (writing-plans, self-reviewed)
2026-06-12 feat(stage-c): modbus core skeleton — H_REG map, mb_core_init, CRC16 (host-tested)
2026-06-12 refactor(stage-c): explicit narrowing casts in mb_crc16 loop (cpp-review style consistency)
2026-06-12 feat(stage-c): modbus core decode dispatch + FC03/04 reads (bounds-checked)
2026-06-12 test(stage-c): fence-post read vectors + cast/contract comments (cpp-review)
2026-06-12 feat(stage-c): modbus core FC06 write + FC01/02/05 coils (samd20 echo/full-byte bugs fixed)
    [app_modbus_core.c, test_app_modbus_core.c]
2026-06-12 test(stage-c): coil fence-posts + TCP write vector; clearer nbits ternary (cpp-review)
2026-06-12 feat(stage-c): mon output enable gate for usart6 occupancy switching
2026-06-12 feat(stage-c): usart6_mb RTU transport — DMA circular RX + samd20 break-gap framing + blocking TX
2026-06-12 fix(stage-c): usart6_mb double-open guard + bool flag + const-cast note (cpp-review)
    [usart6_mb.c]
2026-06-12 feat(stage-c): run FSM command source (US_COMM) + amp peak tracking + COMM on-time ceiling
2026-06-12 docs(stage-c): fix ceiling/source comment drift — REMOTE deferred, COMM live (cpp-review)
    [app_lcd.h, app_reg.c, app_reg.h]
2026-06-12 feat(stage-c): app_modbus integration — live mirror, clamped writes + FRAM, US_COMM commands, usart6 occupancy switching
2026-06-12 docs(stage-c): f_safty as-is note + FRAM commit latency budget comment (cpp-review)
2026-06-12 docs(stage-c): changelog — modbus slice 1 core+RTU code-complete
2026-06-12 docs(stage-c): stale pot-guard + orphaned COMM-run NOTE comments (final integration review)
2026-06-12 docs(stage-c): session close — modbus slice 1 code-complete, HW E2E gated (2026-06-12 c)
2026-06-13 docs(stage-c): refresh RESUME First Step to modbus slice 1 branch (new session prep)
2026-06-13 docs(stage-d): slice 2b HW re-verify PASS + main merge/tag hw-revA_fw-stage-d2b (2026-06-13)
2026-06-13 docs(stage-d): m1 LV_TIME HW PASS + main merge d1afc56 (merge-range correction noted) (2026-06-13 b)
2026-06-13 docs(stage-c): Modbus slice 1 HW E2E (mbpoll RS-485) PASS — 6-item matrix + ICON_RUN visual
2026-06-13 docs(stage-c): record modbus merge c05bdbb + tag hw-revA_fw-stage-c1; refresh First Step to main (next = slice 2 TCP)
2026-06-13 docs(stage-c): HANDOFF refresh — modbus slice 1 HW E2E PASS + merged, next = slice 2 TCP
2026-06-13 docs(stage-c): slice 2a Modbus TCP (W5500 static) design spec
    - shared core reuse (MB_MODE_TCP), standard Modbus TCP framing (MBAP echo,
    CRC stripped) — samd20 raw-response quirk dropped
    - modules: vendor WIZnet ioLibrary (official) + spi1 driver + app_eth bringup
    + app_modbus_tcp glue; register semantics/apply shared with RTU
    - W5500 pins PA4(sw-CS)/PA5/6/7(AF5)/PC5(RST)/PC4(INT); boot non-fatal init
    + comm_mode==ETH gating (mutually exclusive with RTU)
    - static IP from cfg(FRAM), hardcoded MAC; DHCP deferred to slice 2b
    - host test = MBAP framing; HW E2E (mbpoll -m tcp) board-gated
2026-06-13 docs(stage-c): slice 2a Modbus TCP implementation plan (9 tasks)
    - Task 1 vendor WIZnet ioLibrary (W5500, warning-isolated) — gates downstream
    - Task 2 SPI1 driver; Task 3 pure MBAP framing (TDD host test); Task 4
    behavior-preserving apply-path exposure (HW-verified, sensitive)
    - Task 5 W5500 non-fatal bringup; Task 6 socket FSM transport; Task 7
    superloop integration (ETH gating + mirror gap fix)
    - Task 8 build/host gate + review; Task 9 HW E2E (mbpoll -m tcp, board-gated)
2026-06-13 docs(stage-c): session wrap — slice 2a spec+plan done, RESUME/changelog refresh (next = impl Task 1)
2026-06-13 build(stage-c): vendor WIZnet ioLibrary (W5500 subset), warning-isolated
2026-06-13 feat(stage-c): SPI1 master + W5500 CS/RST GPIO driver
2026-06-13 feat(stage-c): pure standard-Modbus-TCP MBAP framing + host test
2026-06-13 refactor(stage-c): expose shared mb core + write-apply for TCP reuse (no behavior change)
2026-06-13 feat(stage-c): W5500 bring-up (non-fatal init, static netinfo from cfg)
2026-06-13 feat(stage-c): Modbus-TCP server transport (socket FSM, port 502)
2026-06-13 feat(stage-c): wire W5500 TCP server into superloop (ETH-mode gating + mirror)
2026-06-13 docs(stage-c): slice 2a Modbus TCP code-complete, host PASS — next HW E2E
2026-06-13 docs(stage-c): slice 2b Modbus TCP (W5500 DHCP) design spec
2026-06-13 docs(stage-c): slice 2b Modbus TCP (W5500 DHCP) implementation plan (5 tasks)
2026-06-13 docs(stage-c): session wrap — slice 2b spec+plan done, RESUME/changelog refresh (next = impl 2b Task 1 subagent-driven)
2026-06-13 build(stage-c): vendor WIZnet ioLibrary DHCP client (slice 2b)
2026-06-13 feat(stage-c): W5500 DHCP client lifecycle in app_eth (non-blocking acquire)
2026-06-13 style(stage-c): _Alignas DHCP RX buffer (cpp-reviewer minor)
2026-06-13 feat(stage-c): drive W5500 DHCP client from the superloop
2026-06-13 docs(stage-c): main.c eth comment covers DHCP mode (cpp-reviewer minor 3)
2026-06-13 docs(stage-c): slice 2b DHCP code-complete, host PASS — next HW E2E
2026-06-13 fix(stage-c): set W5500 MAC (SHAR) before DHCP_init (advisor: lease bound wrong MAC)
    [app_eth.c]
2026-06-13 docs(stage-c): record advisor-caught MAC-before-DHCP fix (f89ddfc)
2026-06-13 fix(stage-c): non-blocking W5500 PHY-link retry in app_eth_tick
    HW E2E found the 1s boot PHY-link poll (slice 2a app_eth_init) gave up
    ~0.5s too early: the W5500 PHY auto-negotiates ~1.5s after NRST reset.
    Refactor app_eth to a non-blocking state machine (DOWN/LINKWAIT/STATIC_UP/
    DHCP_RUN): init does fast chip bring-up only; app_eth_tick polls the PHY
    link (100ms) and applies static netinfo or starts DHCP on link-up. Boot
    never blocks; a cable plugged in after boot recovers (HW-verified). Bug
    originates in slice 2a; 2a must inherit this before merge.
    [app_eth.c, app_eth.h]
2026-06-13 docs(stage-c): app_eth review fixes — banner accuracy, stdint include, dhcp timer reset
    [app_eth.c, app_eth.h]
2026-06-13 docs(stage-c): slice 2b HW E2E PASS (static+DHCP+retry) + non-blocking PHY refactor — next=merge strategy
2026-06-13 docs(stage-c): tip c118b81 re-flashed+HW-confirmed; merge default=collapse split (no c2a on broken 2a)
2026-06-13 docs(stage-c): slice 2 merged (tag c2b) — HANDOFF/RESUME/changelog refresh, Stage C done
2026-06-13 docs: 문서정비 + slice-2 deferred HW 종결 (j)
    - slice-2 deferred HW 전수 종결(코드 무수정): ICON_RUN over TCP PASS(560ms ceiling 실측), RTU FC06 회귀 PASS(무회귀), RAM-only 재리스=DHCP→static persist 규명·수용
    - NEXT_STEPS.md 재작성(Stage C/D 완료 반영, 2026-05-25 stale 해소)
    - CLAUDE.md: 해소된 핵심 질문 갱신 + ETH 설정 저장 gotcha 추가
    - HANDOFF.md 세션 마감 핸드오프 재작성, RESUME j블록, changelog j엔트리
2026-06-14 docs(weld-cycle): slice 1 core FSM (DELAY mode) design spec
    - samd20 5-state press-cycle FSM(READY→CYL1→WELD→HOLD→CYL2→work_cnt++) DELAY 모드 포팅 spec
    - 신규 모듈 app_weld_fsm(HAL-free 코어, host-test) + app_weld(글루)
    - WELD가 신규 소스 US_CYCLE로 기존 app_reg 게이트 구동(ceiling 제외, peak/STATUS 재사용)
    - 물리 IO(SOL_DN/OSC/센서) hook 스텁; energy/multi/TRIGGER/실GPIO/안전 = 슬라이스 2~4 deferred
    - work_cnt++ → FRAM → LCD/Modbus 미러 = PC HMI 미해결 #7 종결
    - 충실도=혼합(comp_time quirk 문서화), 시간단위 10ms/count
2026-06-14 docs(weld-cycle): spec §5.3/§11.1 — START 트리거 통합 확정
    사용자 확정: 물리 SW_START1/2·패널·Modbus START 모두 동등한 사이클 트리거
    (모델 게이팅/hand 바이패스 없음). §11.1 개방 항목 해소.
2026-06-14 docs(weld-cycle): spec 정정 — START는 samd20 충실 분리(물리=사이클, 패널/Modbus=직접 초음파)
    이전 '통합' 커밋(16947d7) 되돌림. 사용자 재확인:
    - weld 사이클 = 물리 SW_START1/2로만 트리거 (슬라이스4 HW-gated)
    - 패널/Modbus START = 직접 초음파(hand/comm), 현 STM32 거동 무수정
    - 두 초음파 경로(직접/사이클) 공존; 사이클 WELD는 US_CYCLE로 게이트 구동
    - 슬라이스1 결과: 프로덕션 트리거 미와이어 → FSM은 host-test 검증,
    HW는 회귀확인 위주(+선택 디버그 트리거), 사이클 HW E2E는 슬라이스4
    - §1.1/§1.2/§4.2/§5.3/§7/§10/§11.1 일관 반영
2026-06-14 docs(weld-cycle): spec 값정정 — 진폭 0/63/127(255 아님) + 언더플로 가드(혼합 버그수정)
    planning self-review에서 발견:
    - §9 test4: (op-50)*255/100, op 50..100 → pot 0..127 (이전 255 오기)
    - §8: comp_time 감쇠의 uint8 언더플로(저전력+짧은용접)=명백한 버그 → amp 0 클램프
2026-06-14 docs(weld-cycle): SETUP 게이트 슬라이스4 이연 (§5.4/§4.2/§1.3)
    STM32에 sys_status 미유지 + 슬라이스1은 프로덕션 트리거 없어 사이클이
    HW에서 안 도므로 SETUP 게이트 무의미 → 사이클 런타임과 함께 슬라이스4로.
2026-06-14 docs(weld-cycle): slice 1 구현 계획 (6 tasks, TDD)
    - Task1 코어 스캐폴드+Makefile+init / Task2 step()전체+사이클·타이밍 /
    Task3 comp_time보정+언더플로가드+엣지 / Task4 app_reg US_CYCLE /
    Task5 글루 app_weld / Task6 슈퍼루프 배선
    - 전 step 실코드·명령·기대출력, self-review 포함
2026-06-14 docs(weld-cycle): HANDOFF.md(슬라이스1 구현 핸드오프) + RESUME 상단 블록
    - HANDOFF.md = weld-cycle 슬라이스1 구현 핸드오프(이전 Stage-C 핸드오프 supersede):
    Goal/Completed/Not-Done/Failed-Approaches(START 통합 폐기)/Key-Decisions/
    Code-Context/Resume-Instructions/Warnings
    - RESUME.md 2026-06-14 마감 블록(자동 로드 진입점), 기존 j블록 아래로
2026-06-14 docs(weld): 진폭 hook 이중변환 버그 수정 — 전용 set_amp(raw DAC)
    - 계획서 글루 app_lcd_hook_set_pot(out.amplitude)는 이중 변환 버그:
    기존 hook은 output_power(50..100) 입력→내부 (x-50)*255/100,
    코어가 이미 변환한 DAC(0..127)를 넣으면 op=100→127→196 오류
    - samd20(main.c:1549)은 comp_time 보정한 temp_i를 I2C_POT에 직접 write
    - 수정: 전용 app_weld_hook_set_amp(uint8_t dac) raw-DAC hook 신설
    (spec line 19가 이미 허용), comp_time 감쇠는 DAC 도메인이라 필수
    - spec §6 table/노트 + amplitude 0..127 정정 + plan Task 5 + HANDOFF 반영
    - Task 1~3(코어) 무영향 — weld_amplitude는 DAC 반환, 테스트 0/6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
2026-06-14 feat(weld): FSM core scaffold + host test harness
    - app_weld_fsm.{h,c} 인터페이스 + 스켈레톤(init/status), step은 스텁
    - fw/test/test_app_weld_fsm.c + Makefile BIN_WELD 추가
    - init -> READY 검증
2026-06-14 feat(weld): FSM step() 전체 구현 (DELAY 5상태) + 사이클/타이밍 테스트
    - READY→CYL1→WELD→HOLD→CYL2→READY, temp_time 10ms 카운트다운
    - SOL_DN on(CYL1)/off(CYL2), weld_start/stop 엣지, cycle_done 엣지
    - 진폭 base만(comp_time 보정은 다음 커밋); 상태별 점유=limit 검증
2026-06-14 feat(weld): comp_time 진폭보정 + 언더플로 가드 + 엣지/start 테스트
    - 짧은 용접(ldt2<=6) 진폭 감쇠 (7-comp_time)*10 (samd20 충실)
    - uint8 언더플로 가드: amp<reduction -> 0 (명백한 버그 수정, spec §8)
    - 진폭 0/63/127 경계, start READY-only 소비, cycle_done 단일엣지 검증
    [app_weld_fsm.c, test_app_weld_fsm.c]
2026-06-14 feat(weld): app_reg US_CYCLE 소스 추가 (enum) + ceiling 제외 주석
    - us_run_status enum에 US_CYCLE=4 (WELD가 게이트 구동하는 소스)
    - app_reg_command는 src를 그대로 저장 -> START/RELEASE 분기 불필요
    - on-time ceiling은 TOUCH/COMM만 -> US_CYCLE 자연 제외(주석 명시, spec §5.2)
2026-06-14 feat(weld): 글루 app_weld.{h,c} + SOL_DN/set_amp hook 스텁
    - 10ms 게이트 FSM 구동, out-events -> SOL_DN hook(로그) / app_reg US_CYCLE
    START·RELEASE / cycle_done -> work_cnt++ + app_config_save_all + LCD
    - 진폭: 전용 app_weld_hook_set_amp(raw DAC 0..127) — 기존 set_pot은
    output_power 입력이라 재사용 시 이중 변환(spec §6)
    - app_weld_request_start() one-shot 래치(슬라이스4 합류점, 프로덕션 호출자 없음)
    - SETUP 게이트 없음(슬라이스4, spec §5.4)
2026-06-14 docs(weld): glue 리뷰 코멘트 반영 (cpp-reviewer L1/M1/L2)
    - L1: include 주석 정정 (US_CMD_*/us_cmd_t는 app_lcd.h 경유, app_reg.h 아님)
    - M1: tick 게이트 = now 누적 슬립 슬라이스4 플래그(실 공압 dwell시 += WELD_TICK_MS)
    - L2: one-shot 래치 정확 의미 명시 (mid-cycle 요청은 매틱 소거되어 유실, 큐잉 아님)
    - 코멘트만 — 로직 무변경, 빌드 0-warning(우리 코드)
2026-06-14 feat(weld): 슈퍼루프 배선 — app_weld_init(boot) + app_weld_tick(loop)
    - main.c: app_reg_init 뒤 app_weld_init
    - app.c app_loop_iter: app_lcd_tick 뒤 / app_reg_tick 앞에 app_weld_tick
    - 슬라이스1 트리거 없음 -> HW에서 READY 휴면, 기존 직접-초음파 무회귀
2026-06-14 fix(weld): default fault path fail-safe solenoid off (cpp-review LOW-2)
    - weld_fsm_step default 케이스(정상 도달 불가)에서 s_sol_dn=0 추가
    - 공압 프레스 fail-safe: fault 시 솔레노이드 잔류 방지(SOL_DN 실 GPIO=슬라이스4)
    - 도달 불가 경로라 호스트 테스트 무영향, 빌드 0-warning
    [app_weld_fsm.c]
2026-06-14 docs(weld): 슬라이스1 구현 완료 반영 (host-verified, 미머지 — 보드 먼저)
    - changelog 2026-06-14 b + RESUME 상단 블록 + NEXT_STEPS §1.2/§2.1 + HANDOFF
    - 상태: CODE-COMPLETE host-verified, 미머지(보드 직접-초음파 무회귀 후 머지+태그)
    - set_amp 이중변환 수정·LOW-2 fail-safe·LOW-1 슬라이스4 must-fix(LCD [50,100] 클램프) 기록
    - 태그 hw-revA_fw-stage-weld1은 host-only 예정 — HW 회귀확인 시점 명시
2026-06-14 docs(weld): 슬라이스1 HW 회귀확인 PASS + 머지/태그 반영 (2026-06-14 c)
    - changelog c엔트리(HW 회귀: FC03 미러=g_cfg / START→560ms ceiling / work_cnt 0 dormant / ICON_RUN 육안)
    - RESUME c블록 + NEXT_STEPS §1.1 weld 스테이지 행 추가 + §1.2 머지 반영
    - HANDOFF Status=MERGED(supersede); 태그=host+HW-regression verified(사이클 E2E는 슬라이스4)
2026-06-14 docs(weld): 다음 세션 진입점 = 슬라이스2(energy_ctrl) brainstorming
    - RESUME c블록 + NEXT_STEPS §2.2에 슬라이스2 범위 씨앗·samd20 참조(main.c:434-436/1554-1555/1560)·STM32 현황(config만 포팅, 누산·에너지-exit 미포팅) 명시
    - §2.3 보드 상태 2026-06-14 c 갱신(weld-1 플래시됨)
2026-06-14 docs(weld): 슬라이스2(energy_ctrl) spec — energy 기반 WELD exit 설계
    - 아키텍처 Option A: 누산은 app_reg(run-start 리셋 공짜), FSM은 curr_energy 주입받아 비교만
    - 에너지 산술 = app_reg_calc 순수 헬퍼(host-test); cadence divisor 2ms·/250로 samd20 1ms·/500 재현(절대 보정은 6b/HW)
    - FSM WELD 분기: energy-exit(curr_energy>=limit_energy) + backstop abort(limit_out_time 미도달→weld_fault+READY, work_cnt 미발생) + comp_time/temp_time 디커플
    - 범위=weld-only(사용자 확정); samd20 5270 COMM/TOUCH 직접런 energy-gating은 이연(deviation 명시)
    - last_energy 래치 + 누산 보편(DISP_ENERGY/VAR_ENERGY 점등) + fault hook stub
2026-06-14 docs(weld): 슬라이스2(energy) 구현 계획 — 5 Task (헬퍼/FSM/app_reg/글루/검증)
    - Task1 reg_energy_from_acc 순수 헬퍼+host-test(TDD)
    - Task2 FSM energy-exit+backstop abort+comp_time 디커플+host-test(TDD)
    - Task3 app_reg 누산 결선(4지점, build-verified)
    - Task4 글루 energy 주입+fault hook(build-verified)
    - Task5 통합 검증(host 4스위트+0-warning+cpp-review)
    - Makefile 변경 불요(헬퍼=BIN_REG 기존 의존, weld 새 외부의존 0); 기존 8 weld 테스트가 energy_ctrl=0 회귀 커버
2026-06-14 feat(weld): reg_energy_from_acc 순수 헬퍼 + host-test (slice2 §4)
2026-06-14 docs(weld): test_app_reg_calc 헤더에 에너지 헬퍼 커버리지 반영 (cpp-review LOW-2)
2026-06-14 feat(weld): FSM energy-exit + backstop abort + comp_time 디커플 (slice2 §3)
2026-06-14 fix(weld): backstop limit_out_time=0 floor 1s + 회귀 테스트 (cpp-review M1, L3/L4)
    [app_weld_fsm.c, app_weld_fsm.h, test_app_weld_fsm.c]
2026-06-14 feat(weld): app_reg 에너지 누산 + last_energy 래치 + REG_TICK_MS cross-ref (slice2 §5, LOW-1)
2026-06-14 feat(weld): 글루 energy 필드 주입 + fault hook (slice2 §7)
2026-06-14 docs(weld): 슬라이스2 CODE-COMPLETE 핸드오프 — RESUME/NEXT_STEPS/changelog + spec §11 리뷰 엣지
    - RESUME d블록 + NEXT_STEPS §2.2/§1.2: 슬라이스2 code-complete, 다음=보드 회귀확인+머지(태그 hw-revA_fw-stage-weld2)
    - changelog 2026-06-14 d: 6커밋·Option A·리뷰 결과·범위/이연
    - spec §11: 리뷰 엣지 5~7(limit_energy=0 samd20충실/acc 24분 wrap/uint16 truncation=display-only) + §11-4 mid-cycle 토글 보강
2026-06-14 docs(weld): 슬라이스2 HW 회귀확인 PASS + 머지 반영 (2026-06-14 e)
    - changelog e + RESUME e블록 + NEXT_STEPS §1.1표/§1.2/§2.2/§2.3: weld-2 MERGED(tag hw-revA_fw-stage-weld2), 다음=슬라이스3(multi_ctrl)
    - HW 회귀 PASS(직접-초음파 ceiling+ICON_RUN/§6 deviation/work_cnt 0/Modbus 무회귀); #2 누산 점등=벤치 무신호 6b 이연
    - 레지스터 오기 정정: DISP_ENERGY=wire 0x05(-r6), 0x16 아님; zsh mbpoll 인라인 플래그 주의
2026-06-14 docs: SWD baud 진단 팁 + mon 복원 정상 규명 (2026-06-14 e §4.3)
    - 'mon baud 미복원 버그' 의심 → controlled SWD 실험(comm_address=0 강제→USART6 BRR=833=115200/CR1 8N1)으로 버그 아님 규명
    - §4.3: addr=NONE 해제 시 usart6_init 115200 8N1 정확 복원 명시 + SWD USART6 BRR/CR1 직독 진단법(시리얼 플레이키 회피) + g_cfg addr 직독
2026-06-16 docs(weld): 슬라이스3(multi_ctrl 2단 진폭 스테핑) spec 확정 (2026-06-16)
    - 범위 weld-only(§6 deviation, 슬라이스2 선례)
    - 아키텍처 FSM 내부 상태(s_multi_stage/elapsed) — app_reg/주입 불필요
    - 진폭 emit 단일 설계(weld_start + amp_change 엣지, 같은 set_amp hook)
    - 우선순위 multi>energy>시간, 기존 exit 게이팅(samd20 1562)
    - comp_time 미적용, 언더플로 가드(팩토리 out1=25), 타이밍 액면가 10ms tick
2026-06-16 docs(weld): 슬라이스3 구현 계획 (3 task TDD — 인터페이스/FSM분기+host-test9/글루)
    - Task1 헤더 5필드+amp_change+정적 stage/elapsed (무회귀)
    - Task2 weld_mo_amplitude(언더플로 가드)+WELD multi 분기(우선순위 게이팅)+host-test 9
    - Task3 글루 multi 주입+amp_change→set_amp 라우팅
    - 빌드 env -u STM32_TOOLCHAIN, 테스트 make -C fw/test test
2026-06-16 feat(weld): slice3 FSM 인터페이스 확장 — multi_ctrl 5필드 + amp_change 엣지 + 정적 stage/elapsed
2026-06-16 feat(weld): slice3 FSM multi 2단 진폭 스테핑 분기 + host-test 9 (스테핑/override/언더플로/경계/회귀)
2026-06-16 feat(weld): slice3 글루 — multi 5필드 cfg 주입 + amp_change→set_amp 라우팅 (+amplitude 주석 M1)
    - app_weld.c weld_in_t 초기화: multi_ctrl, limit_mo_out1/2, limit_mo_time1/2 주입
    - app_weld.c amp_change 엣지 라우팅: set_amp 재호출 (US_CYCLE 유지, START 아님)
    - app_weld_fsm.h amplitude 주석 업데이트: "or amp_change" 케이스 명시 (cpp-review M1)
    Host-test: all suites PASS (21/weld_fsm + 3 others regression-PASS)
    Build: FLASH 41.64% / RAM 16.72%, 0-warning (our code)
2026-06-16 docs(weld): 슬라이스3(multi_ctrl) CODE-COMPLETE 문서 갱신 (2026-06-17)
    RESUME/changelog/NEXT_STEPS — 슬라이스3 CODE-COMPLETE 미머지 반영.
    다음 = 보드 회귀확인(직접-초음파 무회귀+multi=ON 단일진폭+work_cnt 0) → 머지+태그 hw-revA_fw-stage-weld3.
2026-06-16 docs(weld): 슬라이스3 elapsed=1 근거 정정 — spec/plan drift 해소 (advisor)
    - spec §3.3·plan 코드블록: s_multi_elapsed 진입값 0→1 정정 (shipped 코드와 일치)
    - 진짜 근거 = 초음파-on span(weld_start→weld_stop) 슬라이스1(ldt2-1) 일관 (weld_steps 카운트는 부산물)
    - 정상(time1<time2) 전환 tick index(out1 duration=time1-1) 미검증 명시 → 슬라이스4 실 초음파 HW
    - RESUME/changelog '코드가 정답/동결' 표현 완화
2026-06-16 docs(seekreset): SEEK/RESET 효과 spec 확정 (2026-06-17)
    - 범위 = 상태머신+500ms 자동체인/해제+ICON 렌더 (HW 불요, host-test)
    - 물리 OSC 신호 구동 = hook stub + B-SEAM/6b 이연 (M16 흡수 귀결)
    - 아키텍처 = 순수 FSM 분리 (app_seek_reset_fsm + 글루), weld 패턴
    - RESET→SEEK 자동체인, SEEK 단발, 10ms tick 50=500ms 액면가, 양방향 RUN 직교
    - 분석 §5 ICON 엣지 렌더 갭 동시 해결
2026-06-16 docs(seekreset): 세션 마무리 — SEEK/RESET spec 완료 + 브랜치 stack 상태 기록
    RESUME/NEXT_STEPS/changelog — SEEK/RESET brainstorming+spec 완료, 미구현.
    브랜치 feat/stage-seek-reset (slice3 tip stack). 다음=spec 리뷰→writing-plans.
2026-06-16 docs(seekreset): SEEK/RESET 구현 계획 (3 Task TDD — FSM 인터페이스/전이로직+host-test6/글루+app_reg 위임)
    advisor 검토 반영: START guard swallow-safe(별도 break), weld-START 슬라이스4 deferred 노트, B-SEAM 레벨필드 경고, cpp-review 포커스(guard diff=핵심 회귀위험).
2026-06-16 feat(seekreset): FSM 인터페이스 + 스캐폴드 + host-test 배선
2026-06-16 feat(seekreset): FSM 전이 로직 (자동 체인/단발/RUN직교/busy) + host-test 6
2026-06-17 feat(seekreset): 글루 + app_reg 위임/START 직교 guard + 슈퍼루프 배선
2026-06-17 docs(seekreset): CODE-COMPLETE 핸드오프 — RESUME/changelog (host+build verified, 미머지)
2026-06-17 docs(seekreset): 보드 세션 체크리스트 — weld3 회귀+머지 → seek-reset HW 4항목 → 머지 (reg 맵/mbpoll/순서)
2026-06-19 docs: 보드 세션 결과 — weld3 + seek-reset HW 검증 PASS + 머지 핸드오프
    체크리스트 순서대로 ① weld slice3 회귀확인+머지(태그 weld3) → ② seek-reset HW 4항목 → ③ 머지(태그 seekreset). RESUME/changelog에 회귀·HW 4항목 결과, ON_TIME clamp=100 규명, CMake GLOB reconfigure 함정 기록.
2026-06-19 docs(handoff): HANDOFF.md 재작성 — 보드 세션(weld3+seek-reset HW 검증+머지) 완료 반영
    이전 weld-slice1 HANDOFF supersede. 두 스테이지 머지 완료/태그, HW-gated deferred 잔존, 세션 gotcha(GLOB reconfigure·mbpoll CRC·ICON 확대·HW-4 대조법) 기록.
2026-06-20 docs(handoff): 다음 세션용 HANDOFF 재작성 — 남은 작업(HW-gated) + filter-repo 히스토리 재작성 컨텍스트
    push 완료 체크포인트. 옛 해시 무효(태그로 참조)·남은 작업 4종(weld slice4/B-SEAM OSC/6b cal/overload, 전부 HW-gated, spec 미작성)·보드 검증 절·이메일 인증 미완료 기록.
2026-06-20 docs(next-steps): 2026-06-20 갱신 — weld3+seek-reset 머지/푸시 완료, 남은 작업 HW-gated, filter-repo 재작성 컨텍스트
    스테이지 표(weld3/seekreset 추가)·§1.2 남은 작업(HW-gated only)·§2.2 후보·§2.3 보드 상태·머지/푸시 정책(origin SSH 사용)·옛 해시 무효 경고 갱신. host 5스위트.
2026-06-20 docs(analysis): B-SEAM OSC 신호체인+포팅충실도 분석 세션 (2026-06-20)
    - 신규 분석 문서: 신호체인(MCU중심)·명령선(PA4/5/6)·포팅충실도(OSC핀+M16처리코어 3-way)·측정절차7단계
    - 출력단=B-SEAM(OSC채널)+F2(진폭pot U4정체) 둘 다 미구동 stub 규명 (이전 '진폭 동작중' 정정)
    - M16 처리코어 disasm 권위 포팅 확인 (v001 오류 3곳 비껴감: x6/lookup</lt>/warmup)
    - RESUME/HANDOFF: 사용자 오프라인 검토 대기 → 다음 세션 반영 진입점
    - 코드 무변경 (docs only)
2026-06-20 docs(analysis): B4 해소 — PB1=SAMD20 소비전류, 전류/전력/에너지 source 정정
    - M16 PA1 미연결 확정; STM32 PB1 = 옛 SAMD20 PA02 = 소비전류 (ADC_OSC 라벨 stale)
    - SAMD20 cal_real_val 검증: 전류표시/전력(curr_amp*2.2)/에너지(acc/500) 전부 PA02 파생
    - STM32 현재 불일치: PB1 read-and-discard + curr_amp/power/energy를 ch0(reg_scale)에서 뽑음
    - curr_amp=소비전류(ampere) 정정 (진폭 아님)
    - 6b 스테이지 본체 = PB1 전류에서 SAMD20 공식 재구성 + ch0 레귤레이션/OSC 분리 (코드 무변경)
    - 분석문서 §4b 신규 + RESUME ⑤ 추가
2026-06-20 docs(analysis): OSC 3채널 명령 매핑 확정 (사용자 HW) — RUN=PC7/PB14, SEEK=PB1/PB2, RESET=PB0/PB10 active-LOW
    - finding ④ 가설→확정: OSC 3선 = run/seek/reset active-LOW binary 미러 (thermometer 패턴 아님)
    - v001 변수명 또 오라벨: g_run_flag=실제 RESET(run 아님), g_blink_state=실제 RUN
    - B-SEAM 3채널 분 = 측정 게이트 아님 → 코딩 가능 (내부 run/seek/reset → active-LOW)
    - 남은 미지: PB12/PB13(OSC2/OSC3) 방향, F2(진폭), 스코프 sanity
    - 분석문서 §2/§3/§6/요약⑥ + RESUME ⑥ 갱신 (코드 무변경)
2026-06-20 docs(analysis): OVLD/PA7/PA0 신규 발견 반영 + M16 disasm 자료 추가
    - M16 disasm 확보(ref/atmega16/m16_disasm/firmware_disassembled.asm 2953줄) — 이전 'raw .asm 없음' 해소, 권위 소스
    - OVLD(PC0) 로직 디코드: PA7(PINA.7) HIGH x5 디바운스 -> sbi 0x15,0 어서트 + OVLD->SEEK 복구훅(0x1D28)
    - ★ PA7=과부하 입력 -> 보류 OSC3(PB13) 해소 (OSC 출력 아님; OSC2/PC4만 미확정)
    - PA0/SENS_OUT=양 레거시 MCU 모두 vestigial (M16 dead 7seg / SAMD20 curr_lv 소비처 주석); STM32 reg_scale(ch0)->curr_power=오용
    - v001 신뢰도 추가 하락(overload/PA5,6/PC4/ADMUX 누락) -> disasm 권위
    - 분석문서 §4c 신규 + 요약⑦⑧ + §6 미해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
2026-06-20 docs(analysis): overload 스테이지 설계 확정 (사용자 결정)
    - STM32 직접 처리: M_OVLD IPC(M16 PC0->SAMD20 PB10) 소멸, STM32가 입력 직접 읽어 내부 처리
    - 입력 PB13(<-mega16 PA7) 과부하 sense active HIGH (HIGH=overload); pinmap 'CTRL_OSC3' 오라벨
    - 출력 PB3 CON_OVLD = 외부 릴레이 제어 신호 (필요 확정, active HIGH)
    - heartbeat PB3->PB8 이전 (빈 GPIO)
    - 복구 RESET->자동 SEEK = seek-reset FSM 재사용; 응답=SAMD20 로직(정지/ERR_OVLD/OVER LOAD)
    - pinmap 정정 필요 (PB13=입력/PB3=릴레이출력); 분석 §4c/§6 + RESUME ⑨
2026-06-20 docs(pinmap): 2026-06-20 정정 — OSC매핑/과부하/ADC/CON_OVLD 확정 반영
    - 상단 '2026-06-20 정정(본문 우선)' 배너 추가
    - OSC 출력 3채널 = PB2(SEEK)/PB10(RESET)/PB14(RUN) active-LOW binary 미러; PB12/PB13=mega16 입력
    - PB13(PA7)=과부하 sense 입력(active HIGH), CTRL_OSC3 오라벨 정정
    - PB3 CON_OVLD=외부 릴레이 출력(active HIGH); heartbeat PB3->PB8 이전
    - ADC: PB0=출력세기(vestigial)/PB1=SAMD20 소비전류(ADC_OSC 오라벨 정정)
    - 부록 A(M_OVLD IPC 소멸)·부록 C(Q8b/Q11)·active-level·summary 정정
2026-06-20 docs(handoff): HANDOFF 재작성 — B-SEAM/overload 분석·설계 세션 결과
    - 확정: OSC 3채널 매핑·OVLD 로직·PB1=소비전류·overload 설계·pinmap 정정
    - 코딩 가능(B-SEAM 3채널/overload/6b 로직) vs HW 게이트(극성/F2/절대값) 구분
    - Failed Approaches: v001 단독신뢰/진폭 stub/패턴→OSC 가설 기각/핀라벨 혼동
    - I/O 매핑·OVLD asm·measure 오용 코드 컨텍스트 포함
2026-06-20 docs(pinmap): SAMD20→STM32 레거시 IO 대응표(부록 D) + PA0=FREQ_IN/PB4=CON_USOUT 정정
    - 부록 D 신설: SAMD20→STM32 IO 12쌍 대응표 (1차 소스 user_board.h + main.c 실사용 검증); 입력7/출력4 방향 정합 + PB00 이중역할(SW_EMSW/B_SEEK mode-dependent) 주의
    - PA0: US_PWM_OUT(초음파 PWM 출력) → FREQ_IN(출력 초음파 주파수 측정, TIM5_CH1 입력캡처); SAMD20 PB15/FREQ_IN(TC0 입력캡처) 흡수 — PWM 출력 아님
    - PB4: CON_UVOUT(UV 출력) → CON_USOUT(초음파 출력 게이트); SAMD20 PA09/B_USOUT(run/stop 연동) 흡수
    - 센서 2쌍 정식 포함: PA10→PA12(SENS_UP), PA11→PA11(SENS_DN)
    - 동기화: requirements(F2.2), fw_analysi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
2026-06-20 docs(spec): 물리 IO 레이어 설계 (OSC 발진단 제외) — 부록 D IO 구현 spec
    - 범위: 커넥터/패널 IO 전부 구현, OSC 발진 3채널+진폭 pot만 stub(B-SEAM)
    - 명령 흐름: 물리 버튼=US_REMOTE 통일 strict 중재 (US_IDLE 시작/source-matched 정지)
    - 5 슬라이스: A(GPIO infra+USOUT/SOL_DN/부저) B(FREQ_IN TIM5 IC) C(overload) D(물리명령+E-stop) E(weld 물리트리거)
    - 활성레벨 표(legacy+pinmap), PC11 EMSW/SEEK 이중역할(model_type 분기), heartbeat(PB3 dormant) 정리
    - 핵심결정: 부저 GPIO on/off, E-stop 안전정지+플래그, overload ×5 디바운스+seek-reset 복구 재사용
    - HW 확인 항목/검증 전략 명시 (슬라이스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
2026-06-20 docs(plan): 물리 IO 슬라이스 A (GPIO infra + 출력 미러) 구현 플랜
    - Task1 drivers/io(전 핀 config+헬퍼)+heartbeat(PB3) 제거 / Task2 부저 FSM TDD
    - Task3 부저 글루+슈퍼루프 / Task4 SOL_DN 배선 / Task5 USOUT hook / Task6 통합+리뷰
    - 전 핀 read/write 헬퍼 선구현(B~E 공유), 부저 host-test, 활성레벨 spec §2 반영
2026-06-28 docs(spec): I2C_POT 진폭 actuation 통합 설계
    set_pot(output_power %)/set_amp(raw DAC) 두 진폭 hook을 공용
    drivers/i2c_pot.c(i2c_pot_set_dac → i2c1_mem_write 0x28/0x00)로 통합.
    변환 pot_dac_from_power는 순수 함수(언더플로 가드 <=50→0, 상한 127)로
    host-test 신규 스위트, 실제 I2C write는 HW-gated. 부팅 초기 진폭 1회 포함
    (samd20 main.c:910 재현). legacy 12개 write 사이트 전수 매핑 근거 첨부.
2026-06-28 feat(amp): I2C_POT 진폭 actuation 통합 (set_pot/set_amp 실구동 + 부팅 초기값)
    진폭 hook 두 개(app_lcd_hook_set_pot=output_power%, app_weld_hook_set_amp
    =raw DAC)가 둘 다 로그 stub이던 것을 공용 드라이버 drivers/i2c_pot.c로 통합.
    - i2c_pot.h(HAL-free): pot_dac_from_power 순수 인라인(언더플로 가드 <=50→0,
    상한 127; 50~100은 samd20 (p-50)*255/100과 비트-동일) + i2c_pot_set_dac proto.
    - i2c_pot.c: i2c_pot_set_dac → i2c1_mem_write(0x28,0x00,&dac,1) best-effort
    (재시도/블로킹 없음, 실패는 i2c1_err_count 관측). samd20 i2c_adc_write_byte 재현.
    - set_pot: pot_dac_from_power 변환 후 set_dac. set_amp: raw DAC 그대로(doub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
2026-06-28 docs(spec): 직접 energy 런 종료 (에너지-도달 정상정지 + OVTIME fault) 설계 + #7 6b 하위항목
    samd20 energy 모드 직접런 종료 쌍 포팅 설계:
    - 순수 decision reg_energy_termination(app_reg_calc): energy 도달→정상정지 /
    미달+시간초과(limit_out_time*1000ms)→ERR_OVTIME fault. host-test(6b 독립).
    - 글루(app_reg_tick): energy 모드면 on-time ceiling 대체(legacy 충실).
    - fault 표면 = 기존 미공급 인프라 공급(lcd_measure_t.error_status→LCD_WARNING +
    MB_STATUS_OVTIME). 복구=키-클리어→app_reg RESET 라우팅(핵심 배선점).
    - ⚠ slice-D ceiling 이중화와 같은 종료 블록=머지 조정 필요.
    #7 ERR_OUTERR은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
2026-06-28 feat(reg): 직접 energy 런 종료 — 에너지-도달 정상정지 + OVTIME fault
    samd20 energy 모드 직접런 종료 쌍(main.c:5270-5294) 포팅:
    - 순수 reg_energy_termination(app_reg_calc, host-test 8케이스): energy 도달
    →STOP_ENERGY(우선) / 미달+elapsed>=limit_out_time*1000ms→FAULT_OVTIME /
    비-energy·limit_out_time=0→CONTINUE. 6b 독립(curr_energy 주입).
    - app_reg_tick(reg_run_limits_t 주입): energy 모드면 on-time ceiling 대체
    (legacy 충실); reg_stop_run helper로 자동정지 공통화. OVTIME→error_status
    |=ERR_OVTIME. START fault 가드(swallow consume 뒤 별도 break=advisor 패턴),
    RESET이 error_status 클리어. error_status를 lcd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
    [app.c, app_lcd.c, app_lcd.h, app_modbus.c, app_reg.c, app_reg.h, app_reg_calc.c, app_reg_calc.h]
2026-06-28 docs(handoff): 세션 마무리 — I2C_POT 진폭 actuation + OVTIME energy-run 종료 (mode-b)
2026-06-28 fix(reg): limit_out_time=0 → 즉시 OVTIME (never-stop 제거, legacy 충실)
    advisor 발견: energy 모드가 on-time ceiling을 대체하므로, reg_energy_termination의
    'limit_out_time!=0' 가드(0=off)가 limit_out_time=0일 때 never-stop 경로를 만듦
    (에너지-도달 미발생[벤치 curr_energy=0]+OVTIME off+ceiling else 도달불가). legacy
    us_on_time>=limit_out_time*10은 0에서 항상 참=즉시 OVTIME. 가드 제거로 충실 복원.
    host-test 2케이스 추가(0→즉시 OVTIME, 0이어도 STOP_ENERGY 우선). spec/HANDOFF 정정.
    0-warning, host 5스위트 PASS. config-validation 클램프(limit_out_time>0)는 slice4.
    [app_reg_calc.c, app_reg_calc.h, test_app_reg_calc.c]
2026-06-28 docs(resume): 2026-06-28 세션 — I2C_POT actuation + OVTIME energy-run (auto-load 갱신)
2026-06-28 docs: 2026-06-28 d HW 세션 — i2c-pot + ovtime 머지 완료 반영
    i2c-pot(tag hw-revA_fw-stage-i2c-pot) + ovtime(tag hw-revA_fw-stage-ovtime) 둘 다
    간이 벤치 mbpoll/정적-SWD 검증 PASS 후 --no-ff 머지. HANDOFF 2026-06-28 d 재작성,
    RESUME 세션 블록, changelog 엔트리. 남은 미머지 4(output-power-graph/physical-io a~d)는
    전부 6b/rig HW-gated.
2026-06-28 feat(board): OSC 3채널 PP→open-drain 전기설정 main 분리 승격
    OSC 출력 라인(PB2/PB10/PB14)을 GPIO_MODE_OUTPUT_PP→OUTPUT_OD로. PP에서
    RESET/SEEK 라인이 OSC보드와 전기 충돌(GAP=0)하던 것을 OD(idle hi-Z=외부 풀업
    HIGH=off)로 해소. 핀설정은 slice-d 8006e9c(HW 검증 완료)와 byte-identical —
    전기 설정만 main에 승격. heartbeat(PB3) PP 유지(dead, 호출처 0).
    배경: OD가 미머지 slice-d에만 있어 main 계열 브랜치 전환마다 board.c가 PP로
    '회귀'하던 반복 마찰 종료. board_osc4/boot-init FSM/PB12 입력 등 slice-d
    나머지(superset)는 패널 rig HW-gated로 미머지 유지.
    ⚠ divergence: main이 OD를 slic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
    [board.c]
2026-06-28 docs(handoff): 다음 작업 = slice-d 통합 검토 + OSC 명령 제어 미구현(B-SEAM) 발견 기록
    OSC 명령 제어(seek/reset/RUN→OSC 핀 구동)가 slice-d 포함 어느 브랜치에도
    미구현(app_seek_reset hook이 slice-d에서도 stub, board_reset/seek setter는
    boot-init 전용)임을 확인. slice-d 통합 ≠ OSC 제어 완성 — 실구동은 B-SEAM 별도.
2026-07-01 docs: 2026-07-02 전면 감사 결과 반영 — HANDOFF 재작성 + NEXT_STEPS §1.3 적용 결정 D0~D6 신설
2026-07-01 fix(lcd): dispatch에 data_len<3 가드 추가 — 노이즈 절단 프레임의 미초기화 data[1..2] 오용 차단 (감사 C1/D0)
    dgus_read_word(dgus_lcd.c)와 동일 가드 패턴. EMI로 깨진 짧은 0x83 프레임이
    KEY_MULTI START/DATA_SAVE/LV_* 경로로 흐르는 유일 CRITICAL 경로 차단.
    host 6스위트 PASS + 0-warning 빌드 확인.
    [app_lcd_input.c]
2026-07-01 fix(seek-reset): SR_TICKS 50→60 — 레거시 실거동 600ms/leg 충실화 (감사 D1)
    레거시 us_reset_cnt++ 후 > MAX_US_RESET_CNT(5), 0-시작 100ms 단위
    (ref/samd20/main.c:5388-5409, :118) = cnt 6 트립 = 600ms/leg.
    주석 명목 500ms가 아닌 코드 실거동에 충실. RESET dwell/RESET→SEEK/
    SEEK 해제 3구간 모두 적용. host 테스트 경계값 50→60 갱신(RED→GREEN),
    6스위트 PASS + 0-warning.
    [app_seek_reset_fsm.c, app_seek_reset_fsm.h, test_app_seek_reset_fsm.c]
2026-07-01 docs: D0+D1 완료 반영 — NEXT_STEPS §1.3 체크 + changelog 2026-07-02 항목
2026-07-02 docs(spec): fram-i2c-robustness(D3=H3+H2) 설계 — 읽기 status 전파+필드별 폴백+INIT_FLAG 실패 격리, init 1회 unstick, mon 표면
    사용자 확정: 경고=mon만 / unstick=init 1회 / write 무변경.
    핵심 설계: INIT_FLAG 읽기실패를 빈 FRAM과 구분 — factory-write 금지로
    일시 버스 오류의 FRAM 전체 덮어쓰기(데이터 손실) 경로 차단.
    host 게이트 = mock-fram link 치환 신규 스위트 test_app_config 6시나리오.
2026-07-02 docs(resume): 2026-07-02 b 세션 — D0+D1 완료 + D3 spec, 다음=D3 plan/구현
2026-07-02 docs(plan): fram-i2c-robustness(D3) 구현 계획 — Task 4개(H3 TDD mock-fram/H2 unstick/mon 표면/docs)
2026-07-02 feat(config): fram 읽기 status 전파 + 필드별 팩토리 폴백 + INIT_FLAG 실패 격리 (감사 H3/D3)
    fram_read_* → bool(addr,*out), 실패 시 *out 미기록. app_config_load는
    기본값 선적용 후 성공 필드만 덮어쓰고 실패 수 반환(0xFF=INIT_FLAG 읽기
    실패 = factory-write 금지 → 일시 버스 오류의 FRAM 전체 덮어쓰기 차단).
    host 신규 스위트 test_app_config(mock-fram) 6시나리오.
2026-07-02 feat(i2c1): init 1회 SCL 9클럭 bus-unstick + i2c1_unstick_events 관측 (감사 H2/D3)
    HAL init 전 GPIO 프리플라이트: SDA(PB7) stuck-low 감지 시 SCL(PB6) OD
    9클럭 토글 + STOP 생성. 결과 latch(0=깨끗/1..9=클럭수/0xFF=실패)는
    mon 부팅 로그가 소비(후속 커밋). 런타임 재시도 없음(사용자 확정).
    [i2c1.c, i2c1.h]
2026-07-02 feat(app): fram/i2c 관측 mon 표면 — 부팅 [cfg] fram_fail/unstick/i2c_err + 1s err 델타 (감사 D3)
    경고 표면 = mon 전용(사용자 확정). cfg_fail>0이면 WARN 줄(0xFF=ALL
    defaults/FRAM untouched 구분). 루프 1s cadence 델타 로그로
    i2c1_err_count 죽은-API 해소.
2026-07-02 docs: D3 fram-i2c-robustness CODE-COMPLETE 반영
2026-07-02 docs: D3 CODE-COMPLETE 세션 기록 + plan 델타 '모듈로 안전' 오류 주장 정정(최종 리뷰 권고)
2026-07-02 docs(handoff): 2026-07-02 c 세션 마감 — D0+D1 main 커밋 + D3 CODE-COMPLETE(미머지 HW-게이트), 다음=D3 HW 회귀→머지→D6→D5
2026-07-03 docs: D3 fram-i2c-robustness HW 회귀 PASS + 머지 반영 (tag hw-revA_fw-stage-fram-robust)
2026-07-03 docs(spec): eth-reapply(M7/D6) 설계 — LCD 저장→가동 중 W5500 즉시 반영 (dirty-flag+tick 재적용, sock0 reset, DHCP available 누락 수정)
2026-07-03 docs(plan): eth-reapply(M7/D6) 구현 계획 — Task 4개(LCD 트리거/sock0 reset/eth_reapply/docs)
2026-07-03 feat(lcd): ether/comm_mode 커밋 시 dirty 플래그 — mode-only 변경도 hook 발화 (M7 G4)
2026-07-03 feat(mb-tcp): app_modbus_tcp_reset — eth 재적용 시 sock0 강제 close (M7 F1)
2026-07-03 feat(eth): eth_reapply — LCD 저장 시 가동 중 netinfo/DHCP 재적용 + DHCP 분기 available 명시 (M7 G1-G3, F2)
2026-07-03 docs: D6 eth-reapply(M7) CODE-COMPLETE 반영
2026-07-03 docs+comment: 최종 리뷰 반영 — commit_comm_mode_and_ether 주석 STD-persist 사실 정정(M1) + HW 체크리스트 SERIAL→ETH mon 억제 노트
2026-07-03 docs(resume): 2026-07-04 b 세션 — D6 eth-reapply(M7) CODE-COMPLETE(미머지 HW-E2E 게이트), 다음=M7 HW E2E→머지→D5
2026-07-03 docs: D6 eth-reapply(M7) HW E2E PASS+머지 반영 — 감사 큐 D0~D6 종결, 잔여=D5
2026-07-03 docs(handoff): 2026-07-04 세션 마감 — 감사 큐 D0~D6 종결(D3+D6 머지·태그), 다음=D5 reconcile b→d→ch1; CLAUDE.md 진행 블록 최신화
2026-07-03 docs(spec): D5 reconcile 설계 — 3브랜치 스택 rebase b→d→ch1, app_reg_tick 4-way 통합
2026-07-03 docs(plan): D5 reconcile 구현 플랜 (7 Task) + spec §5.2 ceiling 정정(TOUCH 제외=slice-d 결정 채택)
2026-07-03 docs(plan): 물리 IO 슬라이스 B (FREQ_IN 주파수 측정) 구현 플랜
2026-07-03 feat(freq): 순수 FREQ_IN 측정 FSM + host-test (app_freq_fsm)
    - SAMD20 calc_freq 충실 포팅 (main.c:4141-4160): 10샘플 Δ 합 평균
    - CONST=960000000 (96MHz×10, 우리 보드 클럭에서 유도 — SAMD20 81e6 복사 아님)
    - 32-bit unsigned Δ (wrap 흡수), batch-seq 비교(무신호→0), div 가드
    - batch 완성 시 s_have_prev=0 리셋 (다음 캡처가 새 기준점 역할 — 연속 배치 정확도)
    - 슬라이스 B spec
2026-07-03 feat(freq): TIM5_CH1 입력캡처 드라이버(freq_ic) + ISR 배선
    - PA0 = TIM5_CH1 AF2 (GPIO_AF2_TIM5), 32-bit free-run rising 캡처 IT
    - htim5 핸들(periph) + TIM5_IRQHandler + HAL_TIM_IC_CaptureCallback → freq_fsm
    - NVIC prio 10 (sys_tick/comm 아래; 캡처 유실은 평균이 흡수)
    - main freq_ic_init() 배선
    - app_freq_fsm: benign-race 주석 (Task1 리뷰 MINOR-2)
2026-07-03 feat(freq): curr_freq/last_freq를 measure에 배선 (app_reg)
    - reg_publish_measure: g_measure.curr_freq = freq_fsm_compute(freq_cal_val)
    (run 게이팅 없음 — SAMD20 calc_freq 충실, 무신호면 FSM이 0)
    - last_freq 래치 2곳 = last_energy 패턴(max 아님; max_freq 없음)
    - freq_cal_val은 app_reg_tick에 주입(기존 limit_on_time 선례)
    - 표시(VAR_FREQ)·Modbus(MB_REG_DISP_FREQ) 미러는 기존 배선 재사용
2026-07-03 feat(io): 커넥터/패널 GPIO 인프라(drivers/io) + heartbeat(PB3) 제거
    - 전 커넥터 핀 config: 버튼/센서 active-LOW(pull-up), overload active-HIGH(pull-down), USOUT/OVLD/BUZZER active-HIGH, SOL_DN active-LOW
    - raw read + 폴라리티 적용 write 헬퍼(후속 슬라이스 공유)
    - PA0(FREQ_IN)은 슬라이스 B로 미룸; heartbeat dormant 제거해 PB3 해방
    - io.h는 프로젝트 컨벤션 따라 fw/include/ 배치(CMakeLists 무변경); main.c io_init() 배선; 슬라이스 A spec
    [board.c, board.h, io.c, io.h, main.c]
2026-07-03 feat(buzzer): 순수 timed-beep FSM + host-test (app_buzzer_fsm)
    [app_buzzer_fsm.c, app_buzzer_fsm.h, test_app_buzzer_fsm.c]
2026-07-03 feat(buzzer): app_buzzer 글루 + 슈퍼루프 10ms tick 배선
    [app.c, app_buzzer.c, app_buzzer.h, main.c]
2026-07-03 feat(io): SOL_DN(PB5) 실구동 배선 (app_weld_hook_sol_dn → io_sol_dn, active-LOW)
2026-07-03 feat(io): USOUT(PB4) run 연동 구동 (app_reg run-output 전이 hook → io_usout)
2026-07-03 fix(io): 최종 리뷰 정리 — board.c PB13 주석 명확화 + buzzer <10ms 클램프
    - board.c: PB13은 io.c가 OVLD 입력으로 설정(OSC 아님) 명시 — 후속 OSC 확장 시 오인 방지 (리뷰 M-1)
    - app_buzzer_beep_ms: 0<ms<10 을 최소 1 tick으로 클램프(10ms 미만 묵음 방지), ms=0 no-op 유지 (리뷰 M-2)
    [app_buzzer.c, board.c]
2026-07-03 docs(plan): 물리 IO 슬라이스 C (Overload 과부하 응답) 구현 플랜
2026-07-03 feat(overload): 순수 ×5 디바운스 FSM + host-test (app_overload_fsm)
    - M16 disasm 충실(@0x10A6): HIGH ×5 연속 → assert, LOW → count reset
    - active 레벨 + assert/deassert 1-shot edge 비트마스크
    - 슬라이스 C spec
    [app_overload_fsm.c, app_overload_fsm.h, test_app_overload_fsm.c]
2026-07-03 feat(overload): app_lcd_set_overload 접근자 (ERR_OVLD/ICON_OL/페이지)
    - on: ERR_OVLD|= + ICON_OL=1 + LCD_WARNING (show_error)
    - off: ERR_OVLD&=~ + ICON_OL=0 + 런 페이지 복귀 (RESET-키 패턴 재사용)
    - ERR_OVLD 비트만 조작(weld OVTIME 보존, advisor)
    [app_lcd.h, app_lcd_input.c]
2026-07-03 feat(overload): app_overload 글루 + force-stop/릴레이/부저/자동복구 배선
    - assert: force-stop(현재 소스 RUN_RELEASE) + 릴레이 ON + 에러 + 부저
    - active: 부저 점멸(250/250), 릴레이/에러 유지
    - deassert: 릴레이 OFF + 에러 클리어 + 자동 seek_reset_request(RESET) (M16 흡수)
    - app.c tick = weld와 seek_reset 사이 / main app_overload_init()
    [app.c, app_overload.c, app_overload.h, main.c]
2026-07-03 feat(overload): app_reg START guard에 과부하 차단 추가
    - 과부하 활성 중 START 무시 (SAMD20 SYS_ERROR 게이트 재현)
    - seek_reset_active와 동일 직교 패턴 (별도 break, swallow 대칭 보존)
2026-07-03 feat(overload): Modbus STATUS OVLD 비트 (MB_STATUS_OVLD=0x04)
2026-07-03 docs(overload): STATUS 비트 주석 OVLD 배선 반영 (comment-rot 정리)
    - app_modbus.c/app_modbus_core.h 주석이 "OVLD stay 0"이라 Task5 배선과 모순
    - OVLD는 이제 app_overload_active()로 set, ESTOP/OVTIME/OUTERR만 deferred
    - 코드 거동 무변경 (주석만), 매크로/레지스터 레이아웃 불변 (계약 비변경)
2026-07-03 docs(overload): force-stop 주석 1-iter stale 레이스 정직화
    - app_reg_measure() us_run_status는 app_reg_tick 발행 미러(overload_tick보다 lag)
    - "항상 발화"는 steady-state 한정 — assert와 동일 10ms iter START는 즉시 정지 놓침
    (edge-only, ceiling ~560ms bounded); io_ovld_relay는 무조건이라 릴레이 컷오프 무관
    - 최종 통합 cpp-reviewer Minor 1 + advisor (코드 거동 무변경, 주석만)
2026-07-03 fix(overload): force-stop을 active 레벨 재시도로 — 1-iter stale 레이스 차단
    - PB3 릴레이는 dry-contact 상태신호일 뿐 초음파 미제어(사용자 HW 확정)
    → 펌웨어 정지가 load-bearing
    - force-stop을 assert edge → active 레벨(매 tick)로 이동: assert와 같은 10ms
    iter에 들어온 START는 stale 미러로 즉시정지를 놓쳐도 다음 tick에 잡힘(≤10ms)
    - idempotent(IDLE 후 src=IDLE no-op, active 중 START는 guard 차단)
    - assert 블록은 릴레이/에러/부저/점멸타이머 1-shot만 유지
    - 최종 통합 cpp-reviewer Minor1 + advisor 후보 fix (게이팅 질문 HW 확정 후 적용)
    [app_overload.c]
2026-07-03 docs(overload): 단발 1-tick transient 잔여 엣지 주석 (benign, de-assert hardening=follow-up)
    - active-level 재시도는 지속성 과부하 레이스를 ≤10ms로 차단
    - 5번째 HIGH 직후 바로 LOW되는 단발 transient는 재시도 기회 없으나 fault 소멸=benign
    - 완전 차단(de-assert force-stop)은 follow-up — cpp-reviewer Minor
2026-07-03 fix(overload): de-assert force-stop hardening — 단발 1-tick transient 잔여 차단
    - active-level 재시도가 못 잡는 단발 1-tick transition(5th HIGH→바로 LOW)에서
    같은-iter START로 escaped된 run을 de-assert 블록에서 잡음(미러 fresh)
    - idempotent: 지속성 과부하에선 이미 IDLE이라 no-op
    - → 모든 overload episode가 run을 남기지 않음 (레이스 완전 차단)
    - 사용자 요청 hardening (cpp-reviewer Minor2)
    [app_overload.c]
2026-07-03 docs(plan): 슬라이스 C 플랜 전 Task done 체크 + 완료 상태 배너
    - 33개 Step 체크박스 [x] 처리 (Task1~6 전부 구현+리뷰 완료)
    - 상단 STATUS 배너: 커밋 매핑 + 플랜 외 레이스 fix 2건(44d64f9/0bf084c)
2026-07-03 docs(spec): 물리 IO 슬라이스 D 설계 — 물리 명령 입력 + E-stop
    - B_START/B_RESET/PC11(EMSW|SEEK) → US_REMOTE 통일 strict 디스패치
    - E-stop = 레벨-추종(레거시 main.c:1409-1425 충실, 사용자 확정) — 래치 아님
    - 단일 app_input(접근법 1), 신규 io 함수 0개(슬라이스 A 소비)
    - app_reg 편집 2곳: START guard estop break + ceiling US_REMOTE 추가
    - 브랜치 slice C 위 스택, 머지 A→B→C→D, HW 게이트 상속
2026-07-03 docs(plan): 물리 IO 슬라이스 D 구현 플랜 (5 Task, TDD)
    - Task1 순수 app_input_fsm + host-test 8 / Task2 글루+배선 / Task3 app_reg
    guard+ceiling / Task4 Modbus STATUS ESTOP / Task5 통합+cpp-review
    - 신규 io 0개(슬라이스 A 소비), E-stop 레벨추종(force-stop active 재시도)
2026-07-03 feat(input): 순수 물리 입력 FSM + host-test (app_input_fsm)
2026-07-03 feat(input): app_input 글루 + 배선 (US_REMOTE 디스패치 + E-stop force-stop)
2026-07-03 feat(reg): START guard에 E-stop break + on-time ceiling에 US_REMOTE 추가
2026-07-03 feat(modbus): STATUS ESTOP 비트 (MB_STATUS_ESTOP=0x02, 슬라이스 D)
2026-07-03 test(input): 모드전환 stale-edge host 테스트 (최종리뷰 M1)
2026-07-03 feat(reg): on-time ceiling 이중화 — 절대 30s 안전(전모드)+legacy limit_on_time(hand 전용)
    - 신규 ON_TIME_SAFETY_MS=30000: TOUCH/COMM/REMOTE/CYCLE 전 모드 무조건, limit_on_time 독립, 폭주 백스톱
    - limit_on_time ceiling → legacy 충실(main.c:5296): COMM/REMOTE+hand(model_type==0) 전용, TOUCH/multi/std 제외
    - app_reg_tick에 model_type 주입(app.c), reg_run_stop_latch 헬퍼로 정지 중복 제거
    - 보드 검증: 임시 3s로 multi Modbus런 ~2.7s 지속후 정지(560ms 아님)=양쪽 입증
2026-07-03 docs(spec): on-time ceiling 이중화 cpp-review Minor 반영 (≤2ms 비활성·게이트기준·TOUCH-in-hand)
2026-07-03 feat(osc): OSC 보드 부팅 초기화 + PB12 피드백 입력 + 3채널 open-drain
    전원 투입 시 OSC보드 자가초기화(자체 초음파 ~600ms)를 STM32가 PB12로
    H→L 감지한 뒤 RESET/SEEK 펄스로 초기화를 완료하는 부팅 시퀀스 추가.
    - app_osc_init_fsm (순수 FSM, host-test) + app_osc_init 글루: PB12 H→L
    감지 → 150ms GAP → RESET(PB10) 40ms → SEEK(PB2) 20ms. 이벤트 기반 +
    타임아웃 폴백(WAIT_H/L 90tick), WAIT_H 2샘플 디바운스.
    - 부팅 블로킹 run_to_done: app_init(LCD, dgus_wait_ready+1s logo dwell)이
    PB12 펄스 윈도우를 덮어 이벤트 감지가 죽던 문제를, OSC init을 app_init
    전에 완주시켜 해소. sy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
    [app.c, app_osc_init.c, app_osc_init.h, app_osc_init_fsm.c, app_osc_init_fsm.h, app_reg.c, board.c, board.h]
2026-07-03 docs(spec): 출력파워 그래프 ch1(소비전류) 소스 전환 설계
    표시 경로(curr_amp/power/energy)만 ch0→ch1 분리, SAMD20 cal_real_val
    ADC_CURR 변환식 순수함수 포팅(×4/10+cal→데드밴드→×2.2). 레귤레이션
    ch0 불변, 표시 소비측 무수정. host-test까지(절대보정·머지 6b 이연).
2026-07-03 docs(plan): 출력파워 그래프 ch1 소스 전환 구현 플랜
    Task1 순수 변환함수(reg_current_from_adc/reg_power_from_amp)+host-test,
    Task2 글루(cal_val 주입+reg_publish_measure ch1 repoint+피크홀드 보정).
    spec 전 절 커버, 순환의존 회피(app.c 배선).
2026-07-03 feat(reg): ch1 표시 전류/전력 순수 변환함수 + host-test
    reg_current_from_adc(ch1_avg,cal_val): SAMD20 cal_real_val ADC_CURR
    (×4/10+cal→데드밴드51/오프셋37) 포팅, int32+가드로 음수 cal 언더플로 0.
    reg_power_from_amp: ×2.2. 상수는 6b 보정 대상 named #define.
2026-07-03 feat(reg): 출력파워 그래프 표시값을 ch1(소비전류)로 분리
    reg_publish_measure가 표시 curr_amp/curr_power(+피크홀드)를 ch1_avg+cal_val의
    reg_current_from_adc/reg_power_from_amp에서 산출(레귤레이션 ch0 불변).
    app_reg_tick(limit_on_time,cal_val)로 cal_val 주입, app.c 배선.
    에너지 누산은 curr_power 추종으로 자동. 머지/절대보정 6b 이연.
2026-07-03 docs(spec): 교차영향 노트 — ch1 repoint가 weld 에너지 종료 입력도 이동
    최종 whole-branch 리뷰 발견: curr_power→acc_energy→curr_energy를 weld FSM이
    소비하므로 범위=표시 소스+에너지 누산값(누산 메커니즘 불변, 입력만 ch1).
    SAMD20 충실·벤치 휴면·6b 이연. 머지 노트 명기 조건.
2026-07-04 docs: D5 reconcile 완료 — 3브랜치 main 위 스택 재구축(b'→d'→ch1'), 머지/태그=HW 게이트, 감사 큐 D0~D6 전항목 종결
2026-07-04 docs(spec): weld 슬라이스4 설계 — 양손 트리거+TRIGGER 모드+안전 abort+진입 게이팅(deviation)+D2 클램프 M1~M4, D4/H1 선결
2026-07-04 docs(plan): weld 슬라이스4 구현 플랜 (10 Task, TDD) + spec 보강 — SETUP 게이트 이연분 편입·start_allowed swallow 제외 정정
2026-07-04 docs(handoff): 2026-07-04 e 세션 마감 — weld 슬라이스4 spec+plan 완료(브랜치 stage-weld-slice4-trigger), 다음=새 세션 subagent-driven 실행
2026-07-04 fix(weld): H1 근본수정 — WELD 모드 래치(CYL1 전이 시점)+전이 카운터 리셋 (감사 D4)
    [app_weld_fsm.c, test_app_weld_fsm.c]
2026-07-04 feat(weld): FSM abort 입력 — 임의 상태 SOL OFF+READY 복귀, WELD면 US 정지 엣지 (spec §3.4)
2026-07-04 feat(weld): TRIGGER 모드 — dn/up 엣지 래치·trigger_time2/3·CYL2 즉시 exit·run_mode 사이클 래치 (spec §3.2/§3.3)
2026-07-04 test(weld): TRIGGER 풀 사이클 테스트에 hold_steps 검증 추가 (unused-var 경고 해소)
2026-07-04 fix(weld): M1 — limit_energy=0을 에너지-도달 체크 off로 (즉시 무증상 완료 차단, 감사 D2)
    [app_reg_calc.c, app_weld_fsm.c, test_app_reg_calc.c, test_app_weld_fsm.c]
2026-07-04 feat(weld): 순수 트리거 FSM 신설 — 양손 start/in_cycle 재장전/safety abort/센서 엣지 + host 스위트 (spec §2)
2026-07-04 feat(reg): app_reg_start_allowed() 쿼리 신설 + START guard 4-break 공용화 (slice4 게이팅, spec §4.3)
2026-07-04 feat(weld): 글루 배선 — 물리 트리거 스캔+진입 게이팅+abort 합성+SETUP 게이트+tick 드리프트 무누적 (spec §4)
2026-07-04 docs(weld): SETUP 게이트 동결 거동 주석 정정 — overload는 SOL 미해제(US만 독립 정지), E-stop만 독립 SOL OFF (리뷰 반영)
2026-07-04 fix(lcd): M4 — LV_* 필드군 Modbus-동일 클램프+에코 (LOW-1 OUT_POWER 포함, 감사 D2)
    [app_lcd_input.c, cfg_clamp.h, test_app_config.c]
2026-07-04 fix(config): M3 — FRAM 로드 comm speed/parity idx OOB를 factory로 클램프 + 상한 매크로 공용 승격 (감사 D2)
    [app_config.c, app_config.h, app_lcd_input.c, test_app_config.c]
2026-07-04 fix(config): I-1 — output_power FRAM 로드 [50,100] 클램프 (weld_amplitude 언더플로 가드, 최종 리뷰 반영)
    [app_config.c, test_app_config.c]
2026-07-04 docs: weld 슬라이스4 CODE-COMPLETE — 감사 D2/D4 종결, 머지/태그=스택 HW 게이트
2026-07-04 docs(handoff): 2026-07-04 g 세션 마감 — D5 스택 HW 검증+전단위 머지(b'/d'/ch1'/slice4, 태그 4개), 잔여=weld 사이클 E2E 배선 게이트
2026-07-04 docs: CLAUDE.md 진행 블록 최신화 (2026-07-04 g — 스택 전단위 머지, 미머지 없음)
2026-07-05 docs(handoff): 2026-07-05 세션 마감 — HMI SP1 구현 완료(별도 repo, Task 8 E2E 벤치 게이트), B-SEAM 준비사항 정리, M6/M8/M9 트리거 발화
2026-07-05 docs(spec): 디지털 OSC 제너레이터 신규 프로젝트 설계 (2026-07-05 브레인스토밍 승인분)
2026-07-05 fix(lcd): TRIGGER 모드 SENSOR ON/OFF 동적 갱신 포팅 누락
    legacy check_remote_input(ref/samd20/main.c:1230-1265)의 SENSE_DN 레벨
    변화 LCD 텍스트 부수효과가 slice4 트리거 FSM 흡수 시 누락 — 페이지 진입
    초기값("SENSOR OFF")만 있고 동적 갱신 없음 (weld E2E 벤치에서 발견).
    - app_lcd_render.c: app_lcd_weld_sensor_text() 신설 (byte-count legacy 동일)
    - app_weld.c: 글루 s_sens_dn_bak 레벨 미러 (bak 갱신은 모드 무관, SETUP 중 동결)
    - cpp-reviewer APPROVE-WITH-COMMENTS (0 Crit/High/Med; LOW=run_mode 게이트
    컨벤션은 FSM과 일치하는 != 0 유지)
    [app_lcd.h, app_lcd_render.c, app_weld.c]
2026-07-05 fix(lcd): E-stop 경고 페이지 표시 포팅 누락 + 런페이지 복귀 공용 가드
    weld E2E 벤치 발견: EMSW E-stop이 기능(SOL/US 차단)은 동작하나 LCD 무표시.
    legacy do_control(main.c:4209-4241)의 SYS_ESTOP 전이 표시를 포팅:
    - app_lcd_set_estop(bool): enter=VP "E-STOP"+LCD_WARNING / release=런 복귀
    - app_weld_abort_now(): E-stop 진입 엣지 페이지-무관 즉시 weld abort —
    WARNING 전환이 run-page 게이트로 weld tick을 동결시켜 abort 미처리→
    해제 후 유령 사이클 재개되는 레이스 차단 (legacy 1409-1425 등가)
    - app_input: enter/release 엣지 배선
    - [리뷰 HIGH 반영] lcd_may_restore_run_page() 공용 가드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
    [app_input.c, app_lcd.h, app_lcd_input.c, app_weld.c, app_weld.h]
2026-07-05 fix(lcd,input): E-stop 부저 점멸 + overload 아이콘-only 표시 (legacy 충실)
    벤치 실장비 거동 대조 2건:
    - E-stop 부저: legacy SYS_ESTOP 부저 점멸(main.c:2125-2136) 미포팅 —
    app_input estop 활성 중 250/500ms one-shot 재-arm (app_overload 패턴)
    - overload 표시: legacy do_control(4218-4227)은 OVLD/OUTERR=VP 텍스트+
    아이콘만, LCD_WARNING 전환은 OVTIME 전용(4229-4233) — set_overload의
    show_error(페이지 전환) 호출은 slice-c 포팅 편차. 아이콘-only로 정정,
    복귀 가드에서 overload 제거(페이지 비점유), deassert 복귀는 WARNING
    표시 중일 때만(아이콘-only화로 생긴 setup 페이지 납치 방지)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
    [app_input.c, app_lcd_input.c]
2026-07-05 feat(seek-reset): RESET/SEEK 물리 OSC 라인 구동 — hook stub 해제
    사용자 벤치 요청(2026-07-05). board_reset(PB10)/board_seek(PB2) 레벨
    미러 배선 — 근거: ① HANDOFF B-SEAM 표의 3채널 매핑/극성(active-LOW OD)
    = '확정, 측정 게이트 아님' ② legacy do_control(main.c:4245-4280)이
    sig 상태 엣지에 M_RESET/M_SEEK 레벨 미러만 수행(스윕 생성 코드 없음 =
    스윕 주체는 OSC 보드) ③ boot-init이 동일 라인을 이미 부팅 펄스 구동.
    1-iter stale run_active 재검토 주석 갱신(동일-iter 동시조작 창만 잔존,
    수용). 파형/스윕 정밀 관측은 B-SEAM 스코프 세션 유지.
    0-warning, host 9스위트 PASS. HW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
    [app_seek_reset.c]
2026-07-05 feat(clock): SYSCLK 소스 HSI→HSE(16MHz X-tal) 전환 + HSI 폴백
    벤치 발견(2026-07-05): HSI 실측 +1.39% 편차가 FREQ_IN 표시 underread
    (-479Hz, 스코프 34.98kHz 대조)와 전 타이밍 -1.3%의 단일 원인. 보드에
    16MHz 크리스탈 실장 확인(사용자) → PLL 체인 동일(16MHz/M8×N96/P2=96MHz),
    소스만 HSE로 교체. HSE 기동 실패 시 HSI 폴백(부팅 불능 방지, 진단 플래그
    s_clk_hsi_fallback SWD read). HSE_VALUE=16MHz는 CMake 주입(vendor 무편집).
    HW 검증: RCC 레지스터 확증(PLLSRC=HSE/SWS=PLL/폴백=0) + 런 중 curr_freq
    34984Hz = 스코프 34980Hz(0.01%, freq_cal_val=0) + LCD 34.9 표시.
    0-warning. freq_cal_val 보정 불필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
2026-07-05 feat(reg): 소비전류 표시 실동작 — ch1 도메인 정합 + rig-fit gain + EMA + 피크/유지 표시
    벤치 실측 체인(2026-07-05, 실 혼 rig + 전류계/스코프)으로 전류/W/에너지
    표시 0 문제 해소. PB1(ADC_CURR) 신호 자체는 정상 도달(600mA→~15mV 초소신호)
    — 문제는 스케일 3중 불일치였음:
    - app_reg acquire: ch1을 raw 12-bit 누산→×6으로 legacy ADC 도메인 정합
    (SAMD20 = 2.23V ref + 4×누산 = 카운트/V ×5.92; 구 >>2 10-bit 경로는
    1카운트≈128mA로 해상도 불능) + EMA α=1/8·50ms(τ≈400ms) 표시 안정화
    - app_reg_calc: GAIN 4/10 → 7/5 rig-fit (legacy 관례의 보드 실측 맞춤 자리 —
    앵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
2026-07-05 docs(handoff): 2026-07-05 b 세션 마감 — weld 사이클 E2E 전항목 PASS + 벤치 수정 6커밋
    changelog/NEXT_STEPS/HANDOFF/RESUME/pinmap/CLAUDE.md 갱신:
    - weld §7.3 전항목 종결(풀배선 벤치) + EMSW 해제-추종 이월 종결
    - 벤치 수정 6커밋 기록(SENSOR/E-stop LCD·부저/overload 아이콘/seek-reset
    구동[스윕 주체=보드측]/클럭 HSE/전류 표시), 전건 cpp-review 통과
    - 3d2f414 리뷰 MEDIUM(EMA↔에너지 적분) = 6b 디커플링 명시 이연
    - pinmap SYSCLK=HSE·PB1 실측 노트, 보드 잔재 설정=NEXT_STEPS §2.3-a
    - push 미실행(사람 터미널)
2026-07-05 feat(reg,lcd,mb): SEEK/RESET 중 측정값 라이브 표시 — us_on_status 게이트 복원
    RESET/SEEK 동작 중 LCD VAR_*/Modbus DISP_*가 이전 런 last_* stale 값을
    표시하던 문제 수정. legacy(samd20)는 RESET/SEEK on-엣지에 us_on_status=ON
    으로 표시를 라이브 전환(main.c:4253/4280)하는데 포트가 us_run_status(RUN
    전용)로 collapse해 SEEK 스윕 주파수/전류가 안 보였음.
    - lcd_measure_t.us_on_status 복원 = run OR app_seek_reset_active()
    - app_reg 엣지 검출: on-엣지 max/energy 제로화(4253-4256/4280-4282),
    off-엣지 last_* = curr_* 스냅샷 래치(4263-4268/4288-4293)
    - 피크 추적/curr_power 게이트 active→live 확장; 에너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
    [app_lcd.h, app_lcd_disp.c, app_modbus.c, app_reg.c]
2026-07-05 docs(changelog): seek/reset 라이브 표시 벤치 육안 4항목 PASS 기록
2026-07-05 fix(reg): 표시 전류 전달함수 재정의 — RUN 실측 재앵커 + legacy −37 오프셋 제거
    전일 rig-fit(7/5·−37)이 RUN 정착 상태에서 표시 1.4A/전류계 0.6A로 판명.
    SWD 진단(cal_val=1, 유휴 ch1=29=전일 동일)으로 신호 경로 이상 배제 —
    전일 앵커(ch1≈65)는 EMA τ400ms 미정착 오측. RUN 정착 실측
    (600mA↔ch1≈126) 재앵커 + 사용자 결정으로 −37 오프셋 제거(순수 비례).
    - GAIN 7/5 → 59/126 (126×59/126=59 정확 +cal(보드 1)=60 → 0.60A 앵커)
    - OFFSET 37 → 0 (legacy 'temp_val−37' 제거)
    - DEADBAND 51 → 20 (구 51은 −37 도메인; 신 20=유휴 v=13+마진,
    표시 플로어 ≈0.21A)
    - 중간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
    [app_reg_calc.c, test_app_reg_calc.c]
2026-07-05 docs(changelog): overload 실동작 E2E 벤치 PASS 기록 (코드 무변경)
2026-07-05 docs(spec): modbus-tcp-hardening(M6/M8/M9)+RS-485 첫-write 조사 설계 — 워커/논블로킹/하강엣지 정리, HW E2E 게이트
2026-07-05 docs(plan): modbus-tcp-hardening 구현 plan 4-Task + spec 정제(peek 경계=build와 일치, 코얼레스드 단일 send 근거)
2026-07-05 feat(mbtcp): M6 순수 프레임 워커 mb_tcp_frame_peek + host 테스트 (spec §2.1)
2026-07-05 feat(mbtcp): M6 누적+워커+코얼레스드 send / M9 SF_IO_NONBLOCK+CLOSE_WAIT 벨트 / M8 tcp_active 하강 엣지 소켓 정리
2026-07-05 docs(research): RS-485 첫-write 간헐 무효 코드 조사 — 가설 판정 + 벤치 재현 절차 (spec §2.4)
2026-07-05 fix(mbtcp): 워커 FC06 후 즉시 종료 — coalesced 다중 write의 apply 체인 굶김(silent loss) 차단 (whole-branch review HIGH)
    [app_modbus_tcp.c]
2026-07-05 docs(spec,plan): FC06 워크-종료 의미론 반영 + coalesced-FC06 E2E 회귀 추가 (whole-branch review HIGH)
2026-07-05 docs(spec): E2E에 [FC06][FC03] 같은-세그먼트 지연-정합 케이스 추가 (재리뷰 이월 노트)
2026-07-05 fix(mbtcp): vendored recv() 논블로킹 순서-뒤집힘 우회 — recv 구간만 ctlsocket 블로킹 토글 (HW E2E 전면 무응답 근본원인)
    [app_modbus_tcp.c]
2026-07-05 fix(mbtcp): W5500 auto keep-alive(10s)로 stale-ESTABLISHED 자가치유 — 케이블 분리 후 단일소켓 락아웃 해소 (HW E2E M9 발견, 선재 결함)
    [app_modbus_tcp.c]
2026-07-05 docs(changelog): modbus-tcp-hardening HW E2E PASS + 머지·태그 기록
2026-07-05 docs(handoff): 2026-07-06 세션 마감 — mbtcp-hardening MERGED(감사 큐 완전 소진) + seek/reset 라이브 표시 + 전류 전달함수 재정의 + overload E2E 종결
    HANDOFF/RESUME/NEXT_STEPS/CLAUDE.md 갱신:
    - 감사 D6 잔존 M6/M8/M9 종결(tag hw-revA_fw-stage-mbtcp-hardening),
    vendored recv() NONBLOCK 함정·KA 자가치유·RS-485 조사 보고 기록
    - seek/reset us_on_status 복원(벤치 4항목)·전류 GAIN 59/126+오프셋 제거
    (0.60A 최종 벤치 확인 미기록 = 다음 벤치 첫 항목)·overload 이월 소진
    - 사용자 신규 백로그 3건 등록(부팅 딜레이 터치 에러/REMOTE icon/
    전류 필터 ×2 — 상세는 작업 시작 시 설명 예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
2026-07-08 fix(lcd): V30 RUN data=0 매핑을 물리 토글로 교체 — 부팅 딜레이 터치 유령 런 해소
    런-상태 기반 매핑은 app_reg가 START를 조용히 거부하는 모든 창구(부팅
    워밍업 ~4s / seek-reset 체인 / E-stop·overload·fault / 동일-드레인 연속
    프레임)에서 press/release 페어링이 반전됨 — 물리 release가 START로
    재매핑되어 쥐지 않은 런 시작(30s 안전캡 전까지 지속), 이후 탭마다
    정지→재시작이라 "터치 무시+계속 출력, 전원사이클 필요"로 관측(사용자
    보고 2026-07-08, 신규 3건 중 #1).
    data=0은 물리 엣지당 정확히 1회(2026-06-08 HW 트레이스)이므로
    s_run_key_down 토글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
    [app_lcd_input.c]
2026-07-08 feat(lcd): REMOTE icon — Modbus 원격제어 활동 표시 (Stage C 이연분 공급)
    samd20 DISP_REMOTE/modbus_status(case 9, main.c:5187-5199) 포팅: 유효
    Modbus 요청이 디코드되는 동안 REMOTE icon(VP 0x120e) ON, 마지막 요청
    후 1s(legacy modbus_comm_cnt>100 ≈ 1s 등가)에 OFF (사용자 요청
    2026-07-08, 신규 3건 중 #2).
    app_modbus에 note_remote()/remote_active() 활동 타임스탬프(랩-세이프
    tick 델타 + boot seen 가드), 스탬프 지점 = RTU mb_core_decode 성공 +
    TCP mb_tcp_build_response 성공(두 전송로 공용·프로토콜 무영향).
    LCD disp는 ICON_RUN과 동일한 write-on-change 엣지 패턴.
    cpp-review APPROVE(0 Crit/High; LOW 2=I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
2026-07-08 feat(reg): ch1 표시 EMA 반응 τ≈400ms→≈100ms (α 1/8→1/2)
    전류 표시 업데이트 반응을 ~100ms로 (사용자 요청 2026-07-08, 신규 3건
    중 #3 "업데이트 주기 100mS"). 50ms 커밋 주기 유지, α만 1/8→1/2 —
    스텝 75%@100ms/97%@250ms. 스파이크 억제는 약해짐(50샘플 평균이 1차
    방어). GAIN/OFFSET/DEADBAND 무변경.
    ⚠ 에너지 적분이 EMA 통과 curr_power를 누산하는 기존 커플링(6b
    디커플링 이연)은 구조 무변경 — α 증가는 적분 지연을 줄여 legacy
    무필터에 근접하나, weld energy-exit/OVTIME 타이밍 실거동 재확인을
    다음 벤치 항목에 포함(리뷰 MEDIUM).
    cpp-review APPROVE-WITH-COM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
2026-07-08 docs(handoff): 2026-07-08 세션 마감 — 사용자 신규 3건 코드-완료(부팅 터치 유령 런 fix + REMOTE icon + 전류 EMA 100ms), HW 벤치 게이트
    HANDOFF.md 재작성(Failed Approaches=reg arm-swallow-on-reject 폐기 근거
    포함) + RESUME 상태 블록 + NEXT_STEPS §2.2/§2.3-a/헤더 + CLAUDE.md
    진행 블록 + changelog. 보드 미플래시 — 벤치 체크리스트는 HANDOFF
    §Resume. push 미실행(main + 이월 태그).
2026-07-11 fix(lcd): 원격 RESET fault 클리어 시 경고 페이지 고착 해소 — nonzero→0 엣지 복귀
    Modbus/물리 RESET이 OVTIME fault를 클리어하면 미러가 state->error_status를
    0으로 만들지만 페이지 복귀가 없어 LCD_WARNING에 고착, 이후 화면 RESET 터치도
    ERR_OVTIME 게이트(이미 0)에 막혀 no-op (2026-07-11 벤치 실증: Modbus RESET 후
    화면 복귀 불가). legacy samd20은 각 RESET 핸들러가 직접 런 페이지 복귀
    (main.c:4356-4370/4605-4617) — 포팅에서 누락된 side effect.
    수정: app_lcd_fault_cleared() 신설, app_lcd_tick 미러의 error_status
    nonzero→0 엣지에서 호출. lcd_status==LCD_WARNING일 때만 복귀(임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
    [app_lcd.c, app_lcd.h, app_lcd_input.c]
2026-07-11 fix(lcd): show_error에 lcd_status=LCD_WARNING 스탬프 누락 보완
    app_lcd_show_error()가 물리 페이지만 전환(dgus_set_page)하고 state->lcd_status를
    갱신하지 않아, OVTIME 경고 표시 중에도 state는 런 페이지로 남음 → 직전 커밋
    83498e7의 app_lcd_fault_cleared() 및 기존 복귀 경로들의 lcd_status==LCD_WARNING
    게이트가 전부 조기 리턴 (2026-07-11 벤치 실증: Modbus RESET 후에도 화면 고착
    지속). legacy samd20은 lcd_status = LCD_WARNING; set_lcd_page(lcd_status);
    쌍으로 스탬프 (main.c:4232-4233) — 포팅 누락.
    부수 교정: app_lcd_in_run_page()(weld SETUP-freeze 게이트)가 OVTIME 경고
    표시 중 1을 반환하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
    [app_lcd_disp.c]
2026-07-11 docs(handoff): 2026-07-11 세션 마감 — FW 벤치 2건+α HW PASS + OVTIME 경고화면 복귀 fix 2건 검증, 다음=HMI Task 8
2026-07-18 feat(reg): 표시 데드밴드 20→14 — legacy 실효 게이트(최소 표시 0.15A) 복원
    사용자 요청 2026-07-18: 표시 게이팅을 0.15A로. legacy samd20
    cal_real_val(main.c:420)의 'temp_val > 51 ... −37'은 표시 도메인
    게이트 14 = 최소 표시 0.15A였고(주석 'OFFSET 15mA'), 2026-07-05
    재앵커 때 채택한 20(플로어 0.21A)이 legacy보다 높았던 것 — 복원.
    - REG_CURR_DEADBAND 20→14 (app_reg_calc.c, 블록 주석 정합 포함)
    - host 벡터 경계 갱신: v=14→0 / v=15→0.15A 최소 표시 / v=20 대역
    활성화 / 음수 cal 경계 −5→−7 재조정
    - 바 게이트(>10)는 legacy 동일 무변경 — 데드밴드가 상류 지배,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
2026-07-18 fix(input): 물리 입력 bak zero-init(legacy 충실) — 부팅 유령 SEEK 스윕 해소
    사용자 보고 2026-07-18: 부팅 리셋-시크 1회 후 SEEK가 한 번 더 돎.
    근본원인(HW 실측 GPIOC_IDR bit11=0): 벤치 리그는 PC11에 EMSW NC
    배선(평시 LOW), 보드 잔재 model_type=multi(1)이라 PC11=SEEK 역할
    (active-LOW) → input_fsm_init의 s_seek_bak=1(유휴 가정)이 부팅 첫
    tick에 1≠0 유령 seek_press → 앱 SEEK 체인 600ms = 추가 스윕 1회.
    legacy는 이 유령이 없음: re_*_bak 전역 zero-init(BSS, main.c:490)
    = '눌림 가정'이라 평시-LOW 핀은 엣지 자체가 안 생김. 유휴(1) 초기화가
    오히려 legacy 이탈이었음 — start/r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
    [app_input.c, app_input_fsm.c, test_app_input_fsm.c]
2026-07-18 feat(buzzer): 부팅 완료 1회 beep 100ms
    사용자 요청 2026-07-18. legacy 부재 확인(samd20 부저 호출부 전수 8곳:
    boot는 buzzer_off뿐 + SYS_ERROR/E-stop 점멸, M16 부저 핀 없음, DGUS
    패널 자체 beep 아님) — 포팅 누락이 아닌 신규 기능.
    app_buzzer_init 직후 app_buzzer_beep_ms(BOOT_BEEP_MS=100) 1-shot —
    비블로킹 큐, 슈퍼루프 첫 app_buzzer_tick부터 발음(=블로킹 부팅 초기화
    완료 시점). 길이 100ms는 점멸계(E-stop/OVLD 250ms)와 청각 구분.
    리뷰 노트(LOW, 수용): 부팅 즉시 E-stop/overload 활성이면 첫 iter의
    fault beep이 boot beep을 선점(FSM last-write-wins 설계 일관 — fault
    우선이 타당)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
    [main.c]
2026-07-18 feat(buzzer): 부팅 beep을 블로킹 딜레이 앞으로 — 전원 직후 최속 발음
    사용자 요청 2026-07-18: beep이 더 빨리 나도록. 기존 FSM 큐 방식은
    슈퍼루프 시작(OSC 핸드셰이크 최대 ~1s + LCD 부트 블로킹 후)까지 침묵
    — sys_tick_init 직후 io_buzzer 직접 구동+블로킹 100ms로 이동.
    - PB12 H 윈도(전원 ~600ms 후)보다 앞서 끝나 OSC 시퀀스 무영향
    (WAIT_H 1s 타임아웃 폴백도 유지)
    - TIM11 NVIC는 tim11_init에서 선무장, io_init이 PA2 선구성 — 리뷰가
    IRQ/GPIO/IWDG 전부 트레이스 확인
    - app_buzzer_init의 io_buzzer(false)는 멱등 무해
    cpp-review APPROVE(0 findings blocking). our-code 0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
    [main.c]
2026-07-18 feat(alarm): 일반 fault(OVTIME 등) 부저 점멸 글루 신설
    사용자 보고 2026-07-18: 에너지 모드 OVTIME 시 알람(부저) 무음.
    legacy는 led_update(main.c:5376, 100ms 무조건)가 SYS_ERROR면 부저
    점멸 — 에러 종류 불문 단일 알람. 포팅은 E-stop/과부하 개별 점멸만
    있어 measure.error_status 계열 fault(현 OVTIME, 향후 OUTERR)가
    무음이었음.
    app_fault_alarm 글루(10ms tick): error_status 0→nonzero 엣지 즉시
    beep + 활성 중 250ms beep을 500ms 재-arm(app_overload 동일 상수,
    legacy mode_blink 등가). RESET 클리어 시 자동 소음. 중복 구동 없음
    (과부하=자체 상태 점멸, ERR_OVLD는 LCD state 쪽 비트 —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
    [app.c, app_fault_alarm.c, main.c]
2026-07-18 fix(lcd): 경고 페이지 전환 시 터치 RUN-키 토글 재앵커 — 에너지 모드 '떼면 시작' 반전 해소
    사용자 보고 2026-07-18: 에너지 모드에서 LCD 터치 오동작(누르고 있다
    떼면 초음파 시작 + 에너지-도달 자동오프/출력제한시간 미동작), 외부
    신호(B_START)는 정상.
    근본원인: V30 RUN 키는 양 엣지 data=0 하나뿐이라 토글(s_run_key_down)
    로 press/release 재구성(e26e15b)하는데, 홀드 중 OVTIME이 뜨면
    show_error가 경고 페이지로 전환 → 런 페이지의 RUN 컨트롤이 사라져
    눌린 터치의 release data=0이 영영 안 옴 → 토글 '눌림' 고착 →
    press↔release 반전(떼면 START,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
    [app_lcd.h, app_lcd_disp.c, app_lcd_input.c]
2026-07-18 feat(horn): SYS_HORN horn-down 모드 포팅 — 양손 키=솔 토글, 초음파/weld 완전 배제
    사용자 보고 2026-07-18: STD 모드 horn-down 중 양손 스타트가 일반 weld
    사이클로 진입해 초음파 출력 발생. 원인 = app_lcd_hook_horn이 스텁
    (mon 로그만) + SYS_HORN 상태 미배선.
    legacy(samd20): SYS_HORN은 별도 시스템 상태 — 양손 START press가
    솔레노이드 토글로 소비(main.c:1433-1440 re_start1||re_start2),
    do_action은 SOL 구동만(1634-1644), 초음파/weld 머시너리 완전 배제.
    진입/이탈=STD SETUP horndown 체크(3457-3471, 항상 솔 OFF부터),
    SETUP 재진입 시 체크박스 미러+shadow 리셋(3617-3622, 체크 안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
2026-07-18 fix(weld): STD 에너지 weld backstop → ERR_OVTIME 상승 (알람/경고화면 복원)
    사용자 보고 2026-07-18: STD 모드 에너지 동작 시 출력제한시간(limit_out_
    time) 초과해도 알람 미발생.
    원인: STD 모드 양손 트리거는 weld cycle(US_CYCLE)로 도는데, 에너지
    backstop abort(app_weld_fsm.c:215-223)가 weld_fault를 내지만 글루
    app_weld_hook_fault()가 mon 로그만 찍고 error_status를 안 세팅.
    app_weld_fsm.c:217 주석이 'mon; 후속 SYS_ERROR'로 이연을 명시한
    미완성분. 직접런(US_TOUCH/COMM/REMOTE) OVTIME은 app_reg.c에서 이미
    ERR_OVTIME을 셋하지만 US_CYCLE은 그 분기에서 구조적으로 제외됨.
    legacy는 RU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
    [app_reg.c, app_reg.h, app_weld.c, app_weld_fsm.c]
2026-07-19 docs(handoff): 2026-07-18~19 세션 마감 — 사용자 신규 8건 전건 HW PASS + USOUT=PCB 확정, 다음=HMI Task 8
    표시 데드밴드 0.15A / 부팅 유령 SEEK / 부팅 beep / fault 부저 알람 /
    경고 페이지 터치 토글 반전 / SYS_HORN horn-down / STD weld OVTIME 알람
    (코드 8커밋 6af9882..61524c1, 전건 cpp APPROVE+HW PASS) + USOUT(PB4)
    코드 정상·PCB 원인 확정. 무변경 결정=EMA α=1/2·피크홀드·cal_val=16.
    HANDOFF/changelog/NEXT_STEPS §2.3-a/RESUME 갱신. ⚠세션 말미 보드
    전원 OFF·잔재 설정 불확정(재개 시 실측). push 미실행=코드 8+docs+태그.
2026-07-19 refactor: 죽은 코드 삭제 — 미호출 게터 3종+데모 매크로 2종
    - app_modbus_owns_usart6 (호출자 0)
    - dgus_rx_drop_count / dgus_tx_timeout_count 게터 (백킹 카운터는 SWD 진단용 보존, 주석 명시)
    - DGUS_DEMO_BOOT_PAGE / DGUS_DEMO_UPTIME_VP (데모 잔재; RESET_ON_BOOT은 사용 중 보존)
    - reg_ramp_level은 계획과 달리 보존: in-code 'Kept as the verified table reference' 명시 (M16 disasm 검증 기록)
    바이너리 동일 확인(-gc-sections), host 14스위트 PASS
    [app_modbus.c, app_modbus.h, dgus_lcd.c, dgus_lcd.h]
2026-07-19 refactor: app_lcd_input.c 분할 — comm/ether/DATA_SAVE → app_lcd_comm.c
    - 800라인 규칙 위반 해소 (1038 → 622 + 신규 415)
    - 순수 코드 이동: comm shadow 편집 4 + ether FSM 3 + commit/rollback 5 함수, 전용 매크로 동반 이동
    - 공유 심 = include/app_lcd_input_priv.h (dispatch→핸들러 7 프로토타입 + run_page_for_mode 역방향 공유)
    - s_run_key_down static은 input.c 잔류 (이동 블록 미사용 검증)
    - data_save_commit 커밋 순서 verbatim 보존 (set_pot→comm_mode/ether→serial shadows)
    0-warning, host 14스위트 PASS, FLASH 총량 불변(64644B)
2026-07-19 refactor: app_reg_tick cadence 블록 추출 — safety ceiling / auto-terminate
    - reg_check_safety_ceiling(30s 절대 ceiling) + reg_check_auto_terminate(energy/on-time)
    static 헬퍼로 파일 내 순수 이동, 블록 주석 verbatim 유지
    - app_reg_tick 118 → 57라인
    0-warning, host 14스위트 PASS
2026-07-19 docs(comment): 드라이버+시스템 계층 함수 주석 ≤20자 한국어 통일
    drivers 13파일(72함수) + src 시스템 8파일(36함수). load-bearing 정보(samd20 와이어 포맷,
    i2c1 unstick 타이밍 등 14건)는 본문 verbatim 이동 보존. 바이너리 동일.
2026-07-19 docs(comment): app 코어+weld/modbus/eth 함수 주석 ≤20자 한국어 통일
    FSM/글루 16파일(43함수, 순수 추가) + weld/modbus/eth 8파일(49함수, load-bearing 17건
    본문 이동 — samd20 update_holding_reg 등가, M7/M8/M9 태그, DHCP 콜백 근거). 바이너리 동일.
2026-07-19 docs(comment): LCD 계열+app_reg 함수 주석 ≤20자 한국어 통일
    LCD 6파일(57함수) + app_reg.c(12함수). load-bearing 16건 본문 이동 — V30 data=0 quirk,
    30s 안전 ceiling 근거, DATA_SAVE fix-B/F3/deviation, 벤치 노트(2026-07-05/18) 전부 보존.
    바이너리 동일, host 14스위트 PASS, 보존 지표(samd20 255·main.c: 112·§ 79·V30 9) 무손실.
    [app_lcd.c, app_lcd_comm.c, app_lcd_disp.c, app_lcd_input.c, app_lcd_render.c, app_lcd_str.c, app_reg.c]
2026-07-19 docs(changelog): 2026-07-19 fw 리팩토링 항목 추가
2026-07-19 docs(handoff): 2026-07-19 리팩토링 세션 마감 — 4스테이지 완료, 머지=HW 재검증 게이트
2026-07-25 feat(model): 모델 브랜드+버전 문자열을 define.h로 분리 — 4종 컴파일-타임 선택
    samd20은 브랜드 매크로를 main.c:27-30에, VERSION_MSG를 define.h:31에 두었다.
    포트는 둘을 fw/include/define.h 하나로 모은다.
    - define.h 신설: GDSONIC/DIAMT/POWERTECH/MOOHAN 중 하나 선택 + VERSION_MSG.
    2개 이상 정의 시 #error로 빌드 차단.
    - app_lcd_send_model_str: GDSONIC 단독 하드코딩 → 4브랜드 블록
    (GDS/DIS는 접두 3바이트만 달라 공유, PTW/MH는 freq 매핑이 달라 별도).
    samd20 main.c:2379-2586 포팅.
    - app_lcd_render.c: static VERSION_MSG[20] 배열 제거 → define.h 참조 +
    _Static_assert로 20자 강제 (s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
    [app_lcd.c, app_lcd_render.c, define.h]
2026-07-25 fix(lcd): ether IP 편집 커서를 실제 글자 수로 — 헛 백스페이스 해소
    ip_to_string은 DGUS 쓰기 길이용으로 실제 길이가 아닌 16을 반환하고 남는 자리를
    NUL로 채운다(app_lcd_str.c:156-159). ether_select_field가 그 반환값을 그대로
    편집 커서로 써서(samd20 main.c:4094 동일), 백스페이스가 16-strlen 번은 NUL만
    먹고 화면에 아무 변화가 없었다. 192.168.1.199=3회, 1.1.1.1=9회 헛방.
    헛 백스페이스는 else 분기를 타 ether_current_number /= 10도 매번 실행 →
    진입 시드값(temp_ether_ip[3])이 편집 시작 전에 0으로 깎이는 부수 피해도 있었다.
    커서만 strlen으로 교정. ip_to_str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
    [app_lcd_comm.c]
2026-07-25 feat(model): MAKETECH 브랜드 추가 — SMT-{H|A|S}{freq}D
    samd20 ref/에 대응 블록이 없는 신규 브랜드. 자리 배치는 레거시 규약
    (11바이트, 남는 자리 공백 패딩 + [10]에 NUL)을 따르되 포맷은 신규 정의.
    hand "SMT-H15D" / multi "SMT-A15D" / std "SMT-S15D"
    레거시 4종과 달리 type 문자가 숫자 앞에 온다 (GDS-20H vs SMT-H20D).
    패널 선택지는 15K/20K/35K이나 model_freq는 0~5를 가질 수 있어, 30/40/50K
    코드는 GDSONIC과 같이 실제 주파수를 그대로 찍는다 — MOOHAN처럼 30K를 35로
    접지 않음(접을 근거가 legacy에 없음).
    - define.h:21 브랜드 목록 등록 + :23-24 #error 가드 카운트 확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
    [app_lcd.c, define.h]
2026-07-25 chore(build): fw.sh 빌드/플래시 스크립트 + 절차 문서화
    CMake 커스텀 타깃(CMakeLists.txt:123 flash 등)은 이미 있었으나, 매번 두 함정을
    사람이 기억해야 했다. 스크립트가 그 둘만 대신 처리한다.
    ./fw.sh [build|flash|reset|gdb|test|reconfig]
    1. $STM32_TOOLCHAIN이 stale 경로를 가리켜 cmake가 실패 → env -u로 항상 제거.
    2. CMakeLists.txt:91의 file(GLOB src/*.c drivers/*.c)는 configure 타임 고정 →
    .c가 증감한 브랜치로 전환한 뒤 증분 빌드만 하면 undefined reference로 터진다
    (2026-06-19 seek-reset 세션 실사고). 소스 목록을 build/.src-glob 스탬프와
    비교해 달라졌을 때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
2026-08-02 docs: 원격 제어 활성화 게이트 결정 기록 (gds_us_remote 발)
    gds_us_remote 프로젝트에서 2026-08-02 승인된 결정을 이 저장소에 기록한다.
    요구사항 전달과 결정 근거 보존이 목적이며, 펌웨어는 아직 미구현이다.
    조사로 확인된 것 (이 저장소 코드는 수정하지 않음):
    - 원격 제어 권한 게이트가 전혀 없다. Modbus 도달 가능한 누구나 언제든
    START(0x1B)를 쓸 수 있다. 물리 인터록도 없다(현장 확인)
    - US_REMOTE 는 명령 소스 표시값, note_remote/remote_active 는 1초
    아이콘용, EN_SAFTY 는 양손 안전 — 전부 권한 게이트가 아니다
    - 30초 절대 상한(ON_TIME_S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
2026-08-15 docs: 문서/깃 대조 갱신 — push 상태 정정 + ponytail 브랜치·원격 게이트 로드맵 편입
    fable로 HANDOFF/NEXT_STEPS/RESUME/CLAUDE.md와 git 실측을 대조. 코드 무변경.
    - push 상태 정정: 코드·docs는 이미 origin 동기(main == origin/main).
    실제 미푸시는 태그 7개(-eth-reapply/-fram-robust/-mbtcp-hardening/
    -physio-b/-physio-d/-power-ch1/-weld4).
    - 미머지 브랜치 refactor/ponytail-cleanup 편입: main 대비 +12커밋.
    main 쪽 docs는 브랜치 생성 직전 커밋이라 존재 자체를 몰랐음.
    머지 게이트 = 벤치 HW 재검증 3항목 + 07-25분 육안 2건.
    - 원격 제어 활성화 게이트(2026-08-02 승인, 미구현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
2026-08-15 docs(handoff): 브랜치 핸드오프 갱신 — 07-25 4커밋 편입 + push 상태 정정
    이 문서는 07-19 리팩토링 4스테이지 시점에서 멈춰 있었다.
    - tip e46cafd → 753778d, "로컬 전용 미푸시" → origin 푸시됨으로 정정
    - 2026-07-25 세션 4커밋(define.h 브랜드/버전 분리, ether IP 커서 fix,
    MAKETECH, fw.sh)을 Completed 표에 검증 근거와 함께 추가 — 그 세션은
    핸드오프를 남기지 않았다
    - HW 재검증 항목에 07-25분 육안 2건 + MAKETECH 출하 시 확인 추가
    - main 쪽 신규(원격 활성화 게이트, 태그 push) 참조 추가
2026-08-16 docs: 원격 게이트 T-1~T-4 진행 반영 — 브랜치 스택·자산 대기·플래시 주의
    코드 변경 없음. 로드맵 문서를 브랜치 실제 상태에 맞춤.
    - NEXT_STEPS §2.2: "미구현·착수 전" → T-1~T-4 CODE-COMPLETE. 산출물,
    남은 Task, 확정 상수(창 10분/침묵 10초/매직 0x5201), 사용자 DGUS 자산
    3종, 기본 빌드 플래시 금지 경고 추가. 브랜치 스택 도식 신설
    - HANDOFF §②: 같은 내용. 진입 정본을 브랜치 HANDOFF로 지시
    - CLAUDE.md 항목 3: "미구현·착수 전"이 사실과 달라 정정
    - push 상태: 3개 브랜치 전부 origin 동기로 갱신
    가장 중요한 추가 = 기본 빌드 플래시 금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
2026-08-16 docs: 태그 push 상태 정정 + 유실된 IWDG 항목 재편입
    fable 검토로 확인된 stale 2건. 코드 변경 없음.
    - "태그 7개 미푸시"가 4개 문서에 남아 있었음 — 8-15에 그렇게 적은 뒤
    같은 세션에서 실제로 푸시하고 문서를 되돌리지 않은 탓. 실측 = 브랜치
    3개·태그 21개 전부 origin 동기, 미푸시 없음. 다음 세션이 끝난 작업을
    재시도하거나 사람 터미널을 헛대기할 뻔했다
    - IWDG 워치독: requirements.md FW3-6이 요구하고 2026-07-02 감사 D3가
    "H4+IWDG 별도 슬라이스"로 분리했으나 이후 어느 로드맵에도 재등장하지
    않아 추적에서 유실. NEXT_STEPS §1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
2026-08-16 docs: 재베이스 완료 반영 — 브랜치 스택 2단으로 정리
2026-08-16 docs: 벤치 세션 마감 — 보드 실측 상태 + freq_cal_val=40 의도적 확인
    코드 무변경.
    - NEXT_STEPS §2.3-0 신설(2026-08-16 실측): 펌웨어=현 main과 동일,
    comm_mode=ETH_STATIC(⚠RTU 무응답, TCP .199 사용), model_type=multi 복원,
    cal_val 16 / freq_cal_val 40
    - freq_cal_val=40은 사용자 확인 "의도적" — 문서상 "HSE 전환 후 0이 정답"과
    달라 다음 세션이 이상값으로 오인할 소지가 있어 명시. 원복 금지
    - 벤치 교훈 2건 기록: 세션 첫 단계=플래시 덤프 대조(07-05·08-16 두 번
    문서와 어긋남), foreground sleep 차단
    부수 확인: comm_mode를 LCD에서 바꾸자 RTU가 USART6를 놓고 T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
2026-08-16 fix: 정지를 주체 무관으로 — 원격 STOP 이 패널 운전을 못 세우던 문제
    `US_CMD_RUN_RELEASE` 가 source-matched 였다: `us_run_status == src` 일 때만
    운전을 내린다(samd20 main.c:3699/4180/4405 verbatim 포팅, "a COMM STOP
    cannot kill a touch run and vice versa").
    그 결과 **Modbus(COMM) STOP 이 패널(TOUCH) 기동 운전을 정지시키지 못했다.**
    원격기(gds_us_remote) 실측 2026-08-16: FC06 `0x1C=1` 에코 정상, 명령
    레지스터도 소거되는데 `us_run_status` 가 안 바뀐다 — **원격기 입장에서
    성공한 전송과 구분할 수단이 STATUS 밖에 없다.** 파일럿은 원격 START 가
    막혀 있어 COMM 기동 운전 자체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
    [app_reg.c]
2026-08-16 docs: 대칭 정지 대가 주석을 실측대로 정정 (V-3~V-5)
    ②가 실제보다 넓게 적혀 있었다 — `run_key_reanchor` 는 조작자의 수동
    페이지 이동에서는 불리지 않는다(gds_us_remote 실보드 벤치 2026-08-17:
    COMM 운전 중 페이지 이동 20초, 무정지). 호출처 3곳 중 E-stop 은
    app_input.c 가, OVLD 는 app_overload.c 가 원래도 us_run_status 를 src 로
    읽어 소스 무관 정지 중이므로 신규 동작은 OVTIME·OUTERR 표시 전환과
    패널 리셋뿐이다.
    ①은 실측 확인(탭 2회 재현, 무접촉 통제군 15/20초 무정지로 대조),
    ③(래치 소스 무관 갱신)을 추가했다. 사용자 결정: 대칭 유지.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
2026-08-17 docs(spec): 원격 제어 활성화 게이트 설계 — 0x2A~0x2D, LCD 전용 비영속
    2026-08-02 승인 정책의 구현 설계. 코드 변경 없음.
    범위 = F-B(활성화 게이트)만. F-A(comm/eth 0x1E~0x29)는 비의존이고
    덩치가 커서 별도 스테이지로 분리.
    핵심 설계:
    - 게이트 seam = app_modbus_apply_writes() 선두 1곳 (RTU/TCP 공유).
    app_reg는 무변경 — start_allowed를 TOUCH/REMOTE/CYCLE이 공용이라
    거기 넣으면 로컬 조작까지 막힘
    - 상태는 파일 스코프 static. holding[]은 mb_core_init이 링크 전이마다
    0으로 리셋하므로 불가, app_config_t/FRAM은 비영속 요구로 불가
    - 소거 불변식: 명령 레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
2026-08-17 docs(plan): 원격 게이트 T-1~T-4 실행 계획 — TDD 12케이스 + 게이트 배치 근거
2026-08-17 feat(remote): app_remote_en_fsm 순수 FSM 신설 — host 스위트 15번째
    plan T-1 (docs/superpowers/plans/2026-08-15-remote-enable-gate-t1-t4.md).
    spec §5.2 상태 머신을 HAL/전역 무의존 순수 FSM으로 구현.
    설계 요점:
    - 침묵 타이머는 활성화 후 첫 유효 요청부터 무장. 활성화 이전 스탬프로
    무장하면 원격기 접속 전에 DIS_LINK가 된다. 무장 판정은 랩 안전
    (활성화 이전 요청은 좌변이 언더플로로 elapsed보다 커짐)
    - E-STOP은 레벨이 아닌 상승 엣지 + 레벨 활성 중 enable 거부.
    레벨 추종이면 E-STOP 해제 시 게이트가 자동 부활해 "재활성은 LCD만"과
    모순되고, 엣지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
2026-08-17 feat(remote): Modbus 레지스터 0x2A~0x2D 계약 — CAP 매직·상태 코드
    plan T-2. 헤더만 변경 — 디코더(app_modbus_core.c)와 MB_REG_COUNT는 무변경.
    - 0x2A REMOTE_CAP / 0x2B REMOTE_EN / 0x2C REMOTE_EN_LEFT, 0x2D 예약
    - 0x1E~0x29는 F-A(comm/eth 확장) 몫으로 비워 둠
    - probe 매직 0x5201. write-back 값 P가 0이면 안 되는 이유를 주석에 명시
    (링크 전이의 mb_core_init 0-리셋과 구분 불가)
    - 상태 코드 6종을 REN_*와 값 일치로 정의, cross-check 케이스로 고정
    (매크로 정의 전 컴파일 실패 RED → GREEN 확인)
    게이트: host 15스위트 PASS + 크로스 0-warning.
2026-08-17 feat(remote): 게이트 글루 — 매 tick FSM step + 미러 3종 + 접근자 3종
    plan T-3. 이 커밋까지는 거동 무변화 — 0x2A~0x2C가 읽히기 시작할 뿐,
    명령 차단은 T-4가 건다.
    - remote_en_step()을 app_modbus_tick() 첫 문장(분기 밖)에 배치.
    RTU 점유/TCP/미점유 어디로 빠지든 시간이 흘러 만료돼야 한다
    - 미러 3종은 mirror_live() 말미 무조건 실행 — 세 호출처(RTU 획득/tick
    RTU/tick TCP)를 한 번에 덮고, 링크 전이의 mb_core_init 0-리셋도 같은
    tick에 복원된다. 0x2D는 예약이라 미러 안 함
    - 상태는 파일 static(s_ren). holding[]은 링크 전이에 지워지고 FRAM은
    비영속 요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
2026-08-17 feat(remote): apply_writes 선두 게이트 — 명령 소거 불변식 + STOP 상시 통과
    plan T-4. 이 커밋이 최초의 거동 변화 — 게이트가 닫혀 있으면 원격
    START/SEEK/RESET과 cfg 쓰기가 무시된다.
    게이트는 else-if 체인(:219) 바로 앞 단일 위치(:208), return 포함.
    - 명령 3종 무조건 소거: 0x19~0x1C는 미러 대상이 아니라 무시만 하면 1이
    잔류하고, 게이트 개방 후 첫 FC06에 stale START가 디스패치된다
    - STOP은 게이트 블록 안에 복제해 통과. 기존 분기에 맡기면 return을
    포기해야 하고, 그러면 cfg 거부가 사라진다
    - cfg 거부는 별도 조치 없음 — 체인 skip 시 다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
    [app_modbus.c]
2026-08-17 fix(remote): 리뷰 반영 — STOP 값 불문 소거 + LCD 이벤트 상호배타
    /code-review high 지적 2건 (LOW).
    - STOP 소거가 `== 1` 검사 안에 있어 STOP=2 같은 비-1 write가 영구 잔류.
    0x1C는 미러 대상이 아니고 개방 경로 else-if도 ==1만 매치하므로 이후
    모든 FC03 읽기가 유령 pending STOP을 보고한다. 유령 디스패치는 없으나
    관측값이 거짓말을 함. 명령 4종 전부 "디스패치는 조건부, 소거는 무조건"
    으로 통일. spec §5.3 의사코드도 같은 형태였어 함께 정정
    - app_remote_en_set()이 반대쪽 래치를 지우지 않아, 한 superloop iter에
    두 조작이 드레인되면(DGUS 터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
    [app_modbus.c]
2026-08-17 fix(remote): T-5 이전 벤치 탈출구 REMOTE_EN_GATE_BYPASS — 기본 OFF
    /code-review high 지적 (HIGH). app_remote_en_set()에 호출자가 없어 게이트가
    영구 DISABLED — 원격 START/SEEK/RESET과 cfg 쓰기가 RTU·TCP 양쪽에서 전부
    무시되고, 이 repo의 HW 검증이 의존하는 mbpoll 흐름과 gds_us_hmi 레지스터
    계약이 함께 죽는다. 보드에서 되살릴 방법도 없다. 계획이 T-5를 자산 대기로
    분리하면서 이 중간 상태를 다루지 않은 누락.
    한시적 컴파일-타임 우회를 둔다:
    cmake -S fw -B build -G Ninja -DREMOTE_EN_GATE_BYPASS=ON
    - 기본 OFF(게이트 유효). 폴라리티가 핵심 — 플래그를 깜빡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
    [app_modbus.c]
2026-08-17 docs(handoff): 브랜치 핸드오프 — 원격 게이트 T-1~T-4 CODE-COMPLETE, T-5=자산 게이트
2026-08-17 feat(remote): 게이트 거부를 mon에 기록 — 벤치 VR-3 관측용
    원격 게이트가 명령을 조용히 소거만 해서, 컨트롤러 쪽에서는 "게이트가
    막았다"와 "요청이 애초에 안 왔다"를 구분할 수 없었다. STATUS 무변화라는
    간접 증거뿐이라 VR-3 판정 근거가 약하다.
    [mb] gate closed(state=N): blocked=0xNN stop_passed=N
    - 소거 전에 어떤 명령이었는지 잡는다(소거 후엔 알 수 없다)
    - STOP 통과 여부도 같이 찍어 "닫혀 있어도 STOP은 산다"를 실증
    - 명령이 걸린 경우에만 출력 — cfg 전용 쓰기까지 찍으면 원격기의 주기
    파라미터 쓰기가 로그를 덮는다. cfg 거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
2026-08-17 docs(handoff): VR-2/VR-3 실보드 PASS + RS-485 mon 발견 반영
2026-08-17 docs: 2026-08-17 벤치 마감 — VR-2/VR-3 PASS, RS-485 mon 발견, 보드 상태
    코드 무변경(게이트 로그는 브랜치 커밋).
    - 원격 게이트 VR-2/VR-3 실보드 PASS 기록: START/RESET/SEEK 차단(+[sr]
    OSC 구동 0건으로 물리 계층까지 미실행 확인), cfg 쓰기 거부, STOP 통과,
    CAP 매직 0x5201
    - RS-485 mon 발견: 기존 "DE 미제어로 불가"는 원인 오진. 트랜시버는
    auto-DE고 진짜 제약은 RTU 점유 시의 mon_set_enabled(false).
    → ETH 모드면 485로 mon 청취 가능 = "Modbus TCP + 모니터 485" 성립
    - 보드 상태 정정: BYPASS 빌드가 올라가 있음(main 빌드 아님, 출하 금지) +
    복귀 방법 명시. s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
2026-08-17 docs: 보드 펌웨어 main 복귀 반영 — 덤프 대조 byte-identical 확인
2026-08-30 docs: 원격기 기능 동등성 요구사항 접수 (gds_us_remote → gds_us_ctrl)
    `gds_us_remote` 의 목표가 **"컨트롤러의 모든 기능을 원격기에서 동일하게
    구현한다"** 로 확정되면서(2026-08-30 사용자), 컨트롤러 쪽에 필요한 것들을
    정리한 **요구사항 문서**다.
    🔴 **요구사항(무엇을·왜)과 수용 기준만 적혀 있다. 구현 방법은 이 저장소가
    정한다** — 핀 선정·회로·스위치 사양·펌웨어 구조·레지스터 실제 주소·클램프
    범위·벤치 절차 전부. 소비 측이 HW·보드 사정을 모르는 채 밖에서 구현을 지시하면
    틀리기 쉽고, 두 프로젝트가 이미 세운 관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
2026-09-03 feat: 제품 모델(기능 티어) 빌드 축 추가 — STD | REMOTE
    H/W는 hw-revA로 동일하고 **F/W 기능셋으로만 모델을 나눈다**는 결정에 따라,
    브랜드 축과 직교하는 모델 축을 하나 깐다. 새 메커니즘을 만들지 않고
    `define.h`가 이미 브랜드 5종에 쓰고 있는 빌드타임 선택 + `#error`
    "정확히 하나" 가드 패턴을 그대로 재사용했다.
    ## 무엇
    - `fw/CMakeLists.txt` — `set(MODEL "STD" CACHE STRING ...)` +
    `add_compile_definitions(MODEL_${MODEL})`. 2줄
    - `fw/include/define.h` — 모델 티어 블록(가드) + 모델별 `VERSION_MSG`.
    접미어 `R` = REMOTE. 같은 버전의 두 바이너리를 현장 LCD로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
    [define.h]
2026-09-03 feat(remote): STATUS 관측 비트 2개 — SENSOR(0x20) · HORN(0x40)
    2026-08-30 원격기 요구사항의 **B-3(센서 상태) · B-4(horn 모드 관측)**.
    문서 우선순위 #1 — 가장 싸고, 지금 가장 나쁜 상태를 해소한다.
    ## 왜 B-4가 급했나
    horn 모드에서는 **모든 소스의 START가 차단**되는데(`US_COMM` 포함)
    원격기에는 그걸 감지할 방법이 전혀 없었다. 원격 START를 보내면
    FC06 에코 정상 · 명령 레지스터 소거 정상 · `STATUS` us만 계속 0 —
    **성공한 전송과 구분되지 않는다.** 조작자에게는 "화면은 정상인데
    명령이 안 먹는" 상태가 되고 원격기가 사유를 표시할 근거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
2026-09-03 docs(pinmap): 여유 핀 절 신설 + stale 2건 정정 + PC8 = CON_REMOTE_EN 확정
    요구사항 문서(2026-08-30)가 지적한 "명시적 여유 목록이 없다"를 메운다.
    판정은 문서가 아니라 코드 실측(io.c/board.c/드라이버 GPIO 점유)이다.
    정정 2건 — 둘 다 여유 핀 판단을 틀리게 만들던 것:
    - **PB12는 여유가 아니다.** io.c:20이 USFB(초음파 출력 피드백, active-HIGH
    입력)로 이미 쓴다. 문서의 "정체 미확정·미설정"은 옛말
    - **PB8 heartbeat는 구현된 적이 없다.** 결정만 있고 배선·구동이 없어
    실제로는 빈 핀 — 예약으로 표기하되 여유로 계상
    확정: **PC8 = CON_REMOTE_EN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
2026-09-04 feat(remote): 게이트를 물리 인터록으로 재설계 — PC8 레벨 스위치, REMOTE 모델 전용
    요구사항 2026-08-30 §요청 A. 2026-08-15 spec 의 "LCD 조작(T-5) + 창 만료(600s)"
    의미론을 폐기하고 기계 쪽 물리 스위치(PC8/CON_REMOTE_EN)로 대체한다.
    ## 왜 바뀌었나
    원격 START 는 사람이 없을 수 있는 곳에서 기계를 돌리는 것이다. 인터록의 목적은
    **기기 앞에 사람이 있어야 원격 기동이 가능하다**를 보장하는 것인데, LCD 터치는
    DGUS 자산 변경이 필요해 막혀 있었고 무엇보다 화면 오조작으로 켜진다.
    물리 스위치는 상태가 눈에 보인다 — 그래서 "켜고 잊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
2026-09-04 feat(remote): F-A comm/eth 레지스터 확장 — staging + commit (0x1E~0x29)
    요구사항 B-1. LCD 전용이던 통신 설정(슬레이브 주소·보드레이트·패리티·IP/NM/GW)을
    원격에서 읽고 **편집**할 수 있게 한다. spec = 2026-08-16 (DG-11/DG-12 승인).
    ## 왜 값 레지스터가 아니라 staging 인가
    통신 설정은 **그 값을 쓰는 데 쓰이는 링크 자체**를 제어한다. 기존 방식
    (FC06 → 즉시 cfg → 즉시 FRAM)이면 셋 다 터진다:
    ① FC16 미지원이라 IP 6칸을 원자적으로 못 써 **반쪽 IP 가 FRAM 에 영속**되고
    ② comm_speed 반영 즉시 UART 가 재초기화돼 나머지를 쓸 기회가 사라지며
    ③ 예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
2026-09-04 feat(remote): B-2 calibration 노출 + C-1 int16 계약 + C-3 클램프 (0x2E/0x2F)
    요구사항 B-2 / C-1 / C-3. **2026-08-01 "컨트롤러 전용"으로 제외했던 것이
    2026-08-30 에 번복된 항목**이다 — 목표가 "모든 기능 동일"이 되면서 포함으로 바뀌었다.
    ## 왜 클램프가 필요한가 (C-3)
    `cal_val` 은 표시 보정이 **아니라 제어 루프 입력**이다:
    cal_val → reg_current_from_adc → disp_amp → curr_power → acc_energy →
    weld 에너지 EXIT 판정, 그리고 app_reg 의 비사이클 가동 정지 판정.
    범위 밖 값은 화면이 아니라 **기계의 정지 시점**을 왜곡한다.
    ## 클램프 값 선정 — ±1000, 대칭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
2026-09-04 feat(remote): C-2 EN_SAFTY(0x16) 0/1 정규화 — samd20 이탈, 사용자 승인
    요구사항 C-2. Modbus 로 `EN_SAFTY=5` 를 쓰면 5 가 그대로 저장되던 것을
    `(v == 1) ? 1 : 0` 으로 정규화한다.
    ## ⚠ legacy 이탈이다
    samd20 원본 comm 경로는 as-is 저장이었고(main.c:4533) 이 포트도 그걸
    **의식적으로** 충실 복제하고 있었다(주석이 명시). 사용자 승인 후 변경.
    받아들인 이유: **LCD 경로는 이미 정규화한다**(`app_lcd_input.c:518`).
    두 편집 경로가 갈려 있었던 것이고, 이 변경은 "원격에만 새 규칙을 발명"하는
    것이 아니라 유일하게 어긋나 있던 Modbus 를 LCD 에 맞추는 쪽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
2026-09-04 docs(bench): 원격기 동등성 스택 통합 벤치 체크리스트
    사용자가 "전부 구현하고 한 번에 시험" 방식을 택했으므로, 스테이지마다 흩어져
    있던 검증 항목을 한 장으로 모은다. 벤치 당일 spec 5개를 뒤지지 않게 하는 것이
    목적이다.
    - 실행 순서를 근거와 함께 고정: S(무회귀) → M → B34 → CAL → FA → A.
    FA/A 를 뒤로 둔 이유는 **둘 다 이후 시험의 전제를 바꾸기 때문**이다
    (통신 설정 변경 / 게이트가 모든 쓰기를 막음)
    - mbpoll -r 은 1-based 라 wire↔-r 대조표를 §0.3 에 박아 둠
    - 🔴 보드 잔재 명시: comm=ETH_STATIC .199, serial **38400/EVEN**(구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
2026-09-04 fix(remote): 코드리뷰 6건 반영 + TCP 연결 자동 복구
    `/code-review high main...HEAD` 지적 6건 전부 처리 + 사용자 요구("스위치가
    켜져있다면 통신연결은 자동 복구되어야 함") 반영.
    ## 🔴 #2 게이트 자기교착 — 내 설계 판단이 틀렸다
    "해제 사유는 전부 래치, 스위치 재무장으로만 해제"로 정했는데 **이 저장소 자체
    실측과 충돌**한다: Modbus TCP 소켓이 1개이고 피어 소멸 후 stale ESTABLISHED
    자가치유에 **~20초**가 걸린다(2026-08-17 실측). 침묵 임계는 10초다.
    → 원격기가 재접속할 때마다 게이트가 잠기고 사람이 기계까지 걸어가 키를 껐다
    켜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
    [app_cfg_stage.c, app_modbus.c, app_modbus_core.c, app_modbus_core.h, app_modbus_tcp.c, app_remote_en_fsm.c, io.c, test_app_cfg_stage.c]
2026-09-04 docs(bench): 체크리스트를 실제 거동에 맞춤 — 래치 정정 + NET 섹션 신설
    `3ce1ead` 로 거동이 바뀐 부분이 체크리스트에 낡은 채 남아 있었다. 벤치 당일
    틀린 기대값으로 "실패" 오판을 하는 것이 이 문서가 막으려던 바로 그것이라 즉시 갱신.
    - **A-8 뒤집힘**: "링크 해제 래치(3 유지)" → **"자동 복귀(1)"**. 여기서 3 이
    유지되면 옛 자기교착 코드가 남은 것이므로 그 진단도 함께 적었다
    - **A-11 강화**: E-STOP 래치는 "폴링 계속" 조건을 명시 — 트래픽이 와도 안
    열려야 링크와의 대비가 성립한다
    - **NET 섹션 신설**(STD 빌드·PC8 불요):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
2026-09-04 feat(remote): F-A capability 레지스터 0x31 신설 (모델 무관 무조건 미러)
    원격기 확인 요청에 대한 답이자, 제품 모델 축 도입의 부작용을 메우는 것이다.
    ## 왜 필요한가
    `REMOTE_CAP(0x2A)` 로 F-A 를 판별하면 **틀린다**:
    - 게이트는 **REMOTE 모델 전용**이라 STD 는 0x2A 에 매직을 싣지 않는다
    - 그런데 **F-A(0x1E~0x29)는 두 모델 모두에 있다**
    → 0x2A 로 판별하면 **F-A 를 지원하는 STD 유닛을 미지원으로 오판**한다.
    내가 모델 축을 만들면서 생긴 구멍이고, 소비 측(원격기)이 probe 공용을
    제안했을 때 이 함정을 짚어 별도 레지스터로 합의했다.
    ##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
2026-09-04 feat(remote): B-5 모델 선택·주파수 원격 쓰기 (가드 없음 — LCD 경로와 동형)
    요구사항 B-5. 마지막 남은 관측/조작 항목이었다.
    ## 요구사항의 진단이 틀렸다
    요구사항은 "`mirror_live()` 가 매 tick cfg 로 덮어서 쓰기가 안 먹는다 →
    미러가 덮지 않게 해 달라" 로 봤다. 실제 원인은 다르다:
    FC06 -> holding 갱신 -> apply 체인에 **분기가 없어 무시** -> 미러가 원복
    즉 **미러는 죄가 없다.** apply 체인에 분기 하나를 추가하면 되고, 그러면 다른
    cfg 필드(OUT_POWER 등)와 완전히 동형이 된다 — 쓰기는 체인이 받고 미러가 결과를
    되비추며, 거부·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
2026-09-04 feat(remote): B-4 조작 — 0x30 HORN_CMD 원격 horn 모드 on/off
    요구사항 B-4 의 나머지 절반(관측은 STATUS 비트로 이미 완료). **이것으로
    2026-08-30 요구사항 A·B-1~B-5·C 가 전부 닫힌다.**
    ## 형태
    cfg 필드가 아니라 **비영속 RAM 상태**지만(`app_horn.c` 의 `s_mode`), 미러/apply
    형태는 다른 cfg 필드와 동형으로 뒀다 — 쓰기는 체인이 받고 미러가 **실제 모드
    상태**를 되비춘다. 덕분에 read-back 계약이 그대로 성립하고 새 상태가 필요 없다.
    `save` 는 하지 않는다. **"재부팅 시 소실"은 설계이지 누락이 아니다** — 원격기에도
    그렇게 회신했고, 그쪽 UI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
2026-09-04 docs(modbus): 레지스터 확장 한계를 계약 헤더에 명시 — 57칸 상한 / 여유 7칸
    원격기와 상호 확인 중 나온 제약을, 다음에 레지스터를 늘리려는 사람이 먼저 볼
    자리(MB_REG_COUNT 바로 밑)에 박아 둔다.
    - FC03 응답 = 3 + N*2 + CRC2, MB_RESP_MAX=125 → **N <= 57**. 현재 50칸(105 B)
    이라 여유는 7칸
    - 🔴 그 이상은 소비 측이 **폴링 블록을 쪼개 두 번 읽어야 하고 두 읽기 사이의
    원자성이 깨진다.** 원격기·HMI 화면 판정이 "스냅샷 하나가 진실"을 전제로
    설계돼 있어 우리만의 제약이 아니다 → 확장 전에 '어느 필드가 같은 프레임에
    있어야 하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
2026-09-04 docs(bench): MOD-6 경고 강화 — 살아있는 E-stop 을 의도적으로 해제하는 시험
    원격기 회신에서 드러난 사실을 반영한다: 그쪽 안전 계층(REJ_ESTOP)이 이 경로를
    막고 있지만 **그것은 원격기 경로에만 적용된다.** mbpoll 같은 임의 마스터에는
    방벽이 없고, MOD-6 이 정확히 그 노출을 확인하는 항목이다.
    - MOD-6 을 수행하면 기계가 실제로 기동 가능한 상태가 되므로 **초음파·솔레노이드
    부하 분리 + 사람이 가동부 근처에 없을 것**을 전제로 명시
    - 컨트롤러가 거부하지 않는 것이 사용자 결정임을 근거와 함께 적어, 벤치에서
    "버그 발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
2026-09-04 docs(resume): 2026-09-04 상태 — 원격기 동등성 스택 CODE-COMPLETE
    세션이 끊기면 다음 세션이 2026-08-17 상태로 시작해 잘못된 전제를 갖게 된다.
    스택이 18커밋이고 설계 결정이 7건 나왔으므로 진입 문서를 현재로 맞춘다.
    - **진입점을 통합 벤치 체크리스트로 지정** — 스테이지별 spec 을 뒤지지 않게
    - 결정 7건을 근거와 함께 요약. 특히 **처음에 틀렸다가 고친 것들**을 남겼다:
    게이트 래치 자기교착(둘 다 래치 → DIS_LINK 자동복귀), 빈 커밋의 COMMIT_OK
    오보고, B-5 의 진단 오류(미러가 아니라 apply 분기 부재)
    - 미결 1건(C-3 work_cnt, 사용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
2026-09-04 fix(modbus): work_cnt 리셋 가드를 32비트 비교로 — samd20 이탈, 사용자 승인
    2026-08-30 요구사항의 "발견 사항"(요청 아님, *"고칠지는 이 저장소가 판단할 일"*)
    을 고친다.
    ## 무엇이 깨져 있었나
    ```c
    (g_mb.holding[MB_REG_WORK_CNTL] == 0u) && ((uint16_t)cfg->work_cnt != 0u)
    ```
    `work_cnt` 는 `uint32_t` 인데 가드가 **하위 워드만** 비교한다. 그래서
    **`work_cnt` 가 65536 의 배수일 때 `(uint16_t)work_cnt == 0` 이 되어 리셋이
    조용히 무시된다.** 조작자가 `WORK_CNTL=0` 을 써도 아무 일도 안 일어나고 에러도
    안 난다. 다음 사이클로 65537 이 되면 그때부터 다시 동작한다.
    용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
    [app_modbus.c]
2026-09-04 docs: 세션 마감 — 진입 문서 3종을 현재 상태로 정렬
    HANDOFF(2026-07-19) · NEXT_STEPS(2026-08-16) · CLAUDE.md 상태 블록(2026-08-15)이
    전부 stale 이었다. 셋 다 진입 문서라 이대로 두면 다음 세션이 자동 적재되는
    RESUME.md 와 **모순되는 정보**를 받는다 — 특히 "원격 게이트 T-5(LCD 활성화) 대기"
    서술은 폐기된 설계다(PC8 물리 인터록으로 대체됨).
    - 셋 모두 **진입점을 통합 벤치 체크리스트로** 지정
    - HANDOFF 는 헤더를 새로 쓰고 "벤치 실행에 필요한 것" 표를 앞에 뒀다 —
    PC8 없이도 STD 빌드로 어디까지 되는지가 다음 세션의 첫 질문이다
    - CLAU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
2026-09-04 feat(wd): 리셋 원인 배너 — RCC->CSR 읽기+클리어
    부팅 배너에 리셋 플래그를 실어 IWDG 리셋을 NRST/전원 리셋과 구분할 수
    있게 한다. IWDG 슬라이스(T-2)의 벤치 판정이 이 배너에 의존한다.
    - `RCC->CSR[31:24]` 읽기 → `__HAL_RCC_CLEAR_RESET_FLAGS()` 즉시 클리어.
    CSR 플래그는 POR 또는 RMVF 로만 지워지므로 안 지우면 이전 부팅의
    IWDG 플래그가 다음 부팅에 남는다.
    - SWD 정적 read 용 `s_boot_rst` static 보관 (mon 이 막힌 상황 대비).
    - 배너 위치 불변 — `app_modbus_init()` 이전이라 `mon_set_enabled(false)`
    가 아직 안 걸려 comm_mode 무관하게 USART6 로 나간다.
    -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
2026-09-04 feat(wd): IWDG 기동 + 슈퍼루프 단일 kick + DBGMCU freeze
    요구사항 FW3-6 / 2026-07-02 감사 D3 잔여. 최초의 거동 변화 커밋.
    - 기동 = 슈퍼루프 진입 직전. 공칭 5.0 s (÷256 / RLR=624, LSI 17~47 kHz
    편차 시 3.4~9.4 s). 근거 = 런타임 단일 반복 최악 2.6 s (죽은 FRAM 버스
    save_all 38×50 ms + RTU TX @2400) 에 31 % 마진. 부팅 체인(최악 12 s)은
    감시 밖 — 전 구간 타임아웃 유계라 무한대기는 Error_Handler 뿐.
    - kick = while(1) 단일 지점. 블로킹 함수 내부 kick 금지(워치독 무력화).
    - __HAL_DBGMCU_FREEZE_IWDG() — ./fw.sh gdb halt 중 카운터 정지.
    - HAL 모듈은 CMake 주입(HAL_IWDG_MODULE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
    [main.c, periph.c, periph.h]
2026-09-04 fix(wd): 코드리뷰 3건 반영 — volatile 진단자 + 마진 caveat
    /code-review high 지적. CRITICAL/HIGH 0건, MEDIUM 1 + LOW 2.
    - **MEDIUM `app.c:22` `s_boot_rst` 에 volatile**: 이 static 은 코드가
    읽지 않고 SWD 정적 read 전용이라 -O2 에서 심볼째 사라졌다 = 문서화한
    존재 이유(mon 이 막힌 RTU 모드에서 리셋 원인 확인)가 무효. 형제
    진단자 `i2c1.c:14 s_err_count` 가 같은 이유로 이미 volatile.
    검증: Release 빌드 nm 에 `20000660 b s_boot_rst` 생존(반영 전엔 부재).
    - **LOW `main.c:31` 마진 주석 caveat**: "31 % 마진" 이 무조건인 것처럼
    읽혔다. spec §2.2.2 의 병리적 케이스(≈6.3 s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
    [app.c, main.c]
2026-09-04 docs(spec): §2.2.2 에 단일-사용자 false-trip 경로 추가
    /code-review high 발견. 기존 서술은 병리적 케이스를 "LCD DATA_SAVE +
    weld cycle_done + FC06 3중 동시" 로 가정했으나, app.c:103 의 DGUS drain
    이 무한 루프라 작업자 한 명의 SAVE 연타만으로 같은 문턱(≈3.9 s >
    3.40 s@47 kHz)에 도달한다. 코드 무변경 결정 근거를 함께 기록.
    Claude-Session: https://claude.ai/code/session_018JahTG9QmAMGoCajptBcvU
2026-09-04 docs(code): 2026-07-02 감사 stale 주석 정정 — seek/reset 위임·I2C_POT 실구동 반영
    머지 이후 사실과 어긋난 채 남아 있던 주석만 정정. 코드 무변경.
    - `app_modbus.c` RESET "effect = no-op this slice" / SEEK "no-op, deferred"
    → app_seek_reset 위임(tag -seekreset, 물리 OSC 구동 `29803ae`)
    - `app_lcd_render.c:15-16,110` · `app_lcd_input.c:242` "no real I2C /
    F2 open / stub" → U4 @0x28 실구동(tag -i2c-pot). 스케일·극성은 6b
    - `app_lcd.c:25-26` "Cycle/freq/energy/status stay 0 until slice 2"
    → slice 2 이후 전 필드 라이브
    - `fw/test/Makefile` 스위트 목록에 cfg_stage 누락 → 16개로 정정
    검증: `.bin` md5 STD `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
    [app_lcd.c, app_lcd_input.c, app_lcd_render.c, app_modbus.c]
2026-09-04 fix(modbus): 원격 START 시 진폭 pot 기록 복원 — stale 게시 가드 제거
    원인 (코드 사실):
    - `app_reg_command(US_CMD_START)` 수락은 `g_reg.us_run_status` 만 바꾸고
    `g_measure` 는 `app_reg_tick` 안에서만 게시된다(app_reg.c:195 vs :390).
    - 슈퍼루프는 `app_reg_tick`(app.c:152) → `app_modbus_tick`(:161) 순이라,
    가드가 읽는 스냅샷은 **START 를 내기 전** 상태 = 항상 IDLE.
    - 같은 블록이 `MB_REG_START` 를 소거하므로 재시도도 없다 → 가드는
    구조적으로 **항상 FALSE**. 역설적으로 이미 COMM 런 중에 START 를 또
    쓸 때만 통과했다(그 START 자체는 app_reg guard 에 먹힘).
    - 2026-06-12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
    [app_modbus.c]
2026-09-04 docs: 진입 문서 정렬 + rsb changelog 신설 + 로컬 브랜치 실측 반영
    - **changelog**: rsb 23커밋이 changelog 에 한 줄도 없었다 → `[Unreleased]`
    최상단에 항목 신설. 커밋 전부가 불릿 하나에 매핑(docs 커밋 제외).
    - **IWDG 반영** (CLAUDE.md / NEXT_STEPS §1.2·§2.2 / HANDOFF / RESUME):
    "HW 불요 큐" 항목 → 코드-완료 + T-3 벤치 대기로. HW 불요 큐는 이것으로
    비었음을 §2.2 우선순위에 명시.
    - **로컬 브랜치 실측**: 문서의 "5개"는 `feat/symmetric-stop` 을 빠뜨린
    부정확한 수치였다(실제 6개). 전부 삭제 — 백업 5개 내용은 D5 reconcile
    로 main 에 반영·HW 검증·태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
2026-09-04 docs(bench): 2026-09-05 통합 벤치 결과 — 실행 41항목 전건 PASS
    브랜치 bench/2026-09-05-integrated (rsb + iwdg, 충돌은 changelog 1곳).
    펌웨어 결함 0건. 체크리스트 자체 오류 2건을 찾아 정정.
    실측 신규값:
    - IWDG timeout T = 4.45 s (무응답 8.45 s − 부팅지연 4.00 s)
    - f_LSI ≈ 35.9 kHz (데이터시트 17~47 k 내, 공칭 32 k 보다 빠름)
    - 리셋 원인 NRST 0x04 / IWDG 0x24 (전원 0x0E 미관측)
    - 직접런 ceiling 555/558/552 ms, 무회귀 559/558/556 ms
    체크리스트 오류 2건 (펌웨어 아님):
    ① S-3 전제 누락 — model_type=HAND + limit_on_time=56 필요.
    std(2)에서 ceiling 미적용은 app_reg.c:451 대로 정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
2026-09-04 docs: 벤치 PASS 반영 — 진입 문서를 2026-09-05 상태로
    - CLAUDE.md / NEXT_STEPS: 통합 벤치 PASS + main 머지·태그 완료 반영,
    우선순위를 "남은 배선·PCB 게이트" 순으로 재배열.
    - 다음 세션이 벤치 환경 함정(§4)을 먼저 읽도록 진입 문서에 명시.
2026-09-04 docs(bench): A 섹션 가상 PC8 실행 결과 — 14항목 PASS, A-13 만 남김
    사용자 지시로 PC8 을 가상 입력(holding[0x2D] bit0=스위치 / bit1=E-STOP)
    으로 대체해 A 섹션을 실행. 빌드는 MODEL=REMOTE 순정(BYPASS 없음)이라
    게이트 강제는 실제로 동작했고 바뀐 것은 입력 소스뿐이다.
    A-1~A-12·A-14·A-15 전건 PASS. 핵심:
    - A-6 만료 없음: 701 s 연속 ENABLED (t=601 s 통과 = 옛 600 s 창 부재 입증)
    - A-8 링크 해제 자동 복귀 0.5 s / A-11 E-STOP 래치 유지
    → 3ce1ead 자기교착 수정의 비대칭이 실증됨
    🔴 A-13(단선=불허)은 원리상 검증 불가 — 가상 입력이 대체하는 성질이
    바로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
2026-09-04 docs(contract): 0x17/0x18 주석 정정 — B-5 이후 R/W (외부 소비자 전파 차단)
    `gds_us_remote` 가 계약 문서를 옮겨 적다 발견해 알려온 건. 헤더 주석이
    "read-only: mirror overwrites (samd20 faithful)" 로 남아 있었는데
    `deb48bb`(B-5)가 apply 분기를 열어 두 칸 모두 R/W 가 됐다. 벤치 MOD-2/3
    실측으로도 확인됨(freq 0..5 왕복, type 쓰기).
    이 헤더가 외부 소비자(gds_us_remote / gds_us_hmi)의 계약 정본이라 낡은
    주석이 그대로 전파된다 — 상대 쪽이 dump 스크립트 이름을 한 칸 밀려 쓰다
    발견한 것과 같은 계열의 사고다.
    정정과 함께 명시한 것:
    - MODEL_FREQ 0..5 = 15/20/30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
2026-09-04 docs: 세션 마감 — 벤치 PASS 핸드오프 + 벤치 Modbus 클라이언트 저장소 편입
    HANDOFF.md 를 2026-09-05 벤치 결과 기준으로 재작성. 진입 순서를
    "환경 함정(§4) 먼저" 로 못박았다 — 이번 세션이 nc -z 로 보드를 물려
    초반을 날린 것과 TCP connect≠MCU 생존으로 측정 두 건을 무효화한 것이
    전부 그 문서를 안 읽어서 생길 수 있는 사고다.
    열린 항목 5개를 우선순위로 정리:
    ① RTU 9600 원복(소켓 대기, 원격기 케이블만 뽑으면 1~2분)
    ② A-13 단선 fail-safe(PC8 PCB) ③ RS-485 어댑터 항목
    ④ LCD 육안 ⑤ 기타 배선·보류
    docs/superpowers/tools/mb_tcp.py 신설 —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
    [mb_tcp.py]
2026-09-04 docs: CLAUDE.md 진입 블록에 벤치 마감 상태 + 환경 함정 경로 명시
2026-09-05 chore: RTU baud 9600 원복 완료 반영 + mb_tcp.py import 누락 수정
    원복 실행 (교차 커밋 TCP→serial, FA-5 경로):
    speed 4 / stat 0 → staged speed 2 / stat 1 → 커밋 → speed 2 / stat 2
    TCP 링크 생존. gds_us_remote 50칸 덤프로 교차 확인 완료.
    - FRAM 영속 확인: save=true (app_modbus.c:383) → app_config_save_all (:578)
    - RTU 즉시 반영 아님: ETH_STATIC 이라 살아있는 RTU 링크 없음. serial 그룹은
    cfg·FRAM 에만 들어간 뒤 다음 SERIAL 전환 시 적용 (:373-381)
    - CFG_STAT=2 의도적 잔류: "커밋 성공 = 1→2 전이" 판정을 원격기가 실측 확정
    (값만 보면 남의 커밋을 자기 성공으로 오독)
    - H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
    [mb_tcp.py]
2026-09-05 docs(iwdg): 2026-09-05 벤치 실측값을 spec 에 반영 + LSI "±수 %" 서술 정정
    실측: IWDG timeout 4.45 s / f_LSI ≈ 35.9 kHz / 부팅→FC03 4.00 s /
    hang→응답 8.45 s / 리셋원인 NRST 0x04 · IWDG 0x24
    반영 지점 7곳:
    - §요약 공칭 5.0 s 옆에 실측 4.45 s (마진 71 %)
    - §2.2.1 정상 3.3 s 와 실측 4.00 s 가 상충 아님을 명시 (종점이 다름 —
    4.00 s 는 W5500 PHY 링크 ~1.5 s + 폴링 간격 포함)
    - §2.5 🔴 "상온·정상 전압에서는 32 kHz ±수 %" 반증. 실측 +12 % 로
    typ 이 아니라 max 47 kHz 쪽으로 치우친다. 역산 근거 + 측정
    신뢰도(단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
2026-09-05 fix(modbus): WORK_CNTL 가짜 리셋 — 미러가 만든 0 을 마스터 쓰기로 오인
    work_cnt 가 0 이 아닌 65536 의 배수일 때, 앞 분기에 안 걸린 아무 FC06 이나
    생산 카운트를 0 으로 날리고 FRAM 에 저장했다. else-if 체인이라 그 메시지의
    staged 쓰기까지 탈락한다. 복구 불가.
    원인: mirror_live() 는 holding[WORK_CNTL] 에 (uint16_t)work_cnt 를 싣는
    하위-워드 미러라 k*65536 에서 미러 자신이 0 을 만든다. 2026-09-04 0ab2608 이
    (uint16_t) 캐스트를 제거하면서, 그 캐스트가 유일하게 해 주던 "미러가 만든 0"
    과 "마스터가 쓴 0" 의 구분이 사라졌다. 그 커밋의 거동표는 마스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
    [app_modbus.c, app_modbus_core.c, app_modbus_core.h, test_app_modbus_core.c]
2026-09-05 fix(modbus): 1-iteration stale-미러 레이스 — 미러를 디코드 앞으로
    cfg 를 바꾸는 주체(LCD 입력 / app_weld work_cnt++ / DHCP)는 전부
    app_modbus_tick 앞에 있는데 mirror_live() 는 tick 말미에 있었다. 그래서
    apply_writes 가 보는 holding[] 이 직전 iteration 값이라, 같은 iteration 에
    도착한 FC06 이 조작자의 LCD 편집을 "마스터가 쓴 값"으로 오인해 되돌리고
    app_config_save_all 로 FRAM 에 굳혔다. 무음이고 영속이라 사후 진단이 불가능한
    부류였다. 쓴 주소의 분기가 체인에서 뒤에 있으면 마스터 쓰기도 함께 유실된다.
    취약 분기 22개(DELAY/TRIGGER/OUT_POWER/ON_TIME/ENERGY/M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
    [app_modbus.c, app_modbus_tcp.c]
2026-09-05 docs: stale-미러 레이스 벤치 회귀 PASS 반영 + NEXT_STEPS 낡은 블록 정리
    벤치 회귀 27항목 전건 PASS(66a2411 재플래시 후 실보드): S-2·S-4 · CAL-3~7 ·
    MOD-2/3/5 · B34-1/5/7/8 · FA-1/2/4/13/14 · NET-4. 미러 순서에 가장 민감한
    B34-7(horn 중 START 차단+bit6)·FA-2(dirty 중 미러가 staged 값 미덮음) 포함.
    보드는 원복 확인(0x06~0x18 diff 0).
    NEXT_STEPS §2.2 낡은 블록 정리:
    - ponytail-cleanup 항목이 취소선판·원본으로 중복돼 있던 것을 하나로
    - 원격 게이트 T-1~T-8 블록이 폐기된 LCD 활성화(T-5)·활성 창 10분 만료·
    DGUS 자산 3종을 여전히 "대기 중"으로 서술하고 있었다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
2026-09-05 test(bench): RS-485 확보 — FA-6/7/12 · S-1 · S-P · RTU 무회귀 전건 PASS + mb_rtu.py 신설
    RTU 와 mon 은 USART6 공유로 배타적이다(ETH_*=mon / SERIAL=RTU). comm_mode 는
    설계상 R-only 라 전환은 LCD 조작이 필요했고, 그 순서로 나눠 실행했다.
    mon (ETH_STATIC):
    - S-1 PASS — [boot] ... rst=0x04 리셋 원인 배너
    - S-P PASS — [lcd-hook] set_pot power=77 dac=68 (pot write 실제 발생)
    - ⚠ [cfg] work=1 — work_cnt 는 0 이 아니라 1. WORK_CNTL 판정에는 영향 없음
    RTU (SERIAL 9600 8E1):
    - RTU 무회귀 PASS — FC03 50칸 + FC06 클램프
    - FA-7 PASS — same-link 거부 CFG_STAT=4 + cfg 불변 + RTU 생존
    - FA-6 ⭐ PASS — 교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
2026-09-05 test(bench): 잔여 항목 배치 실행 전건 PASS — LCD 육안·전원사이클·E-stop 종결
    RS-485 + 사용자 재석으로 PC8 제외 잔여를 한 번에 걷었다. 설계 기준은 사용자
    조작 최소화 — LCD 방문 3회 · 화면 흘긋 4회 · 전원 사이클 1회 · comm_mode 2회.
    PASS: NET-1(mon [mbtcp] idle 12s -> disconnect) · NET-2 · S-5 · M-1 ·
    B34-2/3/4/5/7/8/9 · MOD-1/2/3/4/6/7 · CAL-2/6 · FA-2(LCD) · FA-15 · W-1
    ⭐ 전원 사이클 1회에 4항목(W-1 · B34-4 · MOD-7 · FA-15)을 태웠다.
    ⭐ W-1 rst=0x0E — 오늘까지 유일하게 미관측이던 리셋 원인. IWDG spec 의 마지막
    빈칸이 채워졌다.
    ⭐ MOD-6 E-stop 레벨 추종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
2026-09-05 docs(bench): 타 세션 벤치에서 얻은 우리 펌웨어 실측 3건 기록
    gds_us_remote 의 R2-07 S6 벤치(보드 점유)에서 우리가 돌리지 않은 항목의
    컨트롤러 거동이 관측됐다. 출처는 타 세션이나 대상은 이 펌웨어다.
    1. ADDRESS 1->2->1 을 TCP 로 커밋하는 동안 링크 생존(폴링 실패 0).
    우리가 소스 3곳으로 답한 "TCP 는 MBAP unit id 미대조"가 실측 승격.
    ⚠ COMM_ADDR=0 함정은 여전히 유효 — TCP 로는 무해해 보이나 다음 SERIAL
    전환에서 RTU 가 안 뜬다(2026-07-04 실제 사건).
    2. REJ_RUNNING 왕복: 1->5, 가동 중 재-SAVE 는 5->1->5, STOP 후 5->1->2.
    "거부 사유가 사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
2026-09-05 docs(iwdg): 마스터 측에서 IWDG 리셋이 어떻게 보이는지 spec §4 에 추가
    gds_us_remote 실측으로 spec 의 공백 하나가 드러났다. 리셋 원인을 BOOT_RST
    mon 배너 + SWD static 으로만 표면화하기로 한 결정(계약 무변경)의 귀결로
    "마스터에게는 IWDG 를 식별할 경로가 없다" 는데, 그러면 마스터에게 무엇으로
    보이는지가 어디에도 없었다.
    - IWDG/NRST/전원 재인가 = ConnectionRefused (W5500 은 살아 RST 를 보내는데
    MCU 만 재부팅 중이라 서버 소켓 미개방)
    - 케이블 분리 = 도달 실패(absent) — 로그에서 구분된다
    - ⚠ refused 원인이 최소 셋(재부팅 / 다른 마스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
2026-09-05 feat(remote-en): PC8 극성 반전 — 인터록 미실장 구간 한시 조치
    설계 원안은 active-LOW fail-safe(닫힘=LOW=허용 / 열림·단선=HIGH=불허)인데,
    인터록 회로가 아직 PCB 에 없어 풀업만 걸린 HIGH 상태다. 원안대로면 게이트가
    상시 닫혀 원격 제어를 전혀 못 연다. 판정을 뒤집어 미실장(HIGH)을 "허용" 으로
    읽어 추가 회로 없이 원격 제어가 동작하게 한다.
    사용자 결정 2026-09-05. PCB 에 회로가 추가되면 A-1/A-5/A-13 재시험이 어차피
    필요하므로 그때 원복한다.
    ⚠ 이 상태에서는 fail-safe 가 반대다 — 단선·커넥터 탈락이 불허가 아니라
    허용이 된다.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
    [app_modbus.c]
2026-09-05 docs: 인터록 극성 반전 상태를 배포 금지로 명시 (양쪽 저장소 기록)
    8f33c5f 이후 PC8 극성이 반전돼 단선·커넥터 탈락이 "허용" 이 된다. 인터록
    으로서의 보호가 없는 상태다.
    gds_us_remote 측 결정 둘(① STD 유닛에도 원격 기동 ② 확인 단계 없이 탭)과
    합쳐지면 원격 START = 탭 한 번 + 물리 인터록 없음이 된다. 벤치로는 타당하나
    이 조합 그대로 현장에 나가면 안 된다. 그쪽 요청으로 양쪽 저장소가 같은 금지를
    기록으로 묶는다.
    해제 조건: PC8 실장 PCB + 극성 원복(app_modbus.c in.sw -> == 0u) +
    A-1/A-5/A-13 재시험 PASS. 셋 다 충족해야 한다.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
2026-09-05 docs: 세션 마감 — 2026-09-05 후반 벤치 대장정 RESUME 반영
    하루 정리: 펌웨어 결함 2건 수정 · 빌드 함정 1건 발견 · PC8 제외 벤치 잔여
    전건 소진 · 타 세션 2곳과 12회 교신.
    RESUME 최상단에 배포 금지(PC8 극성 반전)를 먼저 세웠다 — 자동 로드 문서라
    다음 세션이 무엇을 하든 이것부터 본다.
    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
2026-09-05 feat(remote-en): E-STOP 래치 폐기 — 레벨 추종으로 전환
    REMOTE_EN 게이트가 DIS_ESTOP(4) 를 더 이상 래치하지 않는다. E-STOP 이
    풀리면 게이트가 스스로 ENABLED 로 복귀한다.
    래치의 유일한 청소 경로는 스위치 OFF→ON 재무장(step 1)이었는데, PC8
    인터록이 미실장이라 극성이 반전돼 있어(8f33c5f) in.sw 가 상시 1 이다.
    즉 그 경로가 물리적으로 닫혀 있었고, E-STOP 한 번이면 컨트롤러 재부팅
    전까지 원격 제어가 죽었다. gds_us_remote 벤치 실측에서 `remote_en 1 -> 4`
    이후 8분간 전이가 없었고, 원격기 화면은 "기기 스위치를 재무장하라"는
    수행 불가능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
2026-09-05 docs(remote-en): VR-7 재시험 PASS — E-STOP 자가 복귀 실측 반영
    gds_us_remote 가 컨트롤러 23ee66c 에서 4 -> 1 자가 복귀를 6회 관측했다.
    재부팅도 스위치 재무장도 없었다. 대조군인 구 펌웨어 66a2411 은 같은
    인가·해제 반복에 8분간 전이 0건이었다.
    복귀 지연은 원격기 폴 주기(~60ms)가 관측 하한이라 밀리초 값은 못 재지만,
    한 로그에서 1->4 와 4->1 이 94ms 안에 둘 다 찍혀 컨트롤러 반응이 폴
    주기보다 빠름은 확인됐다.
    부수 관측 기록: 인가·해제가 소비자 폴 한 주기 안에 끝나면 원격기는 4 를
    아예 못 본다. 게이트로서는 정상이지만 "E-S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
2026-09-05 feat(modbus): STATUS 에 SEEK/RESET 진행 비트 추가
    bit7 = MB_STATUS_SEEK(0x80), bit8 = MB_STATUS_RESET(0x100). RESET 은
    600ms 후 SEEK 으로 자동 체인하므로 두 비트는 순차로 뜬다 — FSM 이 단일
    상태라 동시 점등은 없다.
    gds_us_remote 요청. 비트가 없는 동안의 대가가 실측됐다:
    1. 소비자가 체인 길이를 숫자로 베껴 방어할 수밖에 없었다. 원격기 hold 가
    1000/500ms 로 실측 무음 창 1200/600ms 보다 짧아 버튼을 먼저 열고
    조작자를 무음 소실로 밀어 넣고 있었다(오늘 1300/700 으로 수정됨).
    2. 명령 4종 중 RESET·SEEK 만 "전송됨 · 동작 확인 불가" 로 남았다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
    [app_modbus.c, app_modbus_core.c, app_modbus_core.h, test_app_modbus_core.c]
2026-09-05 docs(modbus): SEEK/RESET 진행 비트 벤치 PASS 기록
    gds_us_remote 가 405f95e 플래시 보드에서 실측: RESET 3회 STATUS 0x0100
    (bit8), SEEK 1회 0x0080(bit7). 매핑이 계약과 일치하고 두 비트가 겹친
    적이 없다.
    ⚠ 순차 순서의 증거는 육안뿐이다. 원격기 전이 로그가 명령 상태 변화에만
    찍혀 체인 중 leg 전환을 못 잡는다(보낸 직후 leg 하나만 관측). 밀리초
    정본은 컨트롤러 mon 이다.
    (b) 를 고른 대가의 실례를 헤더 주석에 남겼다: 탭 직후 아직 비트를 한 번도
    못 본 ~60ms 동안 원격기는 두 leg 를 모두 점등한다 — "어느 단계인지
    모른다" 의 표시다. "RESET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
    [app_modbus_core.h]
2026-09-05 docs: 세션 마감 — 2026-09-05 c 원격기 요청 2건 RESUME/HANDOFF 반영
    E-STOP 래치 폐기와 STATUS 진행 비트를 하나의 세션 블록으로 정리하고,
    작업 중 덧붙인 임시 노트 3개를 흡수했다.
    다음 세션 열린 항목:
    1. PC8 실장 PCB (배포 금지 해제의 유일한 경로)
    2. gds_us_hmi 통보 미실시 — STATUS 확장을 알려야 하는데 세션 오프라인
    3. 원격기 CONFIRMED 승격 (그쪽 몫, 우리 추가 작업 없음)
    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
2026-09-05 release: 3.1.0 — 티어 버전 체계 + 인터록 극성 매크로화
    STD 는 레거시-동등 기준선이라 번호를 동결하고 날짜만 진행한다(사용자 결정).
    REMOTE 티어가 3.1.0 을 받는다. 규칙 = 번호는 기능 티어, 날짜는 그 빌드.
    STD V3.0.0_260725 -> V3.0.0_260905
    REMOTE V3.0.0R_260725 -> V3.1.0R!_260905
    접미어 ! 는 PC8 인터록 극성 반전판의 표식이다. define.h 에
    REMOTE_EN_INTERLOCK_INVERTED 를 신설해 app_modbus.c 의 in.sw 판정과 이 표식이
    같은 값을 따라가게 했다 — 실장 PCB 가 와서 매크로를 0 으로 되돌리면 LCD 표시도
    함께 움직인다. 원복을 잊어 LCD 가 거짓말할 경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
2026-09-05 docs: 원격 hold-to-run 요구사항 접수 (gds_us_remote → gds_us_ctrl)
    원격기 세션이 이 저장소에 직접 써 넣은 401줄 요구사항 문서를 접수 기록으로
    흡수한다. 2026-08-30 동등성 요구사항과 같은 형식 — 무엇을·왜만 적고 방법
    (레지스터 번호·값 인코딩·FSM 배치·타임아웃 확정값)은 이쪽이 정한다.
    요구: 필요 6건(R-4 판별자 · R-1 워치독 · R-2 hold 런 구분 · R-3 유지 신호 ·
    R-6 기존 정지 경로 승계 · R-11 게이트 닫힘 시 정지) · 권장 1건(R-5 정지 사유
    관측) · 불필요 판정 3건(R-7 혼 하강 · R-8 양손 abort · R-9 EN_SAFTY).
    R-7(혼 하강 방치 불성립)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
2026-09-05 docs: hold-to-run 요구사항 정정 접수 — §3 인용 오류 + 용어 통일
    원격기 세션이 §3 지적을 수용하고 워킹트리 문서를 고친 것을 접수한다
    (그쪽 커밋 e89b38a 대응). 우리가 낸 지적 두 건이 그대로 반영됐다:
    1. "§3 표에 hold 런 예외를 개정 명기하라" 요구 철회 → "적용 범위 밖" 으로
    교체. §3.1(:49)의 주어가 「가동 중 해제」라는 사건이지 "런이 죽는 모든
    경우" 가 아니므로 §3.1 은 한 글자도 고치지 않는다. "예외로 적으면 다음
    사람이 §3.1 을 일반 원칙으로 읽고 되살린다" 를 문서에 못박았다.
    2. §3 근거로 인용된 "혼 하강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
2026-09-05 docs: hold-to-run R-5 판정 접수 — 권장 유지 (차폐 층은 원격기 쪽)
    원격기 세션이 R-5(정지 사유 관측) 승격 여부를 판정한 것을 접수한다
    (그쪽 커밋 3298c70 대응).
    우리가 낸 승격 근거는 "hold 워치독이 원격기 release 유실 버그를 backstop
    으로 덮어 '가끔 안 선다'가 'T 만큼 늦게 선다'로 흐려진다" 였다. 그쪽 반론이
    더 정확하다 — 차폐 층의 위치가 하나 바깥이다. 원격기에는 이미 증거 타이머가
    있어(LV_EVENT_PRESSING 약 15ms 주기, 약 100ms 끊기면 release 확정) LVGL
    DISABLED 문제는 T 에 한참 못 미쳐 그쪽에서 잡힌다. 검출기는 결함에 가까운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
2026-09-05 docs(spec): 원격 hold-to-run 워치독 설계 확정 — 레지스터 1칸 + 순수 FSM
    원격기 요구사항(2026-09-05, R-1~R-11)에 대한 컨트롤러 구현 정본.
    핵심: 새 레지스터는 0x32 FEAT_CAP 비트맵 1칸(bit0 = hold 워치독, 모델
    무관 미러)뿐이고, hold 시작(2)·유지 신호(3)는 기존 START(0x1B) 의 값
    확장으로 나른다. 그래서 구 펌웨어 fail-safe 가 추가 코드 없이 성립한다
    — 모든 출하 가능 펌웨어(hw-revA_fw-stage-c1 이후 전부)의 START 분기가
    == 1u 직접 비교라 값 2/3 은 어느 분기에도 안 걸린다.
    hold 런은 새 소스값이 아니라 US_COMM 그대로다. 그래서 app_reg.c 의 소스
    열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
2026-09-05 docs(spec): hold-to-run 착수 시점 — "PC8 앞" 결정을 "PC8 과 독립" 으로 정정
    사용자 재질문("착수 시점이 PC8 앞/뒤가 중요해?")에 답: 중요하지 않다.
    hold 워치독은 PC8 을 건드리지 않고 host+TCP 벤치로 닫히며 안전 방향이다.
    "인터록 부재를 가린다" 우려는 PC8 이 운전 중 차단층일 때만 성립하는데
    PC8 은 설정 스위치라 전제가 없다. 앞/뒤 프레임 자체가 틀렸다 — 독립이다.
    남는 운영 규칙 = 벤치 세션을 PC8 재시험과 섞지 않는다.
    Claude-Session: https://claude.ai/code/session_019cfNvQoFEVoSBYXWr4uAFa
2026-09-06 docs(plan): 원격 hold-to-run 워치독 구현 계획 — 6 Task
    spec 2026-09-06 을 계약 헤더 → 순수 FSM+host 17번째 → app_reg 접근자 →
    app_modbus 글루 → 문서 → 벤치 도구로 나눴다. 무변경 3곳(app_reg 열거·게이트
    분기·2026-08-02 §3.1)을 Global Constraints 로 못박고 Task 3/4 에 diff 검사
    스텝을 넣었다. H-0 은 새 빌드 플래시 전 현 보드에서.
    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
2026-09-06 feat(modbus): hold-to-run 계약 — 레지스터 51칸, START 값 3종, 0x32 FEAT_CAP 비트맵
    spec 2026-09-06 §2. 새 칸은 0x32 하나(여유 7→6). hold 시작/유지 신호는
    START(0x1B) 값 2/3 으로 — 구 펌웨어 전부가 == 1u 만 디스패치해 fail-safe 가
    공짜. FC03 51칸=107B / 52칸 무응답 / FC06 0x33 무응답을 host 로 고정.
    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
    [app_modbus_core.h, test_app_modbus_core.c]
2026-09-06 fix(modbus): app_modbus_core.h 낡은 주석 — MB_REG_COUNT(50) 불변 → 51
    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
    [app_modbus_core.h]
2026-09-06 feat(hold-wdt): 순수 FSM app_hold_wdt_fsm 신설 — host 스위트 17번째
    spec 2026-09-06 §3. arm/keep/step 세 함수, 컨텍스트 구조체 전달. keep 은 무장
    중에만 시각 갱신(기동 권한 없음), run_is_comm=0 이면 조용히 세션 종료(트립
    아님). T=HOLD_WDT_MS 600 (#ifndef, host 가 200~1000 고정). 11케이스: 경계
    599/600, u32 랩, 무권한 keep, 타 경로 정지 후 재무장 없음, 중복 arm.
    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
2026-09-06 feat(reg): app_reg_run_src() — us_run_status 지연-0 접근자 (hold 워치독용)
    spec 2026-09-06 §3 #14. g_measure 게시는 2 ms 게이트라 stale 하고, 세션 경계
    불변식(관측 사이 mutator ≤1)은 즉시값을 요구한다. 읽기 전용 4줄, 거동 0.
    소스 열거 3곳 무변경.
    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
2026-09-06 feat(modbus): hold-to-run 글루 — START=2 무장·START=3 유지·tick 워치독·0x32 미러
    spec 2026-09-06 §3 #8-#13. START 분기를 값 불문 소거 + 값별 디스패치로(CFG_CTRL
    동형): 1=탭(기존), 2=start_allowed 일 때만 START+pot+무장, 3=keep(무권한).
    tick 첫머리(분기 밖)에서 step — 트립이면 STOP 과 동일한 RUN_RELEASE(US_COMM).
    hold 런은 US_COMM 그대로라 30s/energy/on-time/E-STOP/패널 정지 전부 승계.
    0x32 FEAT_CAP=0x0001 모델 무관 미러. 게이트 닫힘 분기는 로그 조건 1줄만
    (KEEP 제외) — 소거·STOP 통과 로직 무변경. 불변식 주석: tick 당 FC06 apply
    1건이 세션 경계의 전제.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
2026-09-06 docs: hold-to-run 워치독 코드-완료 기록 — changelog/requirements/CLAUDE/HANDOFF
    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
2026-09-06 tools: mb_hold.py — hold-to-run 벤치 유지 신호 송신기 (START=2 → START=3 주기 송신, Ctrl-C=손 뗌)
    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
2026-09-06 fix: 최종 리뷰 반영 — mb_hold.py STOP 폴백·데드라인 루프, NEXT_STEPS 갱신, 주석·문서 정합 6건, 테스트 케이스 보강
    최종 전체-브랜치 리뷰(opus) Important 2 + Minor 8 + 권고 3 반영. 거동 변화 0:
    C 변경은 주석뿐(FLASH 무변화), 테스트 1케이스 확장, 벤치 도구 2건(미트립 시
    STOP 송신 / 데드라인 기반 keep 주기), 문서 정합(NEXT_STEPS·CLAUDE 보드
    해시·requirements 17·spec §8 H-16·§9 H).
    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
    [app_modbus.c, app_modbus_core.h, app_modbus_tcp.c, mb_hold.py, test_app_hold_wdt_fsm.c]
2026-09-06 chore(version): 빌드 날짜 _260906 (hold-to-run 벤치 빌드)
    번호 동결(3.0.0 / 3.1.0), 날짜만 진행 — CLAUDE.md 태깅 규칙. 새 빌드를 플래시한
    뒤 LCD 로 구(_260905)/신(_260906) 빌드를 구분하기 위함(최종 리뷰 권고 2).
    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
2026-09-06 tools(mb_hold): keep 데드라인 기준을 START 송신 순간으로 + 링크 프라임 읽기
    벤치 실측(2026-09-06 §4): 기준점을 기동 확인 뒤에 잡으면 첫 keep 이 arm 후
    ~615 ms 에 가서 550 ms 무트립 케이스가 트립으로 오판된다. 그리고 10 s 이상
    침묵 뒤 첫 프레임은 게이트(DIS_LINK)가 거부하므로 START 전에 읽기 1회로
    프라임한다.
    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
2026-09-06 fix(horn): horn 모드 중 진행 런 강제 정지 — 초음파 배제를 새 START 에서 진행 런까지 확장
    벤치 H-12(2026-09-06): hold 런 중 LCD 에서 horn 모드를 켜자 초음파가 계속
    나갔다. 소크 사이클 1 에서도 같은 일이 났다(horn ON 뒤 25 s 완주). 원인은
    포트가 legacy SYS_HORN 의 "초음파/weld 배제" 를 게이트 2곳(start_allowed +
    weld 동결)으로만 옮겨 새 START 만 막고, horn 진입 전에 시작된 런은 세우는
    코드가 없었던 것. legacy 는 SYS_HORN 이면 RUN 분기 자체가 안 돈다
    (ref/samd20/main.c:1427/1634). hold-to-run 이전부터 있던 구멍이다.
    수정: app_horn_tick 이 horn 모드 중 매 t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
    [app_horn.c]
2026-09-06 docs(bench): hold-to-run 워치독 HW 벤치 결과 — 실행 16항목 PASS, horn 결함 1건 발견·수정
    H-0~H-16(H-11·H-15 이연) 전건 PASS. 트립 603~608 ms(T=600), 30 s 상한이
    keep 을 이김, E-STOP·패널 탭·STOP 뒤 keep 재기동 없음, 구 펌웨어 START=2/3
    무반응, STD 에서도 hold 동작. 소크 24사이클 6000 keep 이상 0.
    H-12 가 기존 결함을 드러냈다 — horn 모드가 진행 런을 세우지 않음 → 96dc7d5.
    관측 5건(§4): 침묵 뒤 첫 프레임 거부 / warm-up 무음 거부 / horn(수정) /
    rig 과부하 1회 자동 복구 / LCD 조작이 벤치 오염.
    Claude-Session: https: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
2026-09-06 docs: 세션 마감 — 2026-09-06 hold 워치독 벤치 PASS·머지, RESUME/HANDOFF 반영
    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
2026-09-06 docs(handoff): HMI 통보 항목에 원격기 계약 문서 포인터 + 원격기 실기 통과 기록
    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
2026-09-06 docs: 세션 마감 — NEXT_STEPS/CLAUDE.md/HANDOFF 진입 블록을 2026-09-06 결과로 갱신
    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
2026-09-08 docs(spec): 바이트 동일 리팩토링 설계 + 사전 감사 보고서
    - spec: 50줄 초과 함수 38개·800줄 초과 파일 1개를 두 모델 .bin 바이트 동일 조건에서
    정리. 수단 = 주석을 함수 위로 이동 + always_inline void 본체 추출(판정은 호출자).
    슬라이스 7개, 커밋마다 sha256 대조(fw/tools/bin-same.sh). 예외 4개 명시.
    - research: -Og 라 called-once 인라인이 꺼져 있음(실측), spike 3건 결과, 함수 인벤토리
    전수, 기준 해시 STD fd66…e278f / REMOTE c522…7373f.
    - 사용자 결정 2026-09-08: 목표=분할·거동 불변 / 기준=바이너리 동일 / 접근=바이트 동일
    트랙만 / 주석 행선지=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
2026-09-08 docs(plan): 바이트 동일 리팩토링 구현 plan + spec 실측 정정
    - plan: Task 0(도구·기준 해시) → Task 1(주석 재배치 23함수 검토, app_modbus.c 815→753)
    → Task 2~6(always_inline void 헬퍼 23개) → Task 7(조건부 5건, DIFF 면 파일 단위 되돌림)
    → Task 8(최종 게이트·changelog·spec §6·--no-ff 머지). 모든 스니펫은 스크래치 사본에
    적용해 -fsyntax-only 와 funclen.py 로 검증한 값. .bin 대조는 실행자 몫.
    - spec 정정(plan D1~D9): mo_time_clamp_echo(cfg) / cfg_ctrl_commit_body(cfg, d) /
    publish_copy_out(+live) / weld_step_cyl2(out) / osc 헬퍼 4개 / mirror 연속 범위 재절단 /
    C1 짧은 블록·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
2026-09-08 chore(tools): .bin 동일성 게이트 + 함수 길이 측정기
    - fw/tools/bin-same.sh: STD/REMOTE 빌드 → .bin sha256 을 fw/.bin-baseline 과 대조 (spec §5.2 원문)
    - fw/tools/funclen.py: 중괄호 균형 함수 길이 (감사 C-1 규약, 301 함수 / >50 = 38 재현)
    - fw/.gitignore: .bin-baseline
    - 기준: STD fd66f6e7bb9d6ff03f7ea1831797167813b3db4613de66e6c84841b1860e278f / REMOTE c5223adac03c85861e242e592125bf163114c847f383d6304f5d2e0771f7373f (클린 빌드, gcc 15.2.1)
    Claude-Session: https://claude.ai/code/session_01FLb4papJVFASVXee4FQmPA
2026-09-08 refactor(comments): 함수-내 장문 주석 헤더 이동(22함수) + app_modbus.c 이력 압축 815→753 — .bin 동일 (STD fd66…e278f / REMOTE c522…7373f)
    - C1: 5줄 이상 블록(+ ≤50 도달에 필요한 2~4줄·1줄 블록)을 함수 선언 위 헤더 블록으로 병합. 코드 줄 무변경
    (주석·빈 줄 제거 스트림 diff 18파일 SAME_CODE). 빈 줄 삭제: 옮긴 블록 바로 위 + parser_step 4·energy2str 3·app_modbus_tick 1
    - C2 압축(app_modbus.c): K1 파일 헤더(changelog 2026-06-13 349bd91) · K2 mirror_live 개요(동) · K3 B-5 미러(changelog
    2026-09-04 B-5) · K5 RESET 위임(changelog 2026-07-05 29803ae) · K6 START pot(changelog 2026-09-04 ac7e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
    [app.c, app_cfg_stage.c, app_input.c, app_lcd.c, app_lcd_comm.c, app_lcd_disp.c, app_lcd_input.c, app_lcd_str.c]
2026-09-08 refactor(comments): K12 안전 근거 문장 복원 + parser_step 빈 분기 포인터 — .bin 동일 (STD fd66…e278f / REMOTE c522…7373f)
    - R6(a) C2 위반 복원 (app_modbus.c MODEL_TYPE 분기): K12 가 지운 것은 이력이 아니라 model_type 무가드의
    **안전 근거**였다. 원문 복원 — "LCD 편집 경로에도 같은 가드가 없어(app_lcd_input.c:452 무조건 대입)
    기계 앞의 조작자는 이미 같은 일을 할 수 있고, 원격에만 새 규칙을 만들지 않는다는 이 저장소 원칙과
    일관된다." 날짜는 압축 유지(changelog 2026-09-04 B-5). +1줄
    - R6(b) parser_step 빈 분기(dgus_lcd.c): `} else if (b == DGUS_SYNC1) {` 가 본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
2026-09-08 refactor(modbus): mirror_live 3분할 — .bin 동일 (STD fd66…e278f / REMOTE c522…7373f)
    - always_inline void 헬퍼 3개(mirror_cfg_fields / mirror_disp_status / mirror_stage_and_gate) — 연속 블록 그대로 이동,
    인자 = 기존 cfg·m 포인터 + running 값 (H1~H6). mirror_live 99→13줄
    - bin-same.sh SAME · host 17 PASS · our-code 경고 0
    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
2026-09-08 refactor(usart6): usart6_mb_open 2분할 — .bin 동일 (STD fd66…e278f / REMOTE c522…7373f)
    - mb_uart_reinit(speed_idx, parity_idx) / mb_dma_init() — 전역 핸들·파일 static 직접. 68→26줄
    - reg_publish_measure 3분할은 보류 (spec §3 H7): 단독 적용에도 .bin DIFF
    (cur STD 7c8150ae… / REMOTE 98003830…). reg_publish_measure 0x118→0x110
    으로 8 B 축소 — always_inline 인데도 GCC 코드젠이 바뀐다. H7 대로 우회
    변형(인자 재배치·분할점 변경·inline 제거) 시도 없이 원본 유지.
    Claude-Session: https://claude.a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
2026-09-08 refactor(modbus): apply_writes 본체 3추출 — .bin 동일 (STD fd66…e278f / REMOTE c522…7373f)
    - gate_reject_body() [감사 b-2v-i 실증 패턴, #ifndef REMOTE_EN_GATE_BYPASS] / start_cmd_body(cfg, sv, now) /
    cfg_ctrl_commit_body(cfg, d) — 판정 if·return·save=true 는 호출자 (H3/H4). spec §4 의 (cfg, link) 는
    본체가 link 를 안 써 (cfg, d) 로. 13 클램프 분기 무변경. 358→256줄 (§6 예외 유지)
    - bin-same.sh SAME · host 17 PASS · our-code 경고 0 · app_modbus.c 792줄
    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
2026-09-08 refactor(lcd): lcd_input_dispatch case 본체 3추출 — .bin 동일 (STD fd66…e278f / REMOTE c522…7373f)
    - handle_sys_pic_now(state, cfg, data16) [감사 b-3b-i 실증] / handle_setup_param_enter(state) [2 case 공용] /
    handle_run_mode(state, cfg, data16). case 라벨·break 35개 무변경. 225→188줄 (§6 예외 유지)
    - mo_time_clamp_echo(cfg) [LV_MO_TIME1/2 공통 꼬리 — spec 의 handle_mo_time_edit 대체안] 는 .bin ≠ → 보류(H7).
    4개 동시 추출이 DIFF → 격리 결과 이 하나가 단독 원인: ①만 SAME / ①+④ DIFF / ①+③ SAME / ①+③+② SAME.
    DIFF 해시 cur=ef9dbaa87f9cac87925226a6934ce2a0d4c070f53816a4a55591adcfa8eee32a
    988231845630e7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
2026-09-08 refactor(fsm): weld/osc/seek_reset step case 본체 추출 (4+4+2) — .bin 동일 (STD fd66…e278f / REMOTE c522…7373f)
    - weld: weld_abort_body(out) [판정·return 호출자] / weld_step_cyl1(in) / weld_step_weld(in,out) 58줄(§6) / weld_step_cyl2(out) — spec 의 (in,out) 중 in 미사용 제거. 170→72줄(§6 기록)
    - osc: osc_step_wait_h/wait_l(in) + osc_step_reset/seek(out) — spec 의 osc_step_pulse 1개는 상수가 달라 2개로. 77→41줄
    - seek_reset: sr_step_reset/seek(out). 60→37줄
    - case 라벨·break·memset·out->state 꼬리 무변경. bin-same.sh SAME · host 17 PASS(weld 21함수 포함) · our-code 경고 0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
2026-09-08 refactor(lcd): app_lcd_change_page 4추출 (슬라이스 7-1) — .bin 동일 (STD fd66…e278f / REMOTE c522…7373f)
    - render_run_std(cfg, buf) / render_setup_main(cfg, state) /
    render_comm_page(cfg, state, addr_str, ipbuf) / render_comm_tail(page, state)
    - H4 경계(로컬 배열 buf/addr_str/ipbuf 포인터 전달) 통과 — .bin 동일
    - STDC/MHC·STDE/MHE 공통부는 글자 단위 동일 → 헬퍼 1개를 두 분기에서 호출
    (always_inline 이라 인라인 2벌 = 원본 중복 그대로)
    - 호출자 로컬 i/n 은 헬퍼로 이동, 분기 판정은 호출자에 잔존 (H3)
    - 203줄(코드 177) → 78줄(코드 57); render_run_std 53줄은 spec §6 예외 유지
    - host 17 PAS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
2026-09-08 refactor(lcd): disp_compute_output 설명 주석 헤더 이동 (슬라이스 7-4) — .bin 동일 (STD fd66…e278f / REMOTE c522…7373f)
    - 헬퍼 추출(fill_upper_band/fill_lower_band)은 .bin ≠ 로 보류 — H7 우회 없음.
    STD 9c5e…6494 / REMOTE 9f2a…48c97, disp_compute_output 0x13c(316B) 크기는
    동일하고 명령 바이트만 달라짐(호출자 로컬 span/i 가 헬퍼별로 갈리며 레지스터
    할당 변화). 파일은 68c8d59 상태로 되돌림.
    - 되살린 것은 브리프가 바이너리 무영향(C1)으로 지정한 설명 주석 15줄
    헤더 이동뿐 — 태그 `[fill 규칙]`. 코드 무변경(code 54 그대로).
    - 76줄 → 61줄
    - host 17 PASS · our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
2026-09-08 refactor(lcd): handle_std_setup_param case 1/2 본체 2추출 (슬라이스 7-5) — .bin 동일 (STD fd66…e278f / REMOTE c522…7373f)
    - goto_setup1(state, cfg) / goto_setup2(state, cfg) — 기존 포인터 2개만 (H4 ✓)
    - data16 == 1 / == 2 판정은 호출자에 잔존 (H3); case 3/4/5 본체는 무변경
    - 58줄(코드 52) → 38줄(코드 32)
    - host 17 PASS · our-code 경고 0
    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
2026-09-08 docs: 바이트 동일 리팩토링 결과 — changelog [Unreleased] + spec §6 예외 표 실측 기입
    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
2026-09-08 docs(spec): 요약 단락을 실측 결과로 교체 (25↓ · 예외 13 · 헬퍼 27/10)
    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
2026-09-08 refactor(comments): 최종 리뷰 fix — bin-same.sh errexit 분리 + 주석 표류 5곳 + 태그 중복 정리 — .bin 동일 (STD fd66…e278f / REMOTE c522…7373f)
    - fw/tools/bin-same.sh: `&&` AND-리스트가 set -e 를 우회해 첫 빌드 실패 시 stale .bin 으로 SAME 이 날 수 있던 경로 제거(두 줄 분리)
    - app_modbus.c: gate_reject_body "이 return 이" → 호출자의 return / app_modbus_tick 게이트·hold 워치독 블록에 트레일링 포인터(50줄 유지)
    - app_lcd_render.c: render_comm_tail "(외곽 페이지 판정은 호출자)" / render_run_std 헤더에 수치 4필드
    - app_lcd_input.c: case SYS_PIC_NOW 위 그룹 배너 복원 (dispatch 188→189)
    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
    [app.c, app_lcd_input.c, app_lcd_render.c, app_modbus.c, app_remote_en_fsm.c, app_seek_reset_fsm.c, dgus_lcd.c, usart1.c]
2026-09-08 docs: 최종 리뷰 반영 — spec §5.2 스크립트 동기 + H8 신설, changelog 표기 보완
    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
2026-09-08 docs: dispatch 189 동기 (SYS_PIC_NOW 배너 +1) — changelog·spec §5.4/§6
    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
2026-09-11 docs(spec): Modbus 쓰기 → LCD VP 에코 설계 + plan + SETUP 동기 조사
    - 조사: 원격→LCD 는 apply 체인이 cfg/FRAM 만 갱신하고 LCD 에코 6개뿐 → SETUP 페이지·STD RUN 텍스트 stale(맞음).
    LCD→원격 은 즉시 cfg + 매 tick 미러 + 원격기 50ms 폴/500ms 스로틀로 반영됨(코드상 틀림, 원격 편집 중 DIRTY 시 shadow 유지).
    - spec: 방법 A — apply_writes 분기 안 dgus_write_* 에코(13분기 14 VP) + STD RUN 텍스트 재기록(render_run_std 공개 승격,
    save 뒤 1호출) + HORN/CAL/MODEL 5줄. hold 예산 579→587.7 ms < 600. 의도적 legacy 이탈(samd20 에코 3곳).
    - 사용자 결정 2026-09-11: 방법 A / 편집 충돌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
2026-09-11 feat(modbus): FC06 SETUP 숫자 13분기 LCD VP 에코 — 기존 DISP_*_EN 에코와 동형 (spec 2026-09-11 §3.1)
    - DELAY1/2/3 → LV_DM_DELAY/WELD/HOLD · TRIGGER2/3 → LV_TM_WELD/HOLD · OUT_POWER → LV_OUT_POWER
    · ON_TIME → LV_MAX_ON_TIME · ENERGY → LV_ENERGY_VAL(u32)+LV_ENERGY_EDIT(u16) · MULTI_T1/T2/O1/O2
    → LV_MO_TIME1/2·OUT1/2 · TIMEOVER → LV_LIMIT_OUT_T. 분기 안, cfg 대입 직후, 클램프 뒤 값.
    - 의도적 legacy 이탈: samd20 update_holding_reg(1) 은 3곳만 에코(ref/samd20/main.c:4520/4530/4536).
    레지스터 의미·주소·클램프·저장 무변경. 원격 제약 추가 아님(LCD 표시를 cfg 에 맞춤).
    - 추가 지연 u16 8 B ≈ 0.69 ms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
2026-09-11 feat(lcd): STD RUN 텍스트 재기록 공개 함수 app_lcd_run_std_refresh + FC06 cfg 저장 뒤 1호출 (spec 2026-09-11 §3.2)
    - render_run_std(static always_inline) → app_lcd_run_std_refresh(void): cfg=app_lcd_cfg(), buf 지역화,
    set_page 없음. change_page 는 호출만 교체, 미사용 buf 제거. 본체 무변경.
    - apply_writes if(save) 뒤 1호출 — D/W(E)/H·DISP_RUN_MODE 는 run_mode×energy_ctrl×multi_ctrl 조합이라
    항목별 에코 불가. 페이지 게이트 없음(VP RAM 보존 + 경고→런 복귀가 set_page 만).
    - 추가 지연 ≤82 B ≈ 7.1 ms/apply, ENERGY 와 합쳐 최악 100 B ≈ 8.7 ms → hold 적층 579→587.7 < 600.
    - host 17 PASS · STD/REMO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
2026-09-11 feat(modbus): HORN_CMD → DISP_HORNDOWN · CAL/FREQ_CAL → VAR_*CAL_VAL · MODEL_FREQ/TYPE → 선택 VP 에코 (spec 2026-09-11 §3.3)
    - HORN: SETUP1 체크박스를 실제 모드로 — 진입 시드(app_lcd_input.c:458)와 동형. shadow temp_horndown 무변경,
    SAVE 시 shadow 적용 legacy 거동 그대로(2026-09-06 벤치 §4-5). 원격기 CLAUDE.md '컨트롤러 LCD horn 에코 부재' 해소.
    - CAL: raw int16 캐스트(enter_model_setup :328-329 동형), 클램프 뒤 값. MODEL: 선택 VP(:326-327 동형),
    sys_mode·런페이지 미재파생·PC11 가드 없음은 기존 결정 그대로.
    - host 17 PASS · STD/REMOTE 경고 0 · size STD text=66304 / REMOTE text=66620 (+52 B)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
2026-09-11 docs: FC06 → LCD VP 에코 코드-완료 기록 — changelog [Unreleased] + requirements FW3 항목 8
    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
2026-09-11 chore(version): 빌드 날짜 260911 — LCD 에코 벤치 빌드 (STD V3.0.0_260911 / REMOTE V3.1.0R!_260911)
    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
2026-09-11 docs(spec): SETUP1 진입 horn shadow 시드 정정(F1) 설계 + Safe/Horn 동시 SAVE 조사
    - 조사: LCD SETUP1 에서 Safe mode + Horn down 동시 선택 후 SAVE 시 꺼지는 것은 horn 이고
    표시만이 아니라 실제 모드(SOL·START 게이트·STATUS bit6)까지 꺼진다. f_safty 는 무관.
    원인 = 진입 시 VP 는 현재 모드로 그리면서 shadow temp_horndown 을 0 리셋(input.c:459) +
    SAVE 가 shadow 무조건 적용(comm.c:388). 재현 = horn 이 이미 ON 인 상태에서 진입 → 다른 항목
    변경 → SAVE. legacy samd20 진입은 temp 무접촉(포트 주석의 3617-3622 는 CANCEL 분기 오인용).
    이 브랜치 코드와 무관한 기존 결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
2026-09-11 fix(lcd): SETUP1 진입 시 horn shadow 를 현재 모드로 시드 — 안 건드린 horn 이 SAVE 에 꺼지던 결함 (F1)
    - **원인**: `handle_setup_param_enter()` 가 체크박스 VP 는 `app_horn_mode_active()` 로
    그리면서 저장용 shadow `temp_horndown` 만 0 으로 리셋해, 화면 ✓ 와 SAVE 적용값이
    어긋났다. horn ON 상태에서 Safe mode 등 다른 항목만 바꾸고 SAVE 하면
    `app_lcd_hook_horn(temp==1)` 이 무조건 0 을 적용 → horn 모드가 실제로 꺼졌다
    (SOL OFF · app_reg START 게이트 해제 · STATUS bit6 0). `f_safty` 는 무관.
    - **legacy 복원**: 구 주석의 "legacy main.c:3617-3622 verbatim" 은 samd20 의 CANCEL
    분기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
    [app_lcd_input.c]
2026-09-11 docs: 세션 마감 2026-09-11 — RESUME/HANDOFF/CLAUDE.md 진입 블록 (에코+F1 코드 완료, 플래시·벤치 대기)
    - 열린 브랜치 2개(스택): refactor/byte-identical = PR #1 (.bin 바이트 동일) → feat/modbus-write-lcd-echo (FC06→LCD 에코 19 VP + STD RUN 재기록 + F1 horn shadow 시드)
    - 보드 = _260906 바이너리 그대로(ST-LINK 미연결). 다음 = 플래시 → 벤치(Task 5 표 + E-13b/15/16/R-4b) → 주석 정정 커밋 → PR 머지 → 태그 → 원격기 통보
    - 통신 프로토콜 문서 3개는 main 체크아웃 미추적, 후속 spec 후보 3건 기록
    Claude-Session: https://claude.ai/c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
2026-09-12 fix(lcd): COMM 페이지 모드 아이콘 set_page 뒤 100 ms 지연 재기록 — page 27 auto-load 미반영 (B)
    - **무엇**: 전원 재투입 후 COMM 페이지 첫 진입에서 화면은 이더넷 페이지(STD = page 27)로
    맞게 뜨는데 모드 선택 아이콘만 "시리얼" 로 보이던 결함. `app_lcd_tick` 에서 set_page 뒤
    `LCD_COMM_ICON_REASSERT_MS`(100 ms) 가 지나면 모드 아이콘을 **1회 재기록**한다
    (state 필드 `comm_icon_reassert_pending` 로 무장, 발화 시 현재 페이지가 여전히 comm
    페이지인지 확인 — 이탈했으면 무장 해제만).
    - **원인**: page 27(STDE) 은 표시 시 `DISP_COMM_MODE` 를 auto-load 하지 않고 **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
    [app_lcd.c, app_lcd.h, app_lcd_render.c]
2026-09-12 docs(spec): COMM 아이콘 지연 재기록(B) 설계 + comm_mode 표시 조사 — 9fc94df 가 참조하는 문서
    - research/2026-09-12-comm-mode-display-investigation.md: 실기 3단계(TCP OK / SAVE 직후 OK / 이더넷 페이지 진입) + 원격기 회신(FC06 0건)으로 cfg·FRAM·라우팅 정상, DISP_COMM_MODE 표시 한 지점으로 확정. legacy 동일.
    - specs/2026-09-13-comm-icon-deferred-reassert-design.md: B = set_page 뒤 100 ms 1-shot 재기록, render_comm_tail 공개 승격, 벤치 E-17/E-17b.
    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
2026-09-12 docs(CLAUDE): 양산 바이너리 보관 규칙 releases/<버전>/ — 원격기와 공통 (파일명에 ! 미포함, README 에 반전판 명기)
    - 사용자 결정 2026-09-13 ①-b: gds_us_ctrl_v3.1.0R_260911.bin 꼴, 극성 반전 표식은 README 에만.
    - 첫 보관본 = 이번 벤치 PASS 후 스테이지 태그 시점(벤치 전 빌드는 보관 안 함).
    - 절차 8단계, define.h 날짜==태그 확인 포함(git describe 미사용).
    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
2026-09-12 Revert "fix(lcd): COMM 페이지 모드 아이콘 set_page 뒤 100 ms 지연 재기록 — page 27 auto-load 미반영 (B)"
    This reverts commit 9fc94dfe74355b56557d7d5d9f86efd9b4b6f66a.
    [app_lcd.c, app_lcd.h, app_lcd_render.c]
2026-09-12 docs: 세션 마감 2026-09-13 — 보드 플래시(3be6a5d) · COMM 아이콘 결함 = 패널 자산 구버전(DGUS 수정 해결) · 벤치 대기
    - RESUME/HANDOFF/CLAUDE.md 진입 블록 갱신. B 시도 revert 기록, 원인 = 패널 자산 버전(사용자 확인).
    - 조사 문서 종결 블록: 실기 확정, 열린 항목 = 패널본 == hw/lcd/dgus/ 확인.
    - 다음 = 벤치(E-1~E-16·R-1~R-5 + E-13b/15/16/R-4b) → 주석 정정 → PR#1 머지 → PR#2 → 태그 → releases/V3.1.0R_260911/ → 원격기 통보.
    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
2026-09-12 docs(HANDOFF): 진입 순서 1번 열린 항목 문구 정정 (패널 자산 == 저장소 확인 1건)
    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
2026-09-13 docs(releases): 양산 바이너리 공통 플래시 가이드 releases/README.md 신설 — 원격기와 공통 구조
    - SWD 플래시 3경로(CubeProgrammer CLI / OpenOCD / J-Link) · SHA256SUMS 대조 · LCD 버전 판정 · 실패 표
    - 보관 절차 명령(클린 빌드 → 복사·개명 → cfg 복사 → SHA) + 버전 README 템플릿(배포 가능 여부 항목 포함)
    - 폴더명 = 버전 문자열(태그 아님) · 파일명 ! 미포함은 CLAUDE.md 규칙 그대로
    - CLAUDE.md 보관 규칙에 가이드 포인터, HANDOFF 헤더에 Releases 절
    - 버전 폴더는 벤치 PASS 태그 뒤 첫 보관본 때 생성
2026-09-13 chore(releases): 첫 보관본 V3.1.0R_260911 — REMOTE .bin + SHA256SUMS + cfg + README (벤치 전, 태그 미발행)
    - 클린 빌드(8bd0417, 코드 3be6a5d) 해시 2a813206… = 보드 플래시 이미지와 동일
    - STD 미검증 제외, .elf 제외(경로 박힘·1.5 MB)
    - 버전 README 에 태그 미발행·벤치 미통과·배포 금지(반전판) 명기
    - HANDOFF Releases 절 갱신
    [stm32f410.cfg]
2026-09-13 docs(HANDOFF): 원격기 통보 의무에 폴더 대체 건 추가
