shuug2/gds_us_ctrl/(notices)

Notices in the files:
ref/samd20/W5500/dhcp.c:
Copyright (c) 2013, WIZnet Co., LTD.
All rights reserved.
